Alex-Wolfe/Home-Audio-System/README.md

# Home Audio System
Audio Receiver and Amplifier
