Alex-Wolfe/Home-Audio-System/Firmware/Other/micro_pinout.xlsx

 | Pin name | PPS Number | Net Name | ANSEL Bit present | Peripheral Pin Select | IO Direction | Special Function Assignment
PORT A | RA0 |  | PLAY_PAUSE | Yes | No | Digital Output
PORT B | RB0 |  | PGD | Yes | Yes | N/A | Programming
 | RB1 |  | PGC | Yes | Yes | N/A | Programming
 | RB2 |  | 16kHz In | Yes | Yes | Analog Input | ADC In
 | RB3 |  | 63Hz In | Yes | No | Analog Input | ADC In
 | RB4 |  | AVG In | Yes | Yes | Analog Input | ADC In
 | RB5 |  | 1kHz In | Yes | Yes | Analog Input | ADC In
 | RB6 |  | 400Hz In | Yes |  | Analog Input | ADC In
 | RB7 |  | 160Hz In | Yes |  | Analog Input | ADC In
 | RB8 |  | 2.5kHz In | Yes |  | Analog Input | ADC In
 | RB9 |  | 6.25kHz In | Yes |  | Analog Input | ADC In
 | RB10 |  | IN SEL B | Yes |  | Digital Output
 | RB11 |  | IN SEL A | Yes |  | Digital Output
 | RB12 |  | REG TEMP | Yes |  | Analog Input | ADC In
 | RB13 |  | OUTPUT TEMP | Yes |  | Analog Input | ADC In
 | RB14 |  | FAN PWM | Yes | Yes | Digital Output | PWM Out, CCPM
 | RB15 |  | FAN EN | Yes |  | Digital Output
PORT C | RC12 |  | OSC+ | No |  | N/A | Primary oscillator
 | RC13 |  | TUNE B | No |  | Digital Input
 | RC14 |  | TUNE A | No |  | Digital Input
 | RC15 |  | OSC- | No |  | N/A | Primary oscillator
PORT D | RD0 |  | SPI1 CS EQ | No |  | Digital Output | SPI 1
 | RD1 |  | BAR SCLK | No | Yes | Digital Output | SPI 2
 | RD2 |  | BAR | No | Yes | Digital Output | SPI 2
 | RD3 |  | UART RXD | No | Yes | Digital Input | UART 2
 | RD4 |  | UART TXD | No | Yes | Digital Output | UART 2
 | RD5 |  | IR IN | No | Yes | Digital Input | UART 3?
 | RD6 |  | VOL + | Yes |  | Digital Output
 | RD7 |  | VOL - | Yes |  | Digital Output
 | RD8 |  | DISPLAY LAT | No |  | Digital Output
 | RD9 |  | DISPLAY BLANK | No |  | Digital Output
 | RD10 |  | VOL A | Yes |  | Digital Input
 | RD11 |  | SPI1 MISO | Yes | Yes | Digital Input | SPI 1
PORT E | RE0 |  | nSOURCE | No |  | Digital Input
 | RE1 |  | LATCH | Yes |  | Digital Output
 | RE2 |  | BLANK | Yes |  | Digital Output
 | RE3 |  | N/C | Yes
 | RE4 |  | nMULTI1 | Yes |  | Digital Input
 | RE5 |  | nMULTI2 | No |  | Digital Input
 | RE6 |  | AUX DET | No |  | Digital Input
 | RE7 |  | MFB | No |  | Digital Output
PORT F | RF0 |  | VOL B | No |  | Digital Input
 | RF1 |  | nDISPLAY | No |  | Digital Input
 | RF2 |  | SPI1 MOSI | No | Yes | Digital Output | SPI 1
 | RF3 |  | SPI1 SCLK | No | Yes | Digital Output | SPI 1
 | RF4 |  | FM INT | No |  | Digital Input
 | RF5 |  | FM nRST | No |  | Digital Output
 | RF6 |  | N/C | No |  | N/A
PORT G | RG2 |  | SCL | No | No | Digital Output | I2C 1
 | RG3 |  | SDA | No | No | Digital Output | I2C 1
 | RG6 |  | N/C | Yes
 | RG7 | RP26 | RXD | Yes |  | Digital Input | UART 1
 | RG8 | RP19 | TXD | Yes |  | Digital Output | UART 1
 | RG9 |  | TEST | Yes |  | Digital Output
