Alex-Wolfe/Home-Audio-System/Hardware/Other/eq -12db setting.xlsx

 |  | Pot resistance |  | number of steps | resistance per step
 |  | 50000 |  | 256 | 195.3125
Steps | lin ratio | voltage log ratio
1 | 0.00390625 | -48.16
2 | 0.0078125 | -42.14
3 | 0.01171875 | -38.62
4 | 0.015625 | -36.12
5 | 0.01953125 | -34.19
6 | 0.0234375 | -32.60
7 | 0.02734375 | -31.26
8 | 0.03125 | -30.10
9 | 0.03515625 | -29.08
10 | 0.0390625 | -28.16
11 | 0.04296875 | -27.34
12 | 0.046875 | -26.58
13 | 0.05078125 | -25.89
14 | 0.0546875 | -25.24
15 | 0.05859375 | -24.64
16 | 0.0625 | -24.08
17 | 0.06640625 | -23.56
18 | 0.0703125 | -23.06
19 | 0.07421875 | -22.59
20 | 0.078125 | -22.14
21 | 0.08203125 | -21.72
22 | 0.0859375 | -21.32
23 | 0.08984375 | -20.93
24 | 0.09375 | -20.56
25 | 0.09765625 | -20.21
26 | 0.1015625 | -19.87
27 | 0.10546875 | -19.54
28 | 0.109375 | -19.22
29 | 0.11328125 | -18.92
30 | 0.1171875 | -18.62
31 | 0.12109375 | -18.34
32 | 0.125 | -18.06
33 | 0.12890625 | -17.79
34 | 0.1328125 | -17.54
35 | 0.13671875 | -17.28
36 | 0.140625 | -17.04
37 | 0.14453125 | -16.80
38 | 0.1484375 | -16.57
39 | 0.15234375 | -16.34
40 | 0.15625 | -16.12
41 | 0.16015625 | -15.91
42 | 0.1640625 | -15.70
43 | 0.16796875 | -15.50
44 | 0.171875 | -15.30
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
