Alex-Wolfe/Home-Audio-System/Hardware/Other/bar graph plan.xlsx

 |  |  |  |  |  |  | eq bar led plan
 |  |  |  |  |  |  | adc count | adc voltage mV | db fullscale | bar
 |  | ADC Reference | Bits | Voltage Resolution | Steps |  | 2899 | 2335.620117 | -3.002234652 | 10
 |  | 3.3 | 12 | 0.81 mV | 4096 |  | 2051 | 1652.416992 | -6.007885752 | 9
 |  |  |  |  |  |  | 1453 | 1170.629883 | -9.001886673 | 8
 |  |  |  |  |  |  | 1028 | 828.2226562 | -12.00733667 | 7
Steps |  |  |  |  |  |  | 728 | 586.5234375 | -15.00457137 | 6
1 | 0.8056640625 | -72.24719896 |  |  |  |  | 516 | 415.7226562 | -17.99420493 | 5
2 | 1.611328125 | -66.22659905 |  |  |  |  | 365 | 294.0673828 | -21.00134167 | 4
3 | 2.416992188 | -62.70477386 |  |  |  |  | 258 | 207.8613281 | -24.01480484 | 3
4 | 3.22265625 | -60.20599913 |  |  |  |  | 183 | 147.4365234 | -26.99817716 | 2
5 | 4.028320312 | -58.26779887 |  |  |  |  | 129 | 103.9306641 | -30.03540475 | 1
6 | 4.833984375 | -56.68417395
7 | 5.639648438 | -55.34523816
8 | 6.4453125 | -54.18539922
9 | 7.250976562 | -53.16234877 |  |  |  | "clip at 2.6V at adc" this is 50W mark at 4 ohm load
10 | 8.056640625 | -52.24719896
11 | 8.862304688 | -51.41934526
12 | 9.66796875 | -50.66357404
13 | 10.47363281 | -49.96833191
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
