Alex-Wolfe/Home-Audio-System/Hardware/Datasheets/thermistor table.csv

P/N | NTCG103JF103FT1
R25 | 10 | kƒ¶ +/- | 1 | %
B25/85 | 3435 | K +/- | 1 | %
Temp | Min | Nom | Max | B25/T | -dT | dT
(degC) | (k ohm) | (k ohm) | (k ohm) | (K) | (degC) | (degC)
-40 | 181.2 | 188.5 | 196.1 | 3140 | -0.7 | 0.7
-39 | 171.8 | 178.6 | 185.6 | 3144 | -0.7 | 0.7
-38 | 162.9 | 169.2 | 175.8 | 3148 | -0.7 | 0.7
-37 | 154.5 | 160.4 | 166.6 | 3152 | -0.7 | 0.7
-36 | 146.5 | 152.1 | 157.9 | 3155 | -0.7 | 0.7
-35 | 139.1 | 144.3 | 149.7 | 3159 | -0.7 | 0.7
-34 | 132 | 136.9 | 141.9 | 3162 | -0.7 | 0.7
-33 | 125.4 | 130 | 134.7 | 3166 | -0.6 | 0.7
-32 | 119.1 | 123.4 | 127.8 | 3169 | -0.6 | 0.6
-31 | 113.2 | 117.2 | 121.3 | 3173 | -0.6 | 0.6
-30 | 107.6 | 111.3 | 115.2 | 3176 | -0.6 | 0.6
-29 | 102.3 | 105.8 | 109.4 | 3180 | -0.6 | 0.6
-28 | 97.3 | 100.6 | 104 | 3183 | -0.6 | 0.6
-27 | 92.57 | 95.64 | 98.8 | 3187 | -0.6 | 0.6
-26 | 88.09 | 90.97 | 93.93 | 3190 | -0.6 | 0.6
-25 | 83.86 | 86.56 | 89.33 | 3194 | -0.6 | 0.6
-24 | 79.85 | 82.38 | 84.98 | 3197 | -0.6 | 0.6
-23 | 76.06 | 78.43 | 80.86 | 3200 | -0.6 | 0.6
-22 | 72.47 | 74.69 | 76.97 | 3203 | -0.6 | 0.6
-21 | 69.06 | 71.14 | 73.28 | 3207 | -0.6 | 0.6
-20 | 65.84 | 67.79 | 69.79 | 3210 | -0.6 | 0.6
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
