Alex-Wolfe/Home-Audio-System/Hardware/Simulations/1kHz.png

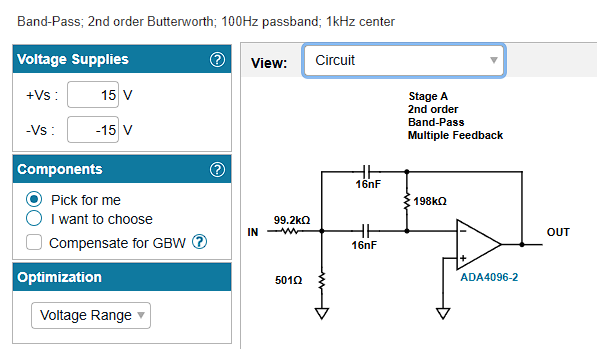
Hardware/Simulations/1kHz.png
