Alex-Wolfe/Home-Audio-System/Hardware/Simulations/2.5kHz.png

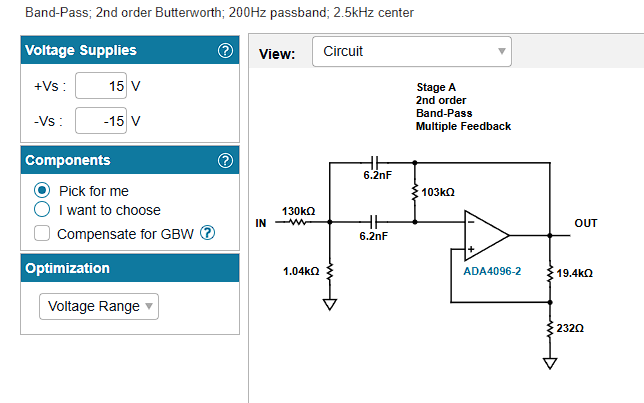
Hardware/Simulations/2.5kHz.png
