Alex-Wolfe/Home-Audio-System/Hardware/Simulations/6.25kHz.png

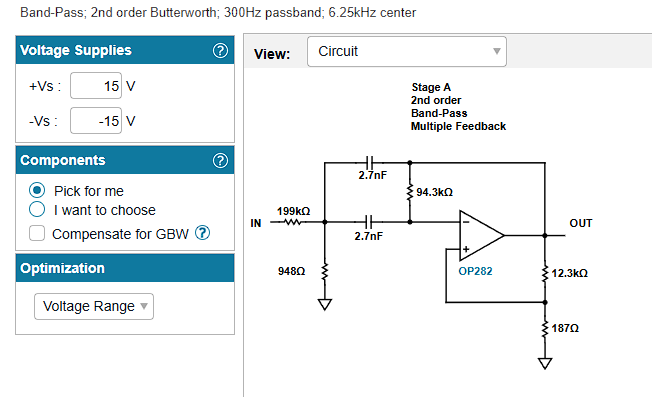
Hardware/Simulations/6.25kHz.png
