Alex-Wolfe/Home-Audio-System/Hardware/Simulations/16kHz.png

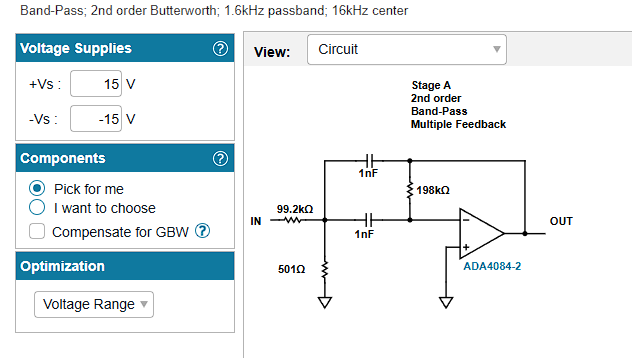
Hardware/Simulations/16kHz.png
