Alex-Wolfe/Home-Audio-System/Hardware/Simulations/63Hz.png

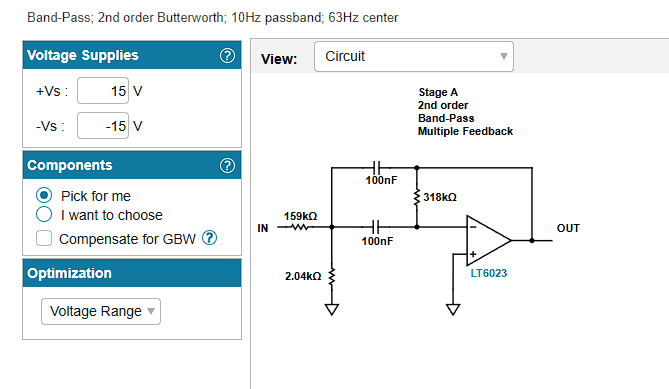
Hardware/Simulations/63Hz.png
