Alex-Wolfe/Home-Audio-System/Hardware/Simulations/400Hz.png

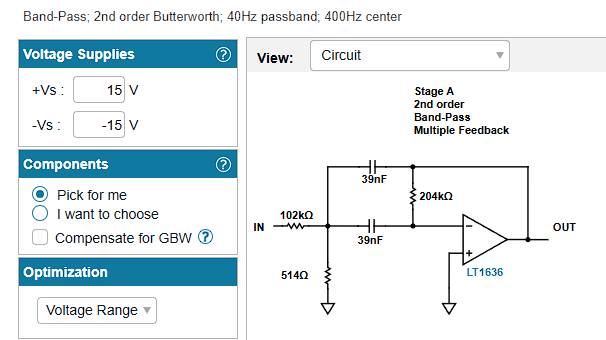
Hardware/Simulations/400Hz.png
