Alex-Wolfe/Home-Audio-System/Hardware/Simulations/High Pass Filter (400Hz).png

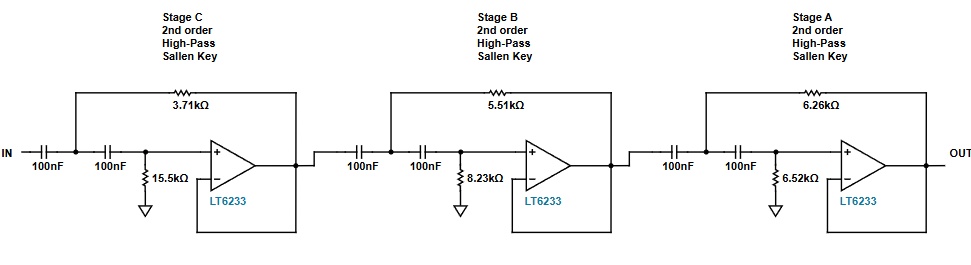
Hardware/Simulations/High Pass Filter (400Hz).png
