Alex-Wolfe/Home-Audio-System/Hardware/Simulations/Low Pass Filter (300Hz).png

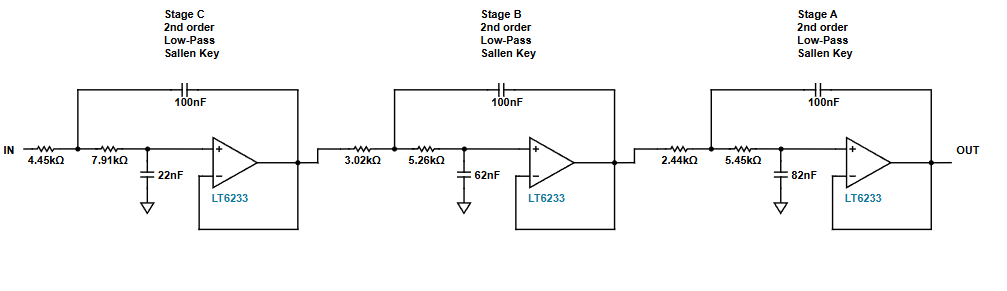
Hardware/Simulations/Low Pass Filter (300Hz).png
