Alex-Wolfe/Home-Audio-System/Hardware/Design/Main Board/bom/amp_bom_only.xlsx

 | Sourced | Placed | References | Value | Description | Manufacturer_Part_Number | Footprint | Quantity
1 | ✓ |  | C20, C34, C47, C51, C52, C90, C99, C107, C108, C117, C122, C123, C127, C131, C137, C140, C144, C167, C177, C182, C183, C187, C195, C196, C197, C214, C215, C217, C220, C225, C227, C229, C239, C240, C241, C242, C254, C255, C256, C264, C273, C282, C285, C287 | 0.1uF |  | C0603C104M5RACTU | C0603 | 44
2 | ✓ |  | C21, C48, C53, C54, C92, C104, C109, C111, C118, C130, C136, C168, C178, C213, C216, C218, C219, C226, C228, C230, C235, C236, C237, C238, C251, C252, C253, C265, C276, C283, C284, C286, C288 | 10uF |  | GRM21BR61H106KE43L | GRM21x | 33
3 | ✓ |  | C11, C13, C22, C82, C85, C94, C97, C98, C100, C101, C102, C103, C105, C106, C110, C112, C113, C114 | 0.1u COG |  | GRM31C5C1H104JA01L | CAPC3216X180N | 18
4 | ✓ |  | C153, C154, C158, C159, C169, C170, C171, C172, C198, C200, C202, C205, C208, C280, C281 | 10uF |  | GRM21BR61C106KE15K | CAPC2012X145N | 15
5 | ✓ |  | C17, C24, C115, C116, C150, C156, C160, C201, C203, C204, C206, C207, C211, C212 | 0.1uF |  | CC0603KRX7R7BB104 | CAPC1608X90N | 14
6 | ✓ |  | C121, C126, C180, C181, C186, C190, C191, C192, C193, C194, C269, C279 | 10uF |  | CL31A106MBHNNNE | CAPC3216X180N | 12
7 |  |  | C199, C243, C244, C245, C247, C257, C258, C259, C263 | 100pF |  | CC0603JRNPO9BN101 | CAPC1608X87N | 9
8 |  |  | C128, C129, C132, C133, C134, C135, C138, C139 | 0.01u |  | CL10B103KB8NNNC | CAPC1608X90N | 8
9 |  |  | C221, C222, C223, C224, C231, C232, C233, C234 | DNA |  | C0603C104M5RACTU | C0603 | 8
10 |  |  | C246, C248, C249, C250, C260, C261, C262, C266 | 0.1u | 0.1 F +/-10% 16V Ceramic Capacitor X7R 0603 (1608 Metric) | CC0603KRX7R7BB104 | CAPC1608X90N | 8
11 |  |  | C2, C3, C4, C5, C6, C7 | 330p | SMD Comm C0G, Ceramic, 330 pF, 5%, 50 VDC, 125 VDC, 125C, -55C, C0G, SMD, MLCC, Ultra-Stable, Low Loss, Class I, 0.1 % , 100 GOhms, 3.7 mg, 0603, 1.6mm, 0.8mm, 0.8mm, 0.7mm, 0.35mm, 4000, 78 Weeks, 120 | C0603C331J5GACTU | CAPC1608X87N | 6
12 |  |  | C142, C143, C146, C147, C274, C275 | 10uF |  | A759BQ106M1VAAE090 | CAPPRD200W55D500H1200 | 6
13 |  |  | C161, C162, C173, C174, C175, C176 | 1000pF | SMD Comm C0G, Ceramic, 1000 pF, 10%, 25 VDC, 62.5 VDC, 125C, -55C, C0G, SMD, MLCC, Ultra-Stable, Low Loss, Class I, 0.1 % , 100 GOhms, 3.7 mg, 0603, 1.6mm, 0.8mm, 0.8mm, 0.7mm, 0.35mm, 4000, 78 Weeks, 120 | C0603C102K3GACTU | CAPC1608X87N | 6
14 |  |  | C49, C50, C55, C62 | 0.1u |  | GRM31C5C1H104JA01L | CAPC3216X180N | 4
15 |  |  | C18, C88 | 22nF | Chip Multilayer Ceramic Capacitors for Automotive (Powertrain/Safety), 1.6 x 0.8 (0603) | GCM21B5C1H223FA16L | GCM21 | 2
16 |  |  | C19, C89 | 62nF | MLCC, 1206 | GRM31C5C1H623JA01K | GRM31x | 2
17 |  |  | C23, C96 | 82nF | Capacitor MLCC GRM 1206 82nF 50V C0G Murata 1206 GRM 82nF Ceramic Multilayer Capacitor, 50 V, +125degC, C0G Dielectric, /-5% SMD | GRM31C5C1H823JA01L | CAPC3216X180N | 2
18 |  |  | C56, C57 | 2.7n |  | GRM1885C1H272JA01D | CAPC1608X90N | 2
19 |  |  | C58, C60 | 39n |  | GRM31M5C1H393JA01L | GRM31x | 2
20 |  |  | C59, C61 | 1n |  | GRM1885C1H102JA01D | CAPC1608X90N | 2
21 |  |  | C63, C65 | 6.2n |  | GRM1885C1H622JA01D | GRM18x | 2
22 |  |  | C64, C66 | 16n |  | GRM3195C1H163JA01D | GRM31x | 2
23 |  |  | C124, C184 | 300pF |  | GCM1555C1H301JA16D | GCM155 | 2
24 |  |  | C125, C185 | 100uF |  | 865080343009 | 865080343009 | 2
25 |  |  | C141, C145 | 100uF |  | UUD1H101MNL1GS | UD_8X10_ | 2
26 |  |  | C155, C157 | 22pF |  | CL10C220JB81PNC | CAPC1608X90N | 2
27 |  |  | C163, C164 | 1.8nF | Multilayer Ceramic Capacitors MLCC - SMD/SMT 0.0018uF 50Volts 5% | GRM1885C1H182JA01J | CAPC1608X90N | 2
28 |  |  | C165, C166 | 680pF | Multilayer Ceramic Chip Capacitor WCAP-CSGP Series 0603 680pF NP00603681J050DFCT10000 | 885012006062 | CAPC1608X87N | 2
29 |  |  | C188, C189 | 6800uF |  | SLPX682M050C7P3 | CAPPRD1000W210D2550H4200 | 2
30 |  |  | C209, C210 | 33pF |  | CL10C330JB8NNNC | CAPC1608X90N | 2
31 |  |  | C267, C277 | 1uF |  | CL21B105KOFNNNE | CAPC2012X135N | 2
32 |  |  | C268, C278 | 100pF |  | 885012007034 | CAPC2012X70N | 2
33 |  |  | C1 | 1nF | Multilayer Ceramic Capacitors MLCC - SMD/SMT 0603 1000pF 50volts C0G 5% | GRM1885C1H102JA01D | CAPC1608X90N | 1
34 |  |  | C152 | 22nF |  | CL10B223KB8NNNC | CAPC1608X90N | 1
35 |  |  | C179 | 22uF |  | EEU-FR1H100B | CAPPRD200W55D500H1250 | 1
36 |  |  | R17, R18, R19, R20, R56, R58, R147, R185, R187, R222, R227, R260, R262, R264, R266, R268, R269, R270, R271, R272, R273, R274, R275, R280, R281, R282, R283, R288, R290, R292, R294, R295, R296, R297, R298, R299, R303, R304, R305, R309, R310, R311, R313, R349 | 10k |  | RC0603FR-0710KL | RESC1608X55N | 44
37 |  |  | R123, R124, R192, R193, R194, R195, R196, R197, R200, R201, R204, R205, R207, R208, R209, R210, R213, R214, R215, R216, R220, R221, R334, R335, R336, R337 | 0 |  | RC0603JR-070RL | RESC1608X55N | 26
38 |  |  | R2, R6, R7, R8, R9, R10, R15, R16, R25, R26, R31, R150, R151, R166, R167, R169, R170 | 1k | Thin Film Resistors - SMD 0603 1/10W 1Kohms 0.1% 25ppm | ERA-3AEB102V | ERA3AEB101V | 17
39 |  |  | R57, R175, R186, R189, R190, R206, R211, R217, R218, R219, R223, R224, R225, R226 | 47 |  | RC0603FR-0747RL | RESC1608X55N | 14
40 |  |  | R176, R177, R183, R184, R261, R263, R265, R267, R289, R291, R293, R312 | 5.1k |  | RC0603FR-075K1L | RESC1608X55N | 12
41 |  |  | R152, R154, R171, R172, R173, R174, R188, R329, R338, R339, R340 | 2k |  | ERA-3AEB202V | ERA3AEB101V | 11
42 |  |  | R179, R182, R316, R319, R324, R327, R328, R331, R332, R333 | 0 | Yageo 0, 0603 (1608M) Thick Film SMD Resistor - RC0603JR-070RL | RC0603JR-070RL | RESC1608X55N | 10
43 |  |  | R51, R128, R129, R130, R131, R136, R137, R138, R139 | 1k |  | RC0603FR-071KL | RESC1608X55N | 9
44 |  |  | R11, R12, R13, R14, R27, R28, R29, R30 | 2k | Thin Film Resistors - SMD 0603 1/10W 2Kohms | ERA-3AEB202V | ERA3AEB101V | 8
45 |  |  | R126, R127, R132, R133, R134, R135, R140, R141 | 8.06k |  | RC0603FR-078K06L | RESC1608X55N | 8
46 |  |  | R234, R235, R242, R243, R248, R249, R254, R255 | 2.1k |  | ERA-8APB2101V | RESC3216X70N | 8
47 |  |  | R238, R239, R240, R241, R250, R251, R252, R253 | 0.22 |  | RLP73K3AR22JTE | RESC6432X84N | 8
48 |  |  | R276, R277, R278, R279, R300, R301, R302, R315 | 1M |  | RC0603FR-071ML | RESC1608X55N | 8
49 |  |  | R284, R285, R286, R287, R306, R307, R308, R314 | 100 |  | RC0603FR-07100RL | RESC1608X55N | 8
50 |  |  | R21, R22, R23, R24, R178, R341 | 3k |  | RC0603FR-073KL | RESC1608X55N | 6
51 |  |  | R32, R33, R229, R231, R236, R237 | 10k |  | ERA-3AEB103V | ERA3AEB101V | 6
52 |  |  | R148, R149, R163, R164, R165, R168 | 1M | Thin Film Resistors - SMD 1M ohm 1% 25 ppm High-Precision | RT0603FRD071ML | RESC1608X55N | 6
53 |  |  | R1, R3, R4, R5, R55 | 4.59k | Lead (Pb)-Bearing High Stability Thin Film Chip Resistors | TNPW06034K59BEEA | RESC1608X55N | 5
54 |  |  | R321, R344, R345, R346, R347 | 32.4k | Thick Film Resistors 32.4K OHM 1% | RC0603FR-0732K4L | RESC1608X55N | 5
55 |  |  | R95, R96, R115, R116 | 6.49k | Thin Film Resistors - SMD 0603 6.49Kohm 0.1% 25ppm | ERA-3AEB6491V | ERA3AEB101V | 4
56 |  |  | R156, R157, R158, R159 | 2.32k | Thin Film Resistors - SMD 0603 2.32Kohm 0.1% 25ppm | ERA-3AEB2321V | ERA3AEB101V | 4
57 |  |  | R38, R52, R146 | 100k |  | RC0603FR-07100KL | RESC1608X55N | 3
58 |  |  | R41, R48, R50 | 200k |  | RC0603FR-07200KL | RESC1608X55N | 3
59 |  |  | R142, R144, R325 | 240 |  | RC0805FR-07240RL | RESC2012X60N | 3
60 |  |  | R143, R145, R326 | 5.1k |  | CRCW12065K10FKEA | RESC3216X60N | 3
61 |  |  | R36, R45 | 160k |  | RC0603FR-07160KL | RESC1608X55N | 2
62 |  |  | R37, R49 | 102k |  | RC0603FR-07102KL | RESC1608X55N | 2
63 |  |  | R44, R53 | 499 |  | RC0603FR-07499RL | RESC1608X55N | 2
64 |  |  | R81, R83 | 3.65k | Metal Film (Thin Film) Chip Resistor 0603 3651 | ERA-3AEB3651V | ERA3AEB101V | 2
65 |  |  | R82, R84 | 5.36k | Thin Film Resistors - SMD 0603 5.36Kohm 0.1% 25ppm | ERA-3AEB5361V | ERA3AEB101V | 2
66 |  |  | R85, R87 | 6.34k | Metal Film (Thin Film) Chip Resistor 0603 6341 | ERA-3AEB6341V | ERA3AEB101V | 2
67 |  |  | R86, R88 | 9.53k | Thin Film Resistors - SMD 0603 9.53Kohm 0.1% 25ppm | ERA-3AEB9531V | ERA3AEB101V | 2
68 |  |  | R90, R94 | 2.94k | Metal Film (Thin Film) Chip Resistor 0603 2941 | ERA-3AEB2941V | ERA3AEB101V | 2
69 |  |  | R101, R102 | 3.74k | Metal Film (Thin Film) Chip Resistor 0603 3741 | ERA-3AEB3741V | ERA3AEB101V | 2
70 |  |  | R103, R105 | 5.49k | Metal Film (Thin Film) Chip Resistor 0603 5491 | ERA-3AEB5491V | ERA3AEB101V | 2
71 |  |  | R104, R106 | 15.4k | Thin Film Resistors - SMD 0603 15.4Kohm 0.1% 25ppm | ERA-3AEB1542V | ERA3AEB101V | 2
72 |  |  | R107, R108 | 8.25k | Thin Film Resistors - SMD 0603 8.25Kohm 0.1% 25ppm | ERA-3AEB8251V | ERA3AEB101V | 2
73 |  |  | R109, R114 | 6.2k | Metal Thin Film Chip Resistor, 0603, 0.1W | ERA-3AEB622V | ERA3AEB101V | 2
74 |  |  | R120, R181 | 9.53k |  | RC0603FR-079K53L | RESC1608X55N | 2
75 |  |  | R153, R155 | 34.8k | Thin Film Resistors - SMD 0603 34.8Kohm 0.1% 25ppm | ERA-3AEB3482V | ERA3AEB101V | 2
76 |  |  | R160, R161 | 1.18k | Metal Film (Thin Film) Chip Resistor 0603 1181 | ERA-3AEB1181V | ERA3AEB101V | 2
77 |  |  | R228, R233 | 5.1k |  | RT0603FRE075K1L | RESC1608X55N | 2
78 |  |  | R318, R330 | 270k |  | RC0805FR-07270KL | RESC2012X60N | 2
79 |  |  | R343, R348 | 1k | Res Thick Film 0603 1K Ohm 1% 0.1W(1/10W) +/-100ppm/C Epoxy Pad SMD T/R | RC0603FR-071KL | RESC1608X55N | 2
80 |  |  | R34 | 316k |  | RC0603FR-07316KL | RESC1608X55N | 1
81 |  |  | R35 | 2k |  | RC0603FR-072KL | RESC1608X55N | 1
82 |  |  | R39 | 78.7k |  | RC0603FR-0778K7L | RESC1608X55N | 1
83 |  |  | R40 | 634 |  | RC0603FR-07634RL | RESC1608X55N | 1
84 |  |  | R42 | 976 |  | RC0603FR-07976RL | RESC1608X55N | 1
85 |  |  | R43 | 511 |  | RC0603FR-07511RL | RESC1608X55N | 1
86 |  |  | R46 | 95.3k |  | RC0603FR-0795K3L | RESC1608X55N | 1
87 |  |  | R47 | 205k |  | RC0603FR-07205KL | RESC1608X55N | 1
88 |  |  | R54 | 130k |  | RC0603FR-07130KL | RESC1608X55N | 1
89 |  |  | R119 | 1.1k |  | RC0603FR-071K1L | RESC1608X55N | 1
90 |  |  | R162 | 100k |  | RC0805FR-07100KL | RESC2012X60N | 1
91 |  |  | R180 | 1.69k |  | RC0603FR-071K69L | RESC1608X55N | 1
92 |  |  | R191 | 18.7k | RESISTOR, 0603 18.7K Ohms +/-1% 1/10 W | RC0603FR-0718K7L | RESC1608X55N | 1
93 |  |  | L2, L5 | ASPI-6045S-6R8M-T |  | ASPI-6045S-6R8M-T | ASPI-6045S | 2
94 |  |  | L1 | 56nH | Murata LQQ18A Series Wire-wound SMD Inductor 0.056 uH +/-5% 360mA Idc Q:38 | LQW18AN56NJ00D | LQW18AS10NG0CD | 1
95 |  |  | L3 | 2700nH | LQW2UAS_00 Series Inductor 2700nH +/-5% 1008 (2520) | LQW2UAS2R7J00L | LQW2UAS12NG00L | 1
96 |  |  | D54, D55, D56, D57, D58, D60, D62, D64, D69, D70, D71, D72, D74, D76, D78, D79 | 1N4148WX-TP | Diode 80 V 125mA Surface Mount SOD-523 | 1N4148WT-7 | 1N4148WT7 | 16
97 |  |  | D50, D51, D52, D53, D66, D67, D68, D81 | BAT54JFILM | Diode 80 V 125mA Surface Mount SOD-523 | 1N4148WT-7 | 1N4148WT7 | 8
98 |  |  | D59, D61, D63, D65, D73, D75, D77, D80 | RB751S40T1G |  | RB751S40T1G | SODFL1608X70N | 8
99 |  |  | D20, D21, D22, D23, D82, D83 | S1B-13-F |  | S1B-13-F | DIONM5126X230N | 6
100 |  |  | D1, D19, D84 | BAT54JFILM |  | BAT54JFILM | SOD2513X117N | 3
101 |  |  | D17, D28 | STPS3L60U |  | STPS3L60U | SMBJ50CA | 2
102 |  |  | D26, D27 | SM712 |  | SM712 | SOT95P237X120-3N | 2
103 |  |  | D24 | D1213A-01SO-7 |  | D1213A-01SO-7 | D1213A01SO7 | 1
104 |  |  | D29 | ESD5Z3V3 |  | ESD5Z3V3 | SODFL1608X70N | 1
105 |  |  | U11, U13 | 530002B02500G | AAVID THERMALLOY - 530002B02500G - HEAT SINK, 2.6K/W, TO-220 | 530002B02500G | 529802B02500G | 2
106 |  |  | U14, U15 | OPA1622IDRCR |  | OPA1622IDRCR | SON50P300X300X100-11N | 2
107 |  |  | Y1 | R26-32.768-12.5 |  | R26-32.768-12.5 | R2632768125 | 1
108 |  |  | Y2 | ABLS2-32.000MHZ-D4YF-T | HC/49US (AT49) LOW PROFILE SURFACE MOUNT MICROPROCESSOR CRYSTAL | ABLS2-32.000MHZ-D4YF-T | ABLS | 1
109 |  |  | IC18, IC19, IC20, IC31, IC32, IC46, IC47, IC48, IC49, IC50, IC51, IC52, IC53 | TL074HIDYYR |  | TL074HIDYYR | SOP50P326X110-14N | 13
110 |  |  | IC4, IC24, IC25, IC26, IC27, IC28, IC37, IC38, IC45, IC59 | OPA1644AIDR |  | OPA1644AIDR | SOIC127P600X175-14N | 10
111 |  |  | LED18, LED19, LED21, LED22, LED23, LED24, LED25, LED26 | 150060VS75000 | 2.4 V Green LED 1608 (0603) SMD, Wurth Elektronik WL-SMCW 150060VS75000 | 150060VS75000 | LEDC1608X80N | 8
112 |  |  | H7, H8, H9, H10, H11, H13 | ~ |  |  | MountingHole_3.2mm_M3_ISO7380_Pad_TopBottom | 6
113 |  |  | LED1, LED2, LED3, LED4 | 150060SS75000 |  | 150060SS75000 | LEDC1608X80N | 4
114 |  |  | Q1, Q2, Q3, Q4 | BSS84WQ-7-F |  | BSS84WQ-7-F | SOT65P210X110-3N | 4
115 |  |  | Q18, Q23, Q24, Q29 | MMBT3904-7-F |  | MMBT3904-7-F | SOT96P240X110-3N | 4
116 |  |  | Q19, Q21, Q25, Q27 | TIP142 |  | TIP142 | TO545P500X1560X2420-3P | 4
117 |  |  | Q20, Q22, Q26, Q28 | TIP147 |  | TIP147 | TO545P515X1560X2445-3P | 4
118 |  |  | VR3, VR4, VR5, VR6 | 3361P-1-202GLF | Res Cermet Trimmer 2K Ohm 10% 0.5W(1/2W) 1(Elec)/1(Mech)Turns 2.77mm (6.71 X 8.53 X 5.21mm) Gull Wing SMD T/R | 3361P-1-202GLF | 3361P1202GLF | 4
119 |  |  | H1, H2 | ~ |  |  | MountingHole_3.7mm_Pad_TopBottom | 2
120 |  |  | H3, H4 | MA-302-55E |  | MA-302-55E | MA30255E | 2
121 |  |  | IC30, IC39 | ST1S14PHR |  | ST1S14PHR | SOIC127P600X175-9N | 2
122 |  |  | IC33, IC34 | LM338T_NOPB |  | LM338T/NOPB | TO254P470X1028X1955-3P | 2
123 |  |  | IC54, IC57 | TLV76701DGNR |  | TLV76701DGNR | SOP65P490X110-9N | 2
124 |  |  | IC60, IC61 | TS3A4751PWR | TS3A4751PWR, Analogue SPST Switch Quad SPST, 3 V, 14-pin TSSOP | TS3A4751PWR | SOP65P640X120-14N | 2
125 |  |  | Q6, Q17 | 2N7002-7-F |  | 2N7002-7-F | SOT96P240X120-3N | 2
126 |  |  | RT1, RT2 | NTCALUG02A103G |  | NTCALUG02A103G | NTCALUG02A103F | 2
127 |  |  | BR1 | TT8M_LS_ | Bridge Rectifier Single Phase Standard 1 kV Surface Mount TT | TT8M(LS) | SOP500P990X180-4N | 1
128 |  |  | IC1 | AD5243BRMZ10 | AD5243BRMZ10, Digital Potentiometer 10k 256-Position 2-channel Serial-2 Wire, Serial-I2C 10-Pin MSOP | AD5243BRMZ10 | SOP50P490X110-10N | 1
129 |  |  | IC2 | AD5204BRUZ10 | Digital Potentiometer 256POS 10KOhm Quad AD5204BRUZ10, Digital Potentiometer 10k 256-Position 4-channel Serial-3 Wire, Serial-SPI 24-Pin TSSOP | AD5204BRUZ10 | SOP65P640X120-24N | 1
130 |  |  | IC3 | SN74LVC1G139DCUT |  | SN74LVC1G139DCUT | SOP50P310X90-8N | 1
131 |  |  | IC5 | AT24C256C-XHL-B | Atmel AT24C256C-XHL-B EEPROM Memory, 256kbit, 600ns, 1.7 5.5 V 8-Pin TSSOP | AT24C256C-XHL-B | SOP65P640X120-8N | 1
132 |  |  | IC35 | 4259-63 |  | 4259-63 | SOT65P210X110-6N | 1
133 |  |  | IC36 | Si4734-D60-GU |  | Si4734-D60-GU | SOP64P600X175-24N | 1
134 |  |  | IC40 | SMBJ36A |  | SMBJ36A | SMBJ36A | 1
135 |  |  | IC41 | PIC24FJ128GL306-I_PT |  | PIC24FJ128GL306-I/PT | QFP50P1200X1200X120-64N | 1
136 |  |  | IC42 | LM75BDP,118 |  | LM75BDP,118 | SOP65P490X110-8N | 1
137 |  |  | IC44 | OPA1642AIDGKT | Dual sound-plus high-performance, JFET-input audio op amps | OPA1642AIDGKT | SOP65P490X110-8N | 1
138 |  |  | IC56 | LM317MDCYR |  | LM317MDCYR | SOT230P700X180-4N | 1
139 |  |  | IC58 | TPS7A2025PDBVR |  | TPS7A2025PDBVR | SOT95P280X145-5N | 1
140 |  |  | LED7 | 150060VS75000 |  | 150060VS75000 | LEDC1608X80N | 1
141 |  |  | Q5 | NTR4101PT1G | Leading -20 V Trench for Low RDS(on); -1.8 V Rated for Low Voltage Gate Drive; SOT-23 Surface Mount for Small Footprint; RoHS Compliant | NTR4101PT1G | SOT96P237X111-3N | 1
142 |  |  | S5 | 222AMVBAR |  | 222AMVBAR | 222AMVBAR | 1
143 |  |  | J13, J17, J18 | ~ |  |  | power wires | 3
144 |  |  | J4, J12 | PPTC021LFBN-RC | CONN HEADER FEMALE 2POS .1" TIN | PPTC021LFBN-RC | RHDR2W80P0X254_1X2_558X254X850P | 2
145 |  |  | J3 | 61304021821 | WURTH ELEKTRONIK - 61304021821 - Board-To-Board Connector, 2.54 mm, 40 Contacts, Receptacle, WR-PHD Series, Through Hole, 2 Rows | 61304021821 | RHDR40W97P254X254_2X20_5130X508X860P | 1
146 |  |  | J5 | SJ-3524-SMT-TR | Phone Connectors Audio Jacks | SJ-3524-SMT-TR | SJ-3524-SMT-TR | 1
147 |  |  | J6 | 971 |  |  | Phono Jack | 1
148 |  |  | J7 | 970 |  |  | Phono Jack | 1
149 |  |  | J8 | 61300611121 |  | 61300611121 | HDRV6W64P0X254_1X6_1524X254X869P | 1
150 |  |  | J9 | 61300511121 |  | 61300511121 | HDRV5W64P0X254_1X5_1270X254X854P | 1
151 |  |  | J14 | ~ |  |  | ant hole | 1
 |  |  |  |  |  |  |  | 682
