Alex-Wolfe/Home-Audio-System/Hardware/Design/UI Board/bom/UI_bom.xlsx

 | Sourced | Placed | References | Value | Footprint | Description | Manufacturer_Part_Number | Quantity
1 |  |  | C26, C28, C29, C30, C32, C33, C36, C37, C38, C39, C42, C43, C44, C46, C67, C68, C79 | 10uF | CAPC2012X145N |  | GRM21BR61C106KE15K | 17
2 |  |  | C15, C27, C31, C35, C40, C41, C45, C72, C80 | 0.1uF | CAPC1608X90N |  | CC0603KRX7R7BB104 | 9
3 |  |  | C10, C12, C14, C16, C69 | 100pF | CAPC1608X87N |  | CC0603JRNPO9BN101 | 5
4 |  |  | C4, C5, C9, C77 | 0.1uF | C0603 |  | C0603C104M5RACTU | 4
5 |  |  | C2, C3, C8 | 10uF | CAPC3216X180N |  | CL31A106MBHNNNE | 3
6 |  |  | C70, C71 | 1000pF | CAPC1608X87N | SMD Comm C0G, Ceramic, 1000 pF, 10%, 25 VDC, 62.5 VDC, 125C, -55C, C0G, SMD, MLCC, Ultra-Stable, Low Loss, Class I, 0.1 % , 100 GOhms, 3.7 mg, 0603, 1.6mm, 0.8mm, 0.8mm, 0.7mm, 0.35mm, 4000, 78 Weeks, 120 | C0603C102K3GACTU | 2
7 |  |  | C73, C74 | 1.8nF | CAPC1608X90N | Multilayer Ceramic Capacitors MLCC - SMD/SMT 0.0018uF 50Volts 5% | GRM1885C1H182JA01J | 2
8 |  |  | C75, C76 | 680pF | CAPC1608X87N | Multilayer Ceramic Chip Capacitor WCAP-CSGP Series 0603 680pF NP00603681J050DFCT10000 | 885012006062 | 2
9 |  |  | C1 | 22uF | CAPPRD200W55D500H1250 |  | EEU-FR1H100B | 1
10 |  |  | C6 | 300pF | GCM155 |  | GCM1555C1H301JA16D | 1
11 |  |  | C7 | 100uF | 865080343009 |  | 865080343009 | 1
12 |  |  | C78 | 10uF | GRM21x |  | GRM21BR61H106KE43L | 1
13 |  |  | R5, R7, R11, R15, R59, R62, R63, R64, R73, R121, R122 | 10k | RESC1608X55N |  | RC0603FR-0710KL | 11
14 |  |  | R6, R8, R9, R10, R12, R13, R14, R16 | 100 | RESC1608X55N |  | RC0603FR-07100RL | 8
15 |  |  | R25, R26, R27, R28, R29, R30 | 5.1k | RESC1608X55N |  | RC0603FR-075K1L | 6
16 |  |  | R60, R78, R79, R212 | 47 | RESC1608X55N |  | RC0603FR-0747RL | 4
17 |  |  | R61, R76, R77, R80 | 0 | RESC1608X55N |  | RC0603JR-070RL | 4
18 |  |  | R65, R66, R67, R68 | 2k | ERA3AEB101V |  | ERA-3AEB202V | 4
19 |  |  | R69, R70, R71, R72 | 2.32k | ERA3AEB101V | Thin Film Resistors - SMD 0603 2.32Kohm 0.1% 25ppm | ERA-3AEB2321V | 4
20 |  |  | R17, R57, R58 | 1k | ERA3AEB101V | Thin Film Resistors - SMD 0603 1/10W 1Kohms 0.1% 25ppm | ERA-3AEB102V | 3
21 |  |  | R1, R4 | 0 | RESC1608X55N | Yageo 0, 0603 (1608M) Thick Film SMD Resistor - RC0603JR-070RL | RC0603JR-070RL | 2
22 |  |  | R55, R56 | 1M | RESC1608X55N | Thin Film Resistors - SMD 1M ohm 1% 25 ppm High-Precision | RT0603FRD071ML | 2
23 |  |  | R74, R75 | 1.18k | ERA3AEB101V | Metal Film (Thin Film) Chip Resistor 0603 1181 | ERA-3AEB1181V | 2
24 |  |  | R2 | 1.69k | RESC1608X55N |  | RC0603FR-071K69L | 1
25 |  |  | R3 | 9.53k | RESC1608X55N |  | RC0603FR-079K53L | 1
26 |  |  | R31 | 3k | RESC1608X55N |  | RC0603FR-073KL | 1
27 |  |  | L1 | ASPI-6045S-6R8M-T | ASPI-6045S |  | ASPI-6045S-6R8M-T | 1
28 |  |  | D2, D4, D6, D7, D8, D9, D10, D11, D12, D13, D16 | ESD5Z3V3 | SODFL1608X70N |  | ESD5Z3V3 | 11
29 |  |  | D1 | STPS3L60U | SMBJ50CA |  | STPS3L60U | 1
30 |  |  | D14 | SMBJ5.0CA-13-F | DIOM5336X262N |  | SMBJ5.0CA-13-F | 1
31 |  |  | D15 | D5V0L2B3SO-7 | SOT96P240X110-3N |  | D5V0L2B3SO-7 | 1
32 |  |  | U3, U4, U6, U7, U8, U9, U10 | ~ | LED Bar Graph |  |  | 7
33 |  |  | U1, U2 | PEC16-4220F-S0024 | PEC164120FS0012 |  | PEC16-4220F-S0024 | 2
34 |  |  | LED1, LED2, LED3, LED4, LED6, LED7, LED8, LED9, LED10, LED11, LED12 | LTL-433HR | LTL433HR | Standard LEDs - Through Hole Red Diffused | LTL-433HR | 11
35 |  |  | Q1, Q5, Q6, Q7, Q8, Q9, Q10, Q11, Q12 | BSS84WQ-7-F | SOT65P210X110-3N |  | BSS84WQ-7-F | 9
36 |  |  | IC12, IC13, IC14, IC15, IC16, IC17 | TLC59283DBQ | SOP64P600X175-24N |  | TLC59283DBQ | 6
37 |  |  | S1, S2, S4 | 222AMVBAR | 222AMVBAR |  | 222AMVBAR | 3
38 |  |  | DS1, DS2 | TDCR1050M | DIPS1016W50P254L4020H725Q16N |  | TDCR1050M | 2
39 |  |  | H5, H6 | ~ | MountingHole_3.7mm_Pad_TopBottom |  |  | 2
40 |  |  | IC1 | ST1S14PHR | SOIC127P600X175-9N |  | ST1S14PHR | 1
41 |  |  | IC2 | TSOP38238 | TSOP38238 | IR Remote Receiver 38KHz 45m | TSOP38238 | 1
42 |  |  | IC21 | BM83SM1-00TB | BM83SM100TB |  | BM83SM1-00TB | 1
43 |  |  | IC22 | OPA1644AIDR | SOIC127P600X175-14N |  | OPA1644AIDR | 1
44 |  |  | LED5 | 150060SS75000 | LEDC1608X80N |  | 150060SS75000 | 1
45 |  |  | S3 | DS04-254-2-01BK-SMT-TR | DS04254201BKSMTTR |  | DS04-254-2-01BK-SMT | 1
46 |  |  | J1 | 10118192-0002LF | 101181920002LF |  | 10118192-0002LF | 1
47 |  |  | J2 | 61300611121 | HDRV6W64P0X254_1X6_1524X254X869P |  | 61300611121 | 1
48 |  |  | J10 | PH2RA-40-UA | HDRRA40W64P254_2X20_5080X250X500P | Connector Header Through Hole, Right Angle 40 position 0.100" (2.54mm) | PH2RA-40-UA | 1
