Alex-Wolfe/Home-Audio-System/Hardware/Design/Issue Log.xlsx

item | date | issue description | solution | fixed? | implemented in design files?
1 | 2025-06-14 | All input sources cannot be selected | 2-4 decoder is a 5V part. Micro cannot reliably send high level to its inputs. | not done | no
2 | 2025-06-14 | resistor divider is incorrect for 5V LDO | change R191 to 51.4k | not done | no
3 | 2025-06-15 | resistor divider is incorrect for 3V3 LDO | change R321 to 86.4k | not done | no
4 | 2025-07-07 | 100k pullups are needed on fets that drive 7 segment characters | LED driver shift register cannot pull it up | done | no
5 | 2025-07-07 | op amps that run from FM and BT radios draw very high current | Enable 2V5 LDO with pin 35, RF6 on micro to sequence supplies to prevent latch up in op amps | done | no
6 | 2025-07-08 | rotary encoders do not function right | pull up data lines to 3V3 and pull common down to ground | done | no
7 | 2025-08-20 | aux channel volume is very low from phone output | increase resistance of R173 and R174 | not done | no
8 | 2025-07-22 | IC45 isn't getting 2.5V to pin 3 | white wire to 2V5 net | done | no
9 | 2025-07-24 | Transistors thermal pads are shorting together and to the ground of the board | buy silicone thermal pads for transistor heat sinks, and trim off heatsink legs | done | no
10 | 2025-08-19 | bandpass filter circuits vary wildly with how much the peak amplitude comes out to be | potentially improve in V2 design | not done | no
11 | 2025-08-19 | peak sampling circuits not working correctly | check assembly, resolder connections? | not done | no
12 | 2025-08-19 | low pass and attenuator circuits not designed right. No signal comes out to ~1.5V, and a signal being present doesn't change much | Replace all resistors on low pass filtering and attenuation page with 100k. Add 2 100k negative feedback resistors on every op amp output, that are referenced at 14V offset. This builds subtractor circuit to do this properly | not done | no
13 | 2025-08-21 | output audio oscillates at around 23MHz when speaker is connected, open load is fine | compensator circuit, see ltspice sim. 10pF capacitor from output to inverting terminal to take power amp out of feedback loop at high frequency. Consider 500ohm + 3000pF compensator circuit | not done | no
14 | 2025-09-03 | Connecting phone to aux input causes DC voltage to appear at output. Takes a long time to dissipate | Change pullup resistors to 2V5 to 10k instead of 1Meg | not done | no
15 | 2025-09-03 | volume of zero is still audible | use shutdown feature of digipot (firmware change) | not done | no
 |  | reduce distortion | use good quality caps around zener-like circuit in output stage | not done | no
