Alex-Wolfe/Home-Audio-System/Hardware/Design/Kicad Parts/NE555DR.step

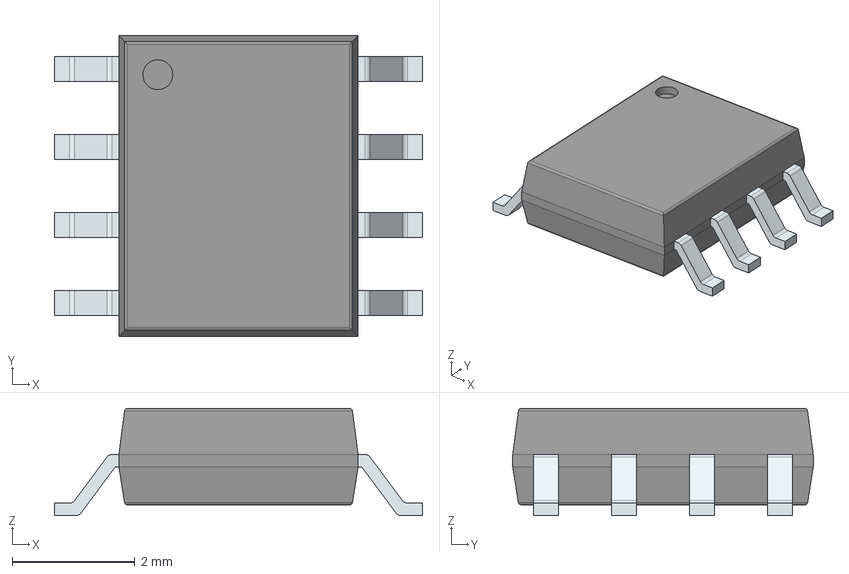
[picture p9: CAD file, 2025-06-05]
Hardware/Design/Kicad Parts/NE555DR.step
6.00 x 4.90 x 1.75 mm
PinsArrayLR
