Alex-Wolfe/Home-Audio-System/Hardware/Design/Kicad Parts/ADM7170ACPZ-3.3-R7.step

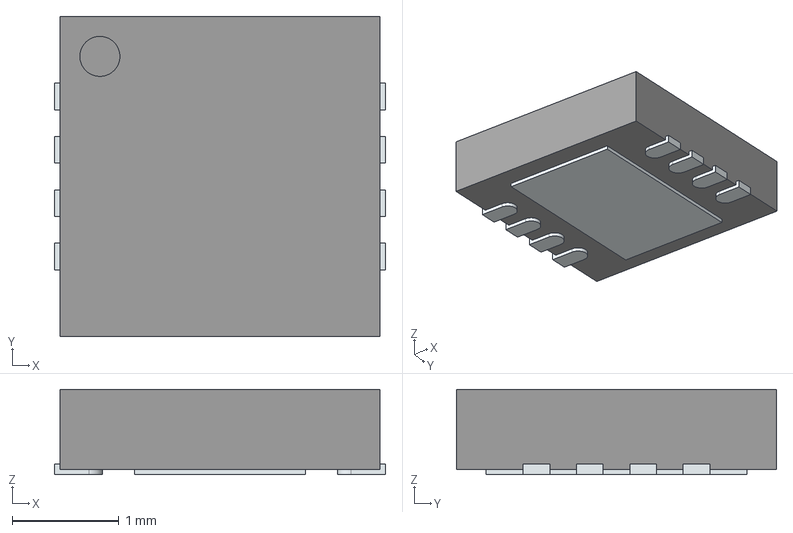
[picture p10: CAD file, 2025-06-05]
Hardware/Design/Kicad Parts/ADM7170ACPZ-3.3-R7.step
3.10 x 3.00 x 0.8 mm
ThermalPin
PinsArrayLR
