Alex-Wolfe/Home-Audio-System/Hardware/Design/UI Board/UI Board Assembly Drawing.pdf

1 | 2 | 3 | 4 | 5 | 6 | 7 | 8 | 9 | 10 | 11 | 12 | 13 | 14 | 15 | 16 | 17

A

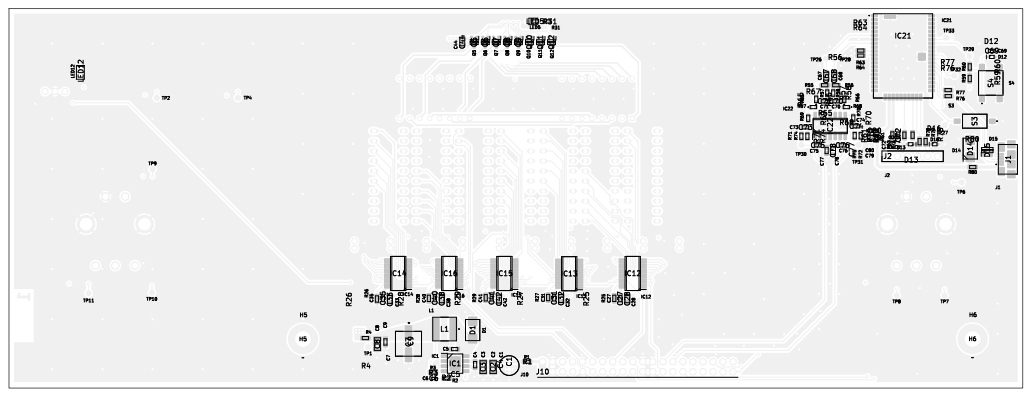
[picture p11: page 1]

BC

BC

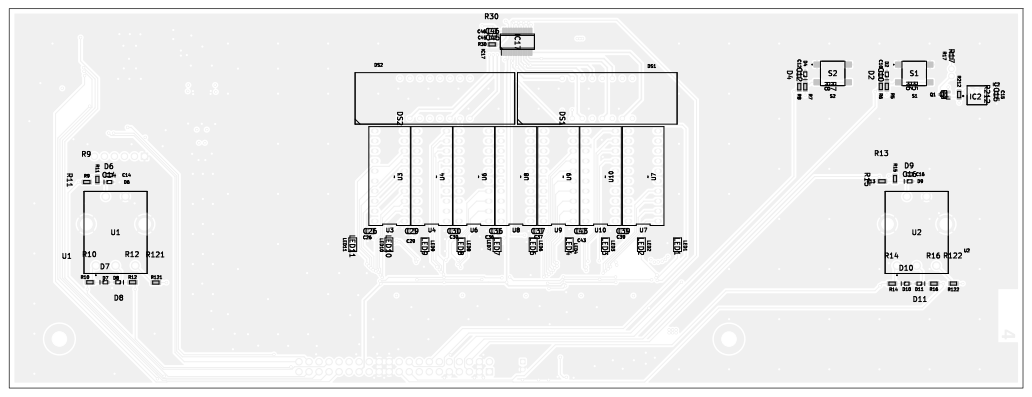
[picture p12: page 2]

BC

BC

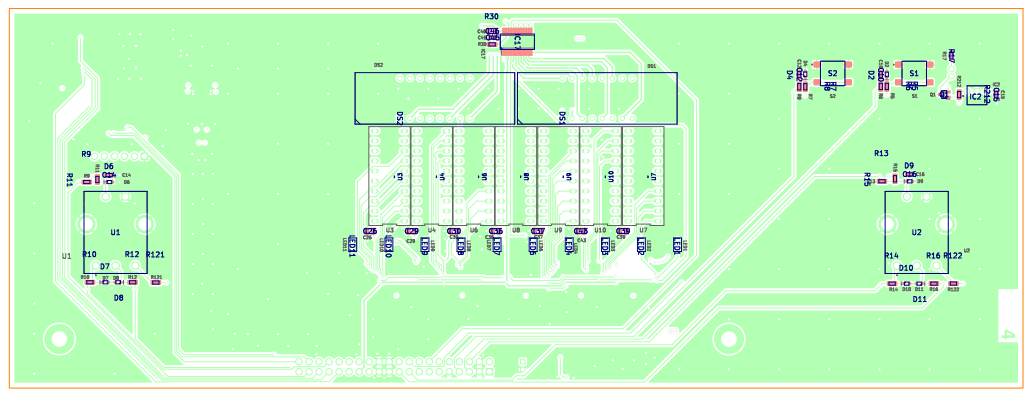
[picture p13: page 3]

BC

BC

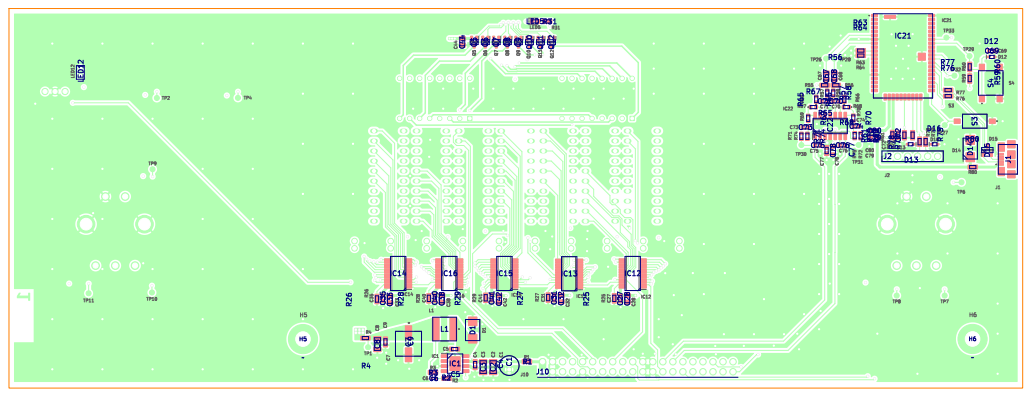
[picture p14: page 4]

BC

BC

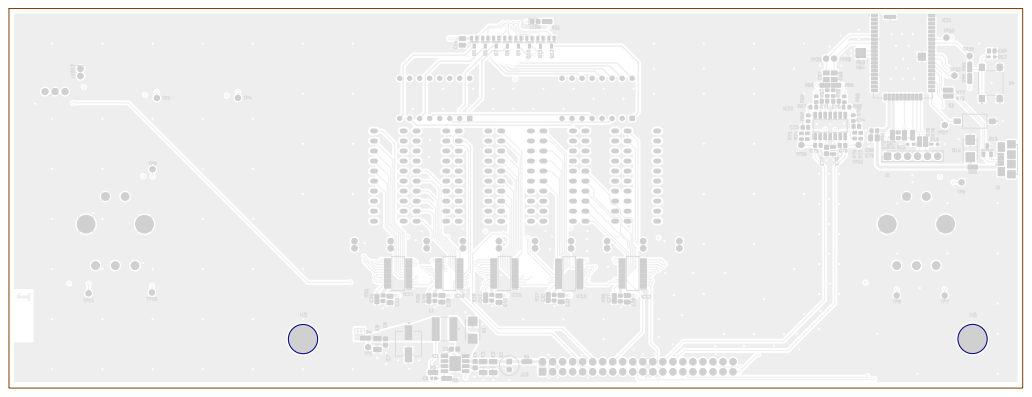
[picture p15: page 5]

BC

BC

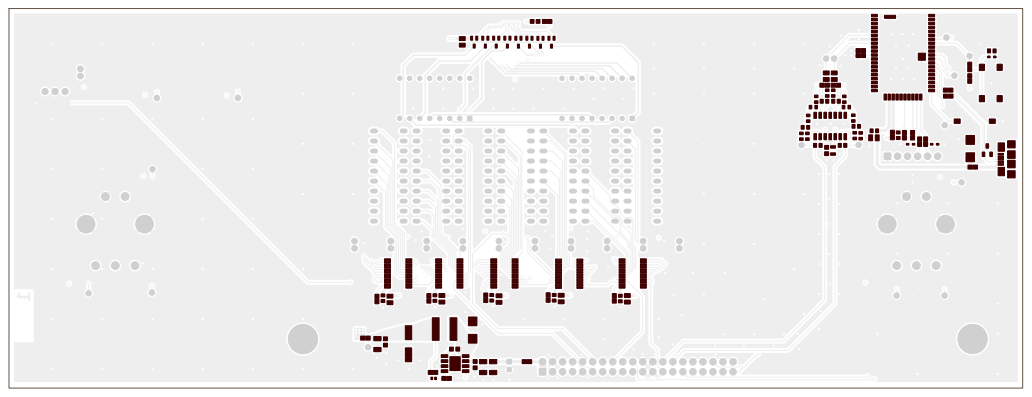
[picture p16: page 6]
IJK; IJK Date: KiCad; E.D.A. 8.0.8 Size:; Rev:; Id: 1/1 Title: File: control; board.kicad_pcb Sheet: Light Colors; PCB; Paste; TOP; Board2Pdf:; Light Colors; TOP -; Page 6/8

BC

BC

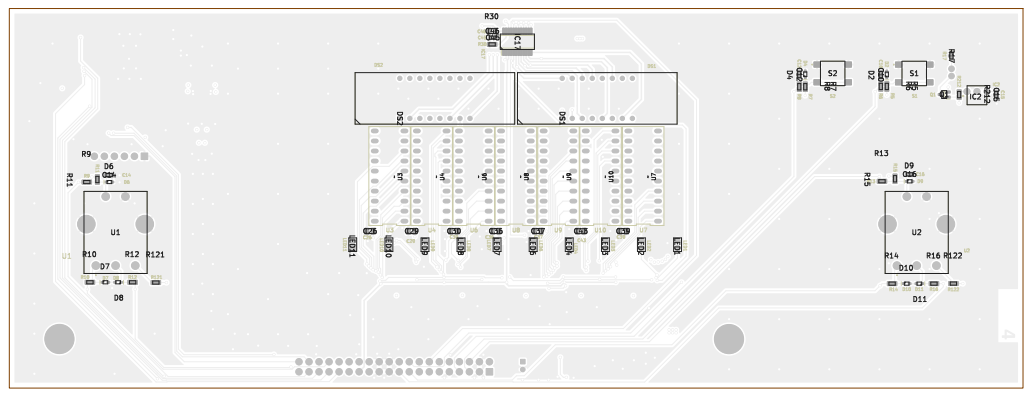
[picture p17: page 7]

BC

BC

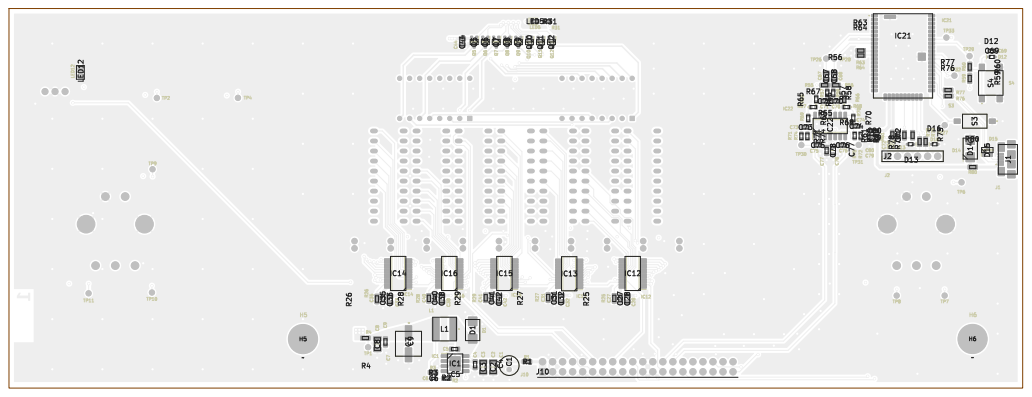
[picture p18: page 8]
