Alex-Wolfe/Home-Audio-System/Hardware/Design/UI Board/UI Board Schematic.pdf

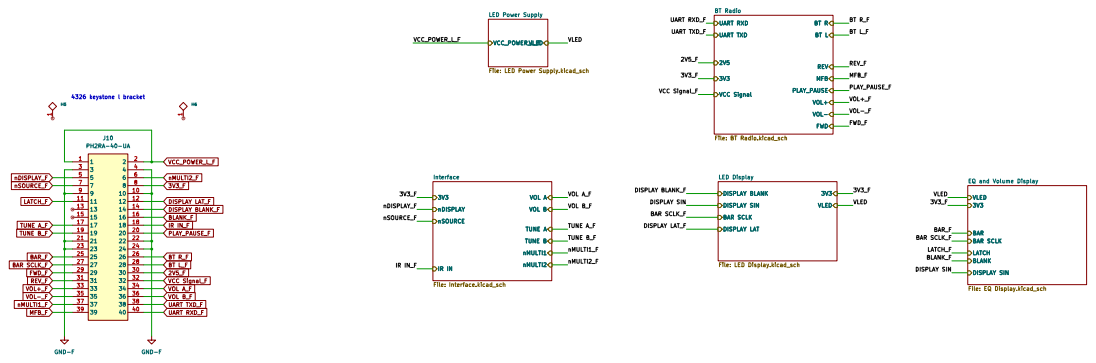
[picture p39: page 2]

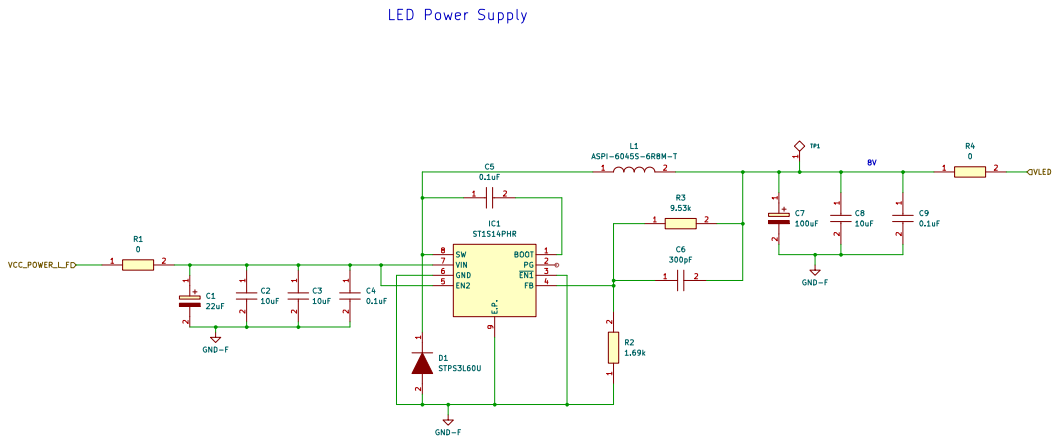
[picture p40: page 3]

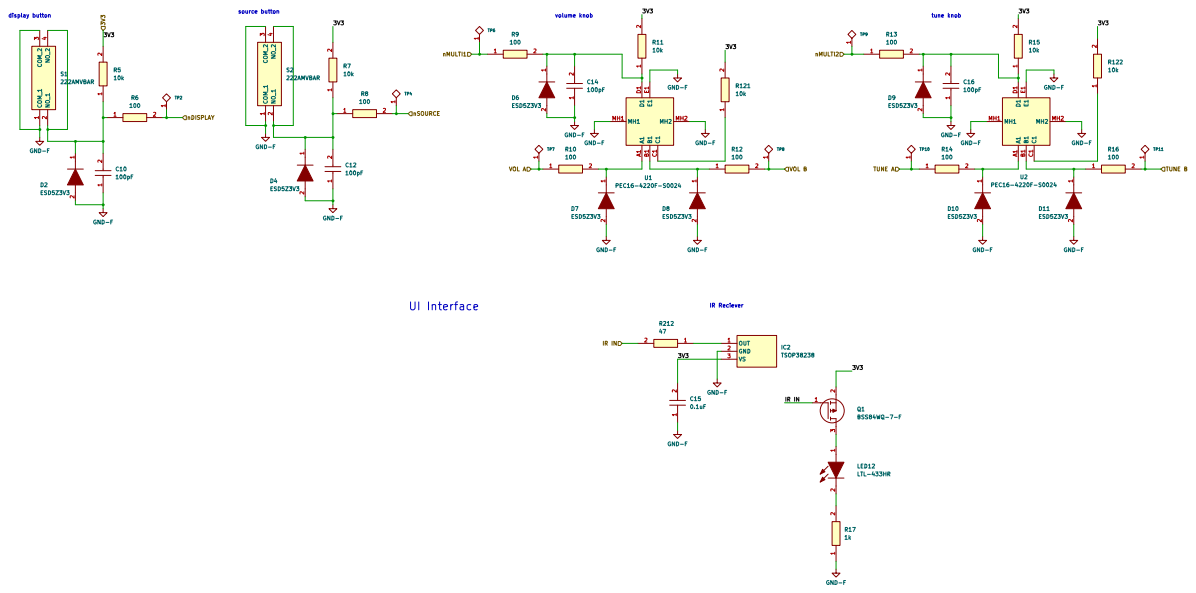
[picture p41: page 4]

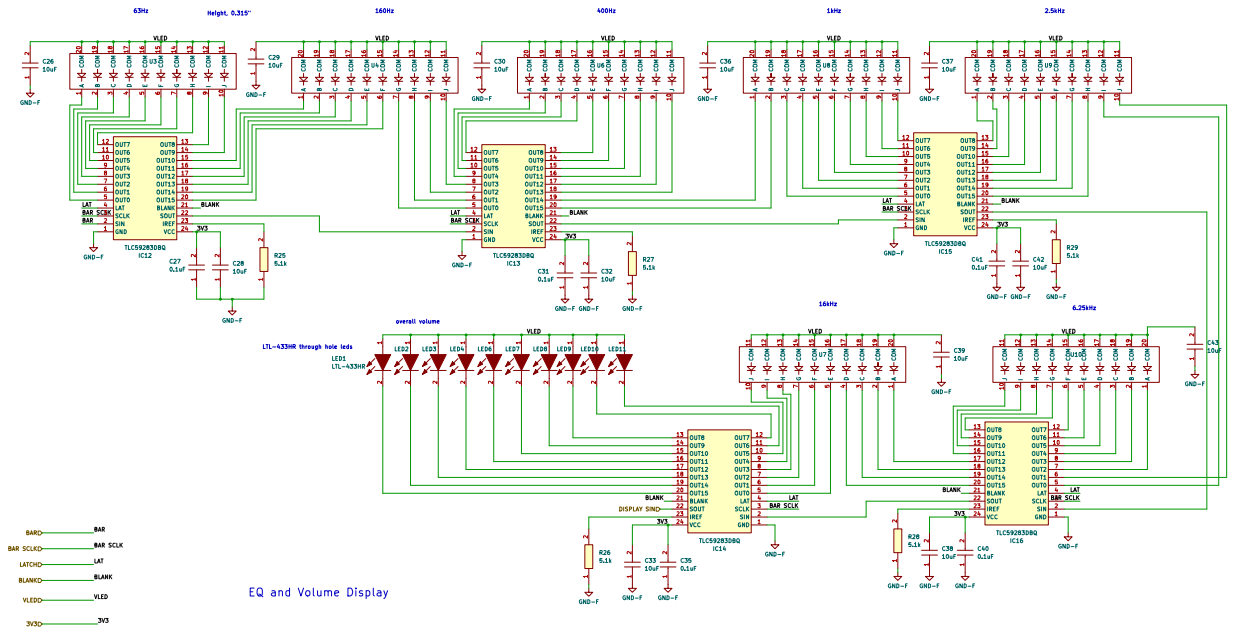
[picture p42: page 5]

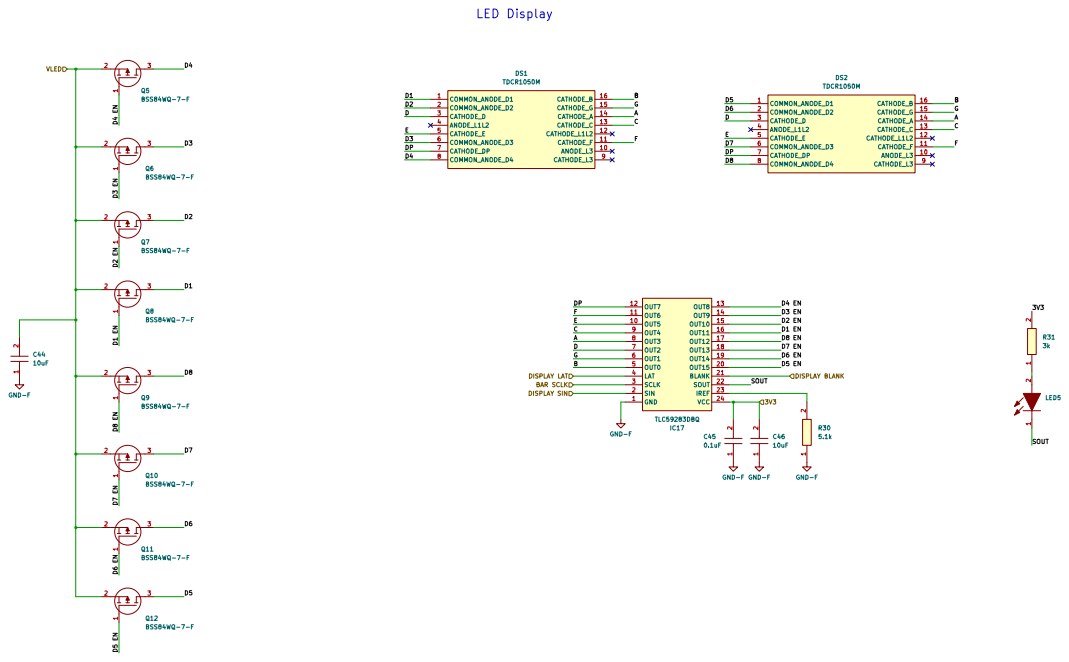
[picture p43: page 6]

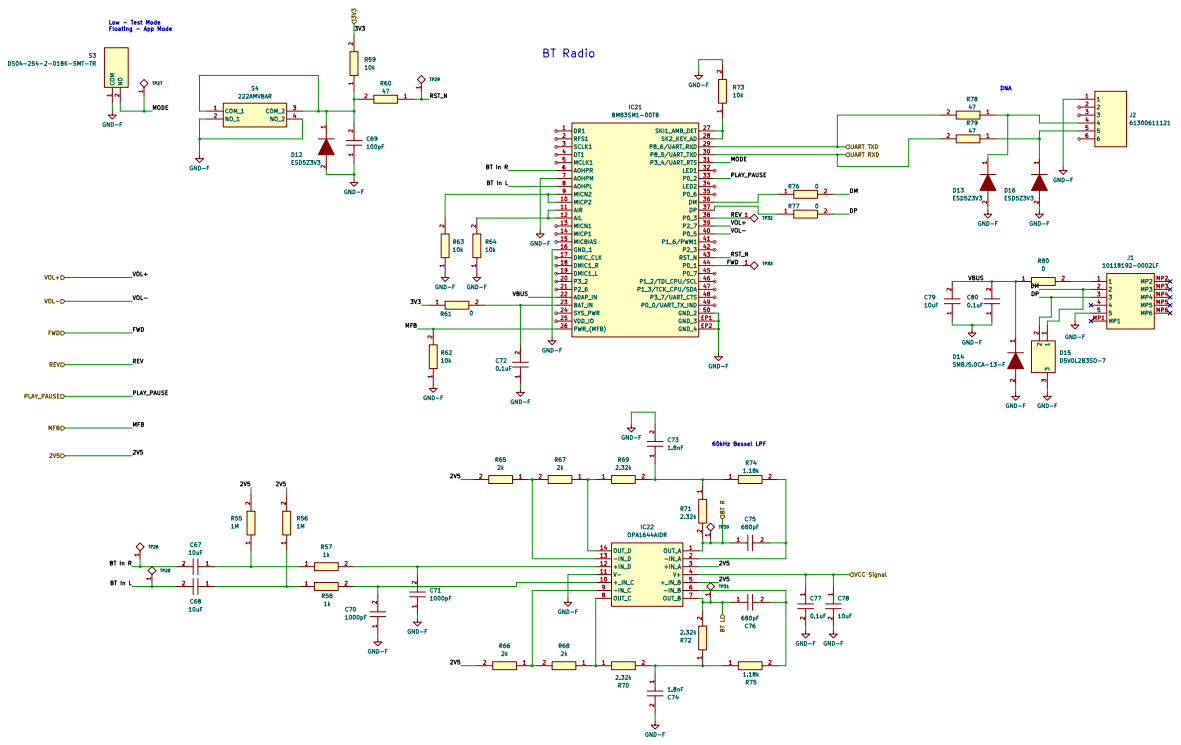
[picture p44: page 7]
