Alex-Wolfe/Home-Audio-System/Hardware/Simulations/push_pull_swing.asc

C1: cap; 10µ
C2: cap; 0.1µ
C3: cap; 330p
C4: cap; 10µ
C5: cap; 0.1µ
C6: cap; 330p
Q1: npn; tip142
Q2: pnp; tip147
Q3: npn; 2N3904
Q4: npn; tip142
Q5: pnp; tip147
Q6: npn; 2N3904
R1: res; 0.22
R2: res; 0.22
R3: res; 2.1k
R4: res; 2.1k
R5: res; 7k
R6: res; 3k
R7: res; 10k
R8: res; 10k
R9: res; 2k
R10: res; 0.22
R11: res; 0.22
R12: res; 2.1k
R13: res; 2.1k
R14: res; 7k
R15: res; 3k
R16: res; 10k
R17: res; 10k
R18: res; 2k
R19: res; 10k
R20: res; 10k
R21: res; 10k
R22: res; 10k
R23: res; 8
U1: opamp2; OPA1622
U2: opamp2; OPA1622
V1: voltage
Named nets: 0, voff, vin_inv, v+, v-
.tran 0 10m 0 1u
