Alex-Wolfe/Home-Audio-System/Hardware/Simulations/60khz bessel lpf.asc

C1: cap; 1.8n
C2: cap; 680p
R1: res; 2k
R2: res; 2k
R3: res; 2.32k
R4: res; 2.32k
R5: res; 1.18k
U1: LTC6241
U2: LTC6241
V1: voltage; 9
V2: voltage; SINE(2.5 0.5 1k); AC 1
V3: voltage; 2.5
V4: voltage; 2.5
V5: voltage; 9
Named nets: Vcc, 0, Vee
.tran 0 10m 0 1u
.ac dec 1000 1 100k
