Alex-Wolfe/Home-Audio-System/Hardware/Simulations/bp filter resistor value compare.asc

C1: cap; 0.1µ
C2: cap; 0.1µ
C3: cap; 0.1µ
C4: cap; 0.1µ
R1: res; 79.8k
R2: res; 628
R3: res; 159k
R4: res; 78.7k; tol=1
R5: res; 634; tol=1
R6: res; 160k; tol=1
U1: LTC6085
U2: LTC6085
V1: voltage; 28V
V2: voltage; 14
V3: voltage; SINE(14 13 1k); AC 1
V4: voltage; SINE(14 13 1k); AC 1
V5: voltage; 14
Named nets: 0, Vcc
.tran 0 10m 0 1u
.ac dec 1000 1 1Meg
