Alex-Wolfe/Home-Audio-System/Hardware/Simulations/bp filter.asc

C1: cap; 0.1µ; V=25 Irms=2.1 Rser=0.0606238 Lser=0 mfg="KEMET" pn="C1210C104K3RAC" type="X7R"
C2: cap; 0.1µ; V=25 Irms=0 Rser=0.037 Lser=674p mfg="Würth Elektronik" pn="885012210008 WCAP-CSGP 1812" type="X7R"
R1: res; 100
R2: res; 100k
R3: res; 100
R4: res; 100k
U1: ADA4661-2
U2: ADA4661-2
V1: voltage; 9V
V2: voltage; 9V
V3: voltage; SINE(0 4 150); AC 1
Named nets: 0, 9V, -9V
.tran 0 1 0 10u
.ac dec 1000 1 10Meg
