Alex-Wolfe/Home-Audio-System/Hardware/Simulations/eq filtering.asc

C1: cap; 22n
C2: cap; 0.1µ
C3: cap; 62n
C4: cap; 0.1µ
C5: cap; 82n
C6: cap; 0.1µ
C7: cap; 0.1µ
C8: cap; 0.1µ
C9: cap; 0.1µ
C10: cap; 0.1µ
C11: cap; 0.1µ
C12: cap; 0.1µ
R1: res; 5.33k
R2: res; 9.49k
R3: res; 3.62k
R4: res; 6.31k
R5: res; 6.54k
R6: res; 2.93k
R7: res; 3.71k
R8: res; 15.5k
R9: res; 5.51k
R10: res; 8.23k
R11: res; 6.26k
R12: res; 6.52k
R13: res; 10k
R14: res; 10k
R15: res; 10k
R16: res; 10k
U1: LTC6240
U2: LTC6240
U3: LTC6240
U4: LTC6240
U5: LTC6240
U6: LTC6240
U7: LTC6240
V1: voltage; 10
V2: voltage; 10
V3: voltage; 1; AC 1
Named nets: 0, Vee, Vcc
.ac dec 1000 1 100k
BESSEL
.tran 0 10m 0 1u startup
