Alex-Wolfe/Home-Audio-System/Hardware/Simulations/peak detector 2.asc

C1: cap; 0.1µ
C2: cap; 100p
C3: cap; 0.01µ
D1: schottky; BAT54
D2: schottky; BAT54
D3: diode; 1N4148
D4: diode; 1N4148
R1: res; 10k
R2: res; 5k
R3: res; 10k
R4: res; 1Meg
R5: res; 10k
R6: res; 100
R7: res; 10k
R8: res; 8k
R9: res; 1k
R10: res; 10k
R11: res; 10k
U1: LTC6240
U2: LTC6240
U3: LTC6240
U4: LTC6240
U5: LTC6240
U6: LTC6240
V1: voltage; 28V
V2: voltage; SINE(14 10 40)
V3: voltage; 14
V4: voltage; SINE(14 10 40)
Named nets: 0, Vcc
.tran 0 1 0 10u
.option plotwinsize=0
