Alex-Wolfe/Home-Audio-System/Hardware/Simulations/power_amp.asc

C1: cap; 37n
C2: cap; 84n
C3: cap; 10µ
C4: cap; 0.1µ
C5: cap; 330p
C6: cap; 37n
C7: cap; 84n
C8: cap; 10µ
C9: cap; 0.1µ
C10: cap; 330p
C11: cap; 100n
C12: cap; 100n
C13: cap; 100n
C14: cap; 100n
C15: cap; 1n
C16: cap; 1n
C17: cap; 1.21n
C18: cap; 7.15n
C19: cap; 10µ
C20: cap; 0.1µ
C21: cap; 330p
C22: cap; 10µ
C23: cap; 0.1µ
C24: cap; 330p
C25: polcap; 4700µ; V=35 Irms=2.86 Rser=0.026 Lser=31n mfg="Würth Elektronik" pn="860010581025 WCAP-ATG8 18x35,5" type="Al electrolytic"
C26: cap; 10µ; V=25 Irms=0 Rser=0 Lser=0 mfg="Murata" pn="GRM188R61E106KA73" type="X5R"
C27: cap; 0.1µ; V=25 Irms=0 Rser=0.035 Lser=766p mfg="Würth Elektronik" pn="885012205085R WCAP-CSGP 0402" type="X7R"
L1: ind; 8.4µ; Ipk=8.5 Rser=0.0068 Rpar=791.28 Cpar=0 mfg="Coilcraft" pn="SPT50H-842"
L2: ind; 8.4µ; Ipk=8.5 Rser=0.0068 Rpar=791.28 Cpar=0 mfg="Coilcraft" pn="SPT50H-842"
Q1: npn; tip102
Q2: pnp; tip107
Q3: npn; 2N3904
Q4: npn; tip102
Q5: pnp; tip107
Q6: npn; 2N3904
Q7: npn; tip102
Q8: pnp; tip107
Q9: npn; 2N3904
Q10: npn; tip102
Q11: pnp; tip107
Q12: npn; 2N3904
R1: res; 0.33
R2: res; 0.33
R3: res; 0.33
R4: res; 2.7k
R5: res; 2.7k
R6: res; 7k
R7: res; 3k
R8: res; 10k
R9: res; 10k
R10: res; 2k
R11: res; 0.33
R12: res; 2.7k
R13: res; 2.7k
R14: res; 7k
R15: res; 3k
R16: res; 10k
R17: res; 10k
R18: res; 2k
R19: res; 10k
R20: res; 10k
R21: res; 10k
R22: res; 10k
R23: res; 8
R24: res; 10k
R25: res; 10k
R26: res; 5.1k
R27: res; 10k
R28: res; 10k
R29: res; 5.1k
R30: res; 30k
R31: res; 10k
R32: res; 100k
R33: res; 100k
R34: res; 14k
R35: res; 14k
R36: res; 14k
R37: res; 14k
R38: res; 10.8k
R39: res; 4.8k
R40: res; 10.8k
R41: res; 4.8k
R42: res; 4.87k
R43: res; 6.81k
R44: res; 1.91k
R45: res; 2.94k
R46: res; 100k
R47: res; 100k
R48: res; 10k
R49: res; 10k
R50: res; 5.1k
R51: res; 10k
R52: res; 100k
R53: res; 10k
R54: res; 100k
R55: res; 10k
R56: res; 10k
R57: res; 0.33
R58: res; 0.33
R59: res; 2.7k
R60: res; 2.7k
R61: res; 7k
R62: res; 3k
R63: res; 10k
R64: res; 10k
R65: res; 2k
R66: res; 0.33
R67: res; 0.33
R68: res; 2.7k
R69: res; 2.7k
R70: res; 7k
R71: res; 3k
R72: res; 10k
R73: res; 10k
R74: res; 2k
R75: res; 10k
R76: res; 10k
R77: res; 10k
R78: res; 10k
R79: res; 8
R80: res; 10k
R81: res; 10k
R82: res; 10k
R83: res; 10k
R84: res; 250k
R85: res; 5k
R86: res; 10k
R87: res; 10k
U1: opamp2; TL074
U2: opamp2; TL074
U3: opamp2; TL074
U4: opamp2; TL074
U5: opamp2; TL074
U6: opamp2; TL074
U7: opamp2; TL074
U8: opamp2; TL074
U9: opamp2; TL074
U10: opamp2; TL074
U11: pot
U12: pot; Rtot=10K wiper=0.5
U13: opamp2; TL074
U14: opamp2; TL074
U15: opamp2; TL074
U16: opamp2; TL074
U17: opamp2; TL074
U18: opamp2; TL074
U19: pot
U20: opamp2; TL074
U21: opamp2; TL074
U22: opamp2; TL074
U23: opamp2; TL074
V1: voltage; 15
V2: voltage; 15
V3: voltage; SINE(0 100m 1k 0 0); AC 1
V4: voltage; 18
Named nets: 0, Vcc, Vee, vpower, vcc, voff, preampout, vin, vin_inv, v+, v-, linein, MSGEQ7in, MSGEQ7out, LM3915in
.SUBCKT tip102 1 2 3
**************************************
*      Model Generated by MODPEX     *
*Copyright(c) Symmetry Design Systems*
*         All Rights Reserved        *
*    UNPUBLISHED LICENSED SOFTWARE   *
*   Contains Proprietary Information *
*      Which is The Property of      *
*     SYMMETRY OR ITS LICENSORS      *
*Commercial Use or Resale Restricted *
*   by Symmetry License Agreement    *
**************************************
* Model generated on Jan 20, 03
* MODEL FORMAT: SPICE3
* Darlington macro model
* External node designations
* Node 1 -> Collect
* Node 2 -> Base
* Node 3 -> Emitter
Q1 1 2 4 qmodel
Q2 1 4 3 q1model area=11.2198
D1 3 1 dmodel
R1 2 4 8000
R2 4 3 120
* Default values used in dmodel
*   EG=1.11 TT=0 BV=infinite
.MODEL dmodel d
+IS=1e-12 RS=10 N=1 XTI=3
+CJO=0 VJ=0.75 M=0.33 FC=0.5
.MODEL qmodel npn
+IS=2.88485e-13 BF=126.335 NF=1.2 VAF=30
+IKF=0.132527 ISE=6.51929e-12 NE=1.9601 BR=0.100001
+NR=1.5 VAR=300 IKR=0.0843484 ISC=1.01027e-13
+NC=1.92564 RB=2.61873 IRB=0.2 RBM=2.61873
+RE=0.0001 RC=2.60372 XTB=0 XTI=4 EG=1.206
+CJE=1.13087e-10 VJE=0.95 MJE=0.692676 TF=1e-09
+XTF=1 VTF=10 ITF=0.01 CJC=1.56651e-10
+VJC=0.908287 MJC=0.23 XCJC=0.897966 FC=0.5
+TR=1e-07 PTF=0 KF=0 AF=1
.MODEL q1model npn
+IS=2.88485e-13 BF=126.335 NF=1.2 VAF=30
+IKF=0.132527 ISE=6.51929e-12 NE=1.9601 BR=0.100001
+NR=1.5 VAR=300 IKR=0.0843484 ISC=1.01027e-13
+NC=1.92564 RB=2.61873 IRB=0.2 RBM=2.61873
+RE=0.0001 RC=2.60372 XTB=0 XTI=4 EG=1.206
+CJE=1.13087e-10 VJE=0.95 MJE=0.692676 TF=1e-09
+XTF=1 VTF=10 ITF=0.01 CJC=0
+VJC=0.908287 MJC=0.23 XCJC=0.897966 FC=0.5
+TR=1e-07 PTF=0 KF=0 AF=1
.ENDS tip102
.SUBCKT tip107 1 2 3
**************************************
*      Model Generated by MODPEX     *
*Copyright(c) Symmetry Design Systems*
*         All Rights Reserved        *
*    UNPUBLISHED LICENSED SOFTWARE   *
*   Contains Proprietary Information *
*      Which is The Property of      *
*     SYMMETRY OR ITS LICENSORS      *
*Commercial Use or Resale Restricted *
*   by Symmetry License Agreement    *
**************************************
* Model generated on Jan 20, 03
* MODEL FORMAT: SPICE3
* Darlington macro model
* External node designations
* Node 1 -> Collect
* Node 2 -> Base
* Node 3 -> Emitter
Q1 1 2 4 qmodel
Q2 1 4 3 q1model area=10.2983
D1 1 3 dmodel
R1 2 4 8000
R2 4 3 120
* Default values used in dmodel
*   EG=1.11 TT=0 BV=infinite
.MODEL dmodel d
+IS=1e-12 RS=10 N=1 XTI=3
+CJO=0 VJ=0.75 M=0.33 FC=0.5
.MODEL qmodel pnp
+IS=1.0012e-12 BF=116.055 NF=1.05819 VAF=92.7382
+IKF=0.149857 ISE=1.24495e-12 NE=1.70621 BR=0.999735
+NR=0.993731 VAR=100.194 IKR=0.0999992 ISC=1e-13
+NC=2 RB=10.3948 IRB=0.200382 RBM=10.1772
+RE=0.163782 RC=1.00023 XTB=0.505844 XTI=3.00058 EG=1.13482
+CJE=1.53127e-10 VJE=0.95 MJE=0.469947 TF=1e-09
+XTF=1 VTF=10 ITF=0.01 CJC=2.51701e-10
+VJC=0.95 MJC=0.256722 XCJC=0.9 FC=0.5
+TR=1e-07 PTF=0 KF=0 AF=1
.MODEL q1model pnp
+IS=1.0012e-12 BF=116.055 NF=1.05819 VAF=92.7382
+IKF=0.149857 ISE=1.24495e-12 NE=1.70621 BR=0.999735
+NR=0.993731 VAR=100.194 IKR=0.0999992 ISC=1e-13
+NC=2 RB=10.3948 IRB=0.200382 RBM=10.1772
+RE=0.163782 RC=1.00023 XTB=0.505844 XTI=3.00058 EG=1.13482
+CJE=1.53127e-10 VJE=0.95 MJE=0.469947 TF=1e-09
+XTF=1 VTF=10 ITF=0.01 CJC=0
+VJC=0.95 MJC=0.256722 XCJC=0.9 FC=0.5
+TR=1e-07 PTF=0 KF=0 AF=1
.ENDS tip107
.tran 0 10m 0 100u
* TL074 OPERATIONAL AMPLIFIER "MACROMODEL" SUBCIRCUIT
* CREATED USING PARTS RELEASE 4.01 ON 06/16/89 AT 13:08
* (REV N/A)      SUPPLY VOLTAGE: +/-15V
* CONNECTIONS:   NON-INVERTING INPUT
*                | INVERTING INPUT
*                | | POSITIVE POWER SUPPLY
*                | | | NEGATIVE POWER SUPPLY
*                | | | | OUTPUT
*                | | | | |
.SUBCKT TL074    1 2 3 4 5
*
  C1   11 12 3.498E-12
  C2    6  7 15.00E-12
  DC    5 53 DX
  DE   54  5 DX
  DLP  90 91 DX
  DLN  92 90 DX
  DP    4  3 DX
  EGND 99  0 POLY(2) (3,0) (4,0) 0 .5 .5
  FB    7 99 POLY(5) VB VC VE VLP VLN 0 4.715E6 -5E6 5E6 5E6 -5E6
  GA    6  0 11 12 282.8E-6
  GCM   0  6 10 99 8.942E-9
  ISS   3 10 DC 195.0E-6
  HLIM 90  0 VLIM 1K
  J1   11  2 10 JX
  J2   12  1 10 JX
  R2    6  9 100.0E3
  RD1   4 11 3.536E3
  RD2   4 12 3.536E3
  RO1   8  5 150
  RO2   7 99 150
  RP    3  4 2.143E3
  RSS  10 99 1.026E6
  VB    9  0 DC 0
  VC    3 53 DC 2.200
  VE   54  4 DC 2.200
  VLIM  7  8 DC 0
  VLP  91  0 DC 25
  VLN   0 92 DC 25
.MODEL DX D(IS=800.0E-18)
.MODEL JX PJF(IS=15.00E-12 BETA=270.1E-6 VTO=-1)
.ENDS
.include pot.sub
Speaker 2
Speaker 1
Output Stage Bias
Input Inverter for BTL
Equalizer
High Gain Stage
* fetched on 2015/3/15 from http://www.ti.com/lit/zip/sloj043
* LM324 OPERATIONAL AMPLIFIER "MACROMODEL" SUBCIRCUIT
* CREATED USING PARTS RELEASE 4.01 ON 09/08/89 AT 10:54
* (REV N/A)      SUPPLY VOLTAGE: 5V
* CONNECTIONS:   NON-INVERTING INPUT
*                | INVERTING INPUT
*                | | POSITIVE POWER SUPPLY
*                | | | NEGATIVE POWER SUPPLY
*                | | | | OUTPUT
*                | | | | |
.SUBCKT LM324    1 2 3 4 5
*
  C1   11 12 5.544E-12
  C2    6  7 20.00E-12
  DC    5 53 DX
  DE   54  5 DX
  DLP  90 91 DX
  DLN  92 90 DX
  DP    4  3 DX
  EGND 99  0 POLY(2) (3,0) (4,0) 0 .5 .5
  FB    7 99 POLY(5) VB VC VE VLP VLN 0 15.91E6 -20E6 20E6 20E6 -20E6
  GA    6  0 11 12 125.7E-6
  GCM   0  6 10 99 7.067E-9
  IEE   3 10 DC 10.04E-6
  HLIM 90  0 VLIM 1K
  Q1   11  2 13 QX
  Q2   12  1 14 QX
  R2    6  9 100.0E3
  RC1   4 11 7.957E3
  RC2   4 12 7.957E3
  RE1  13 10 2.773E3
  RE2  14 10 2.773E3
  REE  10 99 19.92E6
  RO1   8  5 50
  RO2   7 99 50
  RP    3  4 30.31E3
  VB    9  0 DC 0
  VC 3 53 DC 2.100
  VE   54  4 DC .6
  VLIM  7  8 DC 0
  VLP  91  0 DC 40
  VLN   0 92 DC 40
.MODEL DX D(IS=800.0E-18)
.MODEL QX PNP(IS=800.0E-18 BF=250)
.ENDS
