Alex-Wolfe/Home-Audio-System/Hardware/Simulations/power_supplies.asc

C1: polcap; 4700µ; V=35 Irms=2.03 Rser=0.1 Lser=0
L1: ind; 1.5µ; Ipk=18.2 Rser=0.0024 Rpar=141.3 Cpar=0 mfg="Coilcraft" pn="PCV-1-152-15"
V4: voltage; ""; AC 1; Rser=0
Named nets: 0
.ac dec 1000 5m 1G
