Alex-Wolfe/Home-Audio-System/Hardware/Design/Main Board/Native Kicad/2V5 Signal.kicad_sch

## KiCad design Hardware/Design/Main Board/Native Kicad/2V5 Signal.kicad_sch (2025-06-05)

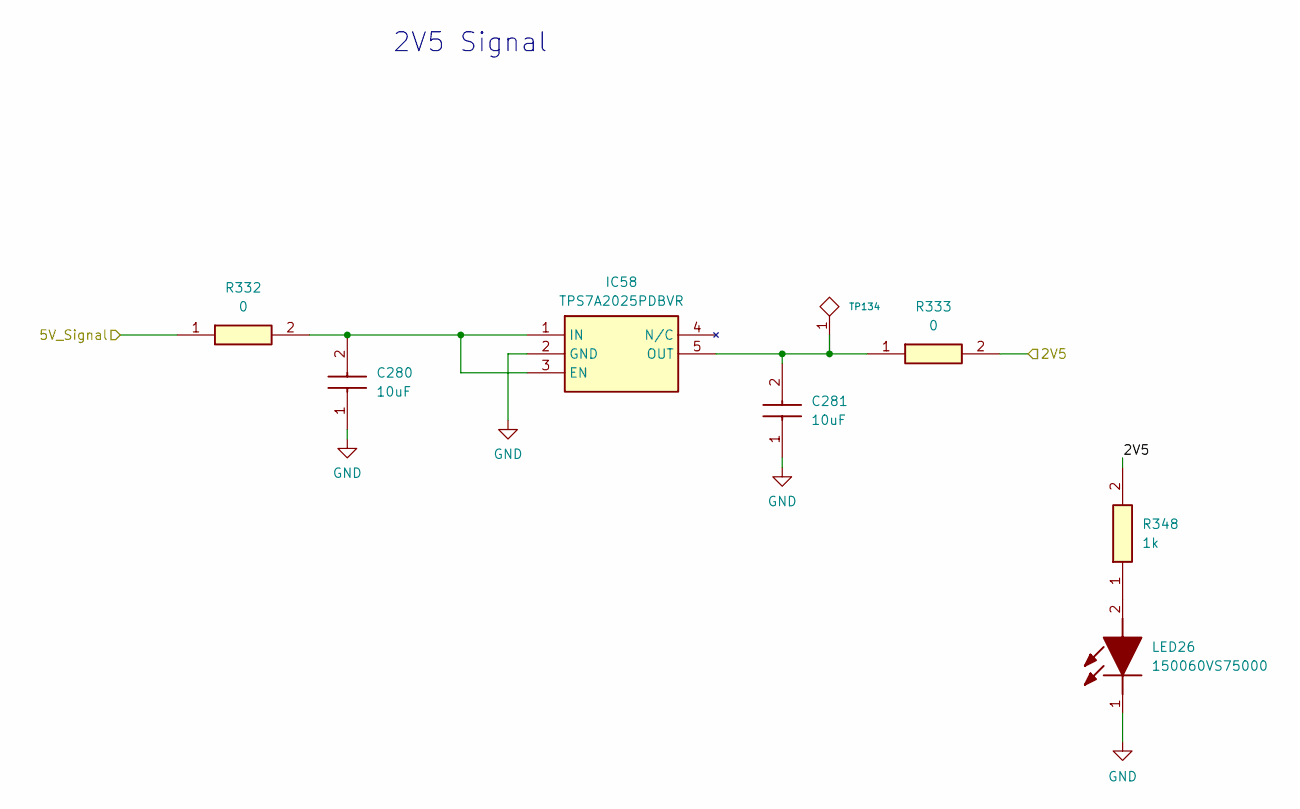
[picture p53: schematic 2V5 Signal.kicad_sch]

Parts:
C280, C281: 10uF; CAPC2012X145N; Manufacturer_Part_Number GRM21BR61C106KE15K; Mouser Part Number 81-GRM21BR61C106KE5K
IC58: TPS7A2025PDBVR; SOT95P280X145-5N; Manufacturer_Part_Number TPS7A2025PDBVR; Mouser Part Number 595-TPS7A2025PDBVR
LED26: 150060VS75000; LEDC1608X80N; Manufacturer_Part_Number 150060VS75000; Mouser Part Number 710-150060VS75000
R332, R333: 0; RESC1608X55N; Manufacturer_Part_Number RC0603JR-070RL; Mouser Part Number 603-RC0603JR-070RL
R348: 1k; RESC1608X55N; Manufacturer_Part_Number RC0603FR-071KL; Mouser Part Number 603-RC0603FR-071KL
TP134: TP

Connections:
2V5: R333.2, R348.2
5V_Signal: R332.1
GND: C280.1, C281.1, IC58.2 (GND), LED26.1 (K)
unnamed: C280.2, IC58.1 (IN), IC58.3 (EN), R332.2
unnamed: C281.2, IC58.5 (OUT), R333.1, TP134.1
unnamed: LED26.2 (A), R348.1

Notes on the sheet:
2V5 Signal
