Alex-Wolfe/Home-Audio-System/Hardware/Design/Main Board/Native Kicad/3V3 Lin Reg.kicad_sch

## KiCad design Hardware/Design/Main Board/Native Kicad/3V3 Lin Reg.kicad_sch (2025-06-05)

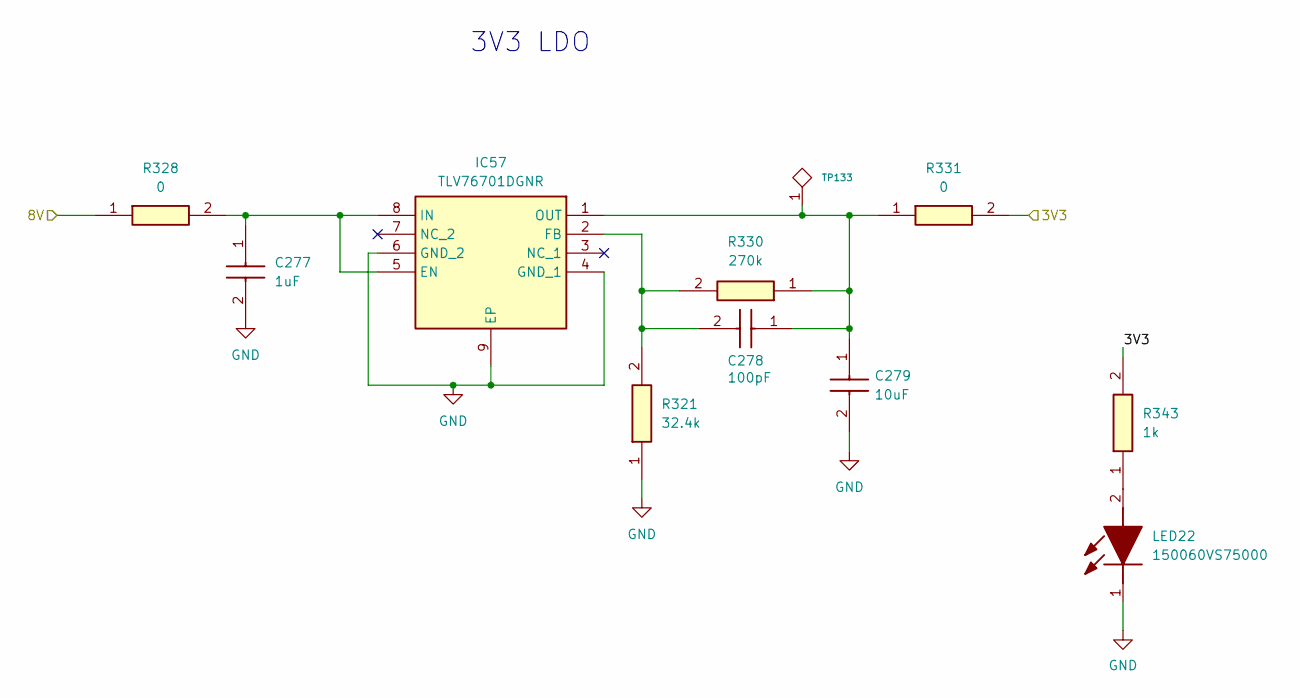
[picture p54: schematic 3V3 Lin Reg.kicad_sch]

Parts:
C277: 1uF; CAPC2012X135N; Manufacturer_Part_Number CL21B105KOFNNNE; Mouser Part Number 187-CL21B105KOFNNNE
C278: 100pF; CAPC2012X70N; Manufacturer_Part_Number 885012007034; Mouser Part Number 710-885012007034
C279: 10uF; CAPC3216X180N; Manufacturer_Part_Number CL31A106MBHNNNE; Mouser Part Number 187-CL31A106MBHNNNE
IC57: TLV76701DGNR; SOP65P490X110-9N; Manufacturer_Part_Number TLV76701DGNR; Mouser Part Number 595-TLV76701DGNR
LED22: 150060VS75000; LEDC1608X80N; Manufacturer_Part_Number 150060VS75000; Mouser Part Number 710-150060VS75000
R321: 32.4k; RESC1608X55N; Manufacturer_Part_Number RC0603FR-0732K4L; Mouser Part Number 603-RC0603FR-0732K4L
R328, R331: 0; RESC1608X55N; Manufacturer_Part_Number RC0603JR-070RL; Mouser Part Number 603-RC0603JR-070RL
R330: 270k; RESC2012X60N; Manufacturer_Part_Number RC0805FR-07270KL; Mouser Part Number 603-RC0805FR-07270KL
R343: 1k; RESC1608X55N; Manufacturer_Part_Number RC0603FR-071KL; Mouser Part Number 603-RC0603FR-071KL
TP133: TP

Connections:
3V3: R331.2, R343.2
8V: R328.1
GND: C277.2, C279.2, IC57.4 (GND_1), IC57.6 (GND_2), IC57.9 (EP), LED22.1 (K), R321.1
unnamed: C277.1, IC57.5 (EN), IC57.8 (IN), R328.2
unnamed: C278.1, C279.1, IC57.1 (OUT), R330.1, R331.1, TP133.1
unnamed: C278.2, IC57.2 (FB), R321.2, R330.2
unnamed: LED22.2 (A), R343.1

Notes on the sheet:
3V3 LDO
