Alex-Wolfe/Home-Audio-System/Hardware/Design/Main Board/Native Kicad/5V Signal.kicad_sch

## KiCad design Hardware/Design/Main Board/Native Kicad/5V Signal.kicad_sch (2025-06-05)

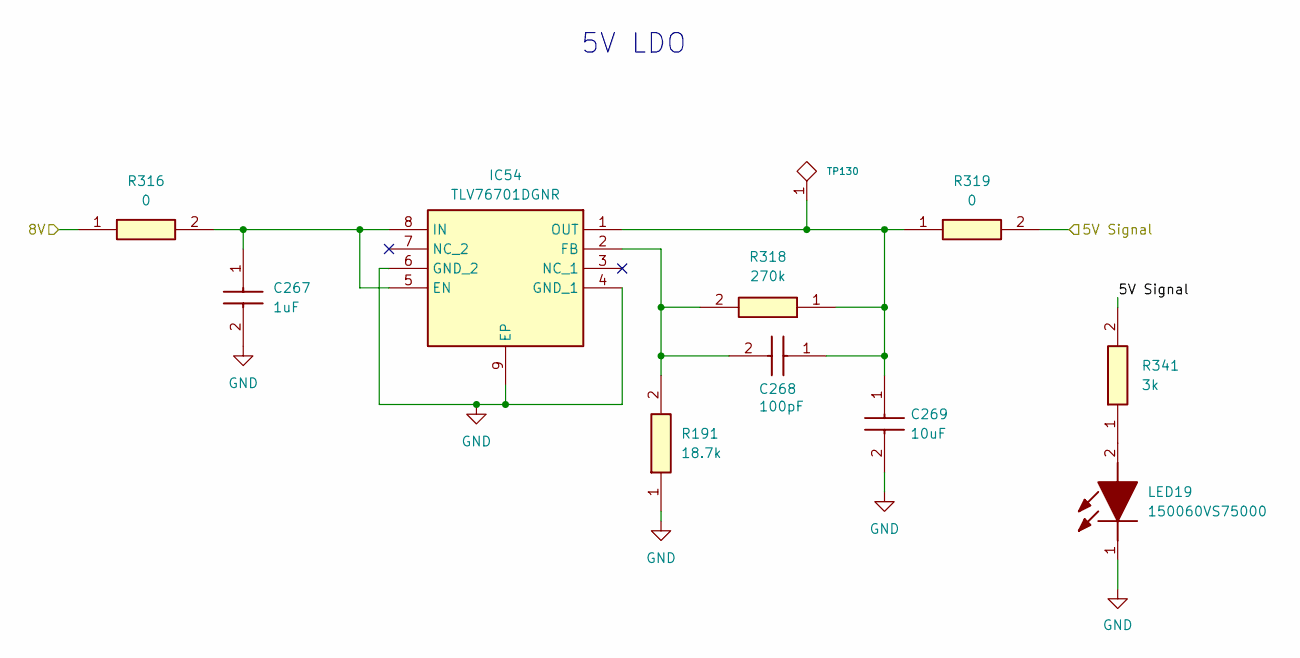
[picture p55: schematic 5V Signal.kicad_sch]

Parts:
C267: 1uF; CAPC2012X135N; Manufacturer_Part_Number CL21B105KOFNNNE; Mouser Part Number 187-CL21B105KOFNNNE
C268: 100pF; CAPC2012X70N; Manufacturer_Part_Number 885012007034; Mouser Part Number 710-885012007034
C269: 10uF; CAPC3216X180N; Manufacturer_Part_Number CL31A106MBHNNNE; Mouser Part Number 187-CL31A106MBHNNNE
IC54: TLV76701DGNR; SOP65P490X110-9N; Manufacturer_Part_Number TLV76701DGNR; Mouser Part Number 595-TLV76701DGNR
LED19: 150060VS75000; LEDC1608X80N; Manufacturer_Part_Number 150060VS75000; Mouser Part Number 710-150060VS75000
R191: 18.7k; RESC1608X55N; Manufacturer_Part_Number RC0603FR-0718K7L; Mouser Part Number 603-RC0603FR-0718K7L
R316, R319: 0; RESC1608X55N; Manufacturer_Part_Number RC0603JR-070RL; Mouser Part Number 603-RC0603JR-070RL
R318: 270k; RESC2012X60N; Manufacturer_Part_Number RC0805FR-07270KL; Mouser Part Number 603-RC0805FR-07270KL
R341: 3k; RESC1608X55N; Manufacturer_Part_Number RC0603FR-073KL; Mouser Part Number 603-RC0603FR-073KL
TP130: TP

Connections:
5V Signal: R319.2, R341.2
8V: R316.1
GND: C267.2, C269.2, IC54.4 (GND_1), IC54.6 (GND_2), IC54.9 (EP), LED19.1 (K), R191.1
unnamed: C267.1, IC54.5 (EN), IC54.8 (IN), R316.2
unnamed: C268.1, C269.1, IC54.1 (OUT), R318.1, R319.1, TP130.1
unnamed: C268.2, IC54.2 (FB), R191.2, R318.2
unnamed: LED19.2 (A), R341.1

Notes on the sheet:
5V LDO
