Alex-Wolfe/Home-Audio-System/Hardware/Design/Main Board/Native Kicad/8V Buck.kicad_sch

## KiCad design Hardware/Design/Main Board/Native Kicad/8V Buck.kicad_sch (2025-06-05)

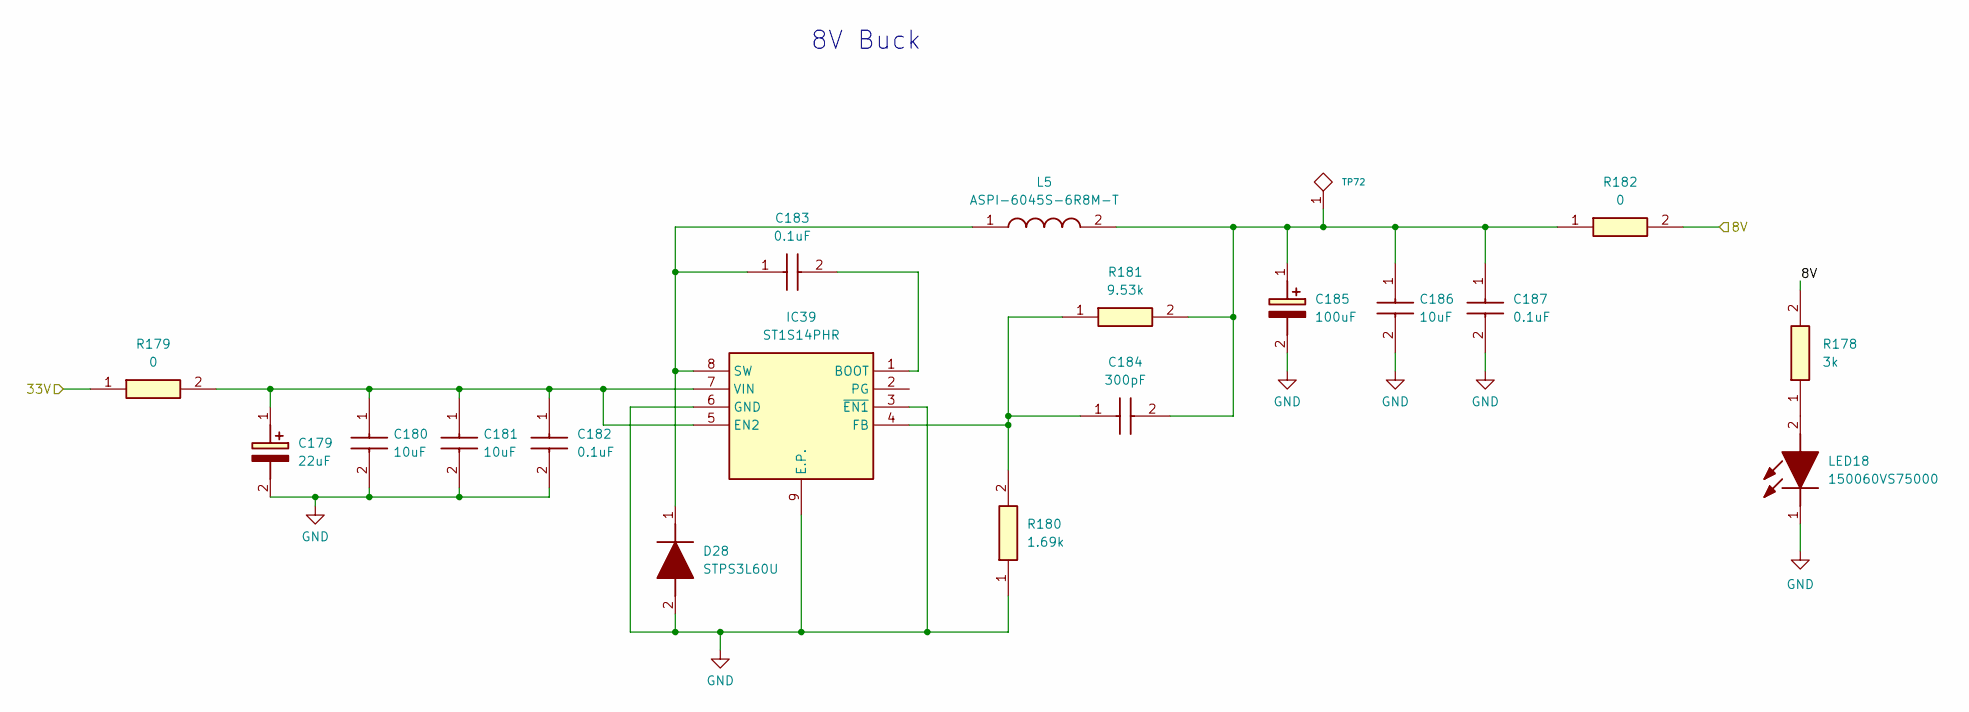
[picture p56: schematic 8V Buck.kicad_sch]

Parts:
C179: 22uF; CAPPRD200W55D500H1250; Manufacturer_Part_Number EEU-FR1H100B; Mouser Part Number 667-EEU-FR1H100B
C180, C181, C186: 10uF; CAPC3216X180N; Manufacturer_Part_Number CL31A106MBHNNNE; Mouser Part Number 187-CL31A106MBHNNNE
C182, C183, C187: 0.1uF; C0603; Manufacturer_Part_Number C0603C104M5RACTU; Mouser Part Number 80-C0603C104M5R
C184: 300pF; GCM155; Manufacturer_Part_Number GCM1555C1H301JA16D; Mouser Part Number 81-GCM1555C1H301JA6D
C185: 100uF; 865080343009; Manufacturer_Part_Number 865080343009; Mouser Part Number 710-865080343009
D28: STPS3L60U; SMBJ50CA; Manufacturer_Part_Number STPS3L60U; Mouser Part Number 511-STPS3L60U
IC39: ST1S14PHR; SOIC127P600X175-9N; Manufacturer_Part_Number ST1S14PHR; Mouser Part Number 511-ST1S14PHR
L5: ASPI-6045S-6R8M-T; ASPI-6045S; Manufacturer_Part_Number ASPI-6045S-6R8M-T; Mouser Part Number 815-ASPI-6045S-6R8MT
LED18: 150060VS75000; LEDC1608X80N; Manufacturer_Part_Number 150060VS75000; Mouser Part Number 710-150060VS75000
R178: 3k; RESC1608X55N; Manufacturer_Part_Number RC0603FR-073KL; Mouser Part Number 603-RC0603FR-073KL
R179, R182: 0; RESC1608X55N; Manufacturer_Part_Number RC0603JR-070RL; Mouser Part Number 603-RC0603JR-070RL
R180: 1.69k; RESC1608X55N; Manufacturer_Part_Number RC0603FR-071K69L; Mouser Part Number 603-RC0603FR-071K69L
R181: 9.53k; RESC1608X55N; Manufacturer_Part_Number RC0603FR-079K53L; Mouser Part Number 603-RC0603FR-079K53L
TP72: TP

Connections:
8V: R178.2, R182.2
33V: R179.1
GND: C179.2 (-), C180.2, C181.2, C182.2, C185.2 (-), C186.2, C187.2, D28.2 (A), IC39.3 (~EN1), IC39.6 (GND), IC39.9 (E.P.), LED18.1 (K), R180.1
unnamed: C179.1 (+), C180.1, C181.1, C182.1, IC39.5 (EN2), IC39.7 (VIN), R179.2
unnamed: C183.1, D28.1 (K), IC39.8 (SW), L5.1
unnamed: C183.2, IC39.1 (BOOT)
unnamed: C184.1, IC39.4 (FB), R180.2, R181.1
unnamed: C184.2, C185.1 (+), C186.1, C187.1, L5.2, R181.2, R182.1, TP72.1
unnamed: LED18.2 (A), R178.1

Notes on the sheet:
8V Buck
