Alex-Wolfe/Home-Audio-System/Hardware/Design/Main Board/Native Kicad/20V Lin Reg.kicad_sch

## KiCad design Hardware/Design/Main Board/Native Kicad/20V Lin Reg.kicad_sch (2025-06-05)

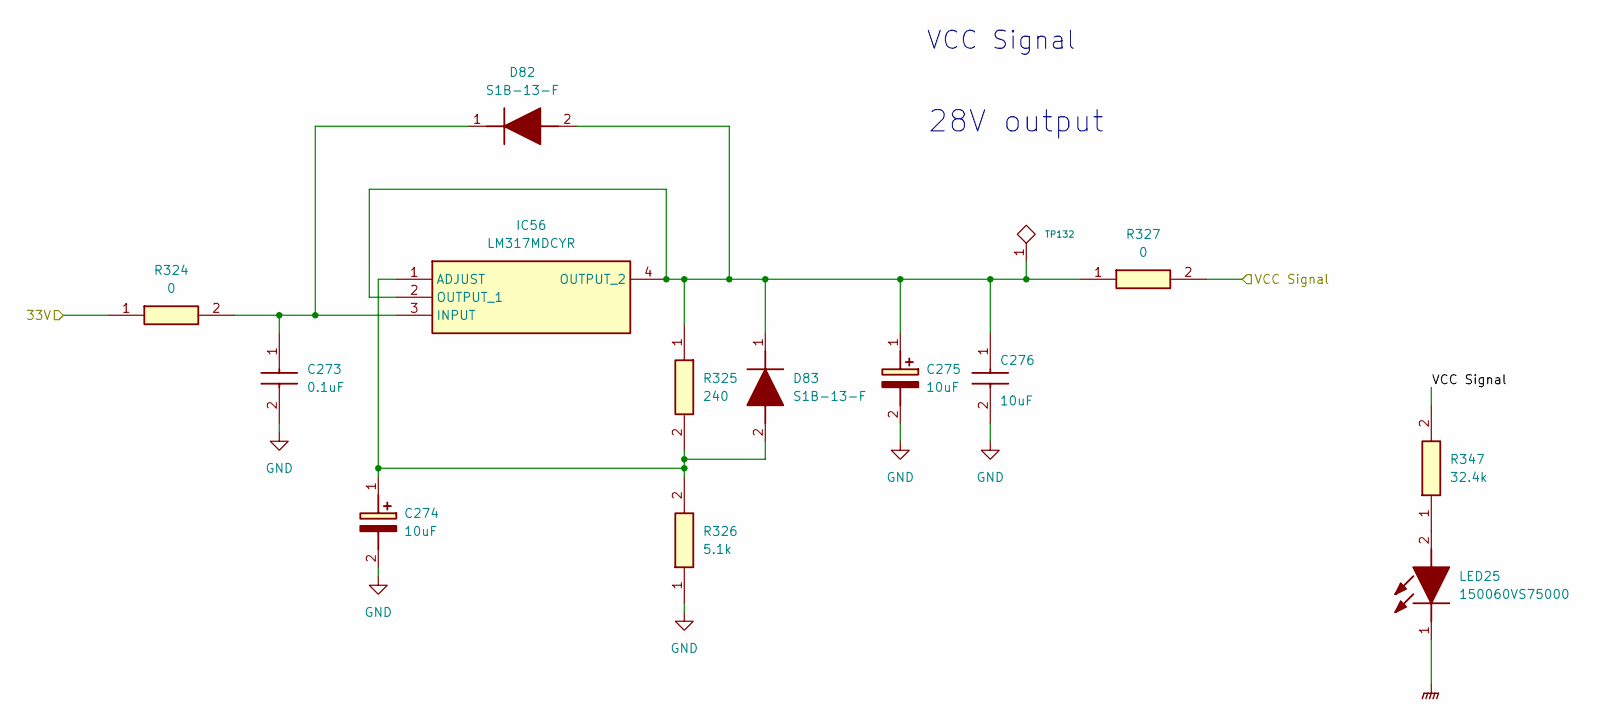
[picture p57: schematic 20V Lin Reg.kicad_sch]

Parts:
C273: 0.1uF; C0603; Manufacturer_Part_Number C0603C104M5RACTU; Mouser Part Number 80-C0603C104M5R
C274, C275: 10uF; CAPPRD200W55D500H1200; Manufacturer_Part_Number A759BQ106M1VAAE090; Mouser Part Number 80-A759BQ106M1VAAE90
C276: 10uF; GRM21x; Manufacturer_Part_Number GRM21BR61H106KE43L; Mouser Part Number 81-GRM21BR61H106KE3L
D82, D83: S1B-13-F; DIONM5126X230N; Manufacturer_Part_Number S1B-13-F; Mouser Part Number 621-S1B-F
IC56: LM317MDCYR; SOT230P700X180-4N; Manufacturer_Part_Number LM317MDCYR; Mouser Part Number 595-LM317MDCYR
LED25: 150060VS75000; LEDC1608X80N; Manufacturer_Part_Number 150060VS75000; Mouser Part Number 710-150060VS75000
R324, R327: 0; RESC1608X55N; Manufacturer_Part_Number RC0603JR-070RL; Mouser Part Number 603-RC0603JR-070RL
R325: 240; RESC2012X60N; Manufacturer_Part_Number RC0805FR-07240RL; Mouser Part Number 603-RC0805FR-07240RL
R326: 5.1k; RESC3216X60N; Manufacturer_Part_Number CRCW12065K10FKEA; Mouser Part Number 71-CRCW1206-5.1K-E3
R347: 32.4k; RESC1608X55N; Manufacturer_Part_Number RC0603FR-0732K4L; Mouser Part Number 603-RC0603FR-0732K4L
TP132: TP

Connections:
33V: R324.1
GND: C273.2, C274.2 (-), C275.2 (-), C276.2, R326.1
GNDPWR: LED25.1 (K)
unnamed: C273.1, D82.1 (K), IC56.3 (INPUT), R324.2
unnamed: C274.1 (+), D83.2 (A), IC56.1 (ADJUST), R325.2, R326.2
unnamed: C275.1 (+), C276.1, D82.2 (A), D83.1 (K), IC56.2 (OUTPUT_1), IC56.4 (OUTPUT_2), R325.1, R327.1, TP132.1
unnamed: LED25.2 (A), R347.1
VCC Signal: R327.2, R347.2

Notes on the sheet:
VCC Signal
28V output
