Alex-Wolfe/Home-Audio-System/Hardware/Design/Main Board/Native Kicad/AUXIN_sch.kicad_sch

## KiCad design Hardware/Design/Main Board/Native Kicad/AUXIN_sch.kicad_sch (2025-06-05)

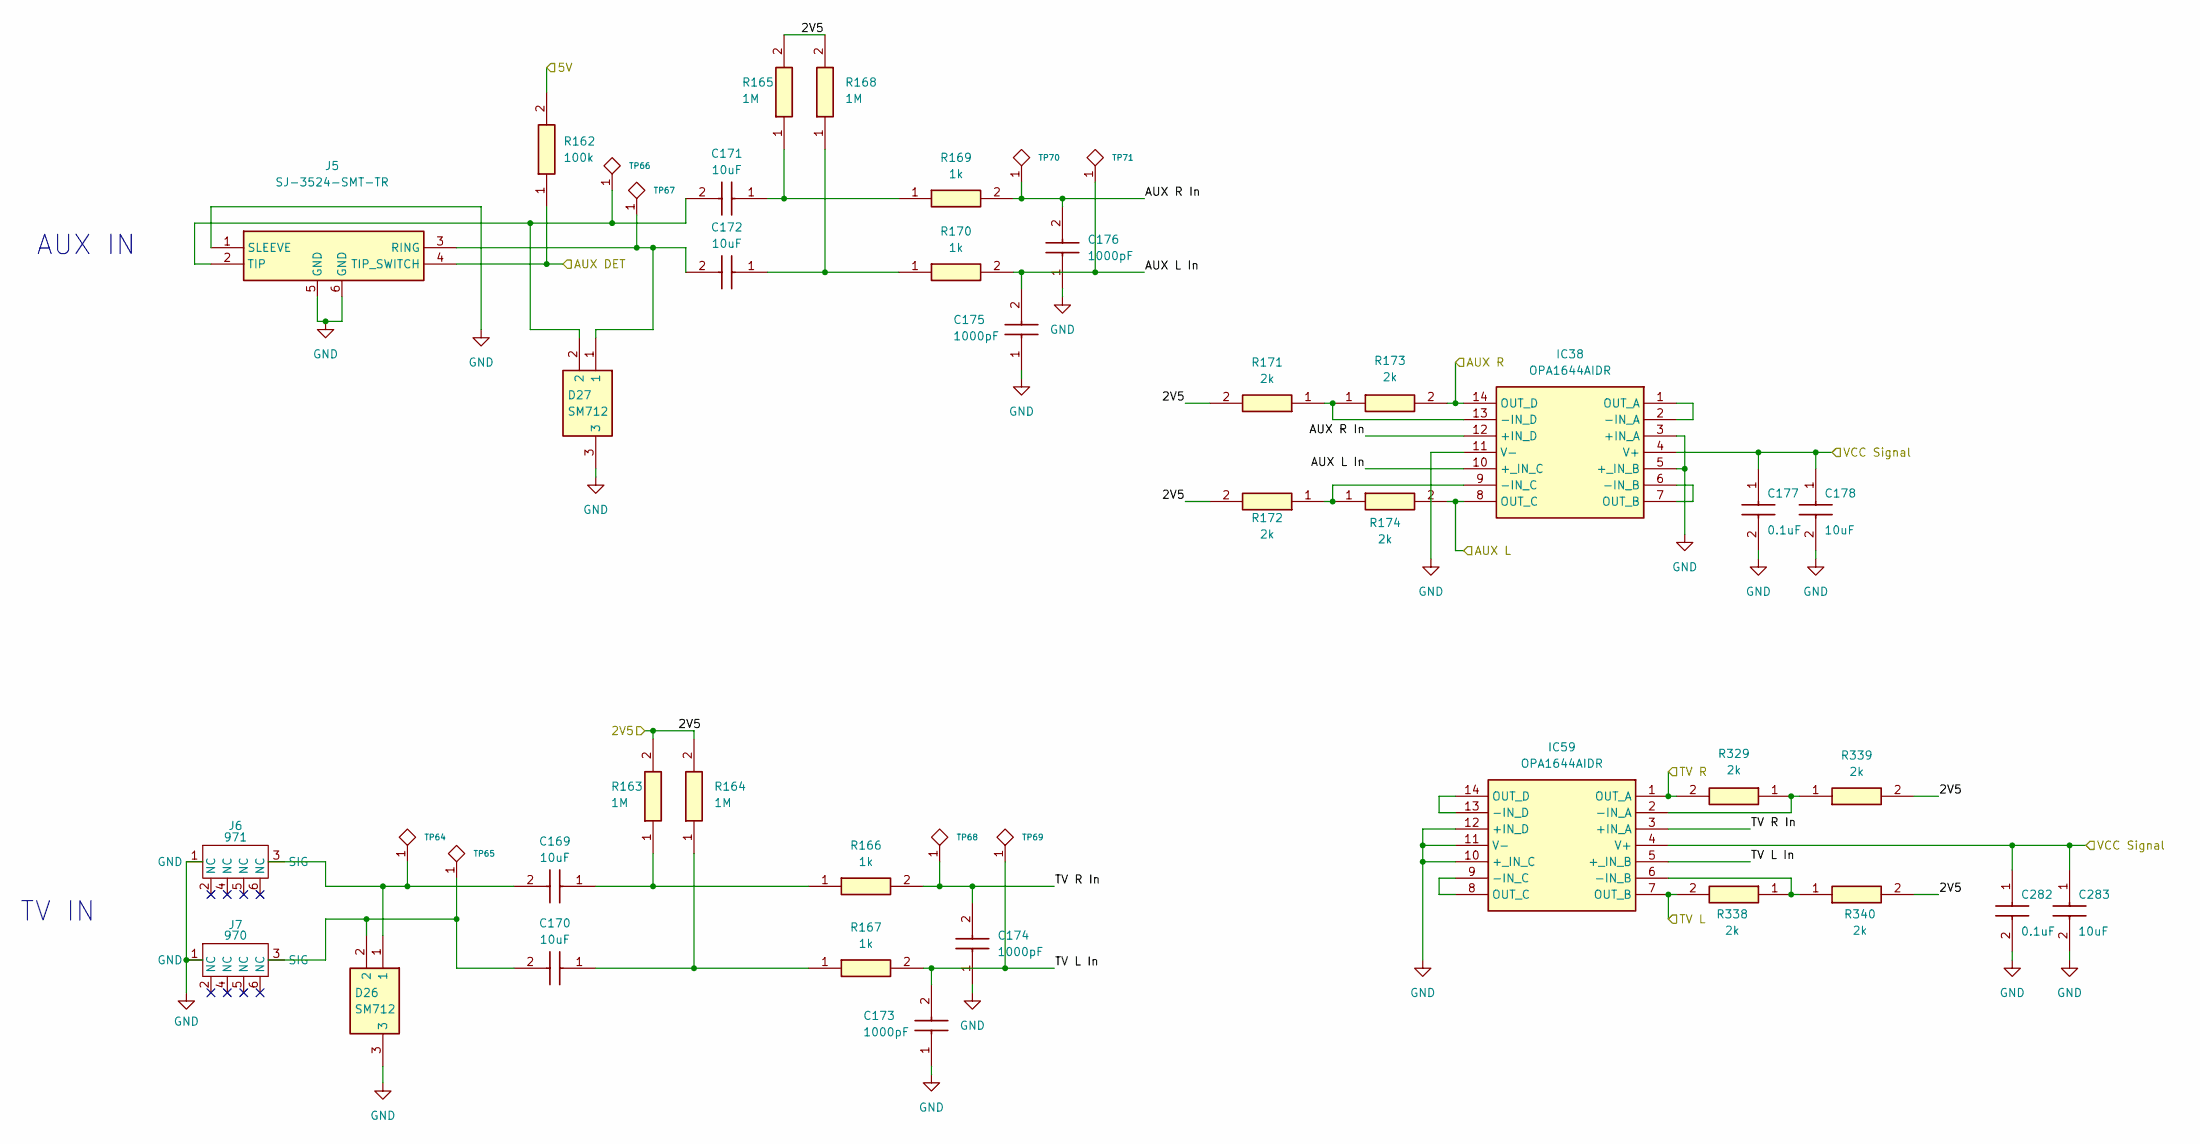
[picture p58: schematic AUXIN_sch.kicad_sch]

Parts:
C169, C170, C171, C172: 10uF; CAPC2012X145N; Manufacturer_Part_Number GRM21BR61C106KE15K; Mouser Part Number 81-GRM21BR61C106KE5K
C173, C174, C175, C176: 1000pF; CAPC1608X87N; Manufacturer_Part_Number C0603C102K3GACTU; Mouser Part Number 80-C0603C102K3G
C177, C282: 0.1uF; C0603; Manufacturer_Part_Number C0603C104M5RACTU; Mouser Part Number 80-C0603C104M5R
C178, C283: 10uF; GRM21x; Manufacturer_Part_Number GRM21BR61H106KE43L; Mouser Part Number 81-GRM21BR61H106KE3L
D26, D27: SM712; SOT95P237X120-3N; Manufacturer_Part_Number SM712
IC38, IC59: OPA1644AIDR; SOIC127P600X175-14N; Manufacturer_Part_Number OPA1644AIDR; Mouser Part Number 595-OPA1644AIDR
J5: SJ-3524-SMT-TR; Manufacturer_Part_Number SJ-3524-SMT-TR; Mouser Part Number 490-SJ-3524-SMT-TR
J6: 971; Phono Jack
J7: 970; Phono Jack
R162: 100k; RESC2012X60N; Manufacturer_Part_Number RC0805FR-07100KL; Mouser Part Number 603-RC0805FR-07100KL
R163, R164, R165, R168: 1M; RESC1608X55N; Manufacturer_Part_Number RT0603FRD071ML; Mouser Part Number 603-RT0603FRD071ML
R166, R167, R169, R170: 1k; ERA3AEB101V; Manufacturer_Part_Number ERA-3AEB102V; Mouser Part Number 667-ERA-3AEB102V
R171, R172, R173, R174, R329, R338, R339, R340: 2k; ERA3AEB101V; Manufacturer_Part_Number ERA-3AEB202V; Mouser Part Number 667-ERA-3AEB202V
TP64, TP65, TP66, TP67, TP68, TP69, TP70, TP71: TP

Connections:
2V5: R163.2, R164.2, R165.2, R168.2, R171.2, R172.2, R339.2, R340.2
5V: R162.2
AUX DET: J5.4 (TIP_SWITCH), R162.1
AUX L: IC38.8 (OUT_C), R174.2
AUX L In: C175.2, IC38.10 (+_IN_C), R170.2, TP71.1
AUX R: IC38.14 (OUT_D), R173.2
AUX R In: C176.2, IC38.12 (+IN_D), R169.2, TP70.1
GND: C173.1, C174.1, C175.1, C176.1, C177.2, C178.2, C282.2, C283.2, D26.3, D27.3, IC38.3 (+IN_A), IC38.5 (+_IN_B), IC38.11 (V-), IC59.10 (+_IN_C), IC59.11 (V-), IC59.12 (+IN_D), J5.1 (SLEEVE), J5.5 (GND), J5.6 (GND), J6.1 (GND), J7.1 (GND)
unnamed: C169.1, R163.1, R166.1
unnamed: C169.2, D26.1, J6.3 (SIG), TP64.1
unnamed: C170.1, R164.1, R167.1
unnamed: C170.2, D26.2, J7.3 (SIG), TP65.1
unnamed: C171.1, R165.1, R169.1
unnamed: C171.2, D27.2, J5.2 (TIP), TP66.1
unnamed: C172.1, R168.1, R170.1
unnamed: C172.2, D27.1, J5.3 (RING), TP67.1
unnamed: IC38.1 (OUT_A), IC38.2 (-IN_A)
unnamed: IC38.6 (-IN_B), IC38.7 (OUT_B)
unnamed: IC38.9 (-IN_C), R172.1, R174.1
unnamed: IC38.13 (-IN_D), R171.1, R173.1
unnamed: IC59.2 (-IN_A), R329.1, R339.1
unnamed: IC59.6 (-IN_B), R338.1, R340.1
unnamed: IC59.8 (OUT_C), IC59.9 (-IN_C)
unnamed: IC59.13 (-IN_D), IC59.14 (OUT_D)
TV L: IC59.7 (OUT_B), R338.2
TV L In: C173.2, IC59.5 (+_IN_B), R167.2, TP69.1
TV R: IC59.1 (OUT_A), R329.2
TV R In: C174.2, IC59.3 (+IN_A), R166.2, TP68.1
VCC Signal: C177.1, C178.1, C282.1, C283.1, IC38.4 (V+), IC59.4 (V+)

Notes on the sheet:
AUX IN
TV IN
