Alex-Wolfe/Home-Audio-System/Hardware/Design/Main Board/Native Kicad/Audio Switching.kicad_sch

## KiCad design Hardware/Design/Main Board/Native Kicad/Audio Switching.kicad_sch (2025-06-05)

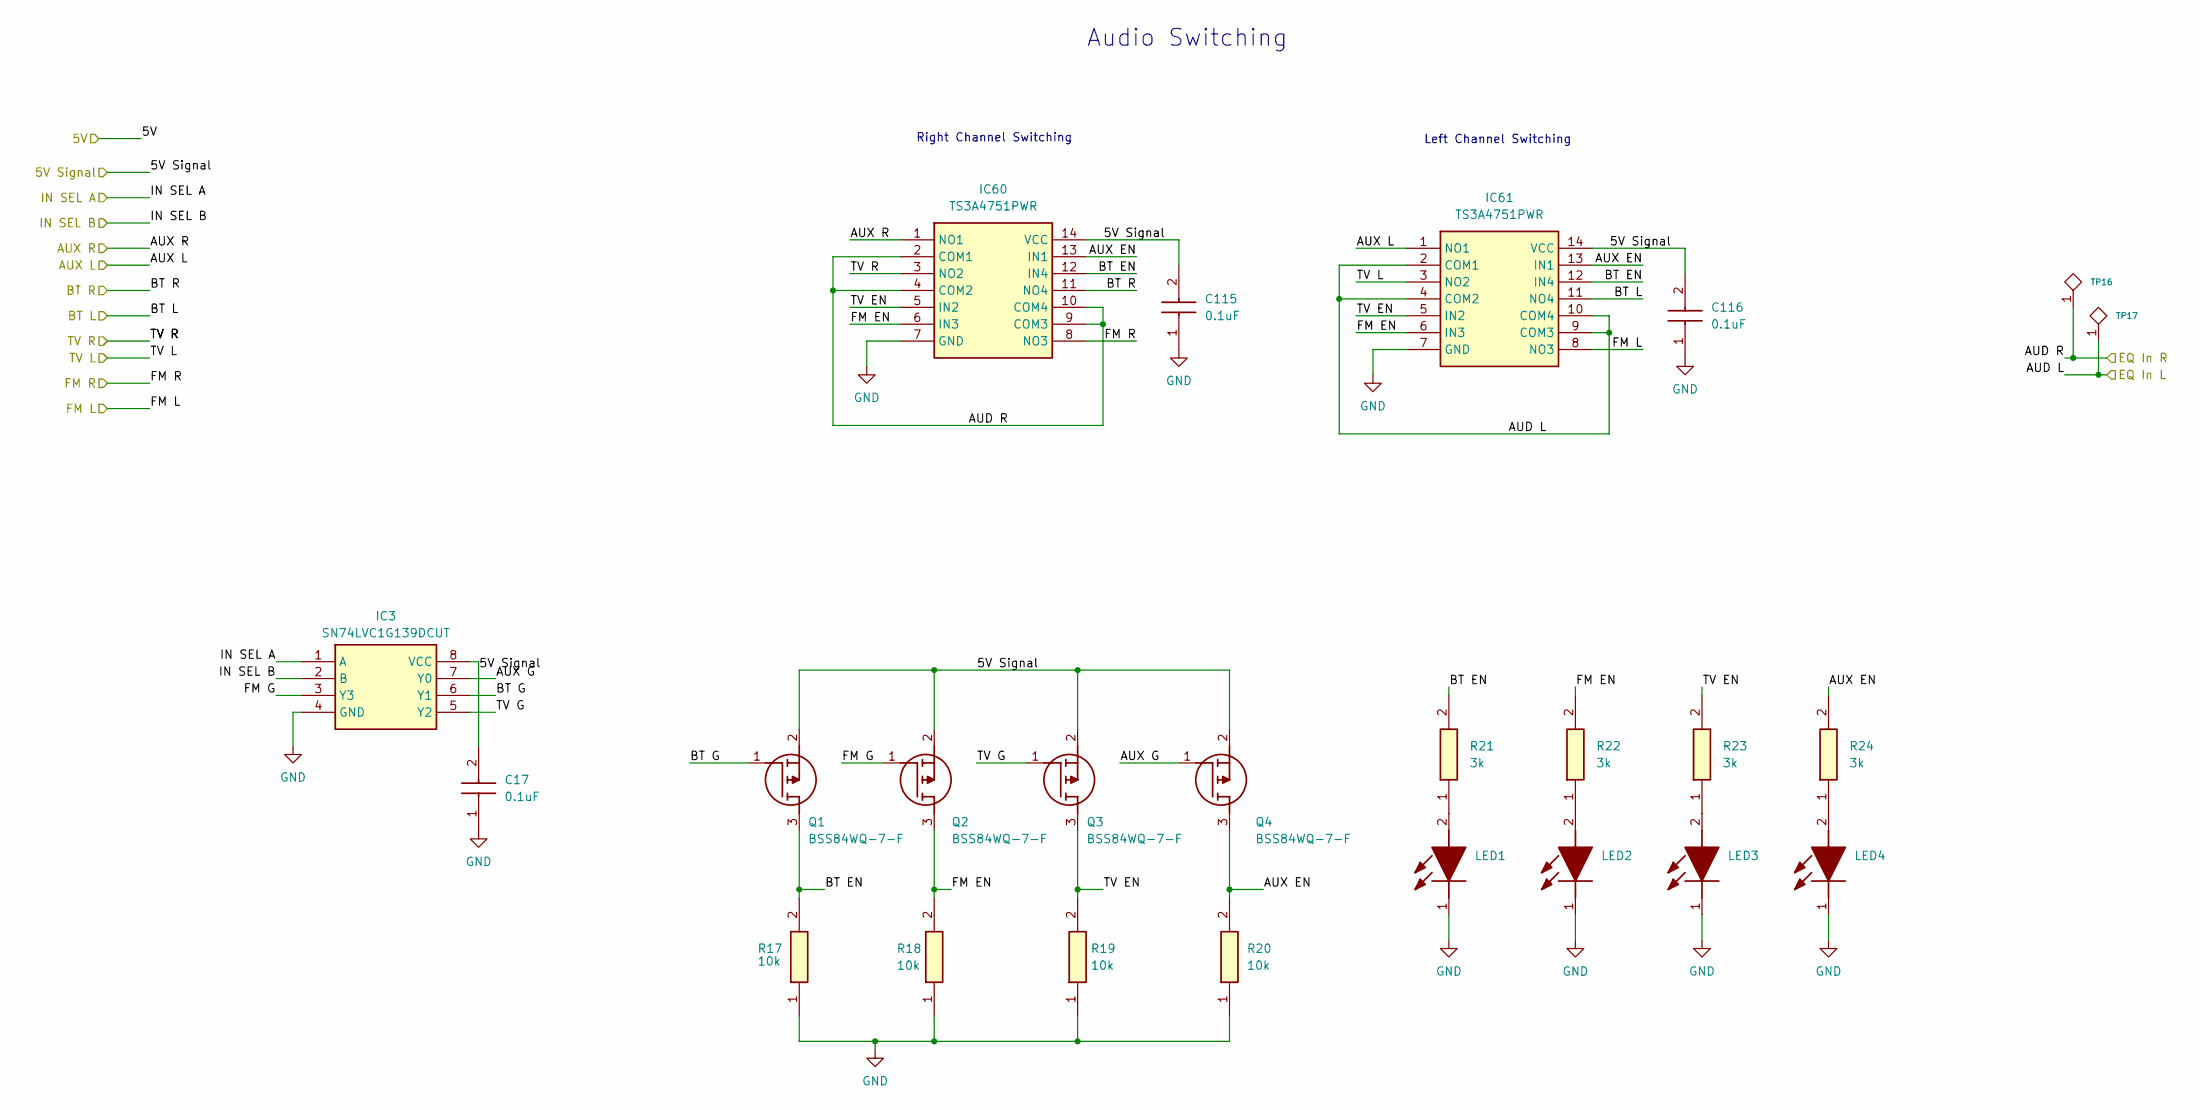
[picture p59: schematic Audio Switching.kicad_sch]

Parts:
C17, C115, C116: 0.1uF; CAPC1608X90N; Manufacturer_Part_Number CC0603KRX7R7BB104; Mouser Part Number 603-CC603KRX7R7BB104
IC3: SN74LVC1G139DCUT; SOP50P310X90-8N; Manufacturer_Part_Number SN74LVC1G139DCUT; Mouser Part Number 595-SN74LVC1G139DCUT
IC60, IC61: TS3A4751PWR; SOP65P640X120-14N; Manufacturer_Part_Number TS3A4751PWR; Mouser Part Number 595-TS3A4751PWR
LED1, LED2, LED3, LED4: 150060SS75000; LEDC1608X80N; Manufacturer_Part_Number 150060SS75000; Mouser Part Number 710-150060SS75000
Q1, Q2, Q3, Q4: BSS84WQ-7-F; SOT65P210X110-3N; Manufacturer_Part_Number BSS84WQ-7-F; Mouser Part Number 621-BSS84WQ-7-F
R17, R18, R19, R20: 10k; RESC1608X55N; Manufacturer_Part_Number RC0603FR-0710KL; Mouser Part Number 603-RC0603FR-0710KL
R21, R22, R23, R24: 3k; RESC1608X55N; Manufacturer_Part_Number RC0603FR-073KL; Mouser Part Number 603-RC0603FR-073KL
TP16, TP17: TP

Connections:
5V Signal: C17.2, C115.2, C116.2, IC3.8 (VCC), IC60.14 (VCC), IC61.14 (VCC), Q1.2 (S), Q2.2 (S), Q3.2 (S), Q4.2 (S)
AUD L: IC61.2 (COM1), IC61.4 (COM2), IC61.9 (COM3), IC61.10 (COM4), TP17.1
AUD R: IC60.2 (COM1), IC60.4 (COM2), IC60.9 (COM3), IC60.10 (COM4), TP16.1
AUX EN: IC60.13 (IN1), IC61.13 (IN1), Q4.3 (D), R20.2, R24.2
AUX G: IC3.7 (Y0), Q4.1 (G)
AUX L: IC61.1 (NO1)
AUX R: IC60.1 (NO1)
BT EN: IC60.12 (IN4), IC61.12 (IN4), Q1.3 (D), R17.2, R21.2
BT G: IC3.6 (Y1), Q1.1 (G)
BT L: IC61.11 (NO4)
BT R: IC60.11 (NO4)
FM EN: IC60.6 (IN3), IC61.6 (IN3), Q2.3 (D), R18.2, R22.2
FM G: IC3.3 (Y3), Q2.1 (G)
FM L: IC61.8 (NO3)
FM R: IC60.8 (NO3)
GND: C17.1, C115.1, C116.1, IC3.4 (GND), IC60.7 (GND), IC61.7 (GND), LED1.1 (K), LED2.1 (K), LED3.1 (K), LED4.1 (K), R17.1, R18.1, R19.1, R20.1
IN SEL A: IC3.1 (A)
IN SEL B: IC3.2 (B)
unnamed: LED1.2 (A), R21.1
unnamed: LED2.2 (A), R22.1
unnamed: LED3.2 (A), R23.1
unnamed: LED4.2 (A), R24.1
TV EN: IC60.5 (IN2), IC61.5 (IN2), Q3.3 (D), R19.2, R23.2
TV G: IC3.5 (Y2), Q3.1 (G)
TV L: IC61.3 (NO2)
TV R: IC60.3 (NO2)

Notes on the sheet:
Right Channel Switching
Left Channel Switching
Audio Switching
