Alex-Wolfe/Home-Audio-System/Hardware/Design/Main Board/Native Kicad/BT Radio.kicad_sch

## KiCad design Hardware/Design/Main Board/Native Kicad/BT Radio.kicad_sch (2025-06-05)

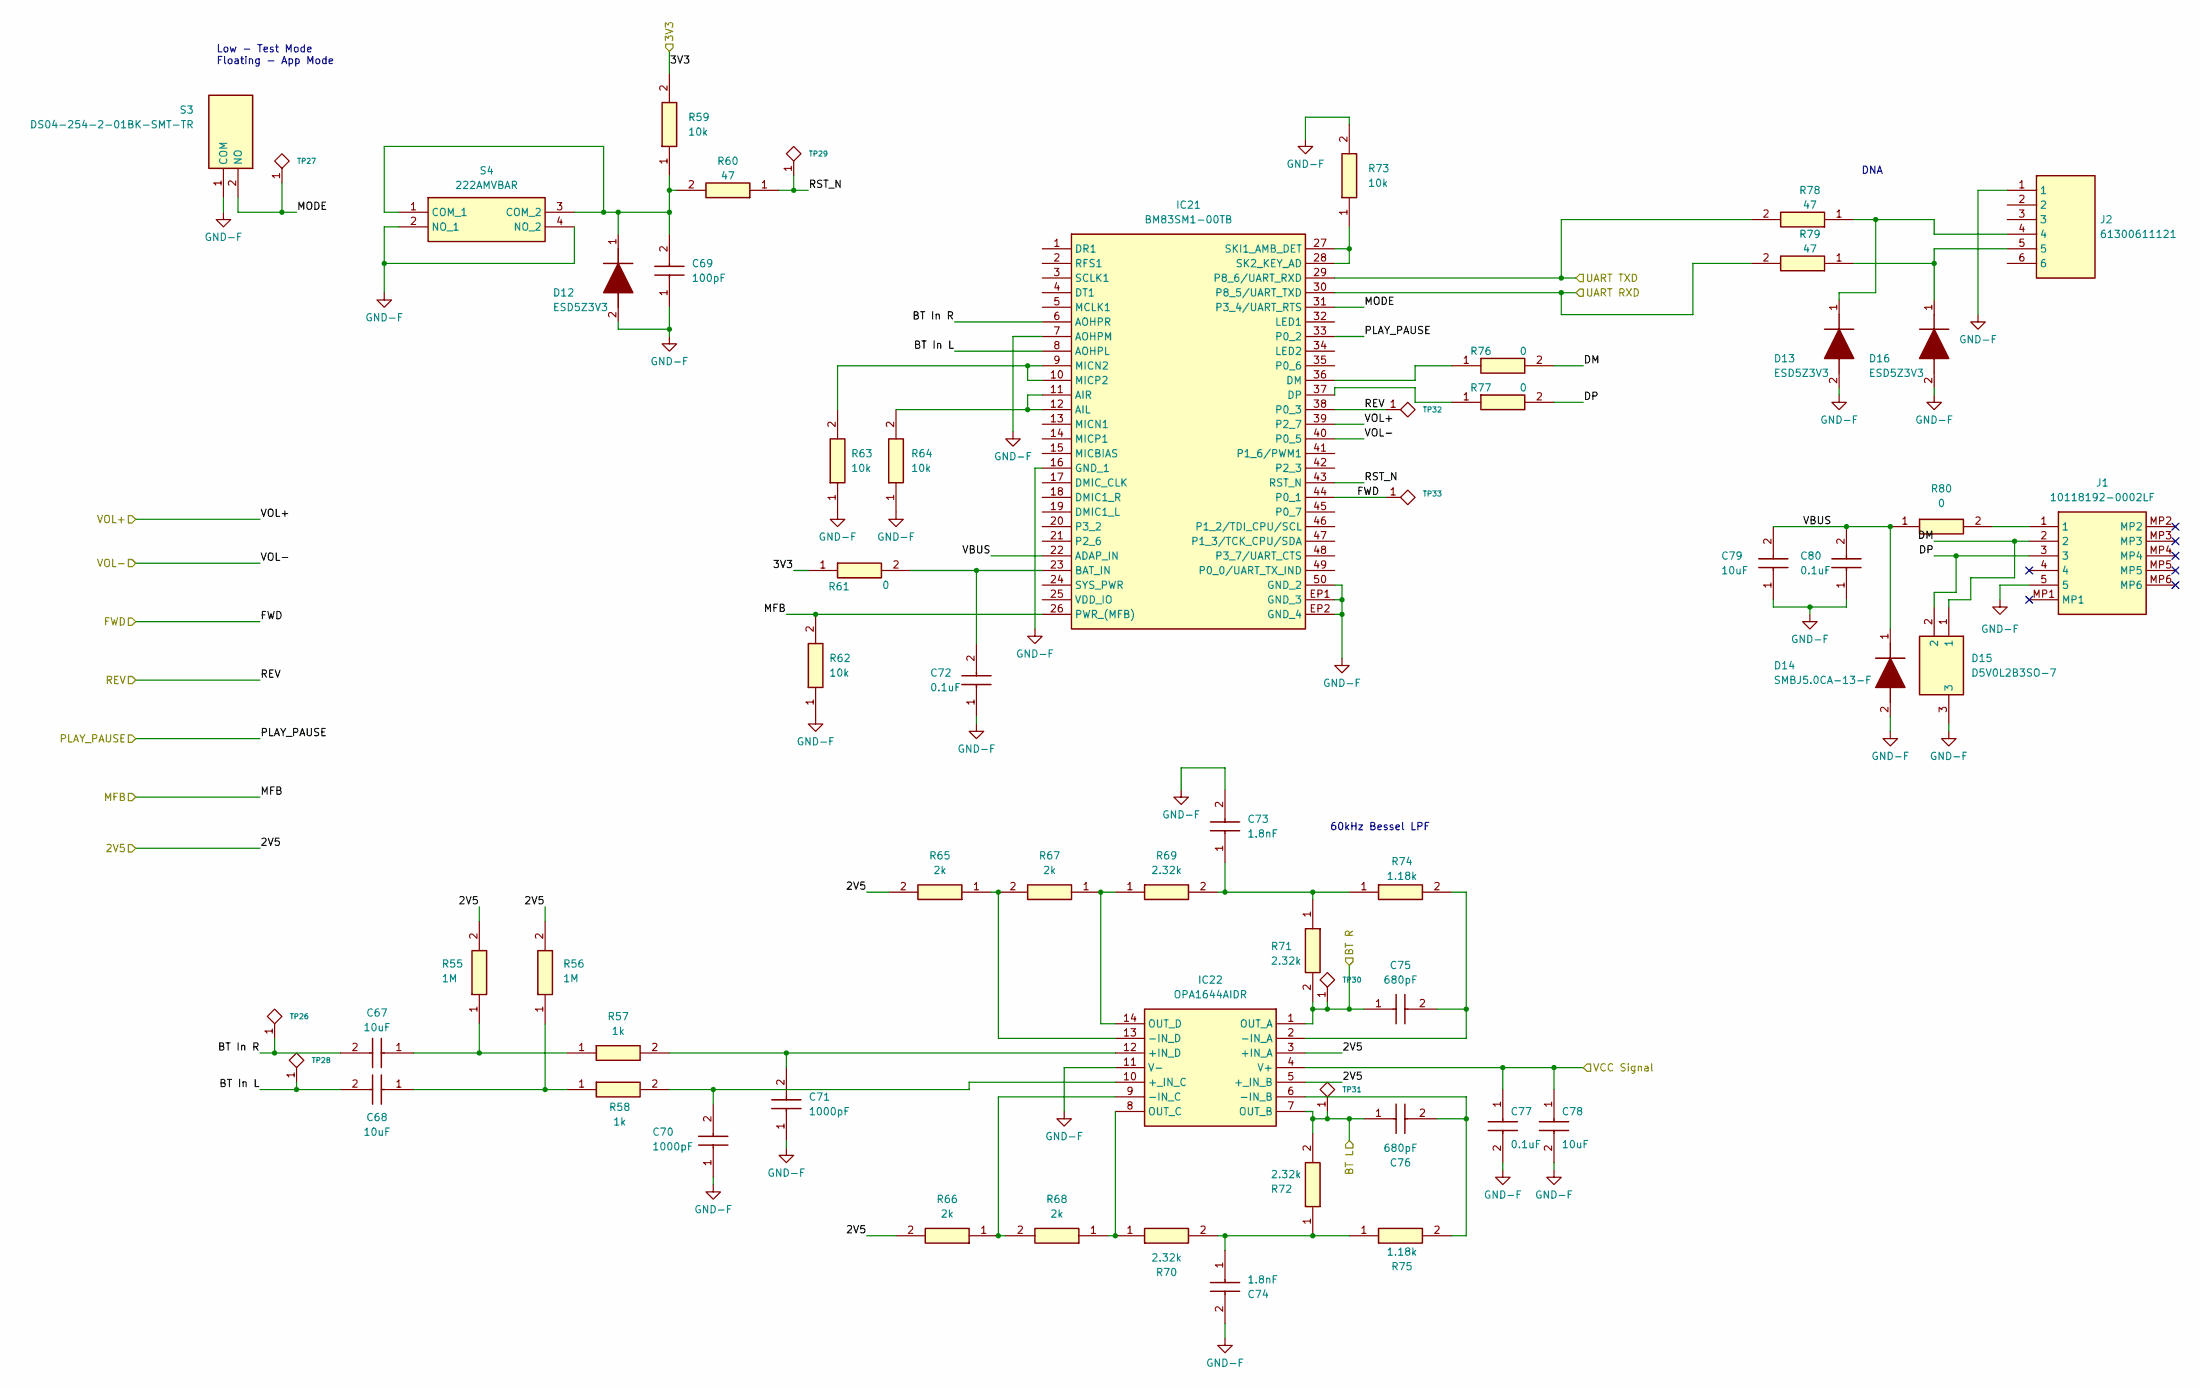
[picture p60: schematic BT Radio.kicad_sch]

Parts:
C67, C68, C79: 10uF; CAPC2012X145N; Manufacturer_Part_Number GRM21BR61C106KE15K; Mouser Part Number 81-GRM21BR61C106KE5K
C69: 100pF; CAPC1608X87N; Manufacturer_Part_Number CC0603JRNPO9BN101; Mouser Part Number 603-CC603JRNPO9BN101
C70, C71: 1000pF; CAPC1608X87N; Manufacturer_Part_Number C0603C102K3GACTU; Mouser Part Number 80-C0603C102K3G
C72, C80: 0.1uF; CAPC1608X90N; Manufacturer_Part_Number CC0603KRX7R7BB104; Mouser Part Number 603-CC603KRX7R7BB104
C73, C74: 1.8nF; CAPC1608X90N; Manufacturer_Part_Number GRM1885C1H182JA01J; Mouser Part Number 81-GRM1885C1H182JA1J
C75, C76: 680pF; CAPC1608X87N; Manufacturer_Part_Number 885012006062; Mouser Part Number 710-885012006062
C77: 0.1uF; C0603; Manufacturer_Part_Number C0603C104M5RACTU; Mouser Part Number 80-C0603C104M5R
C78: 10uF; GRM21x; Manufacturer_Part_Number GRM21BR61H106KE43L; Mouser Part Number 81-GRM21BR61H106KE3L
D12, D13, D16: ESD5Z3V3; SODFL1608X70N; Manufacturer_Part_Number ESD5Z3V3; Mouser Part Number 637-ESD5Z3V3
D14: SMBJ5.0CA-13-F; DIOM5336X262N; Manufacturer_Part_Number SMBJ5.0CA-13-F; Mouser Part Number 621-SMBJ5.0CA-13-F
D15: D5V0L2B3SO-7; SOT96P240X110-3N; Manufacturer_Part_Number D5V0L2B3SO-7; Mouser Part Number 621-D5V0L2B3SO-7
IC21: BM83SM1-00TB; BM83SM100TB; Manufacturer_Part_Number BM83SM1-00TB; Mouser Part Number 579-BM83SM1-00TB
IC22: OPA1644AIDR; SOIC127P600X175-14N; Manufacturer_Part_Number OPA1644AIDR; Mouser Part Number 595-OPA1644AIDR
J1: 10118192-0002LF; 101181920002LF; Manufacturer_Part_Number 10118192-0002LF
J2: 61300611121; HDRV6W64P0X254_1X6_1524X254X869P; Manufacturer_Part_Number 61300611121; Mouser Part Number 710-61300611121
R55, R56: 1M; RESC1608X55N; Manufacturer_Part_Number RT0603FRD071ML; Mouser Part Number 603-RT0603FRD071ML
R57, R58: 1k; ERA3AEB101V; Manufacturer_Part_Number ERA-3AEB102V; Mouser Part Number 667-ERA-3AEB102V
R59, R62, R63, R64, R73: 10k; RESC1608X55N; Manufacturer_Part_Number RC0603FR-0710KL; Mouser Part Number 603-RC0603FR-0710KL
R60, R78, R79: 47; RESC1608X55N; Manufacturer_Part_Number RC0603FR-0747RL; Mouser Part Number 603-RC0603FR-0747RL
R61, R76, R77, R80: 0; RESC1608X55N; Manufacturer_Part_Number RC0603JR-070RL; Mouser Part Number 603-RC0603JR-070RL
R65, R66, R67, R68: 2k; ERA3AEB101V; Manufacturer_Part_Number ERA-3AEB202V; Mouser Part Number 667-ERA-3AEB202V
R69, R70, R71, R72: 2.32k; ERA3AEB101V; Manufacturer_Part_Number ERA-3AEB2321V; Mouser Part Number 667-ERA-3AEB2321V
R74, R75: 1.18k; ERA3AEB101V; Manufacturer_Part_Number ERA-3AEB1181V; Mouser Part Number 667-ERA-3AEB1181V
S3: DS04-254-2-01BK-SMT-TR; DS04254201BKSMTTR; Manufacturer_Part_Number DS04-254-2-01BK-SMT-TR; Mouser Part Number 490-DS04254201BK-STR
S4: 222AMVBAR; Manufacturer_Part_Number 222AMVBAR; Mouser Part Number 774-222AMVBAR
TP26, TP27, TP28, TP29, TP30, TP31, TP32, TP33: TP

Connections:
2V5: IC22.3 (+IN_A), IC22.5 (+_IN_B), R55.2, R56.2, R65.2, R66.2
3V3: R59.2, R61.1
BT In L: C68.2, IC21.8 (AOHPL), TP28.1
BT In R: C67.2, IC21.6 (AOHPR), TP26.1
BT L: C76.1, IC22.7 (OUT_B), R72.2, TP31.1
BT R: C75.1, IC22.1 (OUT_A), R71.2, TP30.1
DM: D15.1, J1.2, R76.2
DP: D15.2, J1.3, R77.2
FWD: IC21.44 (P0_1), TP33.1
GND-F: C69.1, C70.1, C71.1, C72.1, C73.2, C74.2, C77.2, C78.2, C79.1, C80.1, D12.2 (A), D13.2 (A), D14.2 (A), D15.3, D16.2 (A), IC21.7 (AOHPM), IC21.16 (GND_1), IC21.50 (GND_2), IC21.EP1 (GND_3), IC21.EP2 (GND_4), IC22.11 (V-), J1.5, J2.1, R62.1, R63.1, R64.1, R73.2, S3.1 (COM), S4.2 (NO_1), S4.4 (NO_2)
MFB: IC21.26 (PWR_(MFB)), R62.2
MODE: IC21.31 (P3_4/UART_RTS), S3.2 (NO), TP27.1
unnamed: C67.1, R55.1, R57.1
unnamed: C68.1, R56.1, R58.1
unnamed: C69.2, D12.1 (K), R59.1, R60.2, S4.1 (COM_1), S4.3 (COM_2)
unnamed: C70.2, IC22.10 (+_IN_C), R58.2
unnamed: C71.2, IC22.12 (+IN_D), R57.2
unnamed: C72.2, IC21.23 (BAT_IN), R61.2
unnamed: C73.1, R69.2, R71.1, R74.1
unnamed: C74.1, R70.2, R72.1, R75.1
unnamed: C75.2, IC22.2 (-IN_A), R74.2
unnamed: C76.2, IC22.6 (-IN_B), R75.2
unnamed: D13.1 (K), J2.4, R78.1
unnamed: D16.1 (K), J2.5, R79.1
unnamed: IC21.9 (MICN2), IC21.10 (MICP2), R63.2
unnamed: IC21.11 (AIR), IC21.12 (AIL), R64.2
unnamed: IC21.27 (SKI1_AMB_DET), IC21.28 (SK2_KEY_AD), R73.1
unnamed: IC21.36 (DM), R76.1
unnamed: IC21.37 (DP), R77.1
unnamed: IC22.8 (OUT_C), R68.1, R70.1
unnamed: IC22.9 (-IN_C), R66.1, R68.2
unnamed: IC22.13 (-IN_D), R65.1, R67.2
unnamed: IC22.14 (OUT_D), R67.1, R69.1
unnamed: J1.1, R80.2
PLAY_PAUSE: IC21.33 (P0_2)
REV: IC21.38 (P0_3), TP32.1
RST_N: IC21.43 (RST_N), R60.1, TP29.1
UART RXD: IC21.30 (P8_5/UART_TXD), R79.2
UART TXD: IC21.29 (P8_6/UART_RXD), R78.2
VBUS: C79.2, C80.2, D14.1 (K), IC21.22 (ADAP_IN), R80.1
VCC Signal: C77.1, C78.1, IC22.4 (V+)
VOL+: IC21.39 (P2_7)
VOL-: IC21.40 (P0_5)

Notes on the sheet:
Low - Test Mode Floating - App Mode
60kHz Bessel LPF
DNA
