Alex-Wolfe/Home-Audio-System/Hardware/Design/Main Board/Native Kicad/Bandpass Filters.kicad_sch

## KiCad design Hardware/Design/Main Board/Native Kicad/Bandpass Filters.kicad_sch (2025-06-05)

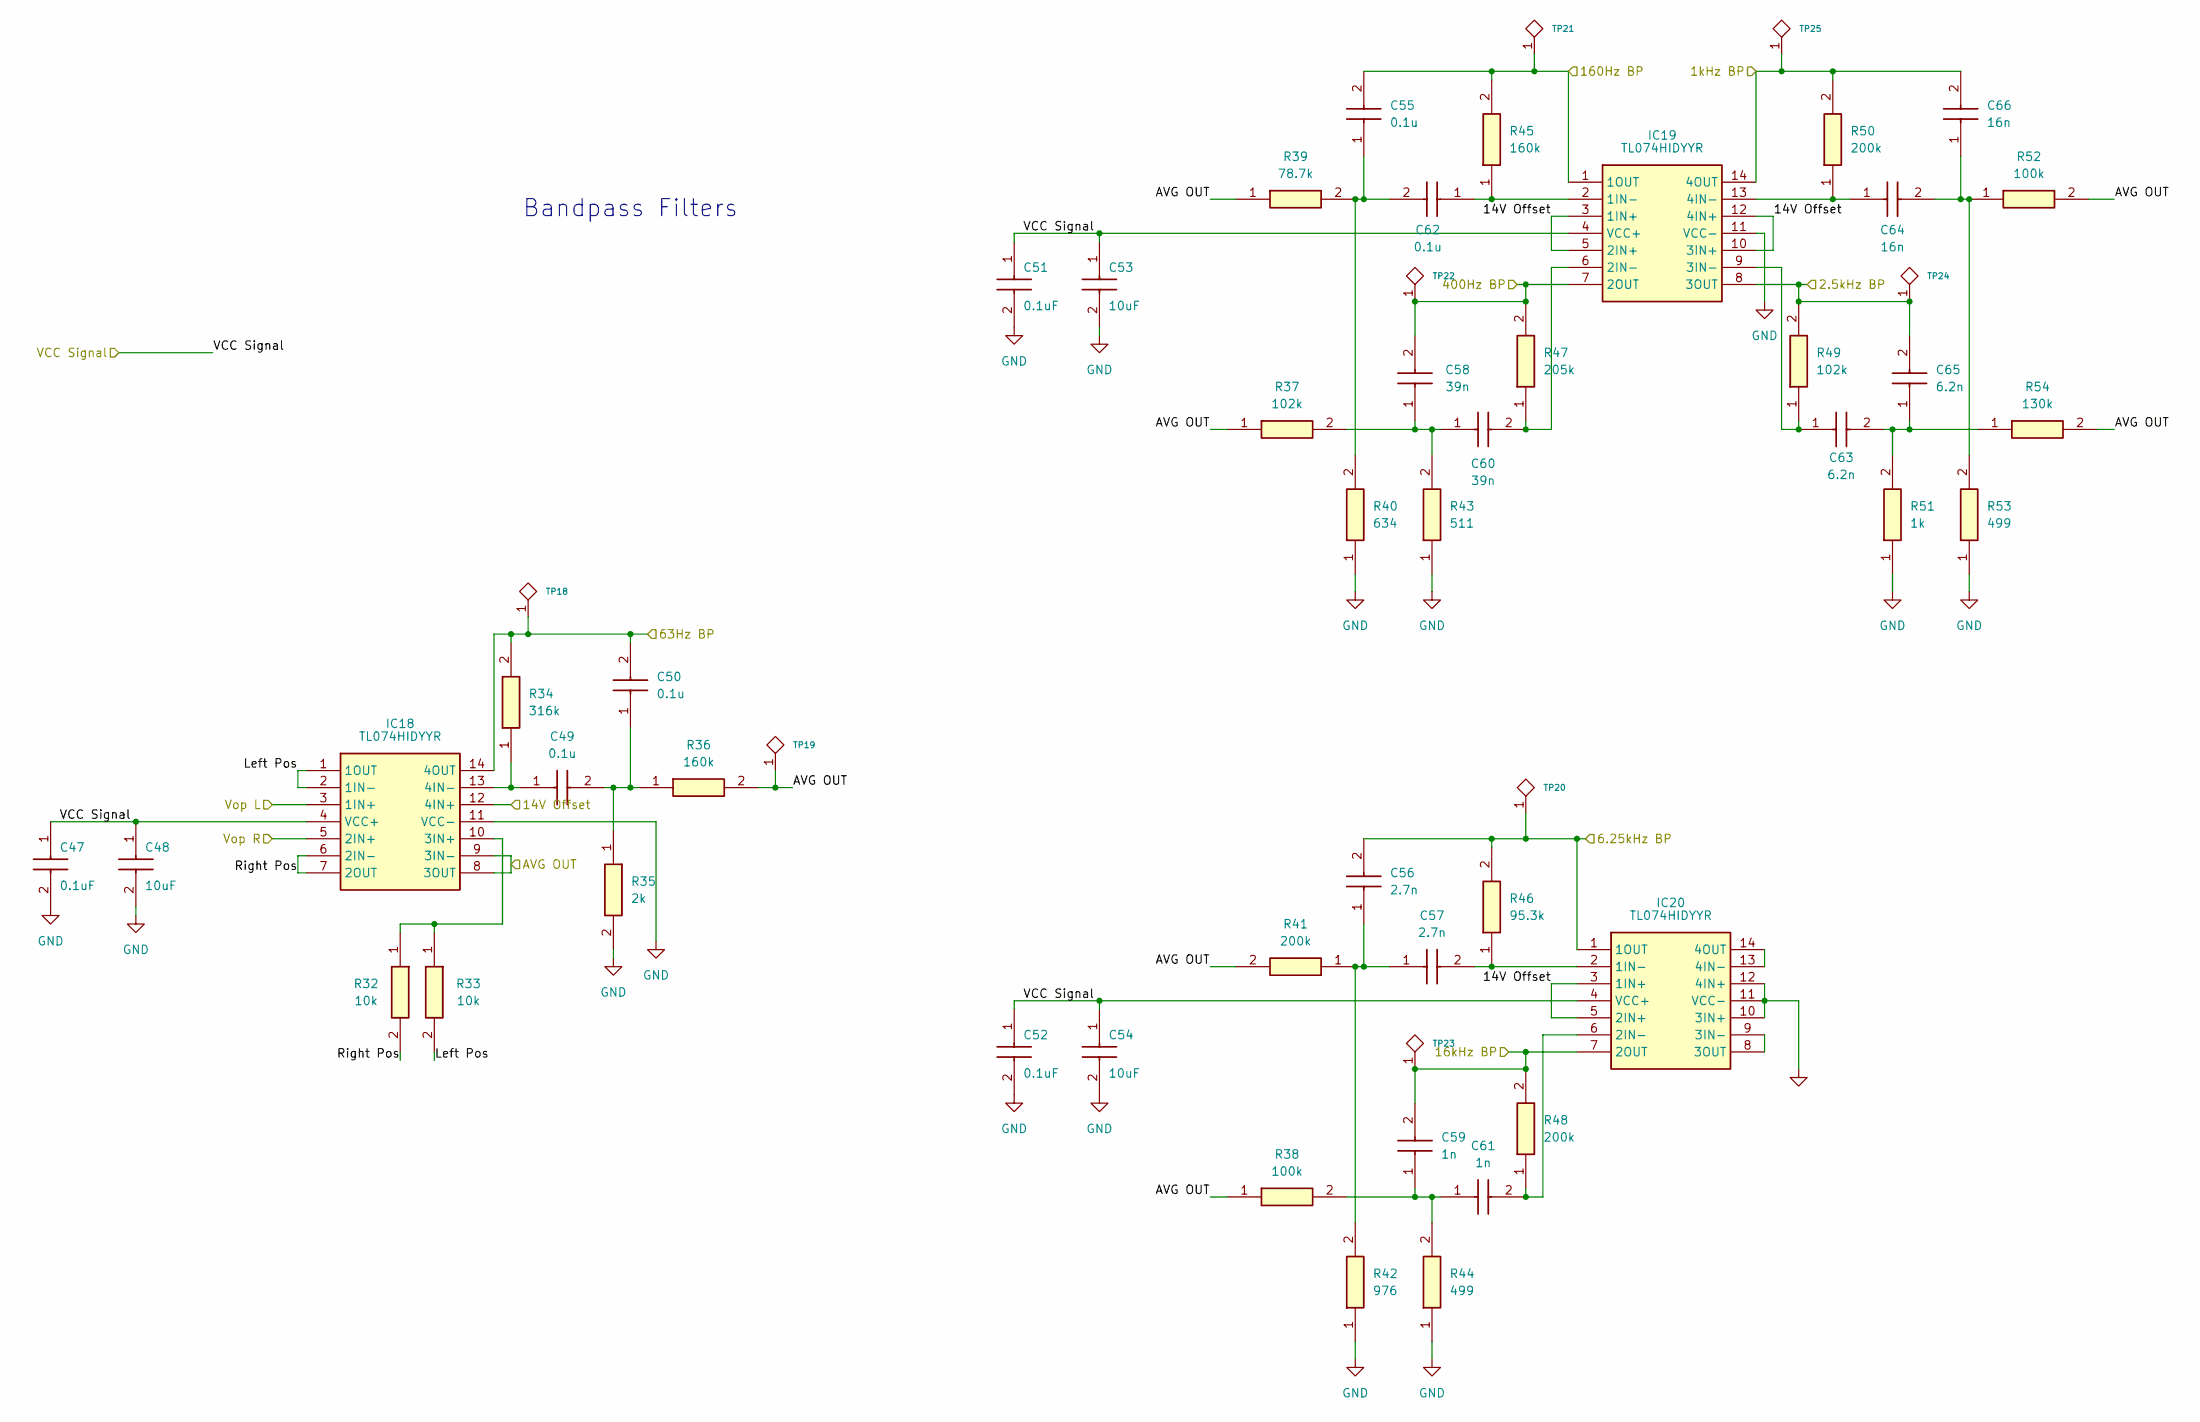
[picture p61: schematic Bandpass Filters.kicad_sch]

Parts:
C47, C51, C52: 0.1uF; C0603; Manufacturer_Part_Number C0603C104M5RACTU; Mouser Part Number 80-C0603C104M5R
C48, C53, C54: 10uF; GRM21x; Manufacturer_Part_Number GRM21BR61H106KE43L; Mouser Part Number 81-GRM21BR61H106KE3L
C49, C50, C55, C62: 0.1u; CAPC3216X180N; Manufacturer_Part_Number GRM31C5C1H104JA01L; Mouser Part Number 81-GRM31C5C1H104JA1L
C56, C57: 2.7n; CAPC1608X90N; Manufacturer_Part_Number GRM1885C1H272JA01D; Mouser Part Number 81-GRM185C1H272JA01D
C58, C60: 39n; GRM31x; Manufacturer_Part_Number GRM31M5C1H393JA01L; Mouser Part Number 81-GRM31M5C1H393JA1L
C59, C61: 1n; CAPC1608X90N; Manufacturer_Part_Number GRM1885C1H102JA01D; Mouser Part Number 81-GRM39C102J50
C63, C65: 6.2n; GRM18x; Manufacturer_Part_Number GRM1885C1H622JA01D; Mouser Part Number 81-GRM1885C1H622JA1D
C64, C66: 16n; GRM31x; Manufacturer_Part_Number GRM3195C1H163JA01D; Mouser Part Number 81-GRM3195C1H163JA1D
IC18, IC19, IC20: TL074HIDYYR; SOP50P326X110-14N; Manufacturer_Part_Number TL074HIDYYR; Mouser Part Number 595-TL074HIDYYR
R32, R33: 10k; ERA3AEB101V; Manufacturer_Part_Number ERA-3AEB103V; Mouser Part Number 667-ERA-3AEB103V
R34: 316k; RESC1608X55N; Manufacturer_Part_Number RC0603FR-07316KL; Mouser Part Number 603-RC0603FR-07316KL
R35: 2k; RESC1608X55N; Manufacturer_Part_Number RC0603FR-072KL; Mouser Part Number 603-RC0603FR-072KL
R36, R45: 160k; RESC1608X55N; Manufacturer_Part_Number RC0603FR-07160KL; Mouser Part Number 603-RC0603FR-07160KL
R37, R49: 102k; RESC1608X55N; Manufacturer_Part_Number RC0603FR-07102KL; Mouser Part Number 603-RC0603FR-07102KL
R38, R52: 100k; RESC1608X55N; Manufacturer_Part_Number RC0603FR-07100KL; Mouser Part Number 603-RC0603FR-07100KL
R39: 78.7k; RESC1608X55N; Manufacturer_Part_Number RC0603FR-0778K7L; Mouser Part Number 603-RC0603FR-0778K7L
R40: 634; RESC1608X55N; Manufacturer_Part_Number RC0603FR-07634RL; Mouser Part Number 603-RC0603FR-07634RL
R41, R48, R50: 200k; RESC1608X55N; Manufacturer_Part_Number RC0603FR-07200KL; Mouser Part Number 603-RC0603FR-07200KL
R42: 976; RESC1608X55N; Manufacturer_Part_Number RC0603FR-07976RL; Mouser Part Number 603-RC0603FR-07976RL
R43: 511; RESC1608X55N; Manufacturer_Part_Number RC0603FR-07511RL; Mouser Part Number 603-RC0603FR-07511RL
R44, R53: 499; RESC1608X55N; Manufacturer_Part_Number RC0603FR-07499RL; Mouser Part Number 603-RC0603FR-07499RL
R46: 95.3k; RESC1608X55N; Manufacturer_Part_Number RC0603FR-0795K3L; Mouser Part Number 603-RC0603FR-0795K3L
R47: 205k; RESC1608X55N; Manufacturer_Part_Number RC0603FR-07205KL; Mouser Part Number 603-RC0603FR-07205KL
R51: 1k; RESC1608X55N; Manufacturer_Part_Number RC0603FR-071KL; Mouser Part Number 603-RC0603FR-071KL
R54: 130k; RESC1608X55N; Manufacturer_Part_Number RC0603FR-07130KL; Mouser Part Number 603-RC0603FR-07130KL
TP18, TP19, TP20, TP21, TP22, TP23, TP24, TP25: TP

Connections:
1kHz BP: C66.2, IC19.14 (4OUT), R50.2, TP25.1
2.5kHz BP: C65.2, IC19.8 (3OUT), R49.2, TP24.1
6.25kHz BP: C56.2, IC20.1 (1OUT), R46.2, TP20.1
14V Offset: IC18.12 (4IN+), IC19.3 (1IN+), IC19.5 (2IN+), IC19.10 (3IN+), IC19.12 (4IN+), IC20.3 (1IN+), IC20.5 (2IN+)
16kHz BP: C59.2, IC20.7 (2OUT), R48.2, TP23.1
63Hz BP: C50.2, IC18.14 (4OUT), R34.2, TP18.1
160Hz BP: C55.2, IC19.1 (1OUT), R45.2, TP21.1
400Hz BP: C58.2, IC19.7 (2OUT), R47.2, TP22.1
AVG OUT: IC18.8 (3OUT), IC18.9 (3IN-), R36.2, R37.1, R38.1, R39.1, R41.2, R52.2, R54.2, TP19.1
GND: C47.2, C48.2, C51.2, C52.2, C53.2, C54.2, IC18.11 (VCC-), IC19.11 (VCC-), IC20.10 (3IN+), IC20.11 (VCC-), IC20.12 (4IN+), R35.2, R40.1, R42.1, R43.1, R44.1, R51.1, R53.1
Left Pos: IC18.1 (1OUT), IC18.2 (1IN-), R33.2
unnamed: C49.1, IC18.13 (4IN-), R34.1
unnamed: C49.2, C50.1, R35.1, R36.1
unnamed: C55.1, C62.2, R39.2, R40.2
unnamed: C56.1, C57.1, R41.1, R42.2
unnamed: C57.2, IC20.2 (1IN-), R46.1
unnamed: C58.1, C60.1, R37.2, R43.2
unnamed: C59.1, C61.1, R38.2, R44.2
unnamed: C60.2, IC19.6 (2IN-), R47.1
unnamed: C61.2, IC20.6 (2IN-), R48.1
unnamed: C62.1, IC19.2 (1IN-), R45.1
unnamed: C63.1, IC19.9 (3IN-), R49.1
unnamed: C63.2, C65.1, R51.2, R54.1
unnamed: C64.1, IC19.13 (4IN-), R50.1
unnamed: C64.2, C66.1, R52.1, R53.2
unnamed: IC18.10 (3IN+), R32.1, R33.1
unnamed: IC20.8 (3OUT), IC20.9 (3IN-)
unnamed: IC20.13 (4IN-), IC20.14 (4OUT)
Right Pos: IC18.6 (2IN-), IC18.7 (2OUT), R32.2
VCC Signal: C47.1, C48.1, C51.1, C52.1, C53.1, C54.1, IC18.4 (VCC+), IC19.4 (VCC+), IC20.4 (VCC+)
Vop L: IC18.3 (1IN+)
Vop R: IC18.5 (2IN+)

Notes on the sheet:
Bandpass Filters
