Alex-Wolfe/Home-Audio-System/Hardware/Design/Main Board/Native Kicad/Clip Detect.kicad_sch

## KiCad design Hardware/Design/Main Board/Native Kicad/Clip Detect.kicad_sch (2025-06-05)

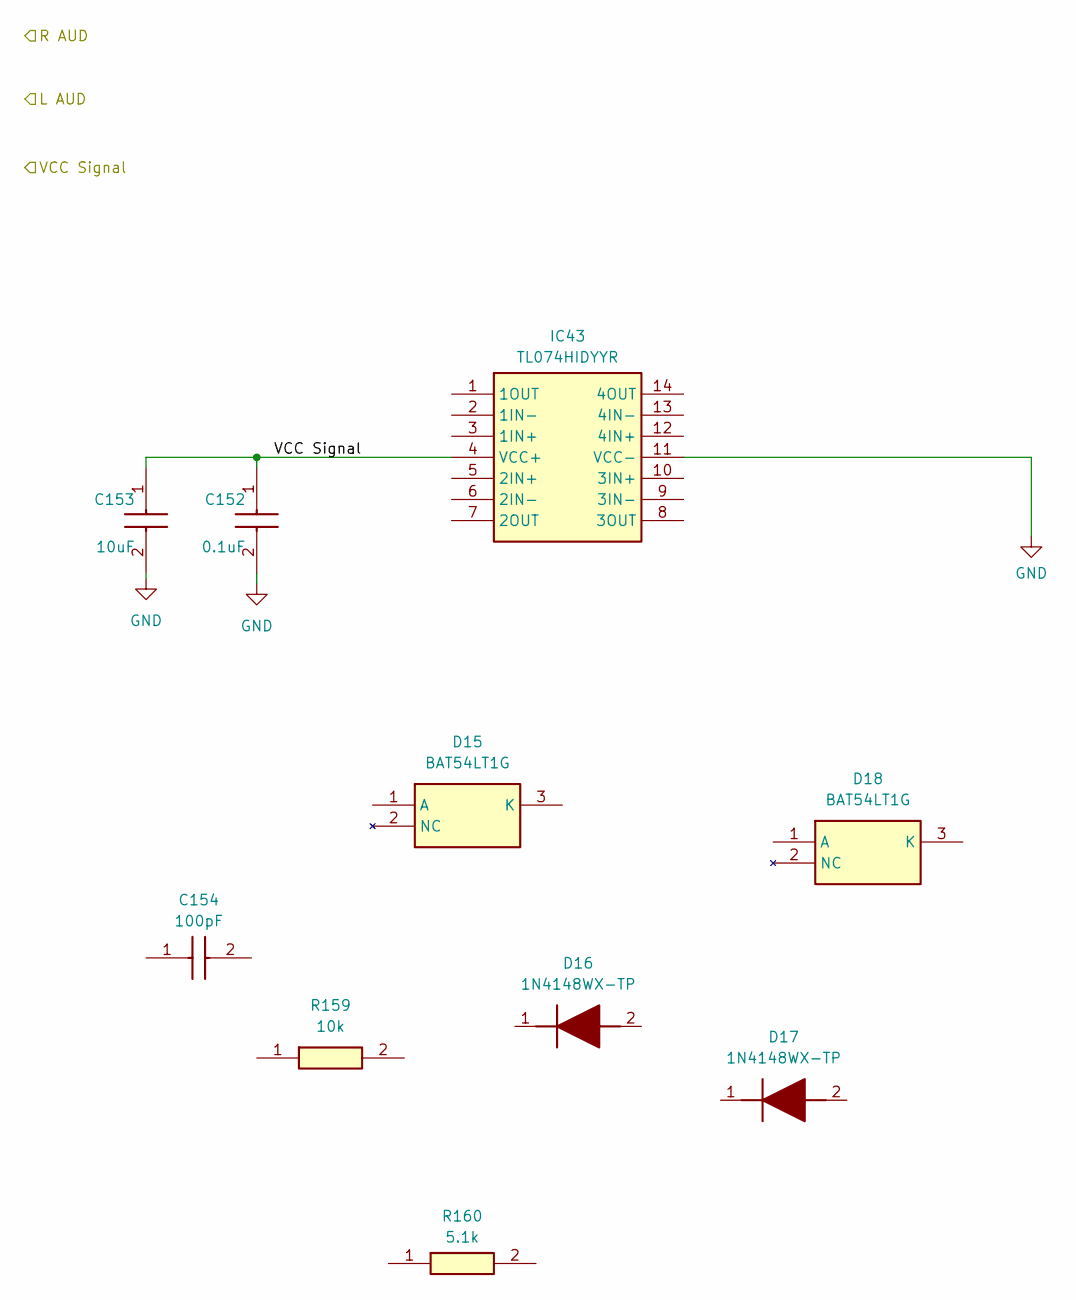
[picture p62: schematic Clip Detect.kicad_sch]

Parts:
C152: 0.1uF; C0603; Manufacturer_Part_Number C0603C104M5RACTU; Mouser Part Number 80-C0603C104M5R
C153: 10uF; GRM21x; Manufacturer_Part_Number GRM21BR61H106KE43L; Mouser Part Number 81-GRM21BR61H106KE3L
C154: 100pF; CAPC1608X87N; Manufacturer_Part_Number CC0603JRNPO9BN101; Mouser Part Number 603-CC603JRNPO9BN101
D15, D18: BAT54LT1G; SOT96P237X111-3N; Manufacturer_Part_Number BAT54LT1G; Mouser Part Number 863-BAT54LT1G
D16, D17: 1N4148WX-TP; SOD2512X130N; Manufacturer_Part_Number 1N4148WX-TP
IC43: TL074HIDYYR; SOP50P326X110-14N; Manufacturer_Part_Number TL074HIDYYR; Mouser Part Number 595-TL074HIDYYR
R159: 10k; RESC1608X55N; Manufacturer_Part_Number RC0603FR-0710KL; Mouser Part Number 603-RC0603FR-0710KL
R160: 5.1k; RESC1608X55N; Manufacturer_Part_Number RC0603FR-075K1L; Mouser Part Number 603-RC0603FR-075K1L

Connections:
GND: C152.2, C153.2, IC43.11 (VCC-)
VCC Signal: C152.1, C153.1, IC43.4 (VCC+)
