Alex-Wolfe/Home-Audio-System/Hardware/Design/Main Board/Native Kicad/EQ Display.kicad_sch

## KiCad design Hardware/Design/Main Board/Native Kicad/EQ Display.kicad_sch (2025-06-05)

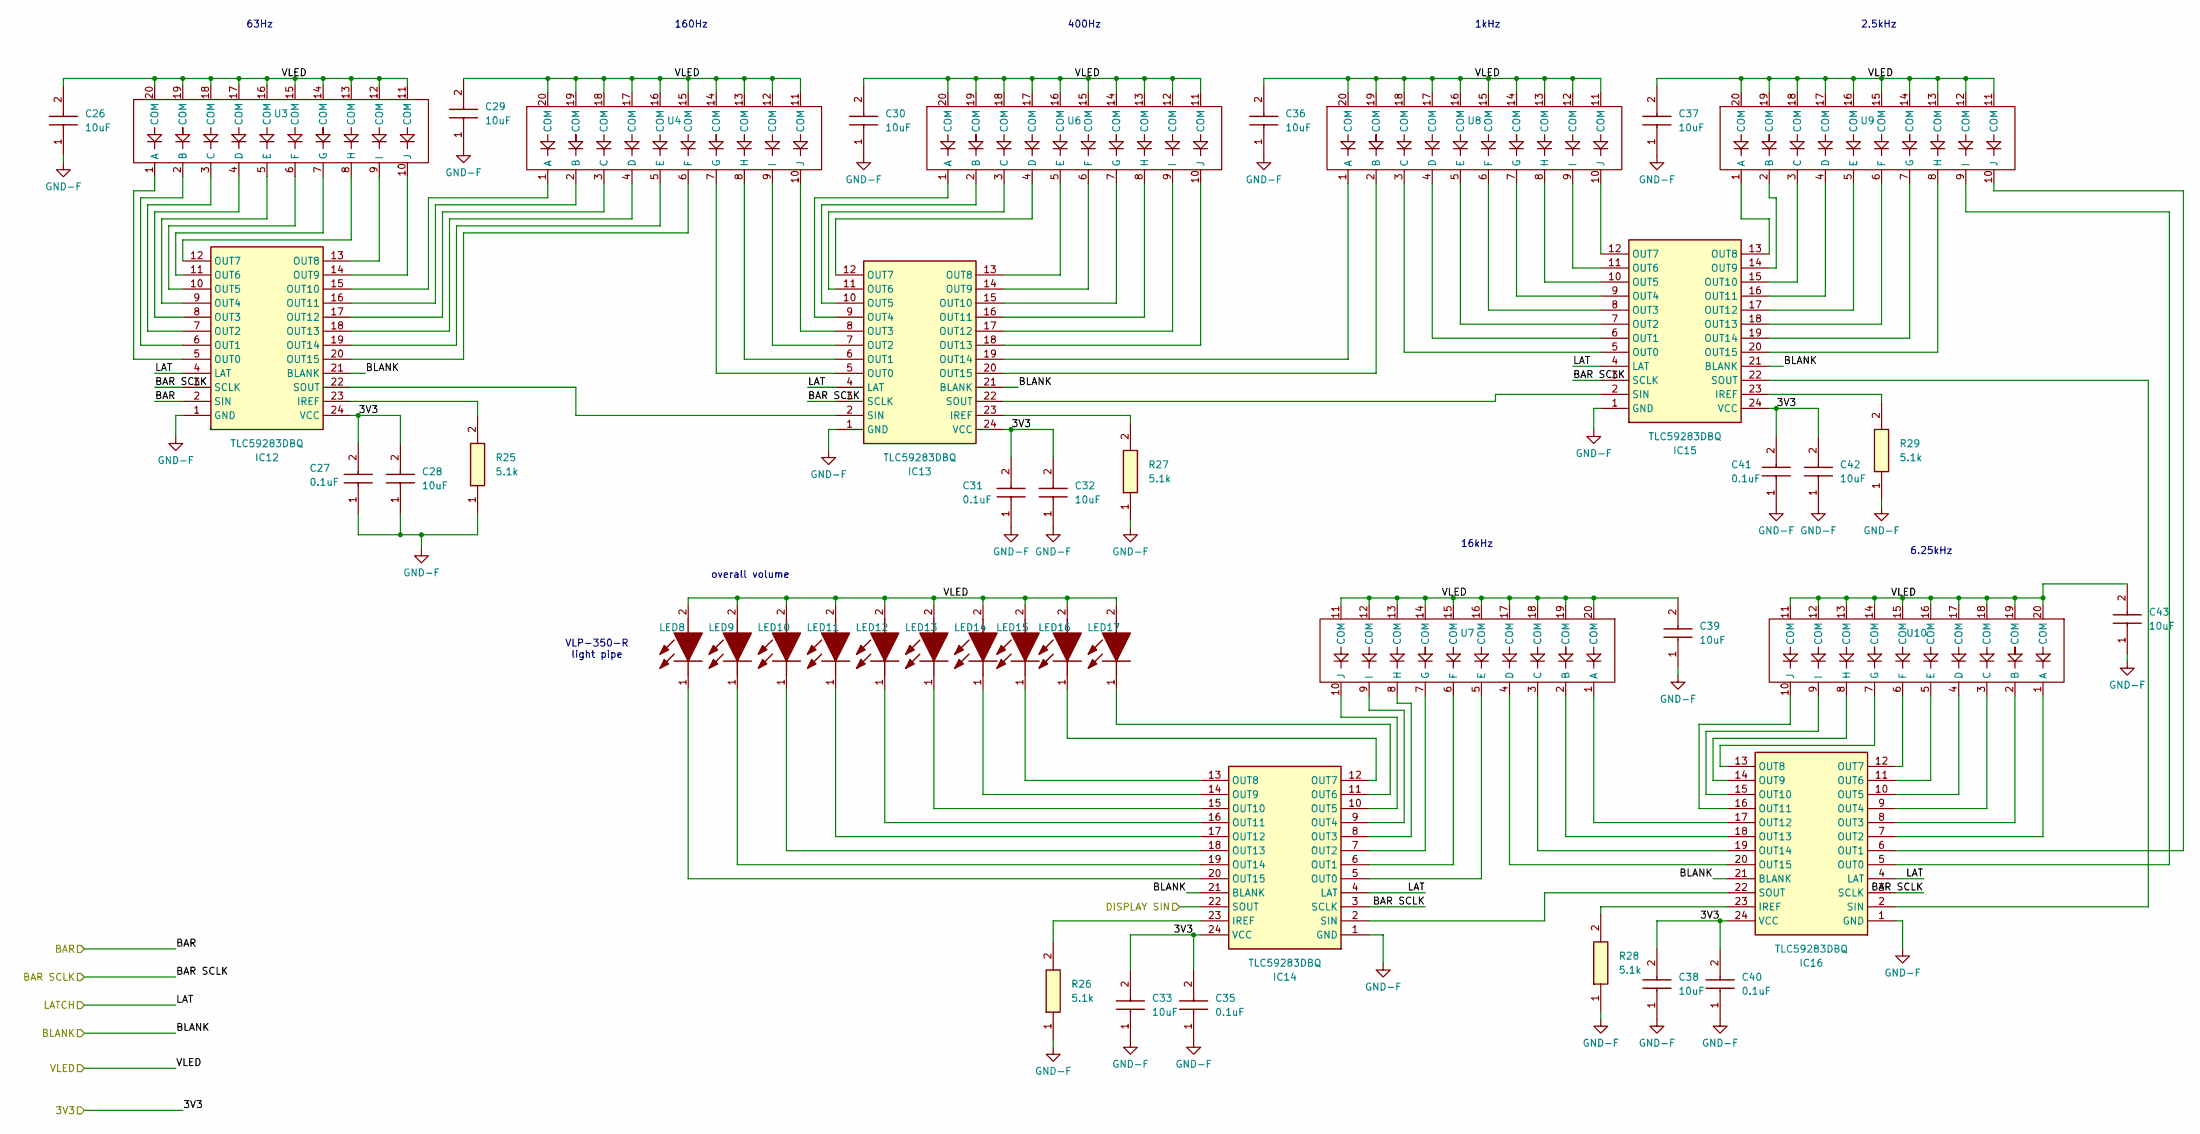
[picture p63: schematic EQ Display.kicad_sch]

Parts:
C26, C28, C29, C30, C32, C33, C36, C37, C38, C39, C42, C43: 10uF; CAPC2012X145N; Manufacturer_Part_Number GRM21BR61C106KE15K; Mouser Part Number 81-GRM21BR61C106KE5K
C27, C31, C35, C40, C41: 0.1uF; CAPC1608X90N; Manufacturer_Part_Number CC0603KRX7R7BB104; Mouser Part Number 603-CC603KRX7R7BB104
IC12, IC13, IC14, IC15, IC16: TLC59283DBQ; SOP64P600X175-24N; Manufacturer_Part_Number TLC59283DBQ; Mouser Part Number 595-TLC59283DBQ
LED8, LED9, LED10, LED11, LED12, LED13, LED14, LED15, LED16, LED17: 150060SS75000; LEDC1608X80N; Manufacturer_Part_Number 150060SS75000; Mouser Part Number 710-150060SS75000
R25, R26, R27, R28, R29: 5.1k; RESC1608X55N; Manufacturer_Part_Number RC0603FR-075K1L; Mouser Part Number 603-RC0603FR-075K1L
U3, U4, U6, U7, U8, U9, U10: LED Bar Graph

Connections:
3V3: C27.2, C28.2, C31.2, C32.2, C33.2, C35.2, C38.2, C40.2, C41.2, C42.2, IC12.24 (VCC), IC13.24 (VCC), IC14.24 (VCC), IC15.24 (VCC), IC16.24 (VCC)
BAR: IC12.2 (SIN)
BAR SCLK: IC12.3 (SCLK), IC13.3 (SCLK), IC14.3 (SCLK), IC15.3 (SCLK), IC16.3 (SCLK)
BLANK: IC12.21 (BLANK), IC13.21 (BLANK), IC14.21 (BLANK), IC15.21 (BLANK), IC16.21 (BLANK)
DISPLAY SIN: IC14.22 (SOUT)
GND-F: C26.1, C27.1, C28.1, C29.1, C30.1, C31.1, C32.1, C33.1, C35.1, C36.1, C37.1, C38.1, C39.1, C40.1, C41.1, C42.1, C43.1, IC12.1 (GND), IC13.1 (GND), IC14.1 (GND), IC15.1 (GND), IC16.1 (GND), R25.1, R26.1, R27.1, R28.1, R29.1
LAT: IC12.4 (LAT), IC13.4 (LAT), IC14.4 (LAT), IC15.4 (LAT), IC16.4 (LAT)
unnamed: IC12.5 (OUT0), U3.1 (A)
unnamed: IC12.6 (OUT1), U3.2 (B)
unnamed: IC12.7 (OUT2), U3.3 (C)
unnamed: IC12.8 (OUT3), U3.4 (D)
unnamed: IC12.9 (OUT4), U3.5 (E)
unnamed: IC12.10 (OUT5), U3.6 (F)
unnamed: IC12.11 (OUT6), U3.7 (G)
unnamed: IC12.12 (OUT7), U3.8 (H)
unnamed: IC12.13 (OUT8), U3.9 (I)
unnamed: IC12.14 (OUT9), U3.10 (J)
unnamed: IC12.15 (OUT10), U4.1 (A)
unnamed: IC12.16 (OUT11), U4.2 (B)
unnamed: IC12.17 (OUT12), U4.3 (C)
unnamed: IC12.18 (OUT13), U4.4 (D)
unnamed: IC12.19 (OUT14), U4.5 (E)
unnamed: IC12.20 (OUT15), U4.6 (F)
unnamed: IC12.22 (SOUT), IC13.2 (SIN)
unnamed: IC12.23 (IREF), R25.2
unnamed: IC13.5 (OUT0), U4.7 (G)
unnamed: IC13.6 (OUT1), U4.8 (H)
unnamed: IC13.7 (OUT2), U4.9 (I)
unnamed: IC13.8 (OUT3), U4.10 (J)
unnamed: IC13.9 (OUT4), U6.1 (A)
unnamed: IC13.10 (OUT5), U6.2 (B)
unnamed: IC13.11 (OUT6), U6.3 (C)
unnamed: IC13.12 (OUT7), U6.4 (D)
unnamed: IC13.13 (OUT8), U6.5 (E)
unnamed: IC13.14 (OUT9), U6.6 (F)
unnamed: IC13.15 (OUT10), U6.7 (G)
unnamed: IC13.16 (OUT11), U6.8 (H)
unnamed: IC13.17 (OUT12), U6.9 (I)
unnamed: IC13.18 (OUT13), U6.10 (J)
unnamed: IC13.19 (OUT14), U8.1 (A)
unnamed: IC13.20 (OUT15), U8.2 (B)
unnamed: IC13.22 (SOUT), IC15.2 (SIN)
unnamed: IC13.23 (IREF), R27.2
unnamed: IC14.2 (SIN), IC16.22 (SOUT)
unnamed: IC14.5 (OUT0), U7.5 (E)
unnamed: IC14.6 (OUT1), U7.6 (F)
unnamed: IC14.7 (OUT2), U7.7 (G)
unnamed: IC14.8 (OUT3), U7.8 (H)
unnamed: IC14.9 (OUT4), U7.9 (I)
unnamed: IC14.10 (OUT5), U7.10 (J)
unnamed: IC14.11 (OUT6), LED17.1 (K)
unnamed: IC14.12 (OUT7), LED16.1 (K)
unnamed: IC14.13 (OUT8), LED15.1 (K)
unnamed: IC14.14 (OUT9), LED14.1 (K)
unnamed: IC14.15 (OUT10), LED13.1 (K)
unnamed: IC14.16 (OUT11), LED12.1 (K)
unnamed: IC14.17 (OUT12), LED11.1 (K)
unnamed: IC14.18 (OUT13), LED10.1 (K)
unnamed: IC14.19 (OUT14), LED9.1 (K)
unnamed: IC14.20 (OUT15), LED8.1 (K)
unnamed: IC14.23 (IREF), R26.2
unnamed: IC15.5 (OUT0), U8.3 (C)
unnamed: IC15.6 (OUT1), U8.4 (D)
unnamed: IC15.7 (OUT2), U8.5 (E)
unnamed: IC15.8 (OUT3), U8.6 (F)
unnamed: IC15.9 (OUT4), U8.7 (G)
unnamed: IC15.10 (OUT5), U8.8 (H)
unnamed: IC15.11 (OUT6), U8.9 (I)
unnamed: IC15.12 (OUT7), U8.10 (J)
unnamed: IC15.13 (OUT8), U9.1 (A)
unnamed: IC15.14 (OUT9), U9.2 (B)
unnamed: IC15.15 (OUT10), U9.3 (C)
unnamed: IC15.16 (OUT11), U9.4 (D)
unnamed: IC15.17 (OUT12), U9.5 (E)
unnamed: IC15.18 (OUT13), U9.6 (F)
unnamed: IC15.19 (OUT14), U9.7 (G)
unnamed: IC15.20 (OUT15), U9.8 (H)
unnamed: IC15.22 (SOUT), IC16.2 (SIN)
unnamed: IC15.23 (IREF), R29.2
unnamed: IC16.5 (OUT0), U9.9 (I)
unnamed: IC16.6 (OUT1), U9.10 (J)
unnamed: IC16.7 (OUT2), U10.1 (A)
unnamed: IC16.8 (OUT3), U10.2 (B)
unnamed: IC16.9 (OUT4), U10.3 (C)
unnamed: IC16.10 (OUT5), U10.4 (D)
unnamed: IC16.11 (OUT6), U10.5 (E)
unnamed: IC16.12 (OUT7), U10.6 (F)
unnamed: IC16.13 (OUT8), U10.7 (G)
unnamed: IC16.14 (OUT9), U10.8 (H)
unnamed: IC16.15 (OUT10), U10.9 (I)
unnamed: IC16.16 (OUT11), U10.10 (J)
unnamed: IC16.17 (OUT12), U7.1 (A)
unnamed: IC16.18 (OUT13), U7.2 (B)
unnamed: IC16.19 (OUT14), U7.3 (C)
unnamed: IC16.20 (OUT15), U7.4 (D)
unnamed: IC16.23 (IREF), R28.2
VLED: C26.2, C29.2, C30.2, C36.2, C37.2, C39.2, C43.2, LED8.2 (A), LED9.2 (A), LED10.2 (A), LED11.2 (A), LED12.2 (A), LED13.2 (A), LED14.2 (A), LED15.2 (A), LED16.2 (A), LED17.2 (A), U3.11 (COM), U3.12 (COM), U3.13 (COM), U3.14 (COM), U3.15 (COM), U3.16 (COM), U3.17 (COM), U3.18 (COM), U3.19 (COM), U3.20 (COM), U4.11 (COM), U4.12 (COM), U4.13 (COM), U4.14 (COM), U4.15 (COM), U4.16 (COM), U4.17 (COM), U4.18 (COM), U4.19 (COM), U4.20 (COM), U6.11 (COM), U6.12 (COM), U6.13 (COM), U6.14 (COM), U6.15 (COM), U6.16 (COM), U6.17 (COM), U6.18 (COM), U6.19 (COM), U6.20 (COM), U7.11 (COM), U7.12 (COM), U7.13 (COM), U7.14 (COM), U7.15 (COM), U7.16 (COM), U7.17 (COM), U7.18 (COM), U7.19 (COM), U7.20 (COM), U8.11 (COM), U8.12 (COM), U8.13 (COM), U8.14 (COM), U8.15 (COM), U8.16 (COM), U8.17 (COM), U8.18 (COM), U8.19 (COM), U8.20 (COM), U9.11 (COM), U9.12 (COM), U9.13 (COM), U9.14 (COM), U9.15 (COM), U9.16 (COM), U9.17 (COM), U9.18 (COM), U9.19 (COM), U9.20 (COM), U10.11 (COM), U10.12 (COM), U10.13 (COM), U10.14 (COM), U10.15 (COM), U10.16 (COM), U10.17 (COM), U10.18 (COM), U10.19 (COM), U10.20 (COM)

Notes on the sheet:
63Hz
160Hz
400Hz
overall volume
16kHz
2.5kHz
VLP-350-R light pipe
1kHz
6.25kHz
