Alex-Wolfe/Home-Audio-System/Hardware/Design/Main Board/Native Kicad/EQ Stage L.kicad_sch

## KiCad design Hardware/Design/Main Board/Native Kicad/EQ Stage L.kicad_sch (2025-06-05)

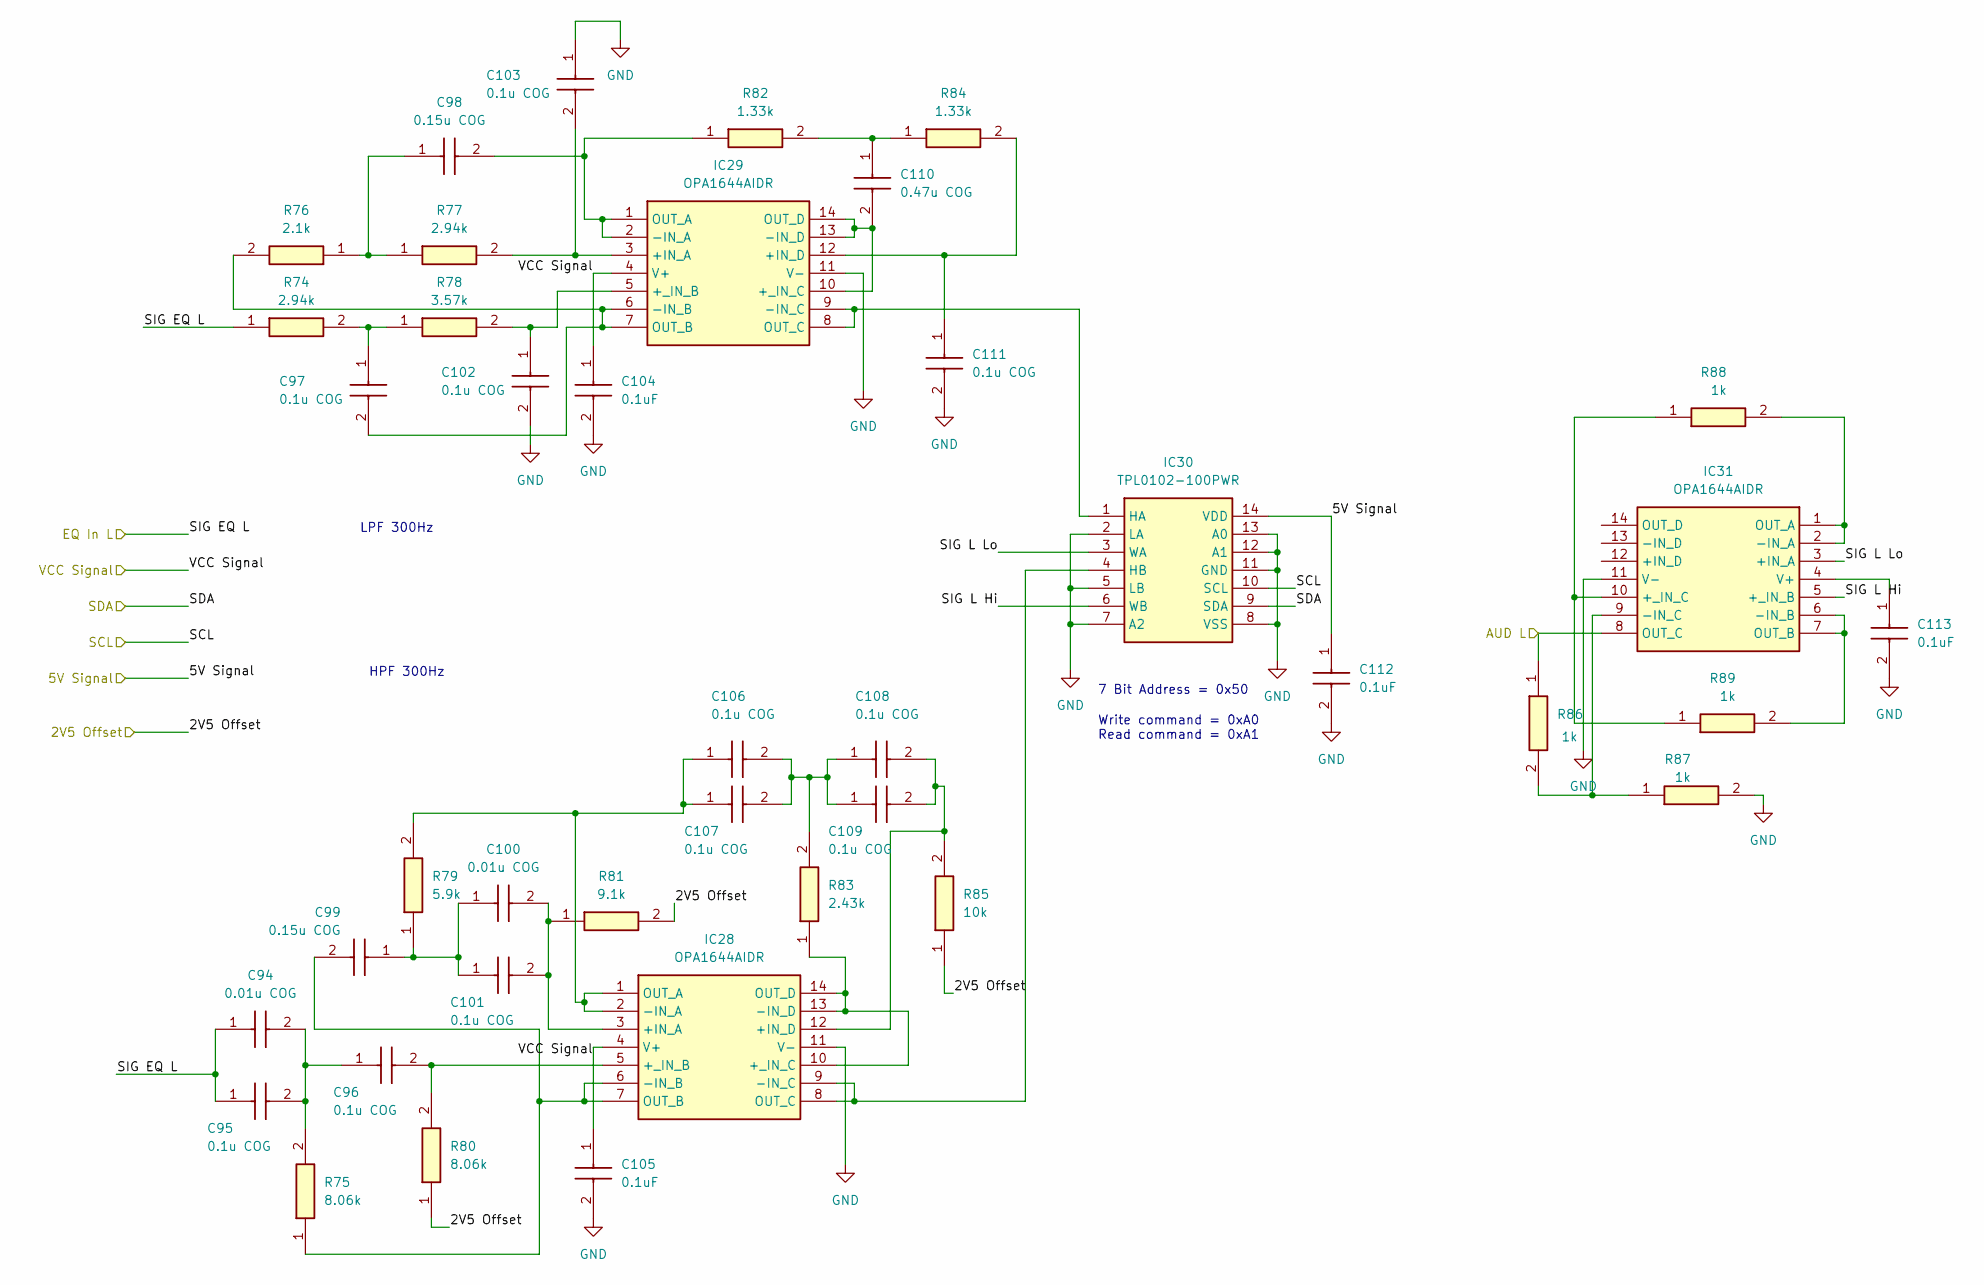
[picture p64: schematic EQ Stage L.kicad_sch]

Parts:
C94, C100: 0.01u COG; CAPC1608X90N; Manufacturer_Part_Number GRM1885C1H103JA01D; Mouser Part Number 81-GRM1885C1H103JA1D
C95, C96, C97, C101, C102, C103, C106, C107, C108, C109, C111: 0.1u COG; CAPC3216X180N; Manufacturer_Part_Number GRM31C5C1H104JA01L; Mouser Part Number 81-GRM31C5C1H104JA1L
C98, C99: 0.15u COG; C4532_Commercial; Manufacturer_Part_Number C4532C0G1H154J250KA
C104, C105, C112, C113: 0.1uF; CAPC2012X95N; Manufacturer_Part_Number CL21B104KACNNNC; Mouser Part Number 187-CL21B104KACNNNC
C110: 0.47u COG; CAPC3216X180N; Manufacturer_Part_Number GRM31C5C1E474JE01L; Mouser Part Number 81-GRM31C5C1E474JE1L
IC28, IC29, IC31: OPA1644AIDR; SOIC127P600X175-14N; Manufacturer_Part_Number OPA1644AIDR; Mouser Part Number 595-OPA1644AIDR
IC30: TPL0102-100PWR; SOP65P640X120-14N; Manufacturer_Part_Number TPL0102-100PWR; Mouser Part Number 595-TPL0102-100PWR
R74, R77: 2.94k; ERA6AEB1020V; Manufacturer_Part_Number ERA-6AEB2941V; Mouser Part Number 667-ERA-6AEB2941V
R75, R80: 8.06k; ERA6AEB1020V; Manufacturer_Part_Number ERA-6AEB8061V; Mouser Part Number 667-ERA-6AEB8061V
R76: 2.1k; ERA6AEB1020V; Manufacturer_Part_Number ERA-6AEB2101V; Mouser Part Number 667-ERA-6AEB2101V
R78: 3.57k; ERA6AEB1020V; Manufacturer_Part_Number ERA-6AEB3571V; Mouser Part Number 667-ERA-6AEB3571V
R79: 5.9k; ERA6AEB1020V; Manufacturer_Part_Number ERA-6AEB5901V
R81: 9.1k; ERA6AEB1020V; Manufacturer_Part_Number ERA-6AEB912V; Mouser Part Number 667-ERA-6AEB912V
R82, R84: 1.33k; ERA6AEB1020V; Manufacturer_Part_Number ERA-6AEB1331V; Mouser Part Number 667-ERA-6AEB1331V
R83: 2.43k; ERA6AEB1020V; Manufacturer_Part_Number ERA-6AEB2431V; Mouser Part Number 667-ERA-6AEB2431V
R85: 10k; ERA6AEB1020V; Manufacturer_Part_Number ERA-6AEB103V; Mouser Part Number 667-ERA-6AEB103V
R86, R87, R88, R89: 1k; ERA6AEB1020V; Manufacturer_Part_Number ERA-6AEB102V; Mouser Part Number 667-ERA-6AEB102V

Connections:
2V5 Offset: R80.1, R81.2, R85.1
5V Signal: C112.1, IC30.14 (VDD)
AUD L: IC31.8 (OUT_C), R86.1
EQ In L: C94.1, C95.1, R74.1
GND: C102.2, C103.1, C104.2, C105.2, C111.2, C112.2, C113.2, IC28.11 (V-), IC29.11 (V-), IC30.2 (LA), IC30.5 (LB), IC30.7 (A2), IC30.8 (VSS), IC30.11 (GND), IC30.12 (A1), IC30.13 (A0), IC31.11 (V-), R87.2
unnamed: C94.2, C95.2, C96.1, R75.2
unnamed: C96.2, IC28.5 (+_IN_B), R80.2
unnamed: C97.1, R74.2, R78.1
unnamed: C97.2, IC29.6 (-IN_B), IC29.7 (OUT_B), R76.2
unnamed: C98.1, R76.1, R77.1
unnamed: C98.2, IC29.1 (OUT_A), IC29.2 (-IN_A), R82.1
unnamed: C99.2, IC28.6 (-IN_B), IC28.7 (OUT_B), R75.1
unnamed: C99.1, C100.1, C101.1, R79.1
unnamed: C100.2, C101.2, IC28.3 (+IN_A), R81.1
unnamed: C102.1, IC29.5 (+_IN_B), R78.2
unnamed: C103.2, IC29.3 (+IN_A), R77.2
unnamed: C106.1, C107.1, IC28.1 (OUT_A), IC28.2 (-IN_A), R79.2
unnamed: C106.2, C107.2, C108.1, C109.1, R83.2
unnamed: C108.2, C109.2, IC28.12 (+IN_D), R85.2
unnamed: C110.1, R82.2, R84.1
unnamed: C110.2, IC29.10 (+_IN_C), IC29.13 (-IN_D), IC29.14 (OUT_D)
unnamed: C111.1, IC29.12 (+IN_D), R84.2
unnamed: C113.1, IC31.4 (V+)
unnamed: IC28.8 (OUT_C), IC28.9 (-IN_C), IC30.4 (HB)
unnamed: IC28.10 (+_IN_C), IC28.13 (-IN_D), IC28.14 (OUT_D), R83.1
unnamed: IC29.8 (OUT_C), IC29.9 (-IN_C), IC30.1 (HA)
unnamed: IC31.1 (OUT_A), IC31.2 (-IN_A), R88.2
unnamed: IC31.6 (-IN_B), IC31.7 (OUT_B), R89.2
unnamed: IC31.9 (-IN_C), R86.2, R87.1
unnamed: IC31.10 (+_IN_C), R88.1, R89.1
SCL: IC30.10 (SCL)
SDA: IC30.9 (SDA)
SIG L Hi: IC30.6 (WB), IC31.5 (+_IN_B)
SIG L Lo: IC30.3 (WA), IC31.3 (+IN_A)
VCC Signal: C104.1, C105.1, IC28.4 (V+), IC29.4 (V+)

Notes on the sheet:
Write command = 0xA0 Read command = 0xA1
HPF 300Hz
7 Bit Address = 0x50
LPF 300Hz
