Alex-Wolfe/Home-Audio-System/Hardware/Design/Main Board/Native Kicad/EQ Stage R.kicad_sch

## KiCad design Hardware/Design/Main Board/Native Kicad/EQ Stage R.kicad_sch (2025-06-05)

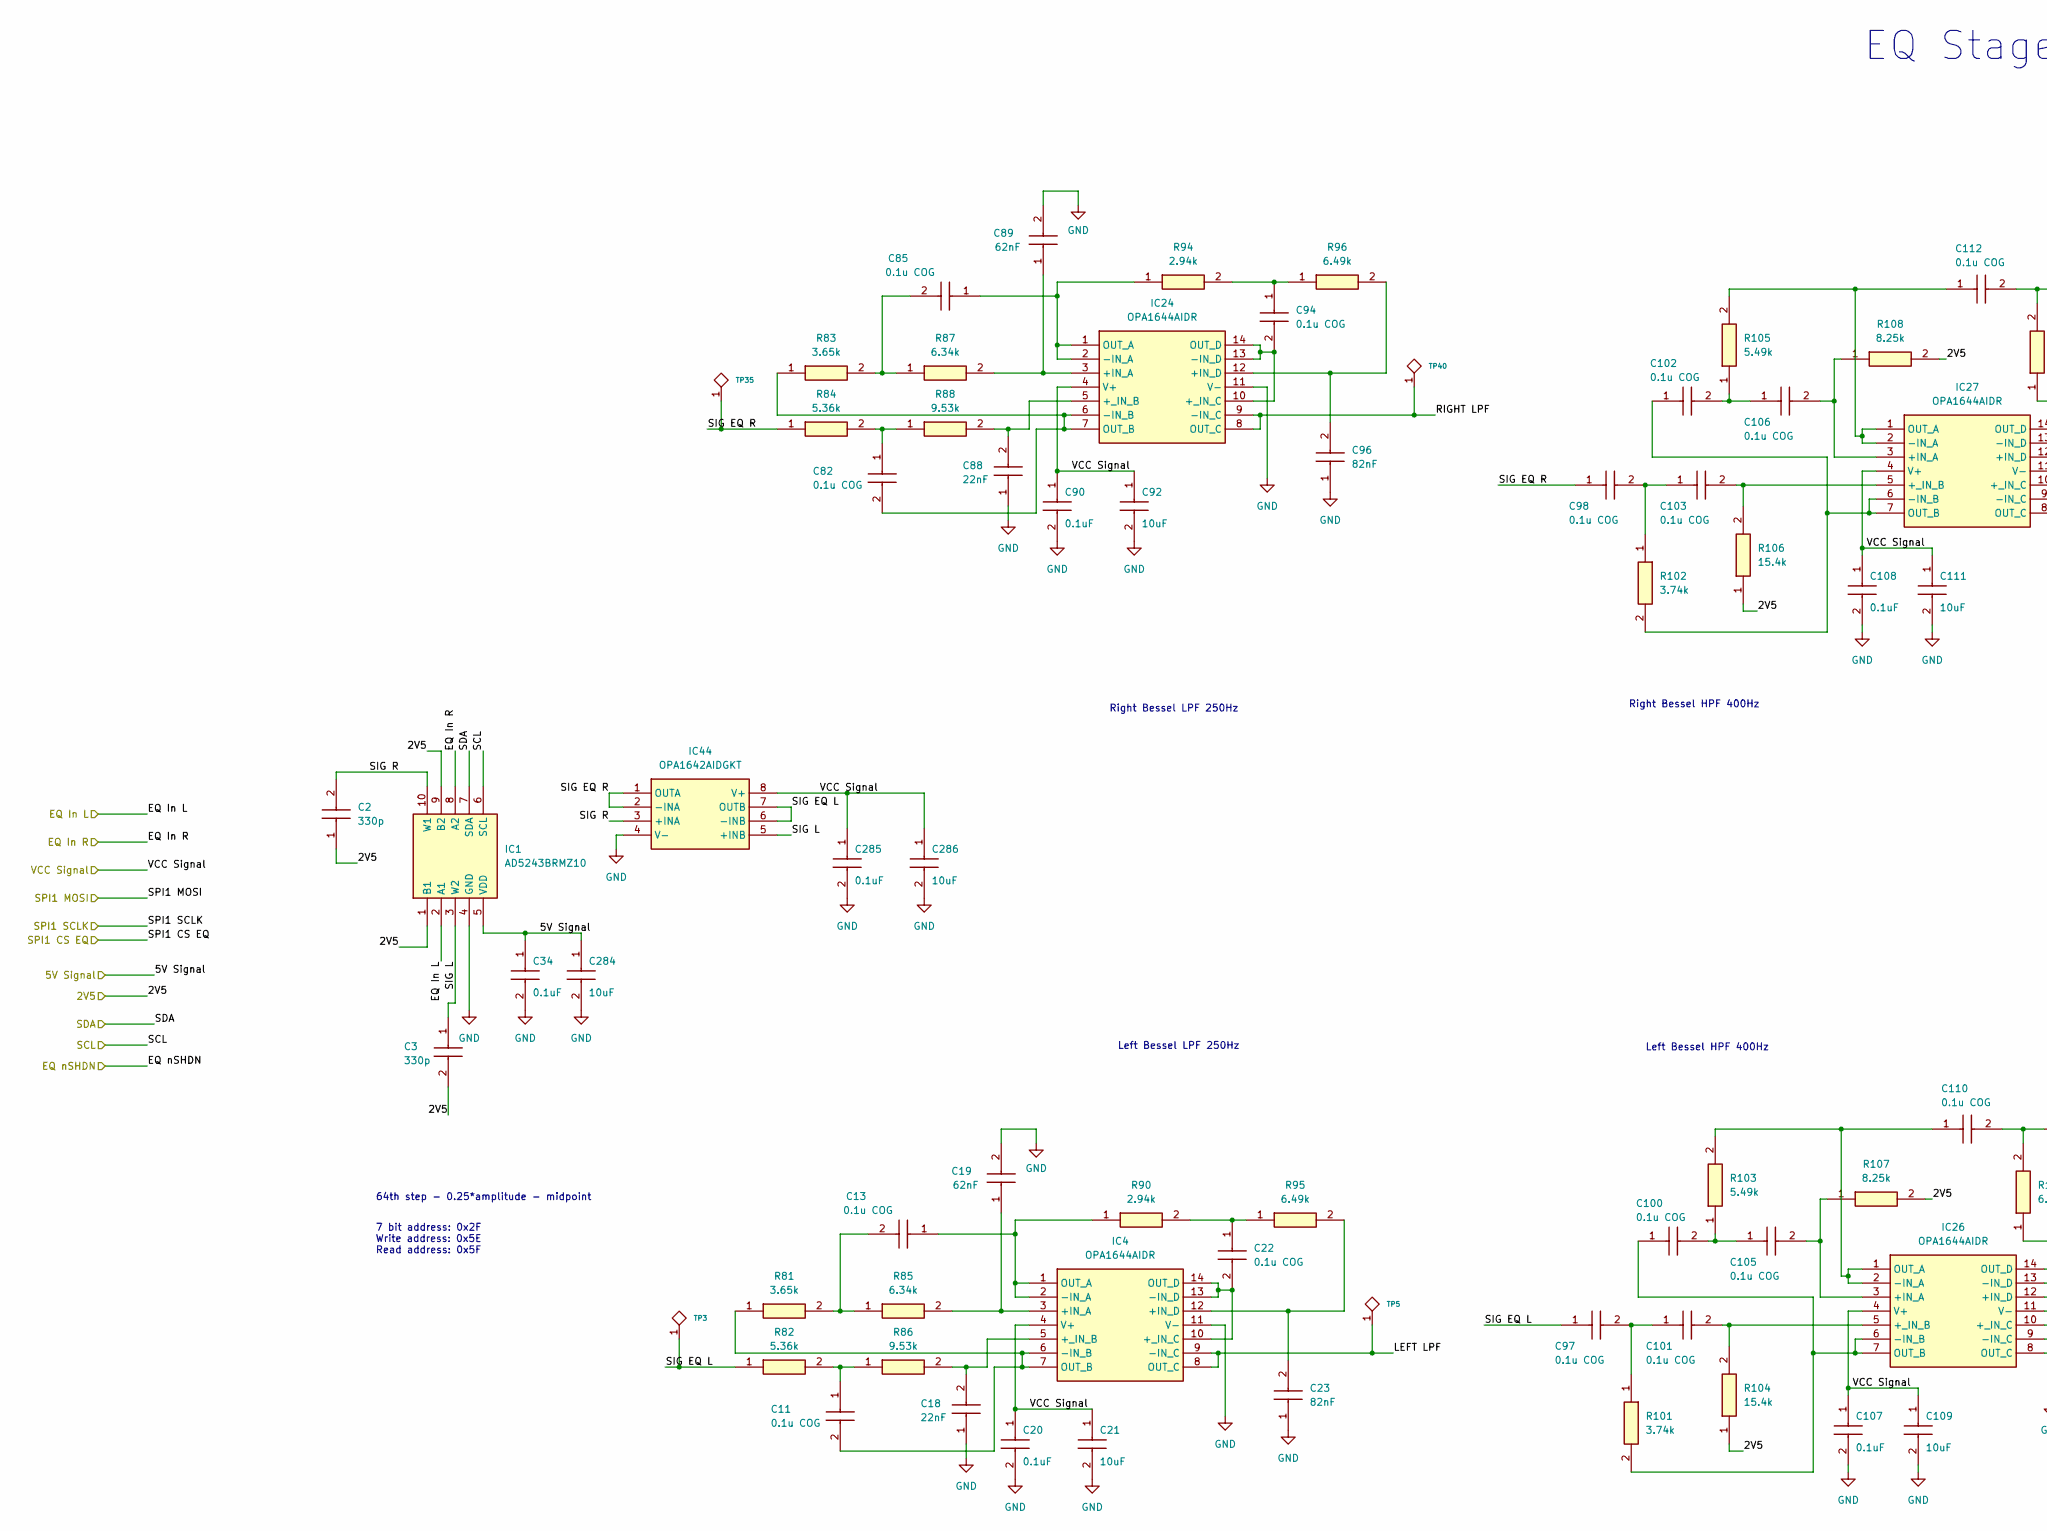
[picture p65: schematic EQ Stage R.kicad_sch, part in row 1, column 1]

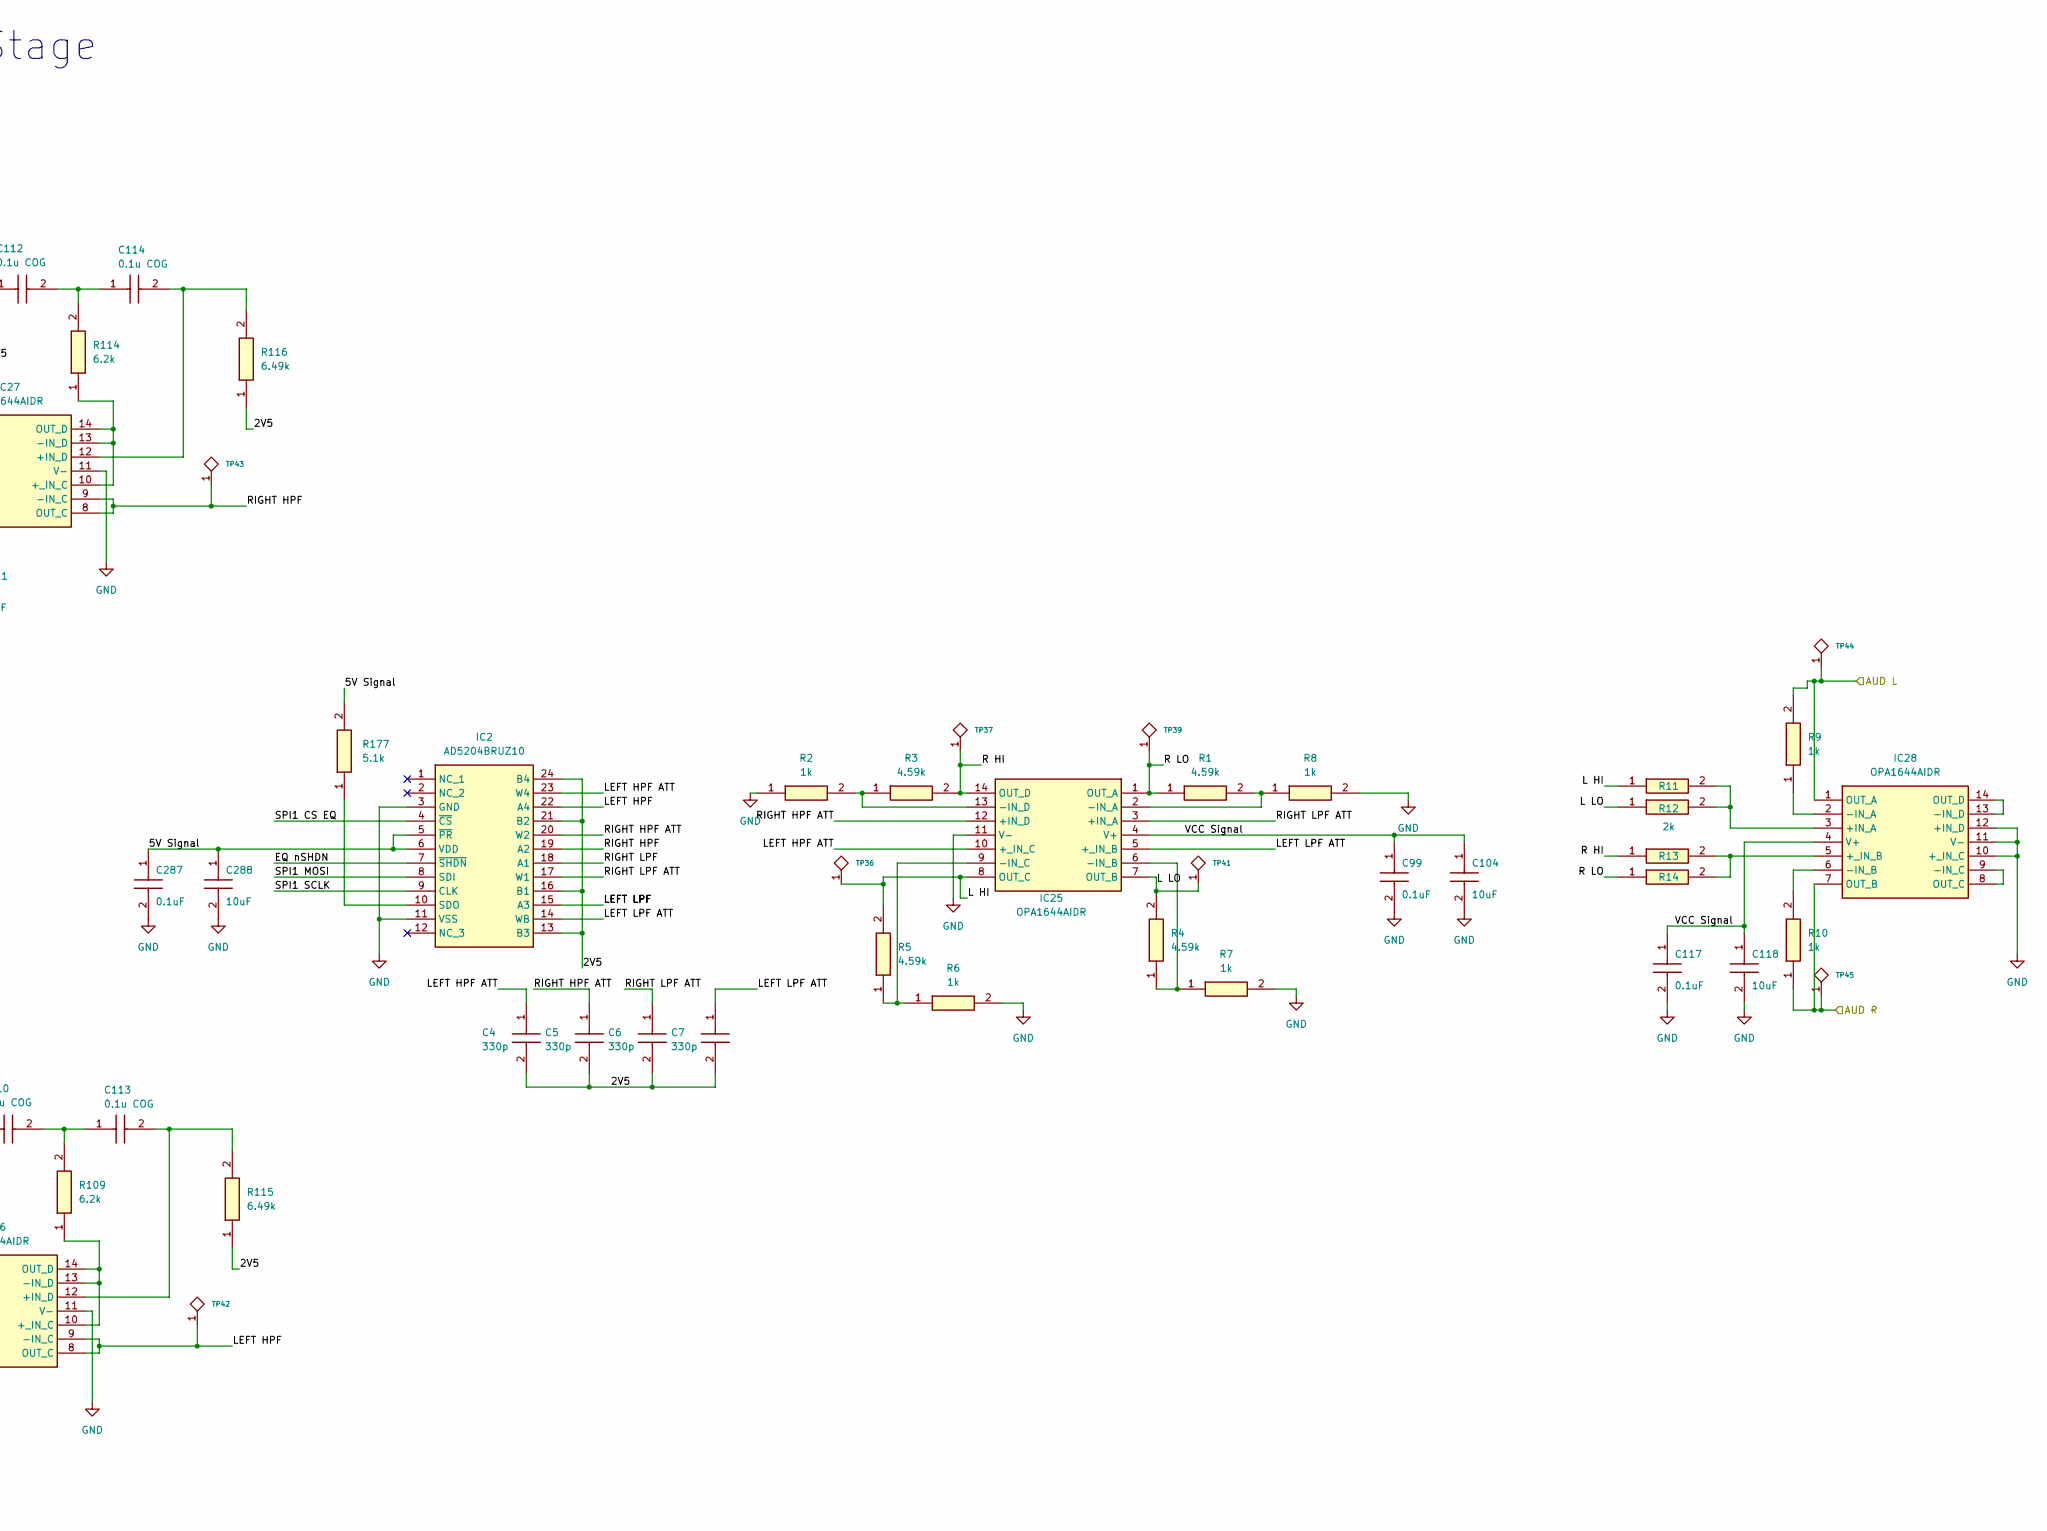
[picture p66: schematic EQ Stage R.kicad_sch, part in row 1, column 2]

Parts:
C2, C3, C4, C5, C6, C7: 330p; CAPC1608X87N; Manufacturer_Part_Number C0603C331J5GACTU; Mouser Part Number 80-C0603C331J5G
C11, C13, C22, C82, C85, C94, C97, C98, C100, C101, C102, C103, C105, C106, C110, C112, C113, C114: 0.1u COG; CAPC3216X180N; Manufacturer_Part_Number GRM31C5C1H104JA01L; Mouser Part Number 81-GRM31C5C1H104JA1L
C18, C88: 22nF; GCM21; Manufacturer_Part_Number GCM21B5C1H223FA16L; Mouser Part Number 81-GCM21B5C1H223FA6L
C19, C89: 62nF; GRM31x; Manufacturer_Part_Number GRM31C5C1H623JA01K; Mouser Part Number 81-GRM31C5C1H623JA1K
C20, C34, C90, C99, C107, C108, C117, C285, C287: 0.1uF; C0603; Manufacturer_Part_Number C0603C104M5RACTU; Mouser Part Number 80-C0603C104M5R
C21, C92, C104, C109, C111, C118, C284, C286, C288: 10uF; GRM21x; Manufacturer_Part_Number GRM21BR61H106KE43L; Mouser Part Number 81-GRM21BR61H106KE3L
C23, C96: 82nF; CAPC3216X180N; Manufacturer_Part_Number GRM31C5C1H823JA01L; Mouser Part Number 81-GRM31C5C823JA01L
IC1: AD5243BRMZ10; SOP50P490X110-10N; Manufacturer_Part_Number AD5243BRMZ10; Mouser Part Number 584-AD5243BRMZ10
IC2: AD5204BRUZ10; SOP65P640X120-24N; Manufacturer_Part_Number AD5204BRUZ10; Mouser Part Number 584-AD5204BRUZ10
IC4, IC24, IC25, IC26, IC27, IC28: OPA1644AIDR; SOIC127P600X175-14N; Manufacturer_Part_Number OPA1644AIDR; Mouser Part Number 595-OPA1644AIDR
IC44: OPA1642AIDGKT; SOP65P490X110-8N; Manufacturer_Part_Number OPA1642AIDGKT; Mouser Part Number 595-OPA1642AIDGKT
R1, R3, R4, R5: 4.59k; RESC1608X55N; Manufacturer_Part_Number TNPW06034K59BEEA
R2, R6, R7, R8, R9, R10: 1k; ERA3AEB101V; Manufacturer_Part_Number ERA-3AEB102V; Mouser Part Number 667-ERA-3AEB102V
R11, R12, R13, R14: 2k; ERA3AEB101V; Manufacturer_Part_Number ERA-3AEB202V; Mouser Part Number 667-ERA-3AEB202V
R81, R83: 3.65k; ERA3AEB101V; Manufacturer_Part_Number ERA-3AEB3651V; Mouser Part Number 667-ERA-3AEB3651V
R82, R84: 5.36k; ERA3AEB101V; Manufacturer_Part_Number ERA-3AEB5361V; Mouser Part Number 667-ERA-3AEB5361V
R85, R87: 6.34k; ERA3AEB101V; Manufacturer_Part_Number ERA-3AEB6341V; Mouser Part Number 667-ERA-3AEB6341V
R86, R88: 9.53k; ERA3AEB101V; Manufacturer_Part_Number ERA-3AEB9531V; Mouser Part Number 667-ERA-3AEB9531V
R90, R94: 2.94k; ERA3AEB101V; Manufacturer_Part_Number ERA-3AEB2941V
R95, R96, R115, R116: 6.49k; ERA3AEB101V; Manufacturer_Part_Number ERA-3AEB6491V; Mouser Part Number 667-ERA-3AEB6491V
R101, R102: 3.74k; ERA3AEB101V; Manufacturer_Part_Number ERA-3AEB3741V; Mouser Part Number 667-ERA-3AEB3741V
R103, R105: 5.49k; ERA3AEB101V; Manufacturer_Part_Number ERA-3AEB5491V
R104, R106: 15.4k; ERA3AEB101V; Manufacturer_Part_Number ERA-3AEB1542V; Mouser Part Number 667-ERA-3AEB1542V
R107, R108: 8.25k; ERA3AEB101V; Manufacturer_Part_Number ERA-3AEB8251V; Mouser Part Number 667-ERA-3AEB8251V
R109, R114: 6.2k; ERA3AEB101V; Manufacturer_Part_Number ERA-3AEB622V; Mouser Part Number 667-ERA-3AEB622V
R177: 5.1k; RESC1608X55N; Manufacturer_Part_Number RC0603FR-075K1L; Mouser Part Number 603-RC0603FR-075K1L
TP3, TP5, TP35, TP36, TP37, TP39, TP40, TP41, TP42, TP43, TP44, TP45: TP

Connections:
2V5: C2.1, C3.2, C4.2, C5.2, C6.2, C7.2, IC1.1 (B1), IC1.9 (B2), IC2.13 (B3), IC2.16 (B1), IC2.21 (B2), IC2.24 (B4), R104.1, R106.1, R107.2, R108.2, R115.1, R116.1
5V Signal: C34.1, C284.1, C287.1, C288.1, IC1.5 (VDD), IC2.5 (~PR), IC2.6 (VDD), R177.2
AUD L: IC28.1 (OUT_A), R9.2, TP44.1
AUD R: IC28.7 (OUT_B), R10.1, TP45.1
EQ In L: IC1.2 (A1)
EQ In R: IC1.8 (A2)
EQ nSHDN: IC2.7 (~SHDN)
GND: C18.1, C19.2, C20.2, C21.2, C23.1, C34.2, C88.1, C89.2, C90.2, C92.2, C96.1, C99.2, C104.2, C107.2, C108.2, C109.2, C111.2, C117.2, C118.2, C284.2, C285.2, C286.2, C287.2, C288.2, IC1.4 (GND), IC2.3 (GND), IC2.11 (VSS), IC4.11 (V-), IC24.11 (V-), IC25.11 (V-), IC26.11 (V-), IC27.11 (V-), IC28.10 (+_IN_C), IC28.11 (V-), IC28.12 (+IN_D), IC44.4 (V-), R2.1, R6.2, R7.2, R8.2
L HI: IC25.8 (OUT_C), R5.2, R11.1, TP36.1
L LO: IC25.7 (OUT_B), R4.2, R12.1, TP41.1
LEFT HPF: IC2.22 (A4), IC26.8 (OUT_C), IC26.9 (-IN_C), TP42.1
LEFT HPF ATT: C4.1, IC2.23 (W4), IC25.10 (+_IN_C)
LEFT LPF: IC2.15 (A3), IC4.8 (OUT_C), IC4.9 (-IN_C), TP5.1
LEFT LPF ATT: C7.1, IC2.14 (WB), IC25.5 (+_IN_B)
unnamed: C11.1, R82.2, R86.1
unnamed: C11.2, IC4.6 (-IN_B), IC4.7 (OUT_B), R81.1
unnamed: C13.1, IC4.1 (OUT_A), IC4.2 (-IN_A), R90.1
unnamed: C13.2, R81.2, R85.1
unnamed: C18.2, IC4.5 (+_IN_B), R86.2
unnamed: C19.1, IC4.3 (+IN_A), R85.2
unnamed: C22.1, R90.2, R95.1
unnamed: C22.2, IC4.10 (+_IN_C), IC4.13 (-IN_D), IC4.14 (OUT_D)
unnamed: C23.2, IC4.12 (+IN_D), R95.2
unnamed: C82.1, R84.2, R88.1
unnamed: C82.2, IC24.6 (-IN_B), IC24.7 (OUT_B), R83.1
unnamed: C85.1, IC24.1 (OUT_A), IC24.2 (-IN_A), R94.1
unnamed: C85.2, R83.2, R87.1
unnamed: C88.2, IC24.5 (+_IN_B), R88.2
unnamed: C89.1, IC24.3 (+IN_A), R87.2
unnamed: C94.1, R94.2, R96.1
unnamed: C94.2, IC24.10 (+_IN_C), IC24.13 (-IN_D), IC24.14 (OUT_D)
unnamed: C96.2, IC24.12 (+IN_D), R96.2
unnamed: C100.1, IC26.6 (-IN_B), IC26.7 (OUT_B), R101.2
unnamed: C100.2, C105.1, R103.1
unnamed: C97.2, C101.1, R101.1
unnamed: C101.2, IC26.5 (+_IN_B), R104.2
unnamed: C102.1, IC27.6 (-IN_B), IC27.7 (OUT_B), R102.2
unnamed: C102.2, C106.1, R105.1
unnamed: C98.2, C103.1, R102.1
unnamed: C103.2, IC27.5 (+_IN_B), R106.2
unnamed: C105.2, IC26.3 (+IN_A), R107.1
unnamed: C106.2, IC27.3 (+IN_A), R108.1
unnamed: C110.1, IC26.1 (OUT_A), IC26.2 (-IN_A), R103.2
unnamed: C110.2, C113.1, R109.2
unnamed: C112.1, IC27.1 (OUT_A), IC27.2 (-IN_A), R105.2
unnamed: C112.2, C114.1, R114.2
unnamed: C113.2, IC26.12 (+IN_D), R115.2
unnamed: C114.2, IC27.12 (+IN_D), R116.2
unnamed: IC2.10 (SDO), R177.1
unnamed: IC25.2 (-IN_A), R1.2, R8.1
unnamed: IC25.6 (-IN_B), R4.1, R7.1
unnamed: IC25.9 (-IN_C), R5.1, R6.1
unnamed: IC25.13 (-IN_D), R2.2, R3.1
unnamed: IC26.10 (+_IN_C), IC26.13 (-IN_D), IC26.14 (OUT_D), R109.1
unnamed: IC27.10 (+_IN_C), IC27.13 (-IN_D), IC27.14 (OUT_D), R114.1
unnamed: IC28.2 (-IN_A), R9.1
unnamed: IC28.3 (+IN_A), R11.2, R12.2
unnamed: IC28.5 (+_IN_B), R13.2, R14.2
unnamed: IC28.6 (-IN_B), R10.2
unnamed: IC28.8 (OUT_C), IC28.9 (-IN_C)
unnamed: IC28.13 (-IN_D), IC28.14 (OUT_D)
R HI: IC25.14 (OUT_D), R3.2, R13.1, TP37.1
R LO: IC25.1 (OUT_A), R1.1, R14.1, TP39.1
RIGHT HPF: IC2.19 (A2), IC27.8 (OUT_C), IC27.9 (-IN_C), TP43.1
RIGHT HPF ATT: C5.1, IC2.20 (W2), IC25.12 (+IN_D)
RIGHT LPF: IC2.18 (A1), IC24.8 (OUT_C), IC24.9 (-IN_C), TP40.1
RIGHT LPF ATT: C6.1, IC2.17 (W1), IC25.3 (+IN_A)
SCL: IC1.6 (SCL)
SDA: IC1.7 (SDA)
SIG EQ L: C97.1, IC44.6 (-INB), IC44.7 (OUTB), R82.1, TP3.1
SIG EQ R: C98.1, IC44.1 (OUTA), IC44.2 (-INA), R84.1, TP35.1
SIG L: C3.1, IC1.3 (W2), IC44.5 (+INB)
SIG R: C2.2, IC1.10 (W1), IC44.3 (+INA)
SPI1 CS EQ: IC2.4 (~CS)
SPI1 MOSI: IC2.8 (SDI)
SPI1 SCLK: IC2.9 (CLK)
VCC Signal: C20.1, C21.1, C90.1, C92.1, C99.1, C104.1, C107.1, C108.1, C109.1, C111.1, C117.1, C118.1, C285.1, C286.1, IC4.4 (V+), IC24.4 (V+), IC25.4 (V+), IC26.4 (V+), IC27.4 (V+), IC28.4 (V+), IC44.8 (V+)

Notes on the sheet:
7 bit address: 0x2F Write address: 0x5E Read address: 0x5F
Right Bessel HPF 400Hz
64th step - 0.25*amplitude - midpoint
Right Bessel LPF 250Hz
EQ Stage
Left Bessel HPF 400Hz
Left Bessel LPF 250Hz
