Alex-Wolfe/Home-Audio-System/Hardware/Design/Main Board/Native Kicad/EQ Stage.kicad_sch

## KiCad design Hardware/Design/Main Board/Native Kicad/EQ Stage.kicad_sch (2025-06-05)

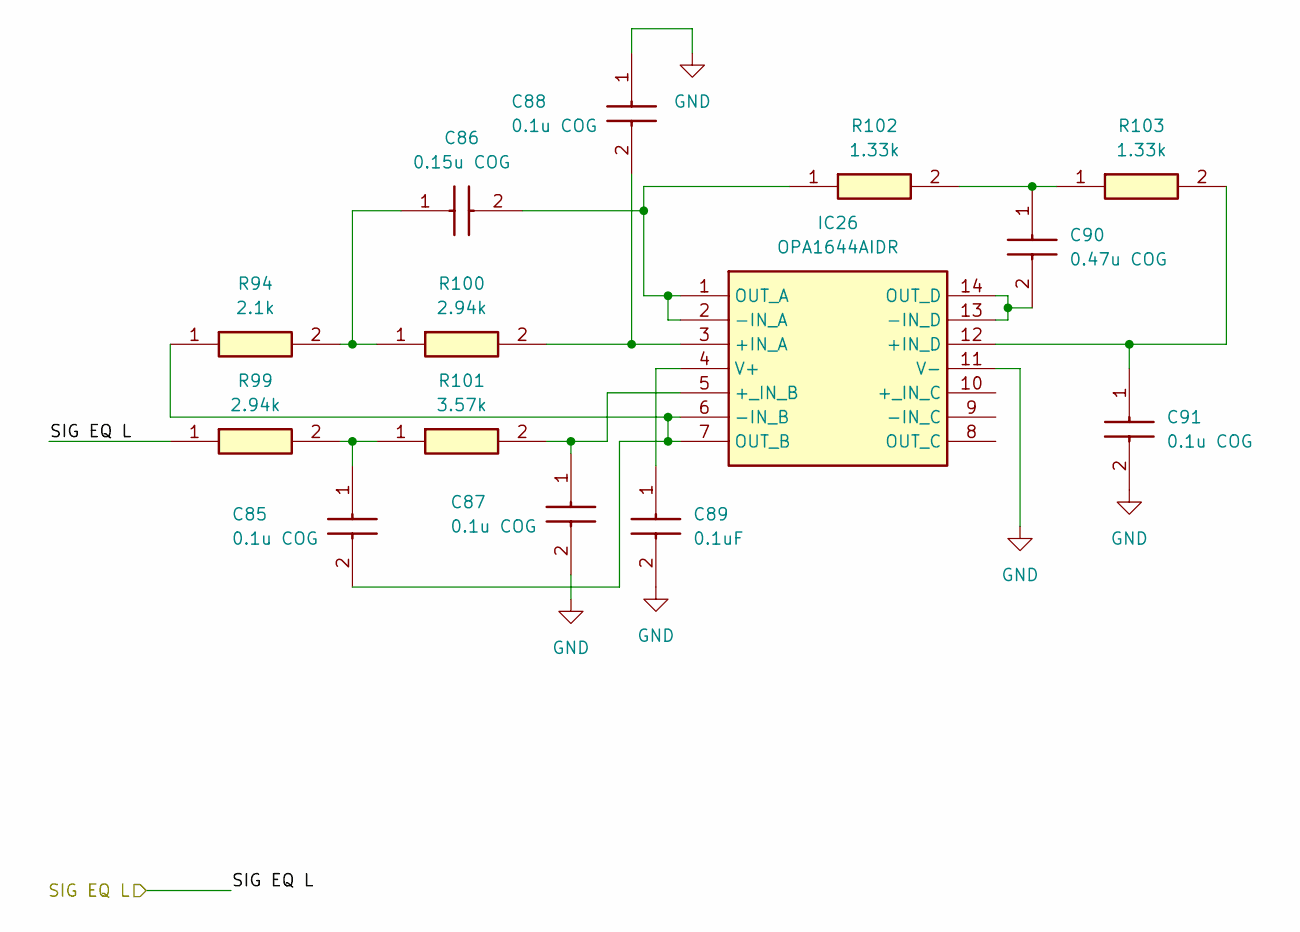
[picture p67: schematic EQ Stage.kicad_sch]

Parts:
C85, C87, C88, C91: 0.1u COG; CAPC3216X180N; Manufacturer_Part_Number GRM31C5C1H104JA01L; Mouser Part Number 81-GRM31C5C1H104JA1L
C86: 0.15u COG; C4532_Commercial; Manufacturer_Part_Number C4532C0G1H154J250KA
C89: 0.1uF; CAPC2012X95N; Manufacturer_Part_Number CL21B104KACNNNC; Mouser Part Number 187-CL21B104KACNNNC
C90: 0.47u COG; CAPC3216X180N; Manufacturer_Part_Number GRM31C5C1E474JE01L; Mouser Part Number 81-GRM31C5C1E474JE1L
IC26: OPA1644AIDR; SOIC127P600X175-14N; Manufacturer_Part_Number OPA1644AIDR; Mouser Part Number 595-OPA1644AIDR
R94: 2.1k; RESC2012X60N; Manufacturer_Part_Number RC0805FR-072K1L
R99, R100: 2.94k; RESC2012X60N; Manufacturer_Part_Number RC0805FR-072K94L; Mouser Part Number 603-RC0805FR-072K94L
R101: 3.57k; RESC2012X60N; Manufacturer_Part_Number RC0805FR-073K57L; Mouser Part Number 603-RC0805FR-073K57L
R102, R103: 1.33k; RESC2012X60N; Manufacturer_Part_Number RC0805FR-071K33L; Mouser Part Number 603-RC0805FR-071K33L

Connections:
GND: C87.2, C88.1, C89.2, C91.2, IC26.11 (V-)
unnamed: C85.1, R99.2, R101.1
unnamed: C85.2, IC26.6 (-IN_B), IC26.7 (OUT_B), R94.1
unnamed: C86.1, R94.2, R100.1
unnamed: C86.2, IC26.1 (OUT_A), IC26.2 (-IN_A), R102.1
unnamed: C87.1, IC26.5 (+_IN_B), R101.2
unnamed: C88.2, IC26.3 (+IN_A), R100.2
unnamed: C89.1, IC26.4 (V+)
unnamed: C90.1, R102.2, R103.1
unnamed: C90.2, IC26.13 (-IN_D), IC26.14 (OUT_D)
unnamed: C91.1, IC26.12 (+IN_D), R103.2
SIG EQ L: R99.1
