Alex-Wolfe/Home-Audio-System/Hardware/Design/Main Board/Native Kicad/FM Radio.kicad_sch

## KiCad design Hardware/Design/Main Board/Native Kicad/FM Radio.kicad_sch (2025-06-05)

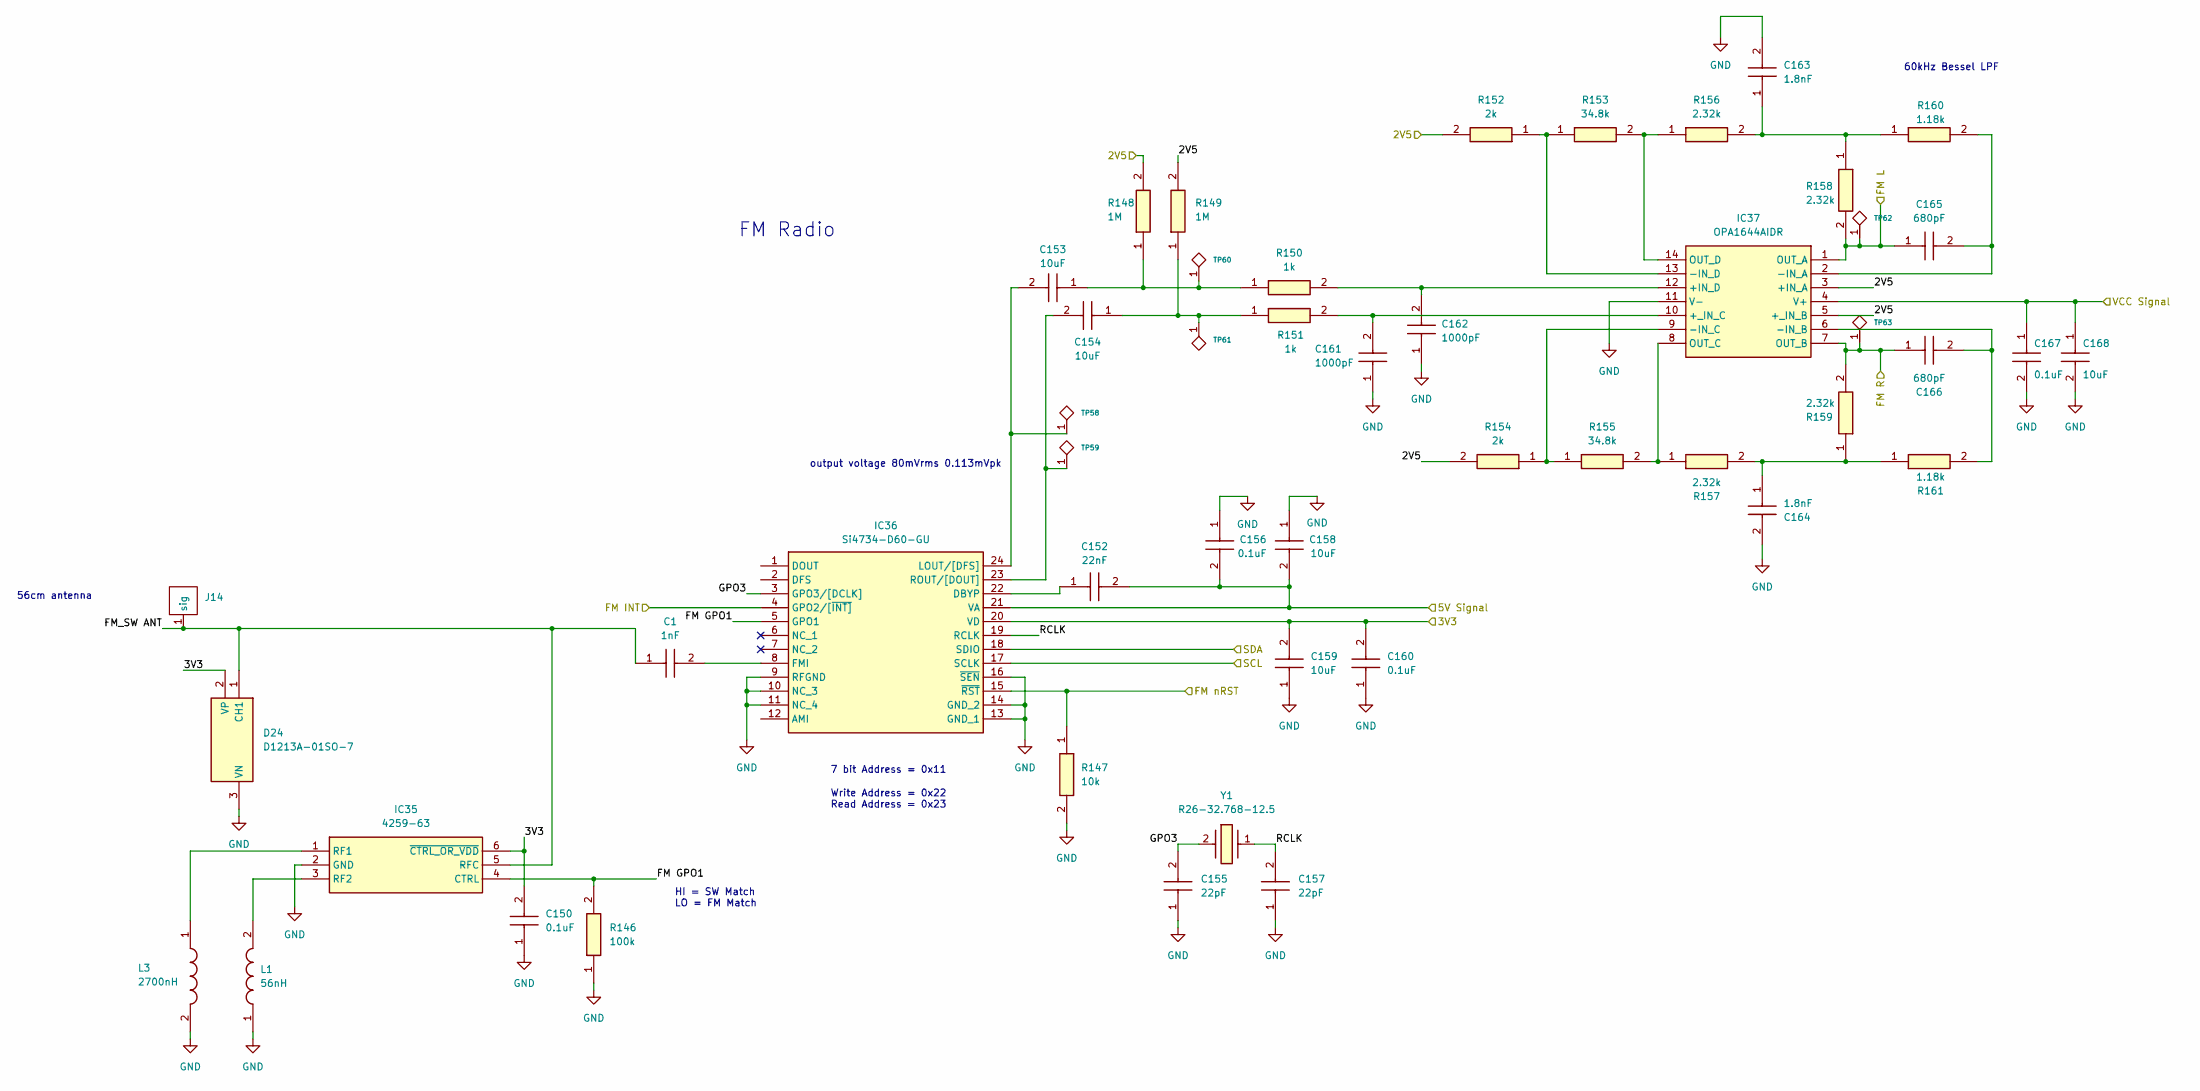
[picture p68: schematic FM Radio.kicad_sch]

Parts:
C1: 1nF; CAPC1608X90N; Manufacturer_Part_Number GRM1885C1H102JA01D; Mouser Part Number 81-GRM39C102J50
C150, C156, C160: 0.1uF; CAPC1608X90N; Manufacturer_Part_Number CC0603KRX7R7BB104; Mouser Part Number 603-CC603KRX7R7BB104
C152: 22nF; CAPC1608X90N; Manufacturer_Part_Number CL10B223KB8NNNC; Mouser Part Number 187-CL10B223KB8NNNC
C153, C154, C158, C159: 10uF; CAPC2012X145N; Manufacturer_Part_Number GRM21BR61C106KE15K; Mouser Part Number 81-GRM21BR61C106KE5K
C155, C157: 22pF; CAPC1608X90N; Manufacturer_Part_Number CL10C220JB81PNC; Mouser Part Number N/A
C161, C162: 1000pF; CAPC1608X87N; Manufacturer_Part_Number C0603C102K3GACTU; Mouser Part Number 80-C0603C102K3G
C163, C164: 1.8nF; CAPC1608X90N; Manufacturer_Part_Number GRM1885C1H182JA01J; Mouser Part Number 81-GRM1885C1H182JA1J
C165, C166: 680pF; CAPC1608X87N; Manufacturer_Part_Number 885012006062; Mouser Part Number 710-885012006062
C167: 0.1uF; C0603; Manufacturer_Part_Number C0603C104M5RACTU; Mouser Part Number 80-C0603C104M5R
C168: 10uF; GRM21x; Manufacturer_Part_Number GRM21BR61H106KE43L; Mouser Part Number 81-GRM21BR61H106KE3L
D24: D1213A-01SO-7; D1213A01SO7; Manufacturer_Part_Number D1213A-01SO-7; Mouser Part Number 621-D1213A-01SO-7
IC35: 4259-63; SOT65P210X110-6N; Manufacturer_Part_Number 4259-63; Mouser Part Number 81-4259-63
IC36: Si4734-D60-GU; SOP64P600X175-24N; Manufacturer_Part_Number Si4734-D60-GU; Mouser Part Number N/A
IC37: OPA1644AIDR; SOIC127P600X175-14N; Manufacturer_Part_Number OPA1644AIDR; Mouser Part Number 595-OPA1644AIDR
J14: ant hole
L1: 56nH; LQW18AS10NG0CD; Manufacturer_Part_Number LQW18AN56NJ00D; Mouser Part Number 81-LQW18AN56NJ00D
L3: 2700nH; LQW2UAS12NG00L; Manufacturer_Part_Number LQW2UAS2R7J00L; Mouser Part Number 81-LQW2UAS2R7J00L
R146: 100k; RESC1608X55N; Manufacturer_Part_Number RC0603FR-07100KL; Mouser Part Number 603-RC0603FR-07100KL
R147: 10k; RESC1608X55N; Manufacturer_Part_Number RC0603FR-0710KL; Mouser Part Number 603-RC0603FR-0710KL
R148, R149: 1M; RESC1608X55N; Manufacturer_Part_Number RT0603FRD071ML; Mouser Part Number 603-RT0603FRD071ML
R150, R151: 1k; ERA3AEB101V; Manufacturer_Part_Number ERA-3AEB102V; Mouser Part Number 667-ERA-3AEB102V
R152, R154: 2k; ERA3AEB101V; Manufacturer_Part_Number ERA-3AEB202V; Mouser Part Number 667-ERA-3AEB202V
R153, R155: 34.8k; ERA3AEB101V; Manufacturer_Part_Number ERA-3AEB3482V; Mouser Part Number 667-ERA-3AEB3482V
R156, R157, R158, R159: 2.32k; ERA3AEB101V; Manufacturer_Part_Number ERA-3AEB2321V; Mouser Part Number 667-ERA-3AEB2321V
R160, R161: 1.18k; ERA3AEB101V; Manufacturer_Part_Number ERA-3AEB1181V; Mouser Part Number 667-ERA-3AEB1181V
TP58, TP59, TP60, TP61, TP62, TP63: TP
Y1: R26-32.768-12.5; R2632768125; Manufacturer_Part_Number R26-32.768-12.5

Connections:
2V5: IC37.3 (+IN_A), IC37.5 (+_IN_B), R148.2, R149.2, R152.2, R154.2
3V3: C150.2, C159.2, C160.2, D24.2 (VP), IC35.6 (~CTRL_OR_VDD), IC36.20 (VD)
5V Signal: C152.2, C156.2, C158.2, IC36.21 (VA)
FM GPO1: IC35.4 (CTRL), IC36.5 (GPO1), R146.2
FM INT: IC36.4 (GPO2/[~INT])
FM L: C165.1, IC37.1 (OUT_A), R158.2, TP62.1
FM R: C166.1, IC37.7 (OUT_B), R159.2, TP63.1
FM nRST: IC36.15 (~RST), R147.1
FM_SW ANT: C1.1, D24.1 (CH1), IC35.5 (RFC), J14.1
GND: C150.1, C155.1, C156.1, C157.1, C158.1, C159.1, C160.1, C161.1, C162.1, C163.2, C164.2, C167.2, C168.2, D24.3 (VN), IC35.2 (GND), IC36.9 (RFGND), IC36.10 (NC_3), IC36.11 (NC_4), IC36.13 (GND_1), IC36.14 (GND_2), IC36.16 (~SEN), IC37.11 (V-), L1.1, L3.2, R146.1, R147.2
GPO3: C155.2, IC36.3 (GPO3/[DCLK]), Y1.2 (CRYSTAL_2)
unnamed: C1.2, IC36.8 (FMI)
unnamed: C152.1, IC36.22 (DBYP)
unnamed: C153.1, R148.1, R150.1, TP60.1
unnamed: C153.2, IC36.24 (LOUT/[DFS]), TP58.1
unnamed: C154.1, R149.1, R151.1, TP61.1
unnamed: C154.2, IC36.23 (ROUT/[DOUT]), TP59.1
unnamed: C161.2, IC37.10 (+_IN_C), R151.2
unnamed: C162.2, IC37.12 (+IN_D), R150.2
unnamed: C163.1, R156.2, R158.1, R160.1
unnamed: C164.1, R157.2, R159.1, R161.1
unnamed: C165.2, IC37.2 (-IN_A), R160.2
unnamed: C166.2, IC37.6 (-IN_B), R161.2
unnamed: IC35.1 (RF1), L3.1
unnamed: IC35.3 (RF2), L1.2
unnamed: IC37.8 (OUT_C), R155.2, R157.1
unnamed: IC37.9 (-IN_C), R154.1, R155.1
unnamed: IC37.13 (-IN_D), R152.1, R153.1
unnamed: IC37.14 (OUT_D), R153.2, R156.1
RCLK: C157.2, IC36.19 (RCLK), Y1.1
SCL: IC36.17 (SCLK)
SDA: IC36.18 (SDIO)
VCC Signal: C167.1, C168.1, IC37.4 (V+)

Notes on the sheet:
output voltage 80mVrms 0.113mVpk
60kHz Bessel LPF
56cm antenna
7 bit Address = 0x11
HI = SW Match LO = FM Match
FM Radio
Write Address = 0x22 Read Address = 0x23
