Alex-Wolfe/Home-Audio-System/Hardware/Design/Main Board/Native Kicad/Fan Drivers.kicad_sch

## KiCad design Hardware/Design/Main Board/Native Kicad/Fan Drivers.kicad_sch (2025-06-05)

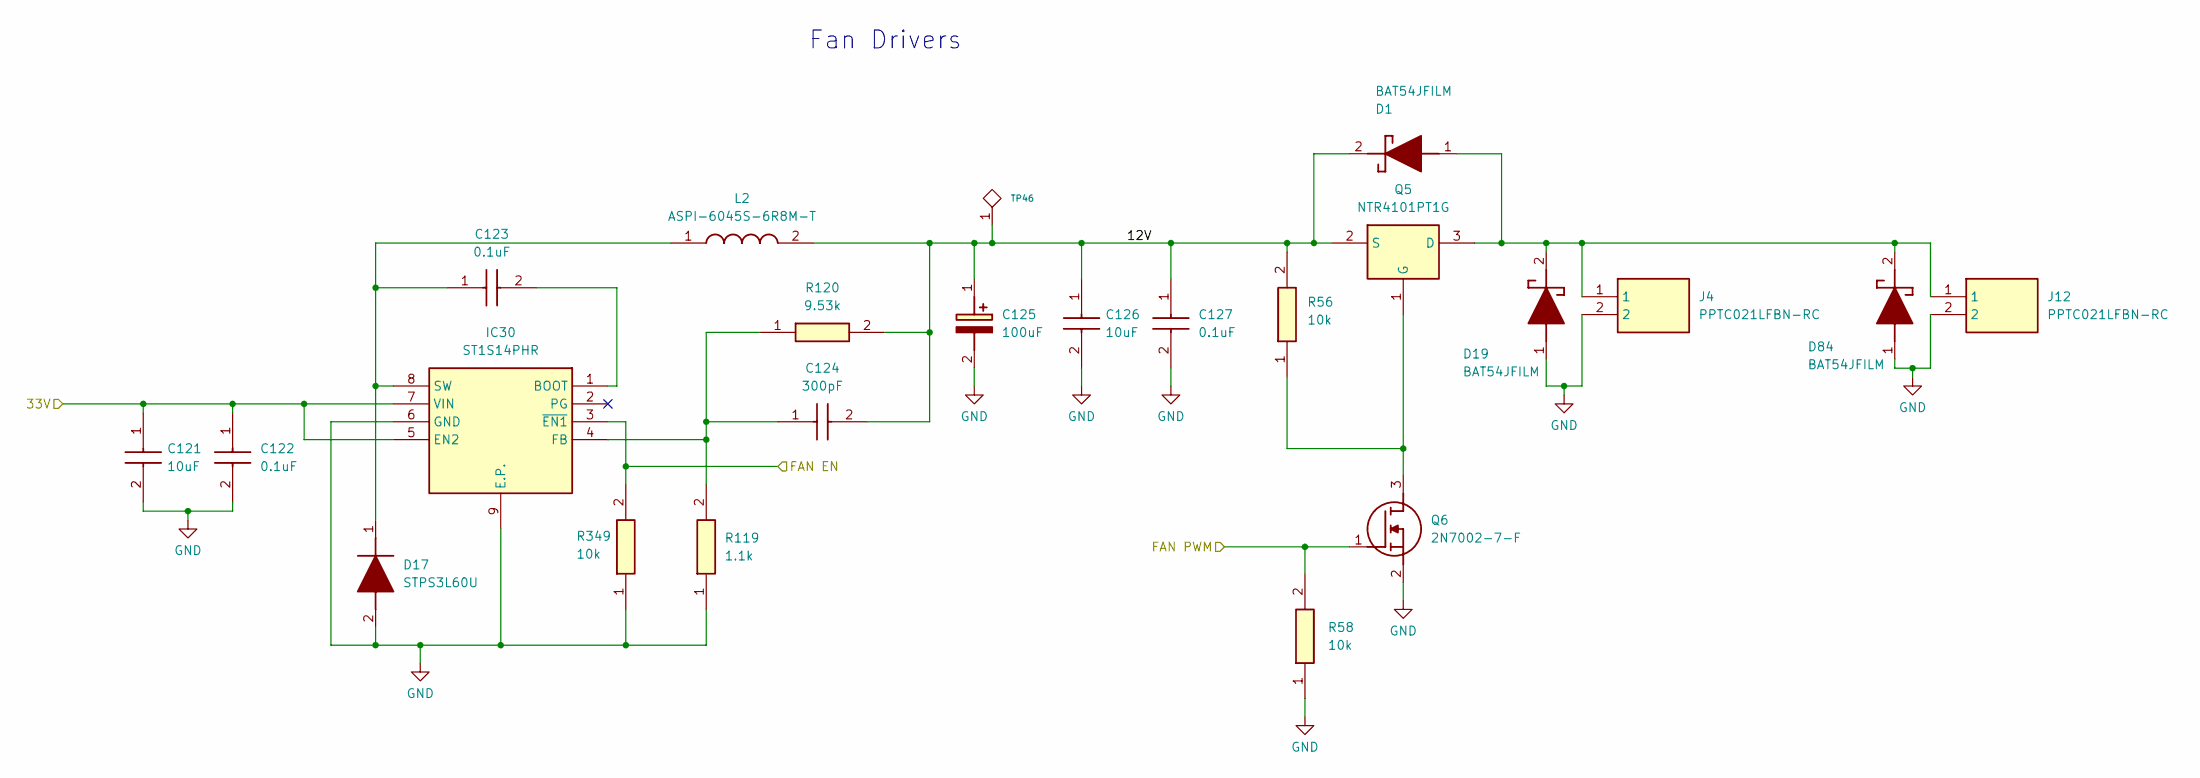
[picture p69: schematic Fan Drivers.kicad_sch]

Parts:
C121, C126: 10uF; CAPC3216X180N; Manufacturer_Part_Number CL31A106MBHNNNE; Mouser Part Number 187-CL31A106MBHNNNE
C122, C123, C127: 0.1uF; C0603; Manufacturer_Part_Number C0603C104M5RACTU; Mouser Part Number 80-C0603C104M5R
C124: 300pF; GCM155; Manufacturer_Part_Number GCM1555C1H301JA16D; Mouser Part Number 81-GCM1555C1H301JA6D
C125: 100uF; 865080343009; Manufacturer_Part_Number 865080343009; Mouser Part Number 710-865080343009
D1, D19, D84: BAT54JFILM; SOD2513X117N; Manufacturer_Part_Number BAT54JFILM; Mouser Part Number 511-BAT54JFILM
D17: STPS3L60U; SMBJ50CA; Manufacturer_Part_Number STPS3L60U; Mouser Part Number 511-STPS3L60U
IC30: ST1S14PHR; SOIC127P600X175-9N; Manufacturer_Part_Number ST1S14PHR; Mouser Part Number 511-ST1S14PHR
J4, J12: PPTC021LFBN-RC; RHDR2W80P0X254_1X2_558X254X850P; Manufacturer_Part_Number PPTC021LFBN-RC
L2: ASPI-6045S-6R8M-T; ASPI-6045S; Manufacturer_Part_Number ASPI-6045S-6R8M-T; Mouser Part Number 815-ASPI-6045S-6R8MT
Q5: NTR4101PT1G; SOT96P237X111-3N; Manufacturer_Part_Number NTR4101PT1G; Mouser Part Number 863-NTR4101PT1G
Q6: 2N7002-7-F; SOT96P240X120-3N; Manufacturer_Part_Number 2N7002-7-F; Mouser Part Number 621-2N7002-F
R56, R58, R349: 10k; RESC1608X55N; Manufacturer_Part_Number RC0603FR-0710KL; Mouser Part Number 603-RC0603FR-0710KL
R119: 1.1k; RESC1608X55N; Manufacturer_Part_Number RC0603FR-071K1L; Mouser Part Number 603-RC0603FR-071K1L
R120: 9.53k; RESC1608X55N; Manufacturer_Part_Number RC0603FR-079K53L; Mouser Part Number 603-RC0603FR-079K53L
TP46: TP

Connections:
12V: C124.2, C125.1 (+), C126.1, C127.1, D1.2 (K), L2.2, Q5.2 (S), R56.2, R120.2, TP46.1
33V: C121.1, C122.1, IC30.5 (EN2), IC30.7 (VIN)
FAN EN: IC30.3 (~EN1), R349.2
FAN PWM: Q6.1 (G), R58.2
GND: C121.2, C122.2, C125.2 (-), C126.2, C127.2, D17.2 (A), D19.1 (A), D84.1 (A), IC30.6 (GND), IC30.9 (E.P.), J4.2, J12.2, Q6.2 (S), R58.1, R119.1, R349.1
unnamed: C123.1, D17.1 (K), IC30.8 (SW), L2.1
unnamed: C123.2, IC30.1 (BOOT)
unnamed: C124.1, IC30.4 (FB), R119.2, R120.1
unnamed: D1.1 (A), D19.2 (K), D84.2 (K), J4.1, J12.1, Q5.3 (D)
unnamed: Q5.1 (G), Q6.3 (D), R56.1

Notes on the sheet:
Fan Drivers
