Alex-Wolfe/Home-Audio-System/Hardware/Design/Main Board/Native Kicad/Fan Power Supply.kicad_sch

## KiCad design Hardware/Design/Main Board/Native Kicad/Fan Power Supply.kicad_sch (2025-06-05)

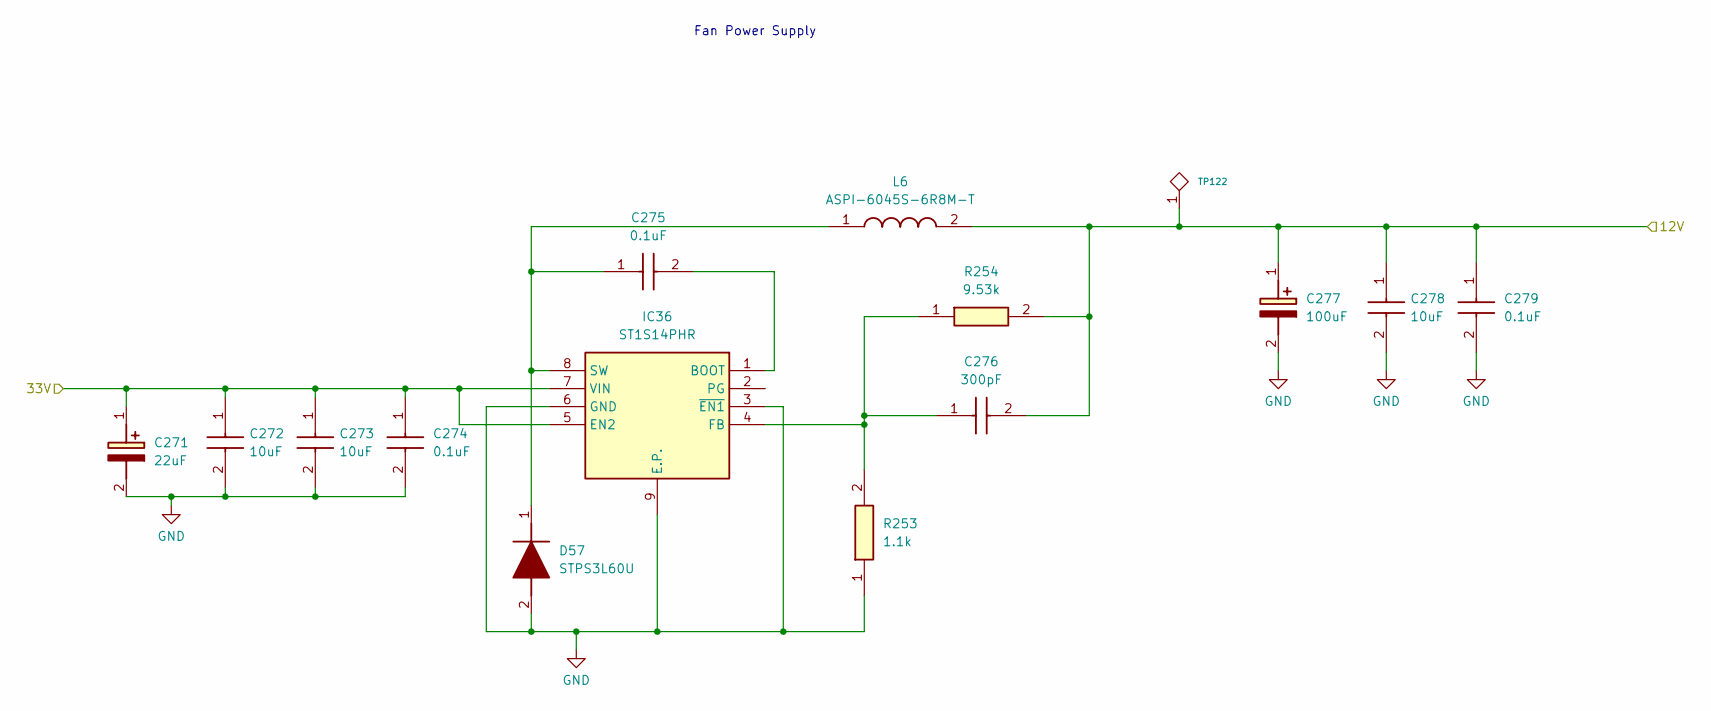
[picture p70: schematic Fan Power Supply.kicad_sch]

Parts:
C271: 22uF; CAPPRD200W55D500H1250; Manufacturer_Part_Number EEU-FR1H100B; Mouser Part Number 667-EEU-FR1H100B
C272, C273, C278: 10uF; CAPC3216X180N; Manufacturer_Part_Number CL31A106MBHNNNE; Mouser Part Number 187-CL31A106MBHNNNE
C274, C275, C279: 0.1uF; C0603; Manufacturer_Part_Number C0603C104M5RACTU; Mouser Part Number 80-C0603C104M5R
C276: 300pF; GCM155; Manufacturer_Part_Number GCM1555C1H301JA16D; Mouser Part Number 81-GCM1555C1H301JA6D
C277: 100uF; 865080343009; Manufacturer_Part_Number 865080343009; Mouser Part Number 710-865080343009
D57: STPS3L60U; SMBJ50CA; Manufacturer_Part_Number STPS3L60U; Mouser Part Number 511-STPS3L60U
IC36: ST1S14PHR; SOIC127P600X175-9N; Manufacturer_Part_Number ST1S14PHR; Mouser Part Number 511-ST1S14PHR
L6: ASPI-6045S-6R8M-T; ASPI-6045S; Manufacturer_Part_Number ASPI-6045S-6R8M-T; Mouser Part Number 815-ASPI-6045S-6R8MT
R253: 1.1k; RESC1608X55N; Manufacturer_Part_Number RC0603FR-071K1L; Mouser Part Number 603-RC0603FR-071K1L
R254: 9.53k; RESC1608X55N; Manufacturer_Part_Number RC0603FR-079K53L; Mouser Part Number 603-RC0603FR-079K53L
TP122: TP

Connections:
12V: C276.2, C277.1 (+), C278.1, C279.1, L6.2, R254.2, TP122.1
33V: C271.1 (+), C272.1, C273.1, C274.1, IC36.5 (EN2), IC36.7 (VIN)
GND: C271.2 (-), C272.2, C273.2, C274.2, C277.2 (-), C278.2, C279.2, D57.2 (A), IC36.3 (~EN1), IC36.6 (GND), IC36.9 (E.P.), R253.1
unnamed: C275.1, D57.1 (K), IC36.8 (SW), L6.1
unnamed: C275.2, IC36.1 (BOOT)
unnamed: C276.1, IC36.4 (FB), R253.2, R254.1

Notes on the sheet:
Fan Power Supply
