Alex-Wolfe/Home-Audio-System/Hardware/Design/Main Board/Native Kicad/Front Board Connector.kicad_sch

## KiCad design Hardware/Design/Main Board/Native Kicad/Front Board Connector.kicad_sch (2025-06-05)

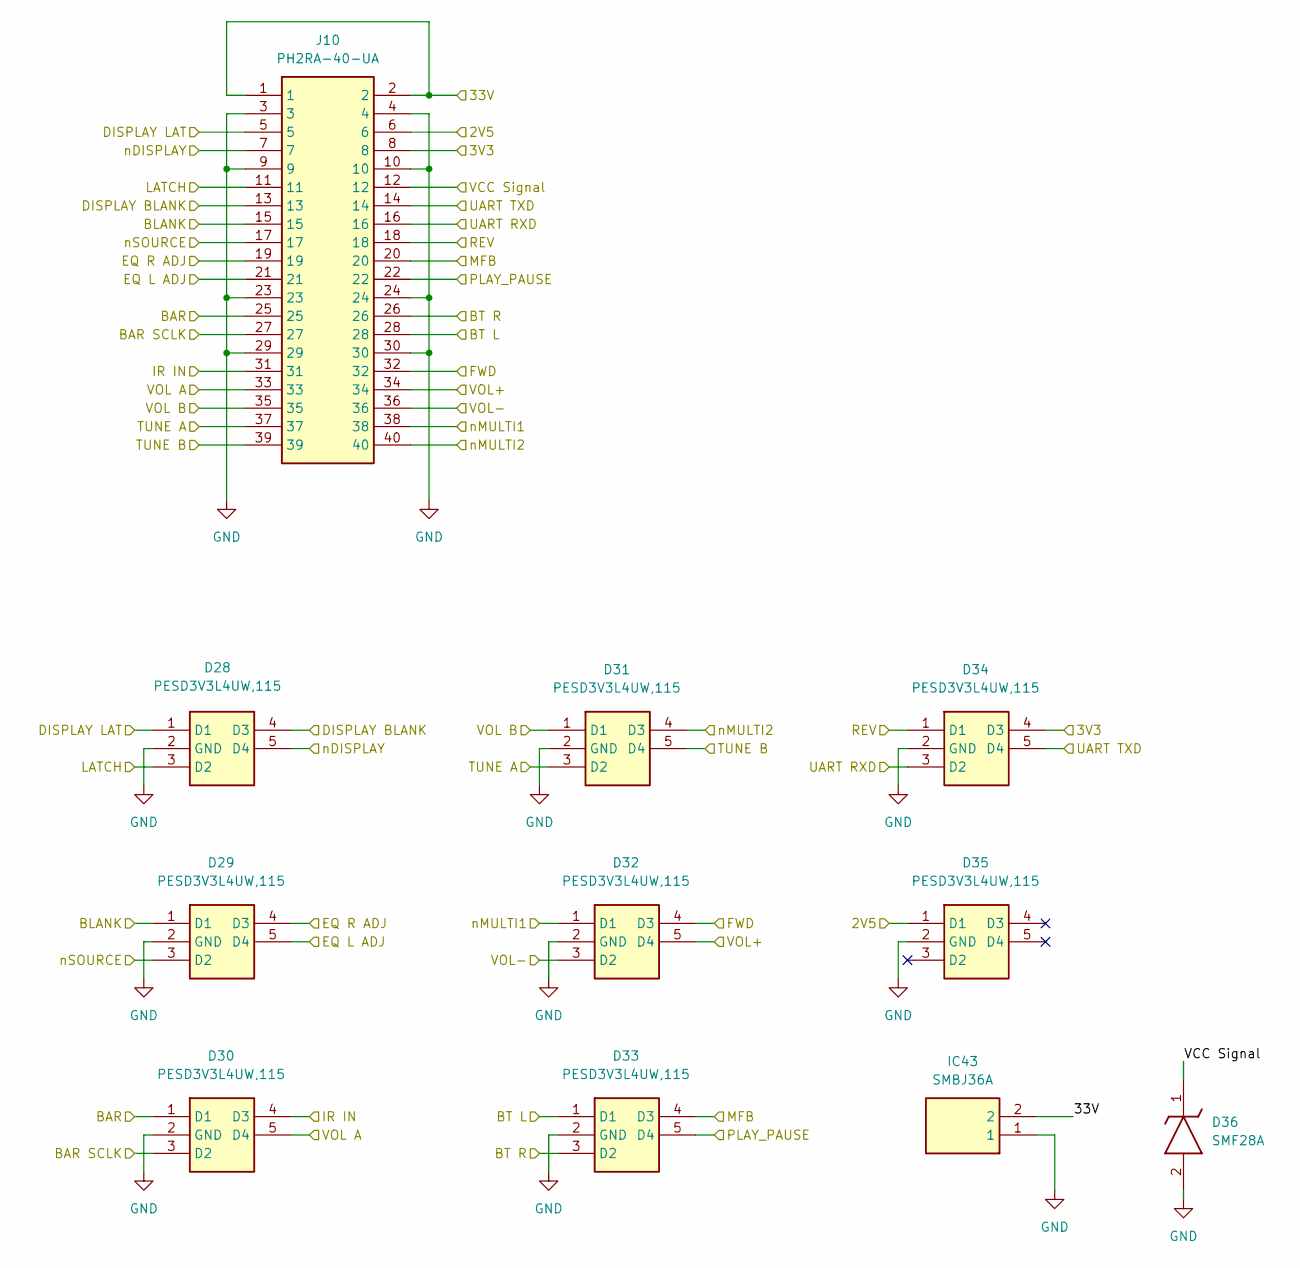
[picture p71: schematic Front Board Connector.kicad_sch]

Parts:
D28, D29, D30, D31, D32, D33, D34, D35: PESD3V3L4UW,115; PESD3V3L4UW115; Manufacturer_Part_Number PESD3V3L4UW,115; Mouser Part Number 771-PESD3V3L4UW115
D36: SMF28A; SODFL3618X110N; Manufacturer_Part_Number SMF28A; Mouser Part Number 576-SMF28A
IC43: SMBJ36A; Manufacturer_Part_Number SMBJ36A; Mouser Part Number 512-SMBJ36A
J10: PH2RA-40-UA; HDRRA40W64P254_2X20_5080X250X500P; Manufacturer_Part_Number PH2RA-40-UA; Mouser Part Number 737-PH2RA-40-UA

Connections:
2V5: D35.1 (D1), J10.6
3V3: D34.4 (D3), J10.8
33V: IC43.2, J10.1, J10.2
BAR: D30.1 (D1), J10.25
BAR SCLK: D30.3 (D2), J10.27
BLANK: D29.1 (D1), J10.15
BT L: D33.1 (D1), J10.28
BT R: D33.3 (D2), J10.26
DISPLAY BLANK: D28.4 (D3), J10.13
DISPLAY LAT: D28.1 (D1), J10.5
EQ L ADJ: D29.5 (D4), J10.21
EQ R ADJ: D29.4 (D3), J10.19
FWD: D32.4 (D3), J10.32
GND: D28.2 (GND), D29.2 (GND), D30.2 (GND), D31.2 (GND), D32.2 (GND), D33.2 (GND), D34.2 (GND), D35.2 (GND), D36.2 (A), IC43.1, J10.3, J10.4, J10.9, J10.10, J10.23, J10.24, J10.29, J10.30
IR IN: D30.4 (D3), J10.31
LATCH: D28.3 (D2), J10.11
MFB: D33.4 (D3), J10.20
PLAY_PAUSE: D33.5 (D4), J10.22
REV: D34.1 (D1), J10.18
TUNE A: D31.3 (D2), J10.37
TUNE B: D31.5 (D4), J10.39
UART RXD: D34.3 (D2), J10.16
UART TXD: D34.5 (D4), J10.14
VCC Signal: D36.1 (K), J10.12
VOL A: D30.5 (D4), J10.33
VOL B: D31.1 (D1), J10.35
VOL+: D32.5 (D4), J10.34
VOL-: D32.3 (D2), J10.36
nDISPLAY: D28.5 (D4), J10.7
nMULTI1: D32.1 (D1), J10.38
nMULTI2: D31.4 (D3), J10.40
nSOURCE: D29.3 (D2), J10.17
