Alex-Wolfe/Home-Audio-System/Hardware/Design/Main Board/Native Kicad/Front Board.kicad_sch

## KiCad design Hardware/Design/Main Board/Native Kicad/Front Board.kicad_sch (2025-06-05)

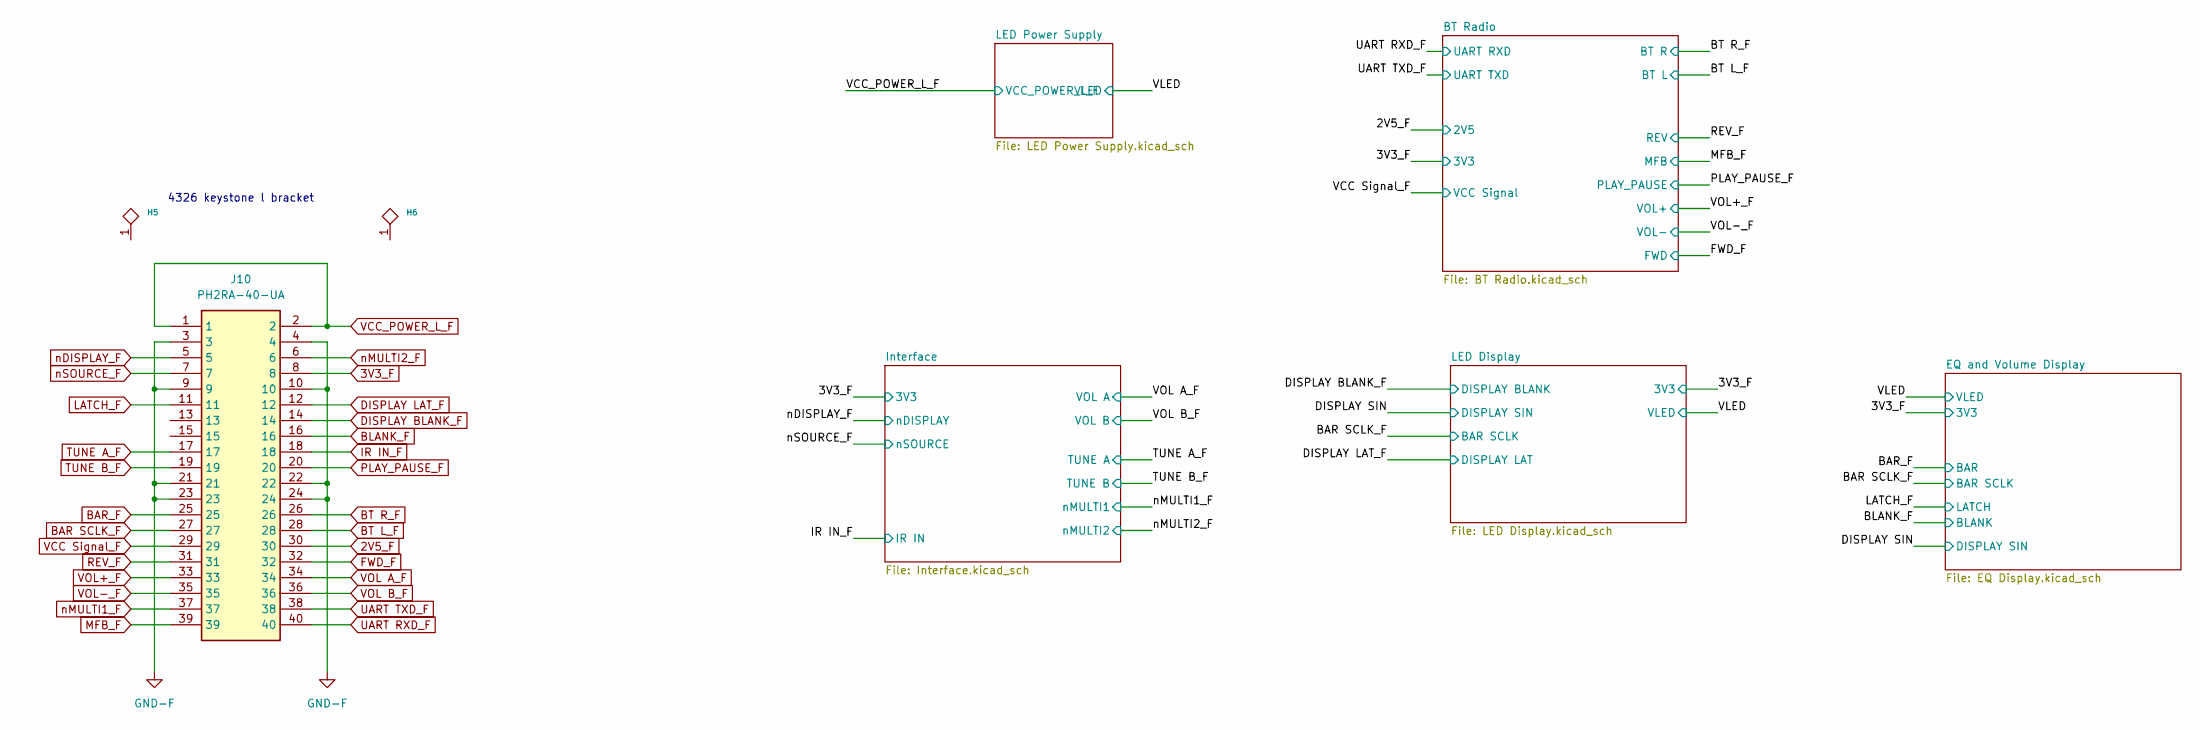
[picture p72: schematic Front Board.kicad_sch]

Parts:
H5, H6: MountingHole_3.7mm_Pad_TopBottom
J10: PH2RA-40-UA; HDRRA40W64P254_2X20_5080X250X500P; Manufacturer_Part_Number PH2RA-40-UA; Mouser Part Number 737-PH2RA-40-UA

Connections:
2V5_F: J10.30
3V3_F: J10.8
BAR SCLK_F: J10.27
BAR_F: J10.25
BLANK_F: J10.16
BT L_F: J10.28
BT R_F: J10.26
DISPLAY BLANK_F: J10.14
DISPLAY LAT_F: J10.12
FWD_F: J10.32
GND-F: J10.3, J10.4, J10.9, J10.10, J10.21, J10.22, J10.23, J10.24
IR IN_F: J10.18
LATCH_F: J10.11
MFB_F: J10.39
PLAY_PAUSE_F: J10.20
REV_F: J10.31
TUNE A_F: J10.17
TUNE B_F: J10.19
UART RXD_F: J10.40
UART TXD_F: J10.38
VCC Signal_F: J10.29
VCC_POWER_L_F: J10.1, J10.2
VOL A_F: J10.34
VOL B_F: J10.36
VOL+_F: J10.33
VOL-_F: J10.35
nDISPLAY_F: J10.5
nMULTI1_F: J10.37
nMULTI2_F: J10.6
nSOURCE_F: J10.7

Notes on the sheet:
4326 keystone l bracket
