Alex-Wolfe/Home-Audio-System/Hardware/Design/Main Board/Native Kicad/High Gain Stage.kicad_sch

## KiCad design Hardware/Design/Main Board/Native Kicad/High Gain Stage.kicad_sch (2025-06-05)

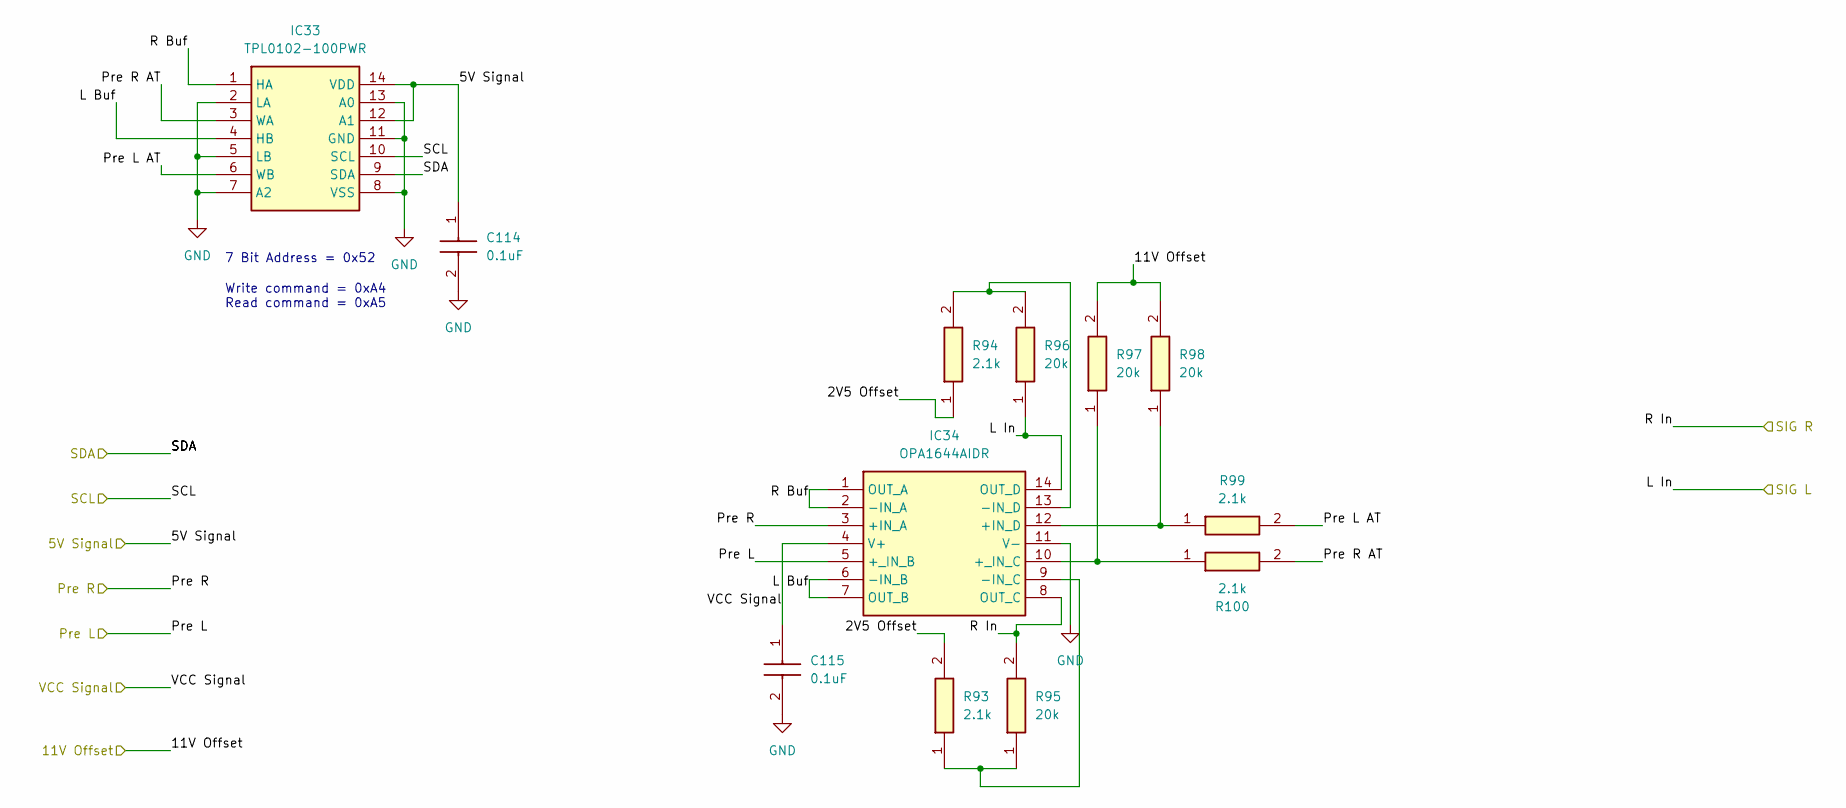
[picture p73: schematic High Gain Stage.kicad_sch]

Parts:
C114, C115: 0.1uF; CAPC2012X95N; Manufacturer_Part_Number CL21B104KACNNNC; Mouser Part Number 187-CL21B104KACNNNC
IC33: TPL0102-100PWR; SOP65P640X120-14N; Manufacturer_Part_Number TPL0102-100PWR; Mouser Part Number 595-TPL0102-100PWR
IC34: OPA1644AIDR; SOIC127P600X175-14N; Manufacturer_Part_Number OPA1644AIDR; Mouser Part Number 595-OPA1644AIDR
R93, R94, R99, R100: 2.1k; ERA6AEB1020V; Manufacturer_Part_Number ERA-6AEB2101V; Mouser Part Number 667-ERA-6AEB2101V
R95, R96, R97, R98: 20k; ERA6AEB1020V; Manufacturer_Part_Number ERA-6AEB203V; Mouser Part Number 667-ERA-6AEB203V

Connections:
2V5 Offset: R93.2, R94.1
5V Signal: C114.1, IC33.12 (A1), IC33.14 (VDD)
11V Offset: R97.2, R98.2
GND: C114.2, C115.2, IC33.2 (LA), IC33.5 (LB), IC33.7 (A2), IC33.8 (VSS), IC33.11 (GND), IC33.13 (A0), IC34.11 (V-)
L Buf: IC33.4 (HB), IC34.6 (-IN_B), IC34.7 (OUT_B)
L In: IC34.14 (OUT_D), R96.1
unnamed: IC34.9 (-IN_C), R93.1, R95.1
unnamed: IC34.10 (+_IN_C), R97.1, R100.1
unnamed: IC34.12 (+IN_D), R98.1, R99.1
unnamed: IC34.13 (-IN_D), R94.2, R96.2
Pre L: IC34.5 (+_IN_B)
Pre L AT: IC33.6 (WB), R99.2
Pre R: IC34.3 (+IN_A)
Pre R AT: IC33.3 (WA), R100.2
R Buf: IC33.1 (HA), IC34.1 (OUT_A), IC34.2 (-IN_A)
R In: IC34.8 (OUT_C), R95.2
SCL: IC33.10 (SCL)
SDA: IC33.9 (SDA)
VCC Signal: C115.1, IC34.4 (V+)

Notes on the sheet:
7 Bit Address = 0x52
Write command = 0xA4 Read command = 0xA5
