Alex-Wolfe/Home-Audio-System/Hardware/Design/Main Board/Native Kicad/Interface.kicad_sch

## KiCad design Hardware/Design/Main Board/Native Kicad/Interface.kicad_sch (2025-06-05)

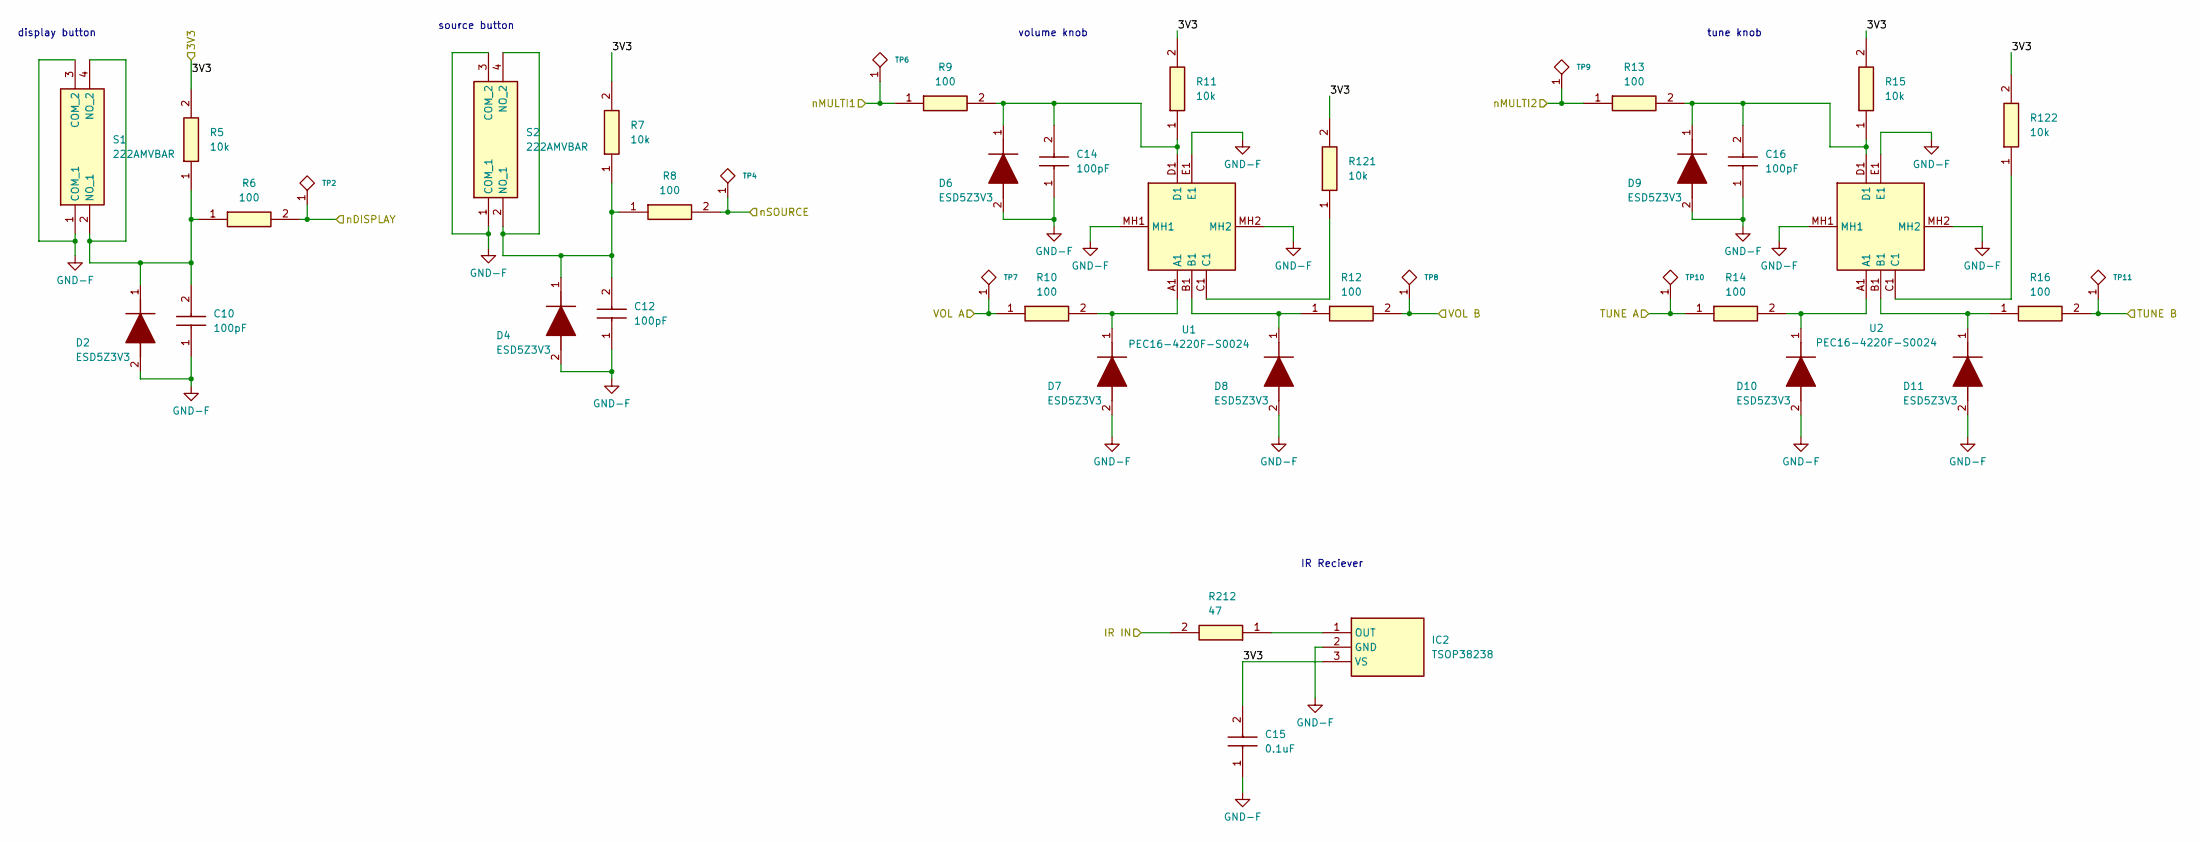
[picture p74: schematic Interface.kicad_sch]

Parts:
C10, C12, C14, C16: 100pF; CAPC1608X87N; Manufacturer_Part_Number CC0603JRNPO9BN101; Mouser Part Number 603-CC603JRNPO9BN101
C15: 0.1uF; CAPC1608X90N; Manufacturer_Part_Number CC0603KRX7R7BB104; Mouser Part Number 603-CC603KRX7R7BB104
D2, D4, D6, D7, D8, D9, D10, D11: ESD5Z3V3; SODFL1608X70N; Manufacturer_Part_Number ESD5Z3V3; Mouser Part Number 637-ESD5Z3V3
IC2: TSOP38238; Manufacturer_Part_Number TSOP38238; Mouser Part Number 782-TSOP38238
R5, R7, R11, R15, R121, R122: 10k; RESC1608X55N; Manufacturer_Part_Number RC0603FR-0710KL; Mouser Part Number 603-RC0603FR-0710KL
R6, R8, R9, R10, R12, R13, R14, R16: 100; RESC1608X55N; Manufacturer_Part_Number RC0603FR-07100RL; Mouser Part Number 603-RC0603FR-07100RL
R212: 47; RESC1608X55N; Manufacturer_Part_Number RC0603FR-0747RL; Mouser Part Number 603-RC0603FR-0747RL
S1, S2: 222AMVBAR; Manufacturer_Part_Number 222AMVBAR; Mouser Part Number 774-222AMVBAR
TP2, TP4, TP6, TP7, TP8, TP9, TP10, TP11: TP
U1, U2: PEC16-4220F-S0024; PEC164120FS0012; Manufacturer_Part_Number PEC16-4220F-S0024; Mouser Part Number 652-PEC16-4220FS0024

Connections:
3V3: C15.2, IC2.3 (VS), R5.2, R7.2, R11.2, R15.2, R121.2, R122.2
GND-F: C10.1, C12.1, C14.1, C15.1, C16.1, D2.2 (A), D4.2 (A), D6.2 (A), D7.2 (A), D8.2 (A), D9.2 (A), D10.2 (A), D11.2 (A), IC2.2 (GND), S1.1 (COM_1), S1.3 (COM_2), S2.1 (COM_1), S2.3 (COM_2), U1.E1, U1.MH1, U1.MH2, U2.E1, U2.MH1, U2.MH2
IR IN: R212.2
unnamed: C10.2, D2.1 (K), R5.1, R6.1, S1.2 (NO_1), S1.4 (NO_2)
unnamed: C12.2, D4.1 (K), R7.1, R8.1, S2.2 (NO_1), S2.4 (NO_2)
unnamed: C14.2, D6.1 (K), R9.2, R11.1, U1.D1
unnamed: C16.2, D9.1 (K), R13.2, R15.1, U2.D1
unnamed: D7.1 (K), R10.2, U1.A1
unnamed: D8.1 (K), R12.1, U1.B1
unnamed: D10.1 (K), R14.2, U2.A1
unnamed: D11.1 (K), R16.1, U2.B1
unnamed: IC2.1 (OUT), R212.1
unnamed: R121.1, U1.C1
unnamed: R122.1, U2.C1
TUNE A: R14.1, TP10.1
TUNE B: R16.2, TP11.1
VOL A: R10.1, TP7.1
VOL B: R12.2, TP8.1
nDISPLAY: R6.2, TP2.1
nMULTI1: R9.1, TP6.1
nMULTI2: R13.1, TP9.1
nSOURCE: R8.2, TP4.1

Notes on the sheet:
volume knob
display button
tune knob
source button
IR Reciever
