Alex-Wolfe/Home-Audio-System/Hardware/Design/Main Board/Native Kicad/Inverting Stage.kicad_sch

## KiCad design Hardware/Design/Main Board/Native Kicad/Inverting Stage.kicad_sch (2025-06-05)

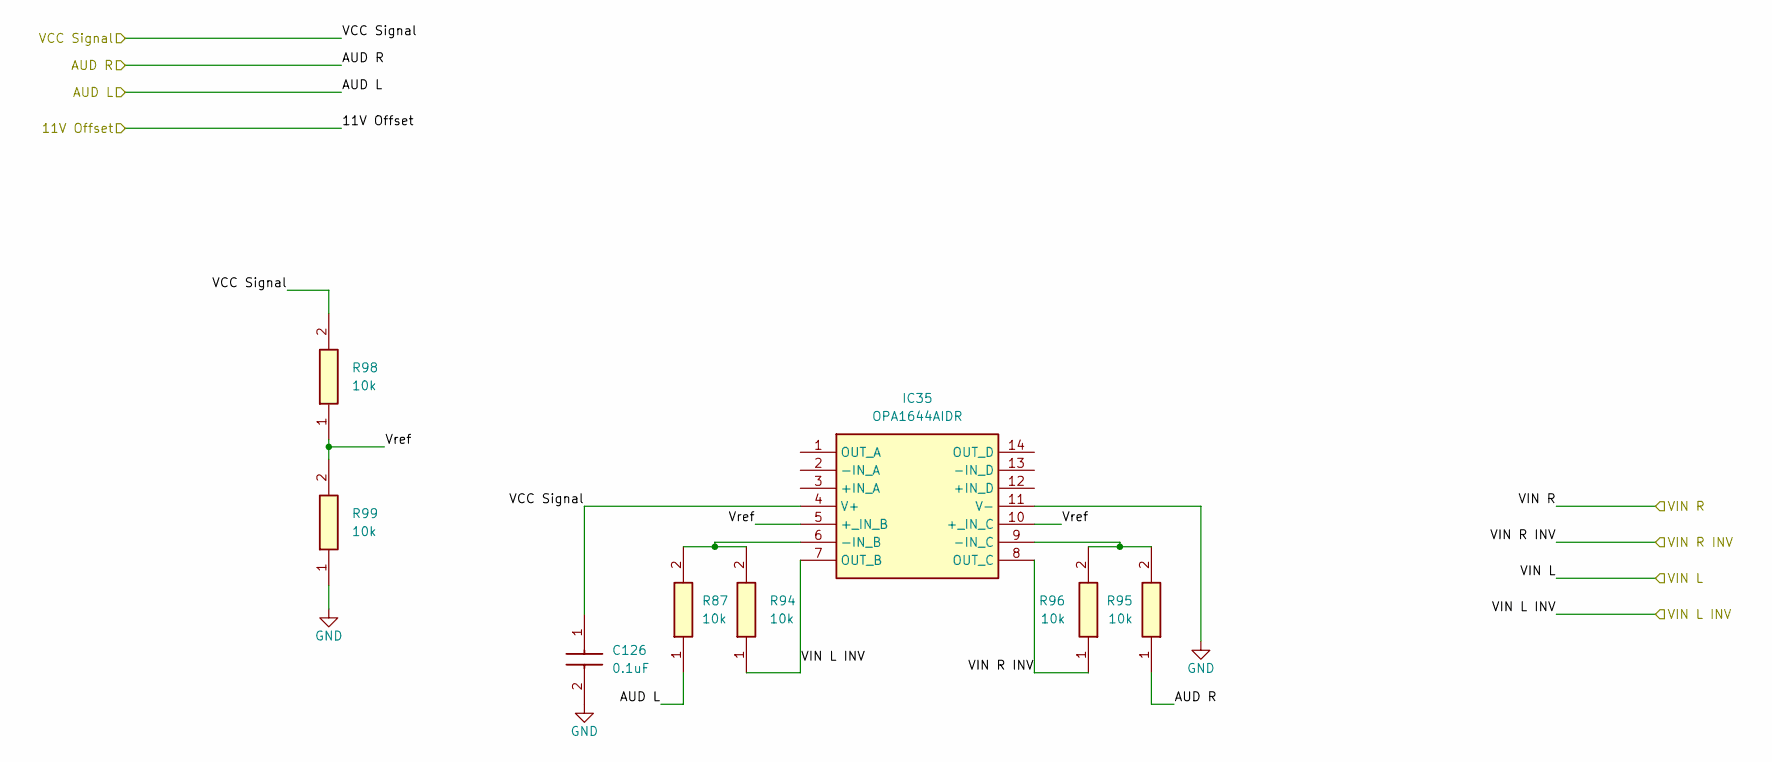
[picture p75: schematic Inverting Stage.kicad_sch]

Parts:
C126: 0.1uF; CAPC2012X95N; Manufacturer_Part_Number CL21B104KACNNNC; Mouser Part Number 187-CL21B104KACNNNC
IC35: OPA1644AIDR; SOIC127P600X175-14N; Manufacturer_Part_Number OPA1644AIDR; Mouser Part Number 595-OPA1644AIDR
R87, R94, R95, R96: 10k; RESC2012X60N; Manufacturer_Part_Number RC0805FR-0710KL; Mouser Part Number 603-RC0805FR-0710KL
R98, R99: 10k; ERA6AEB1020V; Manufacturer_Part_Number ERA-6AEB103V; Mouser Part Number 667-ERA-6AEB103V

Connections:
AUD L: R87.1
AUD R: R95.1
GND: C126.2, IC35.11 (V-), R99.1
unnamed: IC35.6 (-IN_B), R87.2, R94.2
unnamed: IC35.9 (-IN_C), R95.2, R96.2
VCC Signal: C126.1, IC35.4 (V+), R98.2
VIN L INV: IC35.7 (OUT_B), R94.1
VIN R INV: IC35.8 (OUT_C), R96.1
Vref: IC35.5 (+_IN_B), IC35.10 (+_IN_C), R98.1, R99.2
