Alex-Wolfe/Home-Audio-System/Hardware/Design/Main Board/Native Kicad/LED Display.kicad_sch

## KiCad design Hardware/Design/Main Board/Native Kicad/LED Display.kicad_sch (2025-06-05)

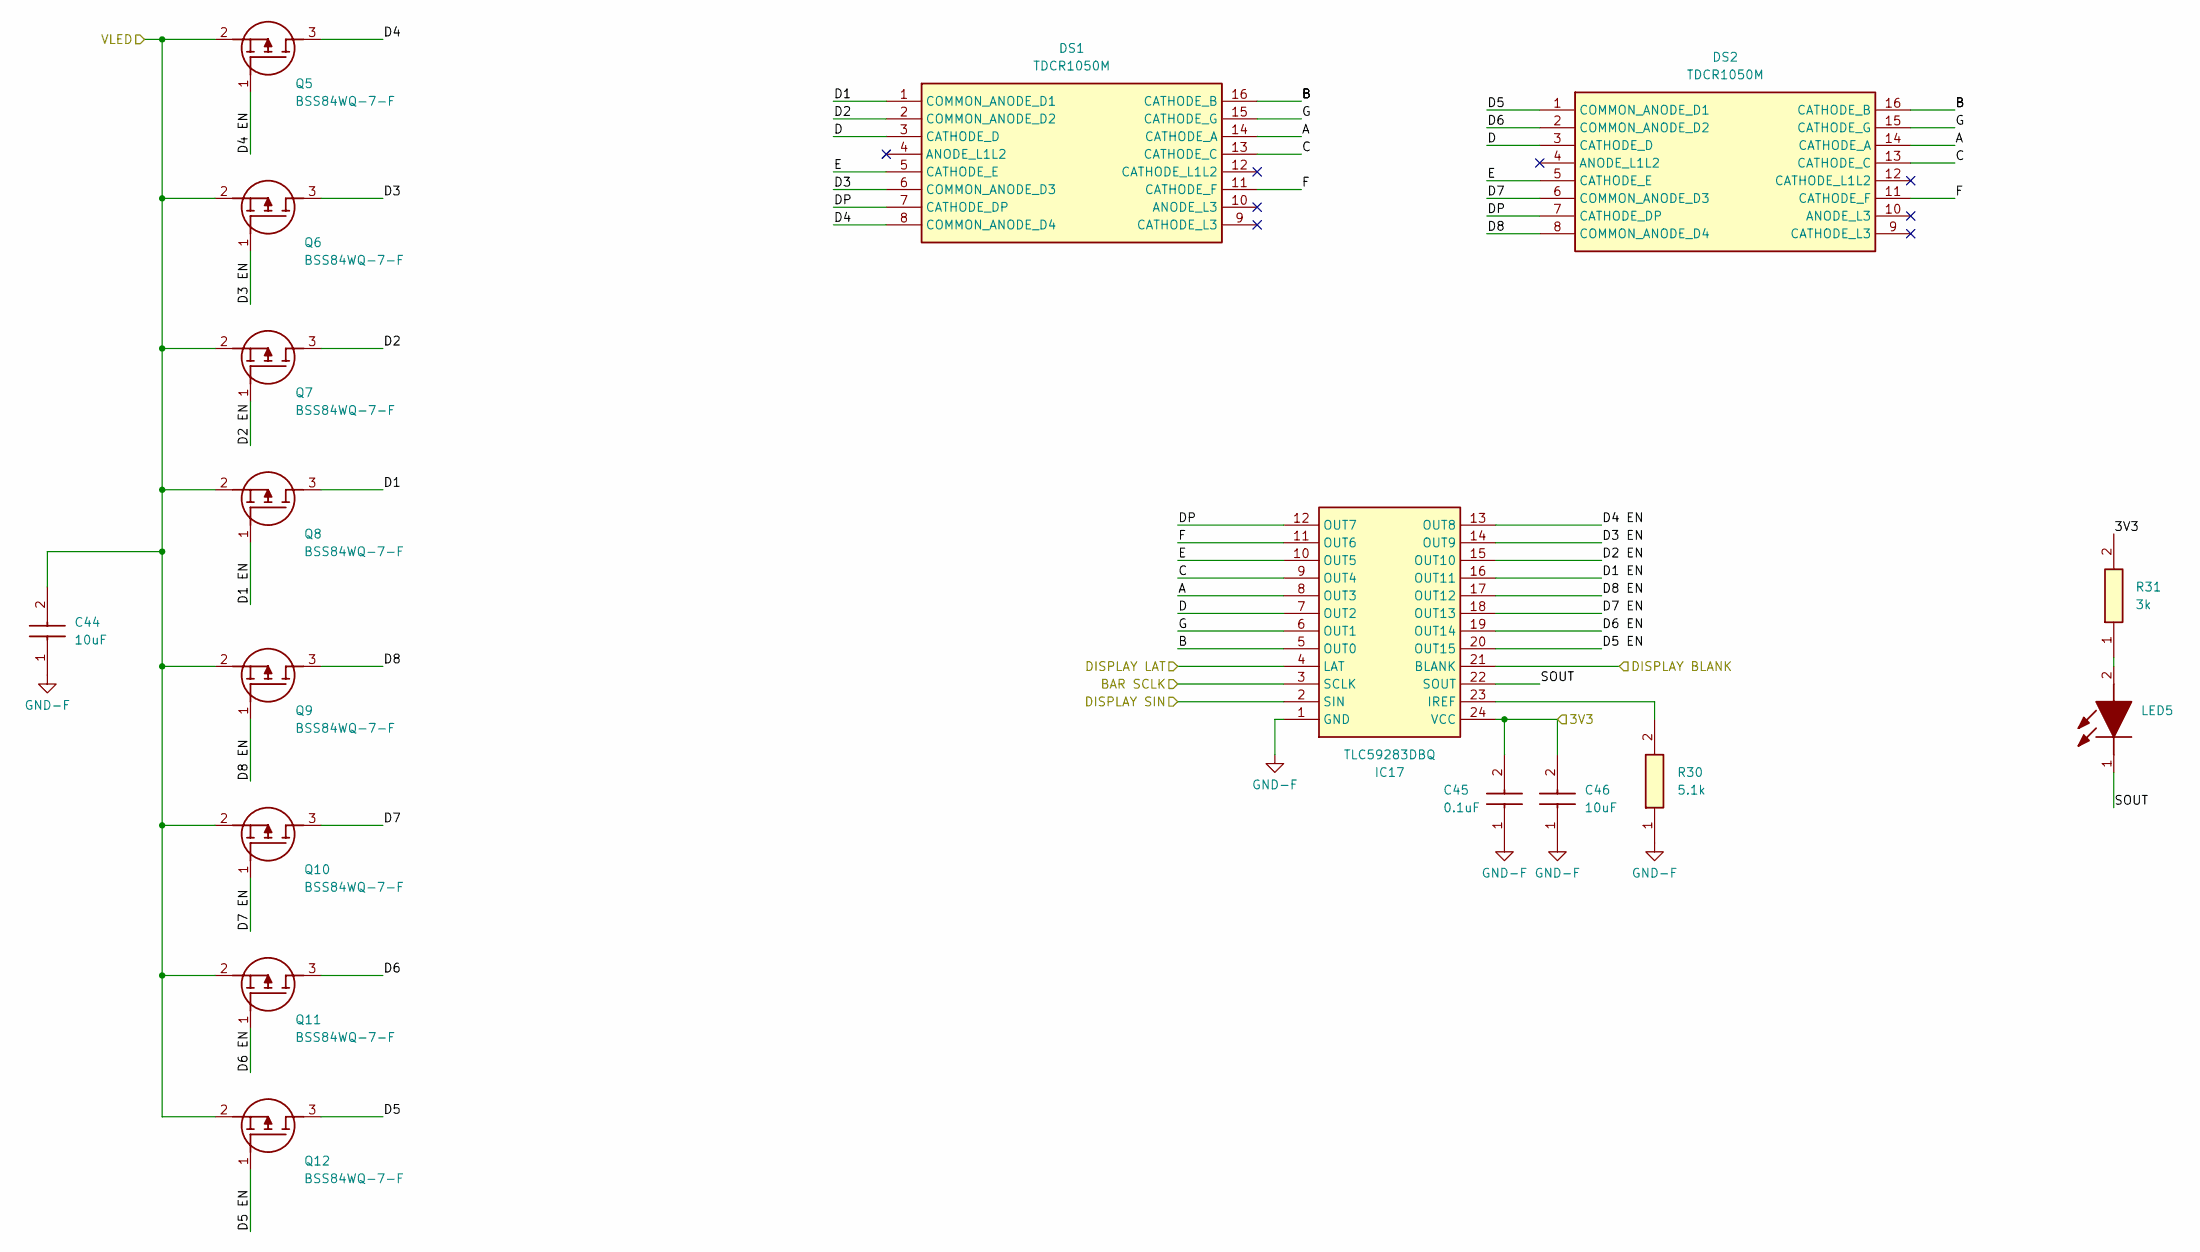
[picture p76: schematic LED Display.kicad_sch]

Parts:
C44, C46: 10uF; CAPC2012X145N; Manufacturer_Part_Number GRM21BR61C106KE15K; Mouser Part Number 81-GRM21BR61C106KE5K
C45: 0.1uF; CAPC1608X90N; Manufacturer_Part_Number CC0603KRX7R7BB104; Mouser Part Number 603-CC603KRX7R7BB104
DS1, DS2: TDCR1050M; DIPS1016W50P254L4020H725Q16N; Manufacturer_Part_Number TDCR1050M; Mouser Part Number 78-TDCR1050M
IC17: TLC59283DBQ; SOP64P600X175-24N; Manufacturer_Part_Number TLC59283DBQ; Mouser Part Number 595-TLC59283DBQ
LED5: 150060SS75000; LEDC1608X80N; Manufacturer_Part_Number 150060SS75000; Mouser Part Number 710-150060SS75000
Q5, Q6, Q7, Q8, Q9, Q10, Q11, Q12: BSS84WQ-7-F; SOT65P210X110-3N; Manufacturer_Part_Number BSS84WQ-7-F; Mouser Part Number 621-BSS84WQ-7-F
R30: 5.1k; RESC1608X55N; Manufacturer_Part_Number RC0603FR-075K1L; Mouser Part Number 603-RC0603FR-075K1L
R31: 3k; RESC1608X55N; Manufacturer_Part_Number RC0603FR-073KL; Mouser Part Number 603-RC0603FR-073KL

Connections:
3V3: C45.2, C46.2, IC17.24 (VCC), R31.2
A: DS1.14 (CATHODE_A), DS2.14 (CATHODE_A), IC17.8 (OUT3)
B: DS1.16 (CATHODE_B), DS2.16 (CATHODE_B), IC17.5 (OUT0)
BAR SCLK: IC17.3 (SCLK)
C: DS1.13 (CATHODE_C), DS2.13 (CATHODE_C), IC17.9 (OUT4)
D: DS1.3 (CATHODE_D), DS2.3 (CATHODE_D), IC17.7 (OUT2)
D1: DS1.1 (COMMON_ANODE_D1), Q8.3 (D)
D1 EN: IC17.16 (OUT11), Q8.1 (G)
D2: DS1.2 (COMMON_ANODE_D2), Q7.3 (D)
D2 EN: IC17.15 (OUT10), Q7.1 (G)
D3: DS1.6 (COMMON_ANODE_D3), Q6.3 (D)
D3 EN: IC17.14 (OUT9), Q6.1 (G)
D4: DS1.8 (COMMON_ANODE_D4), Q5.3 (D)
D4 EN: IC17.13 (OUT8), Q5.1 (G)
D5: DS2.1 (COMMON_ANODE_D1), Q12.3 (D)
D5 EN: IC17.20 (OUT15), Q12.1 (G)
D6: DS2.2 (COMMON_ANODE_D2), Q11.3 (D)
D6 EN: IC17.19 (OUT14), Q11.1 (G)
D7: DS2.6 (COMMON_ANODE_D3), Q10.3 (D)
D7 EN: IC17.18 (OUT13), Q10.1 (G)
D8: DS2.8 (COMMON_ANODE_D4), Q9.3 (D)
D8 EN: IC17.17 (OUT12), Q9.1 (G)
DISPLAY BLANK: IC17.21 (BLANK)
DISPLAY LAT: IC17.4 (LAT)
DISPLAY SIN: IC17.2 (SIN)
DP: DS1.7 (CATHODE_DP), DS2.7 (CATHODE_DP), IC17.12 (OUT7)
E: DS1.5 (CATHODE_E), DS2.5 (CATHODE_E), IC17.10 (OUT5)
F: DS1.11 (CATHODE_F), DS2.11 (CATHODE_F), IC17.11 (OUT6)
G: DS1.15 (CATHODE_G), DS2.15 (CATHODE_G), IC17.6 (OUT1)
GND-F: C44.1, C45.1, C46.1, IC17.1 (GND), R30.1
unnamed: IC17.23 (IREF), R30.2
unnamed: LED5.2 (A), R31.1
SOUT: IC17.22 (SOUT), LED5.1 (K)
VLED: C44.2, Q5.2 (S), Q6.2 (S), Q7.2 (S), Q8.2 (S), Q9.2 (S), Q10.2 (S), Q11.2 (S), Q12.2 (S)
