Alex-Wolfe/Home-Audio-System/Hardware/Design/Main Board/Native Kicad/LED Power Supply.kicad_sch

## KiCad design Hardware/Design/Main Board/Native Kicad/LED Power Supply.kicad_sch (2025-06-05)

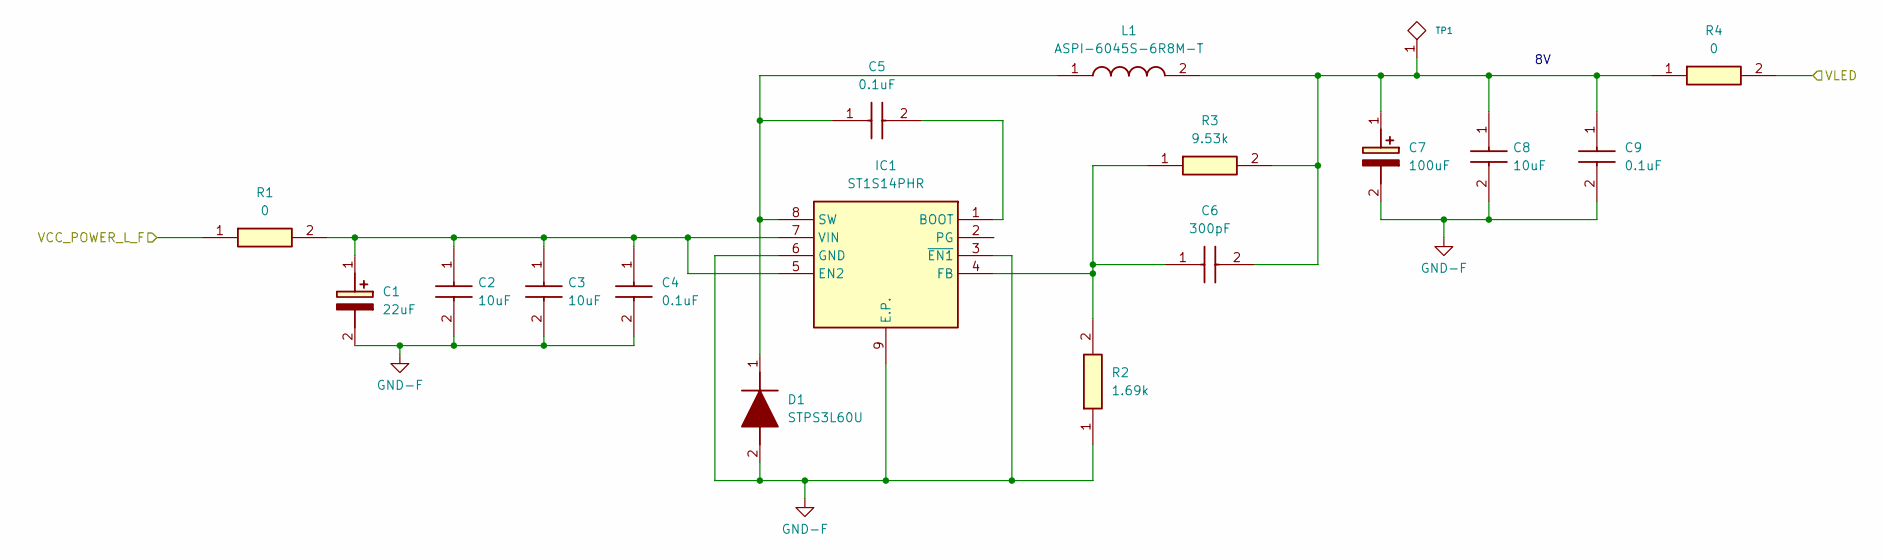
[picture p77: schematic LED Power Supply.kicad_sch]

Parts:
C1: 22uF; CAPPRD200W55D500H1250; Manufacturer_Part_Number EEU-FR1H100B; Mouser Part Number 667-EEU-FR1H100B
C2, C3, C8: 10uF; CAPC3216X180N; Manufacturer_Part_Number CL31A106MBHNNNE; Mouser Part Number 187-CL31A106MBHNNNE
C4, C5, C9: 0.1uF; C0603; Manufacturer_Part_Number C0603C104M5RACTU; Mouser Part Number 80-C0603C104M5R
C6: 300pF; GCM155; Manufacturer_Part_Number GCM1555C1H301JA16D; Mouser Part Number 81-GCM1555C1H301JA6D
C7: 100uF; 865080343009; Manufacturer_Part_Number 865080343009; Mouser Part Number 710-865080343009
D1: STPS3L60U; SMBJ50CA; Manufacturer_Part_Number STPS3L60U; Mouser Part Number 511-STPS3L60U
IC1: ST1S14PHR; SOIC127P600X175-9N; Manufacturer_Part_Number ST1S14PHR; Mouser Part Number 511-ST1S14PHR
L1: ASPI-6045S-6R8M-T; ASPI-6045S; Manufacturer_Part_Number ASPI-6045S-6R8M-T; Mouser Part Number 815-ASPI-6045S-6R8MT
R1, R4: 0; RESC1608X55N; Manufacturer_Part_Number RC0603JR-070RL; Mouser Part Number 603-RC0603JR-070RL
R2: 1.69k; RESC1608X55N; Manufacturer_Part_Number RC0603FR-071K69L; Mouser Part Number 603-RC0603FR-071K69L
R3: 9.53k; RESC1608X55N; Manufacturer_Part_Number RC0603FR-079K53L; Mouser Part Number 603-RC0603FR-079K53L
TP1: TP

Connections:
GND-F: C1.2 (-), C2.2, C3.2, C4.2, C7.2 (-), C8.2, C9.2, D1.2 (A), IC1.3 (~EN1), IC1.6 (GND), IC1.9 (E.P.), R2.1
unnamed: C1.1 (+), C2.1, C3.1, C4.1, IC1.5 (EN2), IC1.7 (VIN), R1.2
unnamed: C5.1, D1.1 (K), IC1.8 (SW), L1.1
unnamed: C5.2, IC1.1 (BOOT)
unnamed: C6.1, IC1.4 (FB), R2.2, R3.1
unnamed: C6.2, C7.1 (+), C8.1, C9.1, L1.2, R3.2, R4.1, TP1.1
VCC_POWER_L_F: R1.1
VLED: R4.2
