Alex-Wolfe/Home-Audio-System/Hardware/Design/Main Board/Native Kicad/Level Display.kicad_sch

## KiCad design Hardware/Design/Main Board/Native Kicad/Level Display.kicad_sch (2025-06-05)

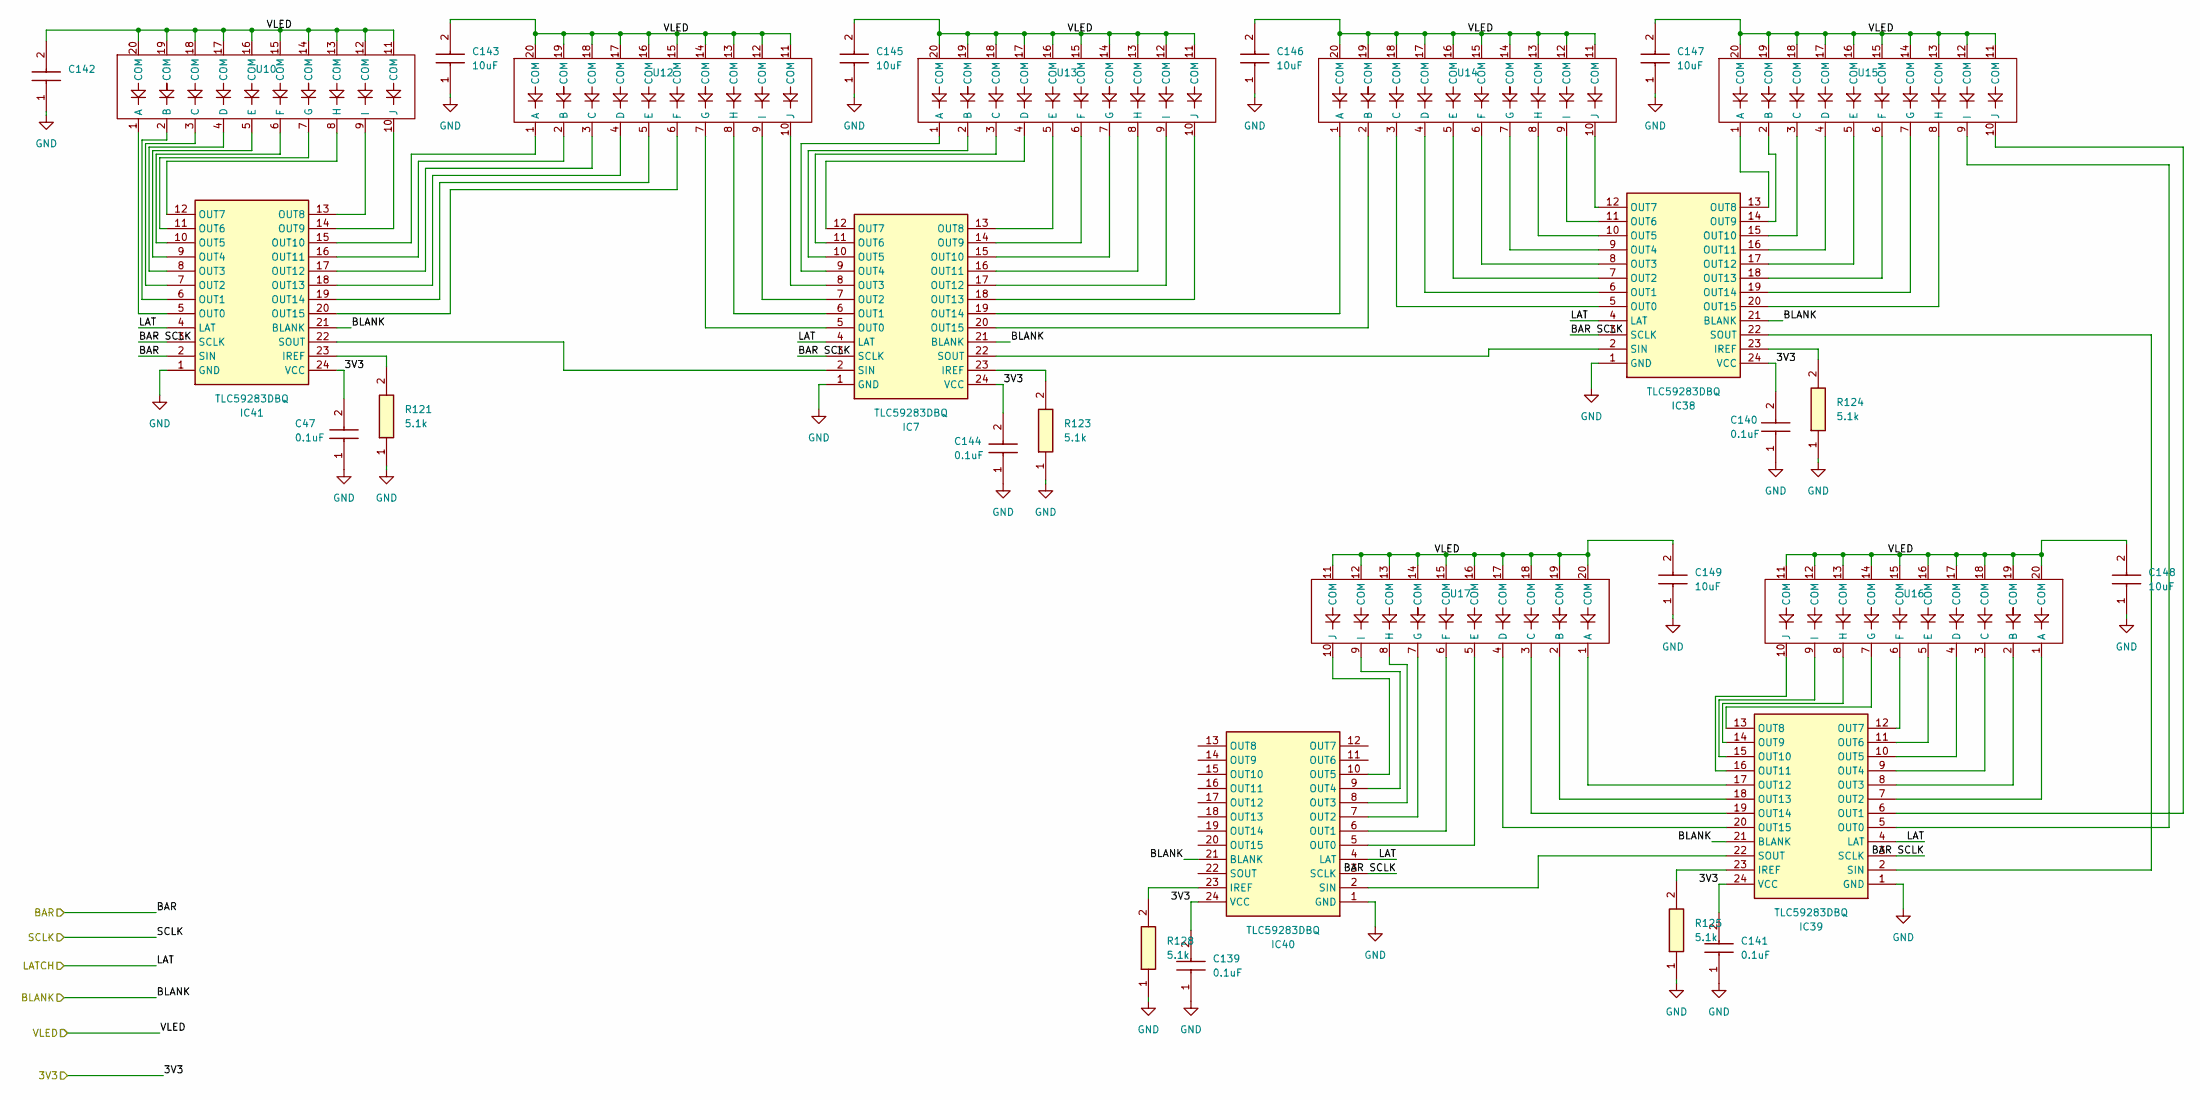
[picture p78: schematic Level Display.kicad_sch]

Parts:
C47, C139, C140, C141, C144: 0.1uF; CAPC1608X90N; Manufacturer_Part_Number CC0603KRX7R7BB104; Mouser Part Number 603-CC603KRX7R7BB104
C142, C143, C145, C146, C147, C148, C149: 10uF; CAPC2012X145N; Manufacturer_Part_Number GRM21BR61C106KE15K; Mouser Part Number 81-GRM21BR61C106KE5K
IC7, IC38, IC39, IC40, IC41: TLC59283DBQ; SOP64P600X175-24N; Manufacturer_Part_Number TLC59283DBQ; Mouser Part Number 595-TLC59283DBQ
R121, R123, R124, R125, R128: 5.1k; RESC1608X55N; Manufacturer_Part_Number RC0603FR-075K1L; Mouser Part Number 603-RC0603FR-075K1L
U10, U12, U13, U14, U15, U16, U17: LED Bar Graph

Connections:
3V3: C47.2, C139.2, C140.2, C141.2, C144.2, IC7.24 (VCC), IC38.24 (VCC), IC39.24 (VCC), IC40.24 (VCC), IC41.24 (VCC)
BAR: IC41.2 (SIN)
BAR SCLK: IC7.3 (SCLK), IC38.3 (SCLK), IC39.3 (SCLK), IC40.3 (SCLK), IC41.3 (SCLK)
BLANK: IC7.21 (BLANK), IC38.21 (BLANK), IC39.21 (BLANK), IC40.21 (BLANK), IC41.21 (BLANK)
GND: C47.1, C139.1, C140.1, C141.1, C142.1, C143.1, C144.1, C145.1, C146.1, C147.1, C148.1, C149.1, IC7.1 (GND), IC38.1 (GND), IC39.1 (GND), IC40.1 (GND), IC41.1 (GND), R121.1, R123.1, R124.1, R125.1, R128.1
LAT: IC7.4 (LAT), IC38.4 (LAT), IC39.4 (LAT), IC40.4 (LAT), IC41.4 (LAT)
unnamed: IC7.5 (OUT0), U12.7 (G)
unnamed: IC7.6 (OUT1), U12.8 (H)
unnamed: IC7.7 (OUT2), U12.9 (I)
unnamed: IC7.8 (OUT3), U12.10 (J)
unnamed: IC7.9 (OUT4), U13.1 (A)
unnamed: IC7.10 (OUT5), U13.2 (B)
unnamed: IC7.11 (OUT6), U13.3 (C)
unnamed: IC7.12 (OUT7), U13.4 (D)
unnamed: IC7.13 (OUT8), U13.5 (E)
unnamed: IC7.14 (OUT9), U13.6 (F)
unnamed: IC7.15 (OUT10), U13.7 (G)
unnamed: IC7.16 (OUT11), U13.8 (H)
unnamed: IC7.17 (OUT12), U13.9 (I)
unnamed: IC7.18 (OUT13), U13.10 (J)
unnamed: IC7.19 (OUT14), U14.1 (A)
unnamed: IC7.20 (OUT15), U14.2 (B)
unnamed: IC7.23 (IREF), R123.2
unnamed: IC7.22 (SOUT), IC38.2 (SIN)
unnamed: IC38.5 (OUT0), U14.3 (C)
unnamed: IC38.6 (OUT1), U14.4 (D)
unnamed: IC38.7 (OUT2), U14.5 (E)
unnamed: IC38.8 (OUT3), U14.6 (F)
unnamed: IC38.9 (OUT4), U14.7 (G)
unnamed: IC38.10 (OUT5), U14.8 (H)
unnamed: IC38.11 (OUT6), U14.9 (I)
unnamed: IC38.12 (OUT7), U14.10 (J)
unnamed: IC38.13 (OUT8), U15.1 (A)
unnamed: IC38.14 (OUT9), U15.2 (B)
unnamed: IC38.15 (OUT10), U15.3 (C)
unnamed: IC38.16 (OUT11), U15.4 (D)
unnamed: IC38.17 (OUT12), U15.5 (E)
unnamed: IC38.18 (OUT13), U15.6 (F)
unnamed: IC38.19 (OUT14), U15.7 (G)
unnamed: IC38.20 (OUT15), U15.8 (H)
unnamed: IC38.22 (SOUT), IC39.2 (SIN)
unnamed: IC38.23 (IREF), R124.2
unnamed: IC39.5 (OUT0), U15.9 (I)
unnamed: IC39.6 (OUT1), U15.10 (J)
unnamed: IC39.7 (OUT2), U16.1 (A)
unnamed: IC39.8 (OUT3), U16.2 (B)
unnamed: IC39.9 (OUT4), U16.3 (C)
unnamed: IC39.10 (OUT5), U16.4 (D)
unnamed: IC39.11 (OUT6), U16.5 (E)
unnamed: IC39.12 (OUT7), U16.6 (F)
unnamed: IC39.13 (OUT8), U16.7 (G)
unnamed: IC39.14 (OUT9), U16.8 (H)
unnamed: IC39.15 (OUT10), U16.9 (I)
unnamed: IC39.16 (OUT11), U16.10 (J)
unnamed: IC39.17 (OUT12), U17.1 (A)
unnamed: IC39.18 (OUT13), U17.2 (B)
unnamed: IC39.19 (OUT14), U17.3 (C)
unnamed: IC39.20 (OUT15), U17.4 (D)
unnamed: IC39.22 (SOUT), IC40.2 (SIN)
unnamed: IC39.23 (IREF), R125.2
unnamed: IC40.5 (OUT0), U17.5 (E)
unnamed: IC40.6 (OUT1), U17.6 (F)
unnamed: IC40.7 (OUT2), U17.7 (G)
unnamed: IC40.8 (OUT3), U17.8 (H)
unnamed: IC40.9 (OUT4), U17.9 (I)
unnamed: IC40.10 (OUT5), U17.10 (J)
unnamed: IC40.23 (IREF), R128.2
unnamed: IC41.5 (OUT0), U10.1 (A)
unnamed: IC41.6 (OUT1), U10.2 (B)
unnamed: IC41.7 (OUT2), U10.3 (C)
unnamed: IC41.8 (OUT3), U10.4 (D)
unnamed: IC41.9 (OUT4), U10.5 (E)
unnamed: IC41.10 (OUT5), U10.6 (F)
unnamed: IC41.11 (OUT6), U10.7 (G)
unnamed: IC41.12 (OUT7), U10.8 (H)
unnamed: IC41.13 (OUT8), U10.9 (I)
unnamed: IC41.14 (OUT9), U10.10 (J)
unnamed: IC41.15 (OUT10), U12.1 (A)
unnamed: IC41.16 (OUT11), U12.2 (B)
unnamed: IC41.17 (OUT12), U12.3 (C)
unnamed: IC41.18 (OUT13), U12.4 (D)
unnamed: IC41.19 (OUT14), U12.5 (E)
unnamed: IC41.20 (OUT15), U12.6 (F)
unnamed: IC7.2 (SIN), IC41.22 (SOUT)
unnamed: IC41.23 (IREF), R121.2
VLED: C142.2, C143.2, C145.2, C146.2, C147.2, C148.2, C149.2, U10.11 (COM), U10.12 (COM), U10.13 (COM), U10.14 (COM), U10.15 (COM), U10.16 (COM), U10.17 (COM), U10.18 (COM), U10.19 (COM), U10.20 (COM), U12.11 (COM), U12.12 (COM), U12.13 (COM), U12.14 (COM), U12.15 (COM), U12.16 (COM), U12.17 (COM), U12.18 (COM), U12.19 (COM), U12.20 (COM), U13.11 (COM), U13.12 (COM), U13.13 (COM), U13.14 (COM), U13.15 (COM), U13.16 (COM), U13.17 (COM), U13.18 (COM), U13.19 (COM), U13.20 (COM), U14.11 (COM), U14.12 (COM), U14.13 (COM), U14.14 (COM), U14.15 (COM), U14.16 (COM), U14.17 (COM), U14.18 (COM), U14.19 (COM), U14.20 (COM), U15.11 (COM), U15.12 (COM), U15.13 (COM), U15.14 (COM), U15.15 (COM), U15.16 (COM), U15.17 (COM), U15.18 (COM), U15.19 (COM), U15.20 (COM), U16.11 (COM), U16.12 (COM), U16.13 (COM), U16.14 (COM), U16.15 (COM), U16.16 (COM), U16.17 (COM), U16.18 (COM), U16.19 (COM), U16.20 (COM), U17.11 (COM), U17.12 (COM), U17.13 (COM), U17.14 (COM), U17.15 (COM), U17.16 (COM), U17.17 (COM), U17.18 (COM), U17.19 (COM), U17.20 (COM)
