Alex-Wolfe/Home-Audio-System/Hardware/Design/Main Board/Native Kicad/Low Pass Filtering and Attenuation.kicad_sch

## KiCad design Hardware/Design/Main Board/Native Kicad/Low Pass Filtering and Attenuation.kicad_sch (2025-06-05)

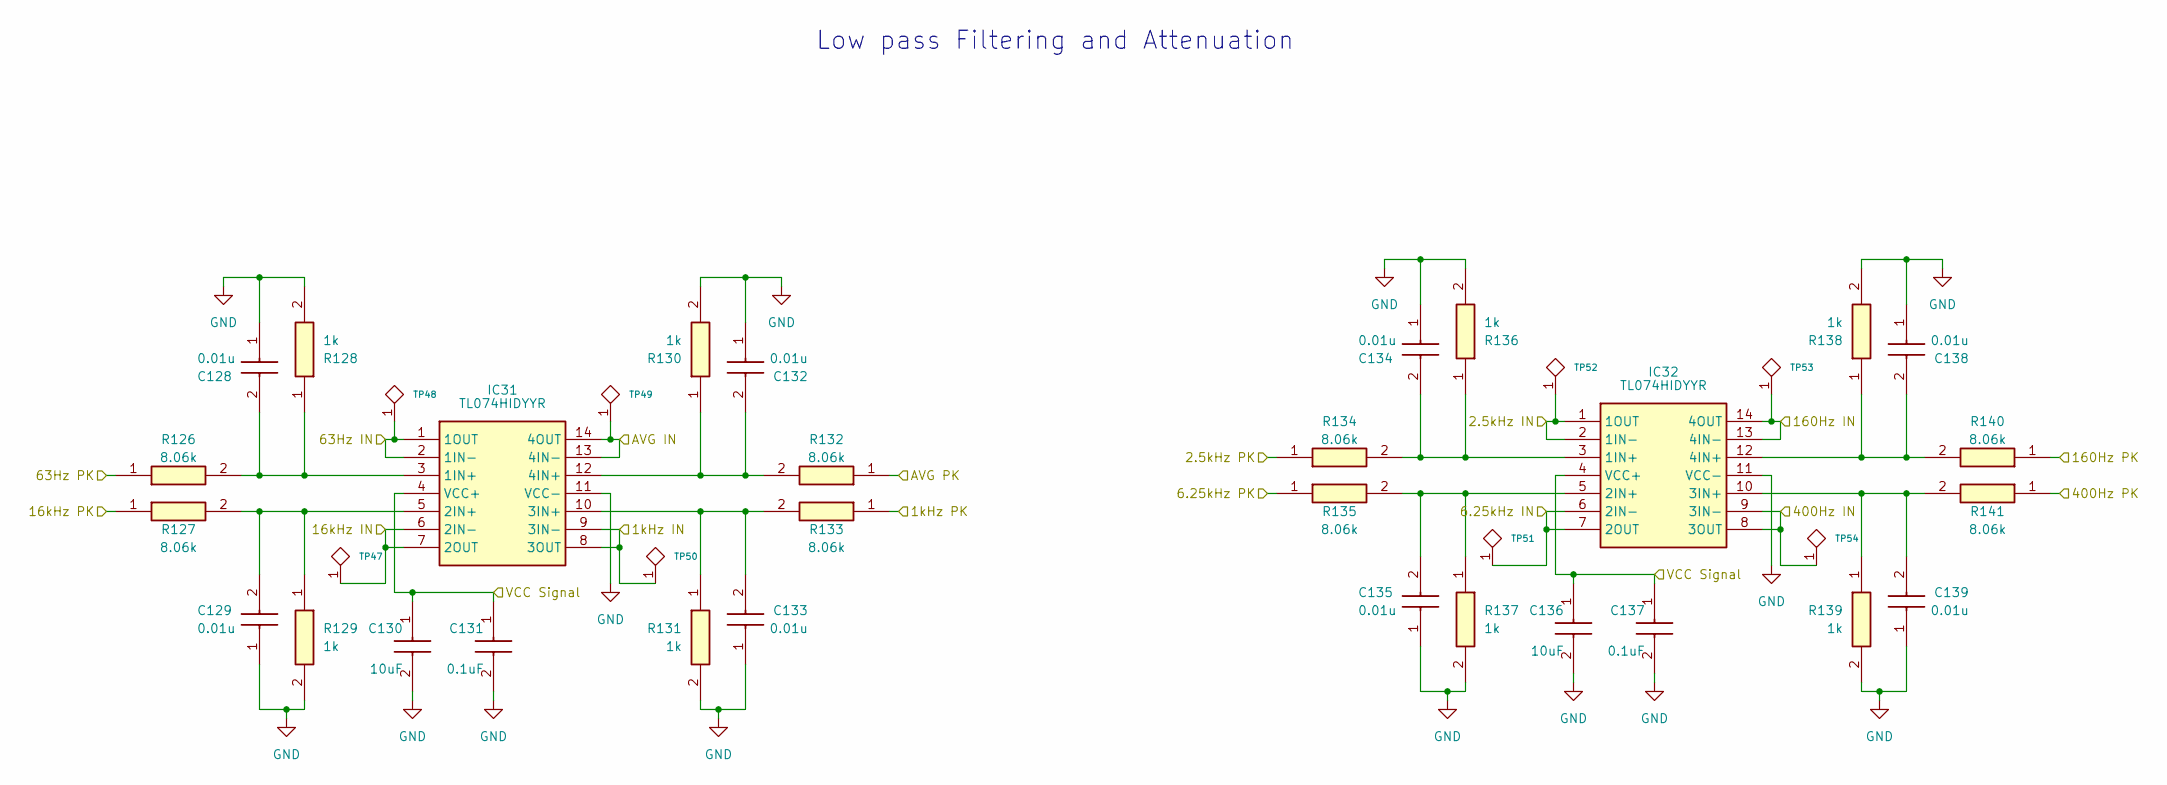
[picture p79: schematic Low Pass Filtering and Attenuation.kicad_sch]

Parts:
C128, C129, C132, C133, C134, C135, C138, C139: 0.01u; CAPC1608X90N; Manufacturer_Part_Number CL10B103KB8NNNC; Mouser Part Number 187-CL10B103KB8NNNC
C130, C136: 10uF; GRM21x; Manufacturer_Part_Number GRM21BR61H106KE43L; Mouser Part Number 81-GRM21BR61H106KE3L
C131, C137: 0.1uF; C0603; Manufacturer_Part_Number C0603C104M5RACTU; Mouser Part Number 80-C0603C104M5R
IC31, IC32: TL074HIDYYR; SOP50P326X110-14N; Manufacturer_Part_Number TL074HIDYYR; Mouser Part Number 595-TL074HIDYYR
R126, R127, R132, R133, R134, R135, R140, R141: 8.06k; RESC1608X55N; Manufacturer_Part_Number RC0603FR-078K06L; Mouser Part Number 603-RC0603FR-078K06L
R128, R129, R130, R131, R136, R137, R138, R139: 1k; RESC1608X55N; Manufacturer_Part_Number RC0603FR-071KL; Mouser Part Number 603-RC0603FR-071KL
TP47, TP48, TP49, TP50, TP51, TP52, TP53, TP54: TP

Connections:
1kHz IN: IC31.8 (3OUT), IC31.9 (3IN-), TP50.1
1kHz PK: R133.1
2.5kHz IN: IC32.1 (1OUT), IC32.2 (1IN-), TP52.1
2.5kHz PK: R134.1
6.25kHz IN: IC32.6 (2IN-), IC32.7 (2OUT), TP51.1
6.25kHz PK: R135.1
16kHz IN: IC31.6 (2IN-), IC31.7 (2OUT), TP47.1
16kHz PK: R127.1
63Hz IN: IC31.1 (1OUT), IC31.2 (1IN-), TP48.1
63Hz PK: R126.1
160Hz IN: IC32.13 (4IN-), IC32.14 (4OUT), TP53.1
160Hz PK: R140.1
400Hz IN: IC32.8 (3OUT), IC32.9 (3IN-), TP54.1
400Hz PK: R141.1
AVG IN: IC31.13 (4IN-), IC31.14 (4OUT), TP49.1
AVG PK: R132.1
GND: C128.1, C129.1, C130.2, C131.2, C132.1, C133.1, C134.1, C135.1, C136.2, C137.2, C138.1, C139.1, IC31.11 (VCC-), IC32.11 (VCC-), R128.2, R129.2, R130.2, R131.2, R136.2, R137.2, R138.2, R139.2
unnamed: C128.2, IC31.3 (1IN+), R126.2, R128.1
unnamed: C129.2, IC31.5 (2IN+), R127.2, R129.1
unnamed: C132.2, IC31.12 (4IN+), R130.1, R132.2
unnamed: C133.2, IC31.10 (3IN+), R131.1, R133.2
unnamed: C134.2, IC32.3 (1IN+), R134.2, R136.1
unnamed: C135.2, IC32.5 (2IN+), R135.2, R137.1
unnamed: C138.2, IC32.12 (4IN+), R138.1, R140.2
unnamed: C139.2, IC32.10 (3IN+), R139.1, R141.2
VCC Signal: C130.1, C131.1, C136.1, C137.1, IC31.4 (VCC+), IC32.4 (VCC+)

Notes on the sheet:
Low pass Filtering and Attenuation
