Alex-Wolfe/Home-Audio-System/Hardware/Design/Main Board/Native Kicad/Main Board.kicad_sch

## KiCad design Hardware/Design/Main Board/Native Kicad/Main Board.kicad_sch (2025-06-05)

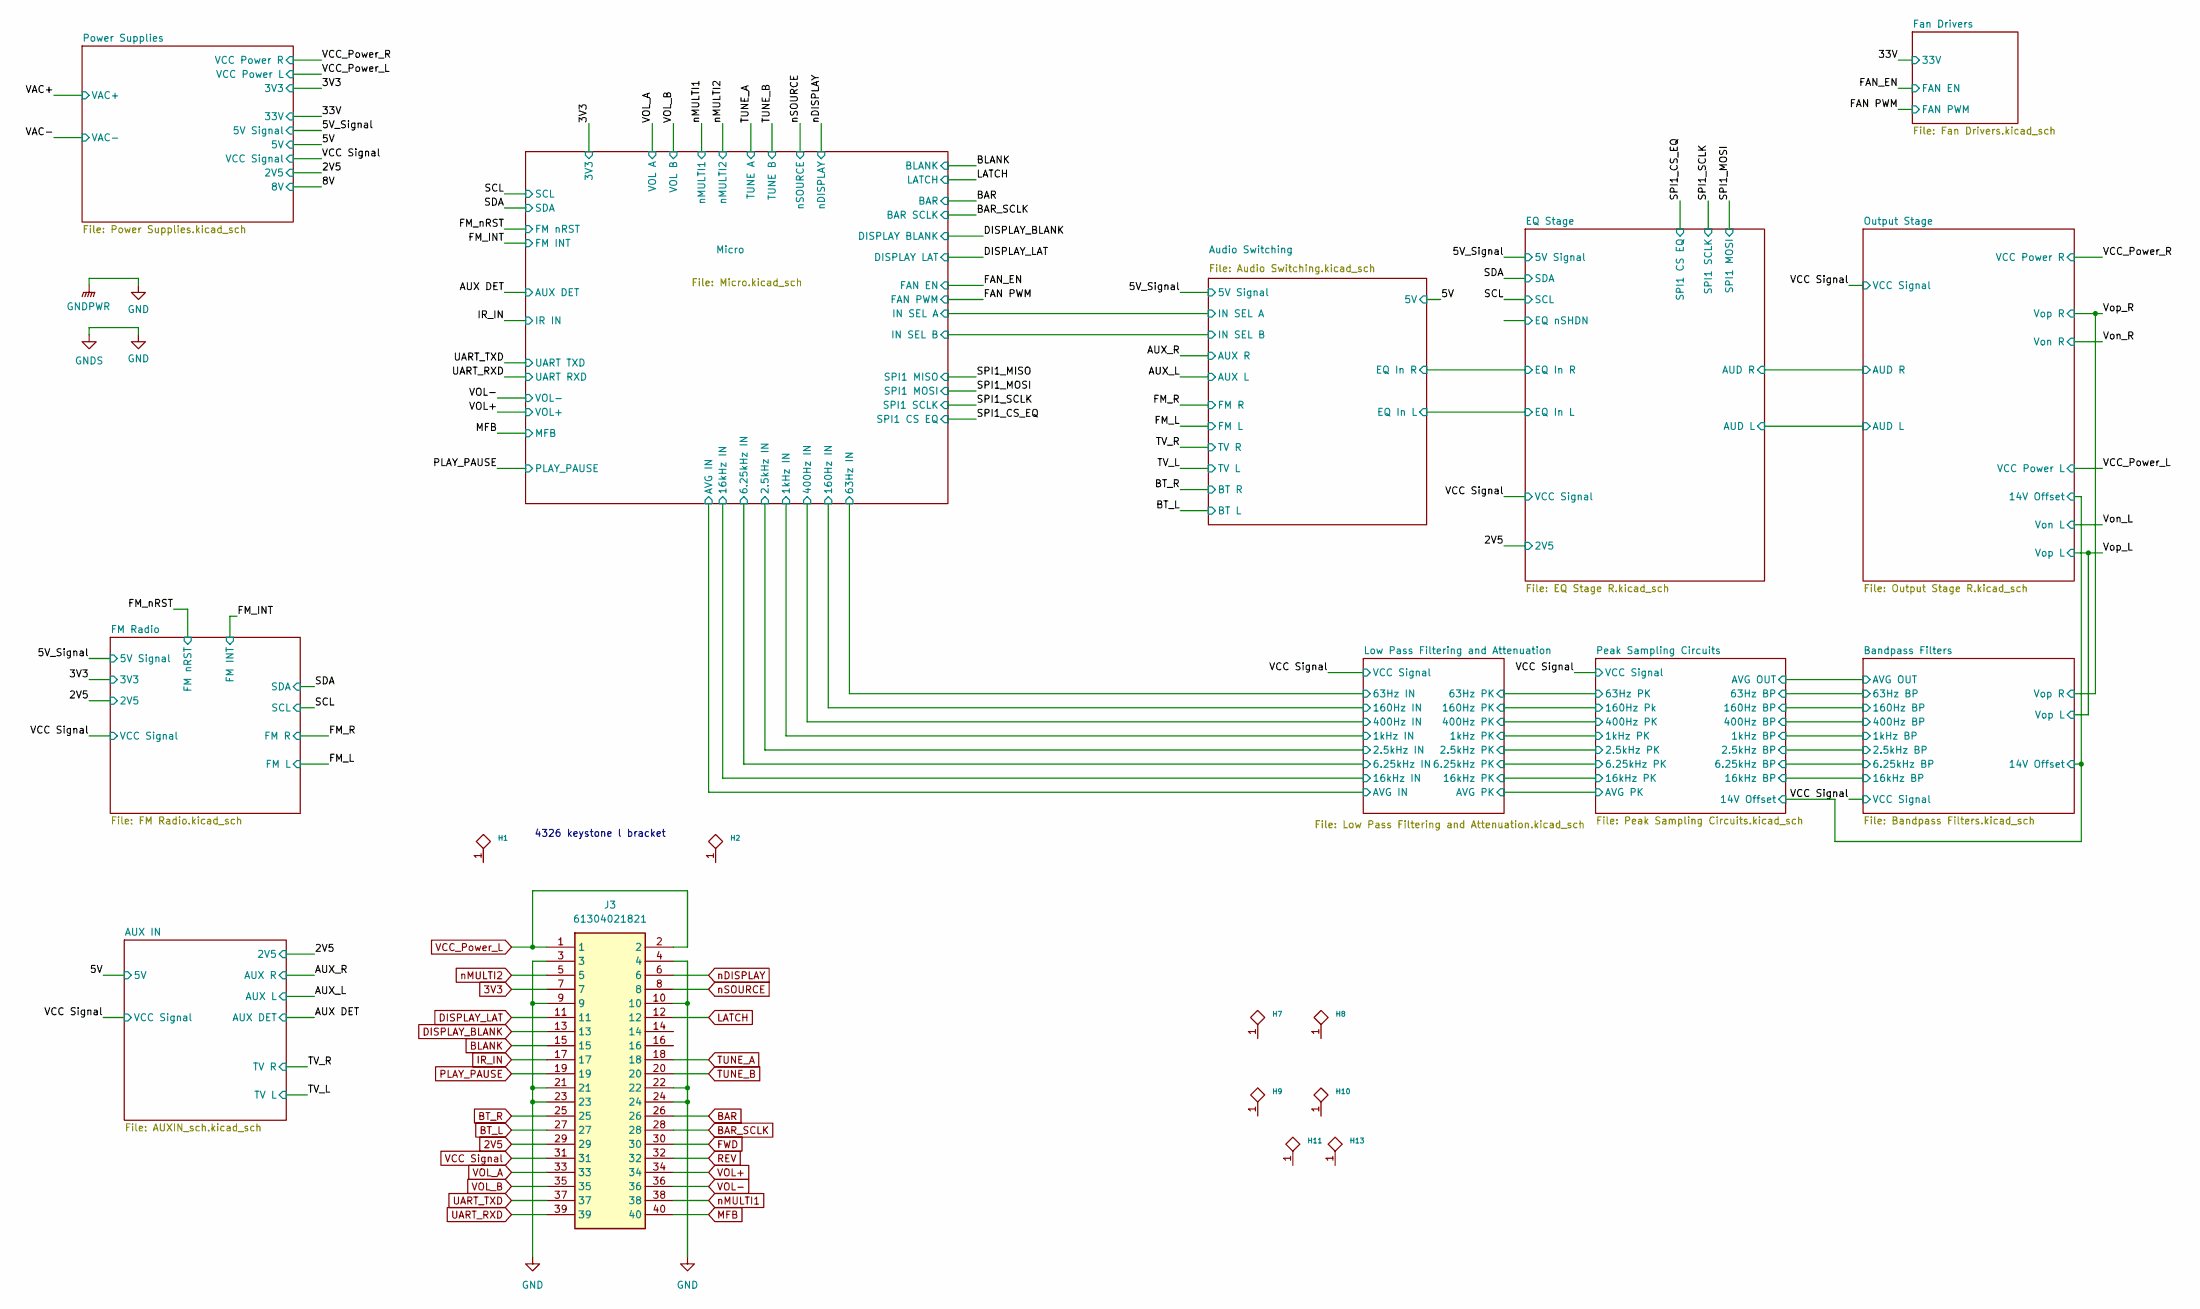
[picture p80: schematic Main Board.kicad_sch]

Parts:
H1, H2: MountingHole_3.7mm_Pad_TopBottom
H7, H8, H9, H10, H11, H13: MountingHole_3.2mm_M3_ISO7380_Pad_TopBottom
J3: 61304021821; RHDR40W97P254X254_2X20_5130X508X860P; Manufacturer_Part_Number 61304021821; Mouser Part Number 710-61304021821

Connections:
2V5: J3.29
3V3: J3.7
BAR: J3.26
BAR_SCLK: J3.28
BLANK: J3.15
BT_L: J3.27
BT_R: J3.25
DISPLAY_BLANK: J3.13
DISPLAY_LAT: J3.11
FWD: J3.30
GND: J3.3, J3.4, J3.9, J3.10, J3.21, J3.22, J3.23, J3.24
IR_IN: J3.17
LATCH: J3.12
MFB: J3.40
PLAY_PAUSE: J3.19
REV: J3.32
TUNE_A: J3.18
TUNE_B: J3.20
UART_RXD: J3.39
UART_TXD: J3.37
VCC Signal: J3.31
VCC_Power_L: J3.1, J3.2
VOL+: J3.34
VOL-: J3.36
VOL_A: J3.33
VOL_B: J3.35
nDISPLAY: J3.6
nMULTI1: J3.38
nMULTI2: J3.5
nSOURCE: J3.8

Notes on the sheet:
4326 keystone l bracket
