Alex-Wolfe/Home-Audio-System/Hardware/Design/Main Board/Native Kicad/Main Volume Display.kicad_sch

## KiCad design Hardware/Design/Main Board/Native Kicad/Main Volume Display.kicad_sch (2025-06-05)

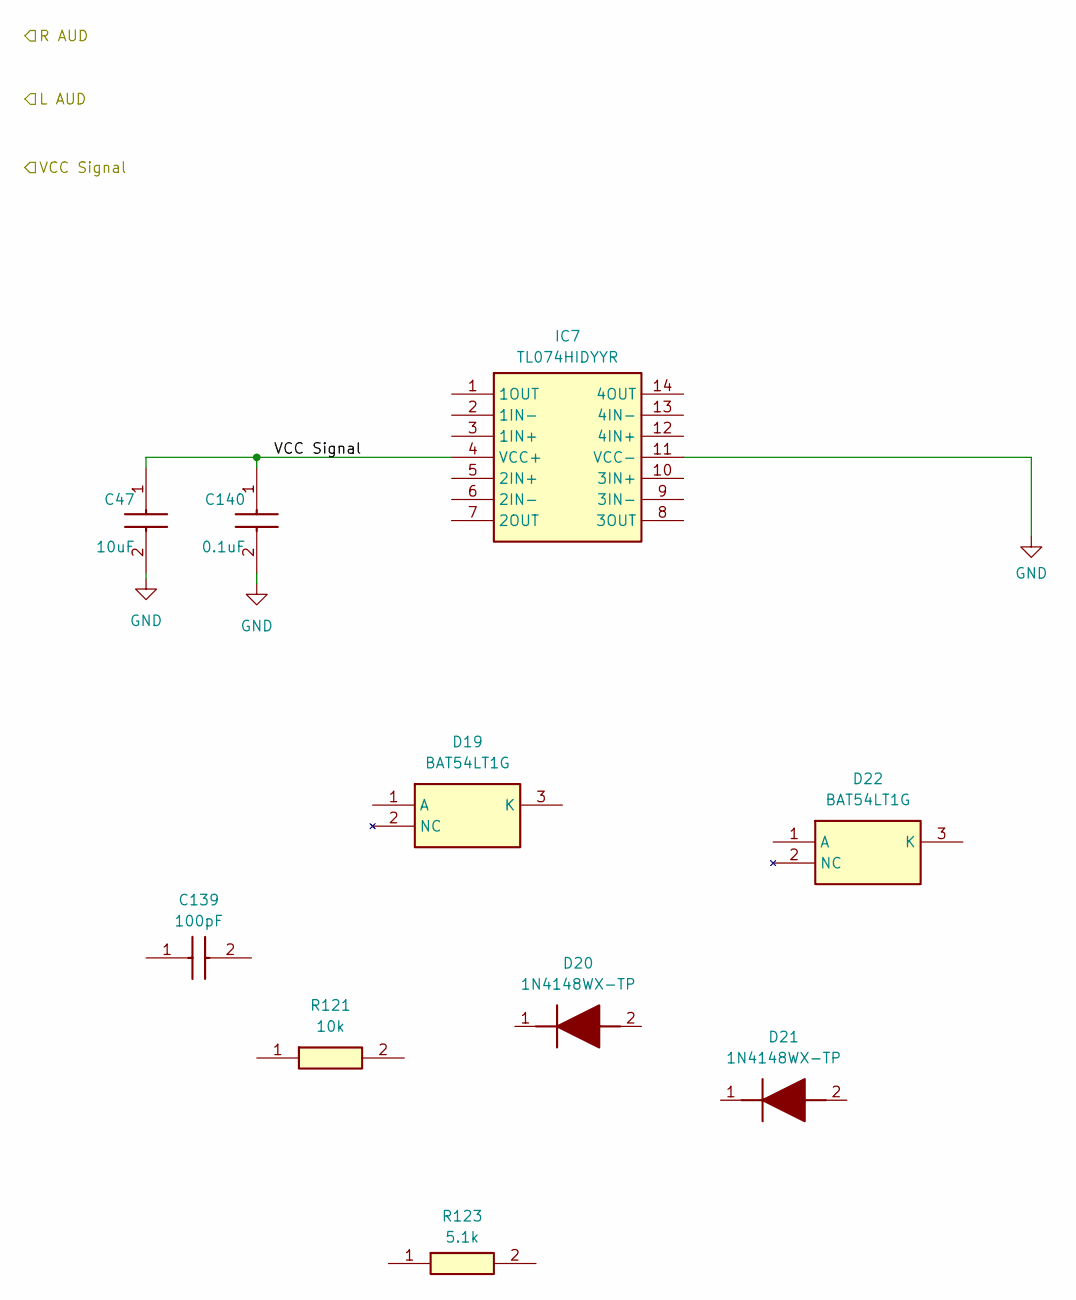
[picture p81: schematic Main Volume Display.kicad_sch]

Parts:
C47: 10uF; GRM21x; Manufacturer_Part_Number GRM21BR61H106KE43L; Mouser Part Number 81-GRM21BR61H106KE3L
C139: 100pF; CAPC1608X87N; Manufacturer_Part_Number CC0603JRNPO9BN101; Mouser Part Number 603-CC603JRNPO9BN101
C140: 0.1uF; C0603; Manufacturer_Part_Number C0603C104M5RACTU; Mouser Part Number 80-C0603C104M5R
D19, D22: BAT54LT1G; SOT96P237X111-3N; Manufacturer_Part_Number BAT54LT1G; Mouser Part Number 863-BAT54LT1G
D20, D21: 1N4148WX-TP; SOD2512X130N; Manufacturer_Part_Number 1N4148WX-TP
IC7: TL074HIDYYR; SOP50P326X110-14N; Manufacturer_Part_Number TL074HIDYYR; Mouser Part Number 595-TL074HIDYYR
R121: 10k; RESC1608X55N; Manufacturer_Part_Number RC0603FR-0710KL; Mouser Part Number 603-RC0603FR-0710KL
R123: 5.1k; RESC1608X55N; Manufacturer_Part_Number RC0603FR-075K1L; Mouser Part Number 603-RC0603FR-075K1L

Connections:
GND: C47.2, C140.2, IC7.11 (VCC-)
VCC Signal: C47.1, C140.1, IC7.4 (VCC+)
