Alex-Wolfe/Home-Audio-System/Hardware/Design/Main Board/Native Kicad/MainFullWaveRectifier.kicad_sch

## KiCad design Hardware/Design/Main Board/Native Kicad/MainFullWaveRectifier.kicad_sch (2025-06-05)

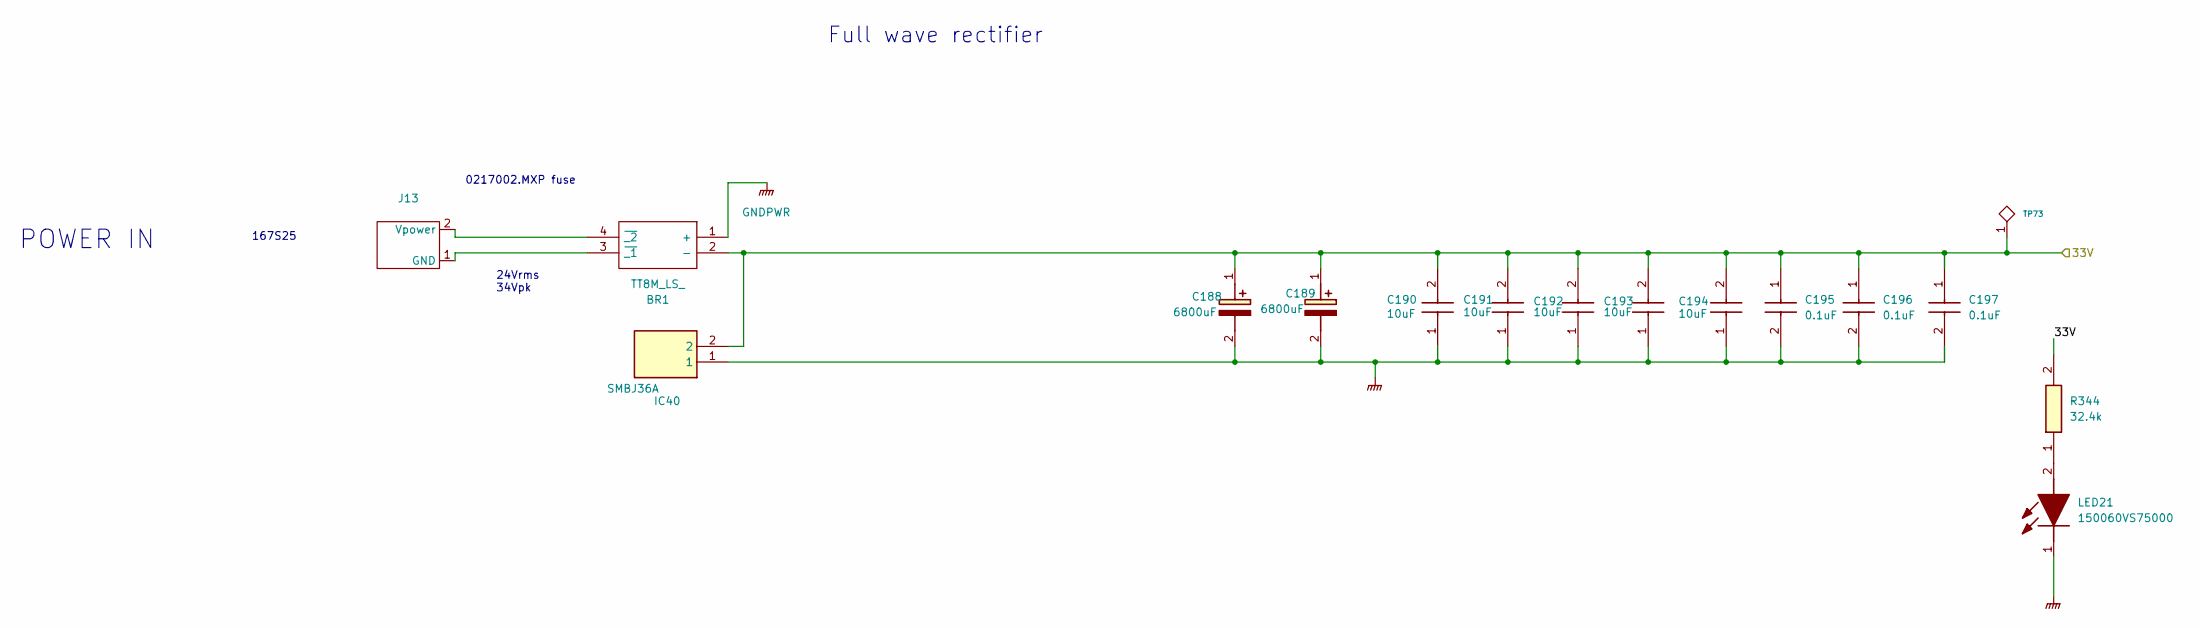
[picture p82: schematic MainFullWaveRectifier.kicad_sch]

Parts:
BR1: TT8M_LS_; SOP500P990X180-4N; Manufacturer_Part_Number TT8M(LS)
C188, C189: 6800uF; CAPPRD1000W210D2550H4200; Manufacturer_Part_Number SLPX682M050C7P3
C190, C191, C192, C193, C194: 10uF; CAPC3216X180N; Manufacturer_Part_Number CL31A106MBHNNNE; Mouser Part Number 187-CL31A106MBHNNNE
C195, C196, C197: 0.1uF; C0603; Manufacturer_Part_Number C0603C104M5RACTU; Mouser Part Number 80-C0603C104M5R
IC40: SMBJ36A; Manufacturer_Part_Number SMBJ36A; Mouser Part Number 512-SMBJ36A
J13: power wires
LED21: 150060VS75000; LEDC1608X80N; Manufacturer_Part_Number 150060VS75000; Mouser Part Number 710-150060VS75000
R344: 32.4k; RESC1608X55N; Manufacturer_Part_Number RC0603FR-0732K4L; Mouser Part Number 603-RC0603FR-0732K4L
TP73: TP

Connections:
33V: BR1.2 (-), C188.1 (+), C189.1 (+), C190.2, C191.2, C192.2, C193.2, C194.2, C195.1, C196.1, C197.1, IC40.2, R344.2, TP73.1
GNDPWR: BR1.1 (+), C188.2 (-), C189.2 (-), C190.1, C191.1, C192.1, C193.1, C194.1, C195.2, C196.2, C197.2, IC40.1, LED21.1 (K)
unnamed: BR1.3 (~_1), J13.1 (GND)
unnamed: BR1.4 (~_2), J13.2 (Vpower)
unnamed: LED21.2 (A), R344.1

Notes on the sheet:
24Vrms 34Vpk
0217002.MXP fuse
167S25
POWER IN
Full wave rectifier
