Alex-Wolfe/Home-Audio-System/Hardware/Design/Main Board/Native Kicad/Micro.kicad_sch

## KiCad design Hardware/Design/Main Board/Native Kicad/Micro.kicad_sch (2025-06-05)

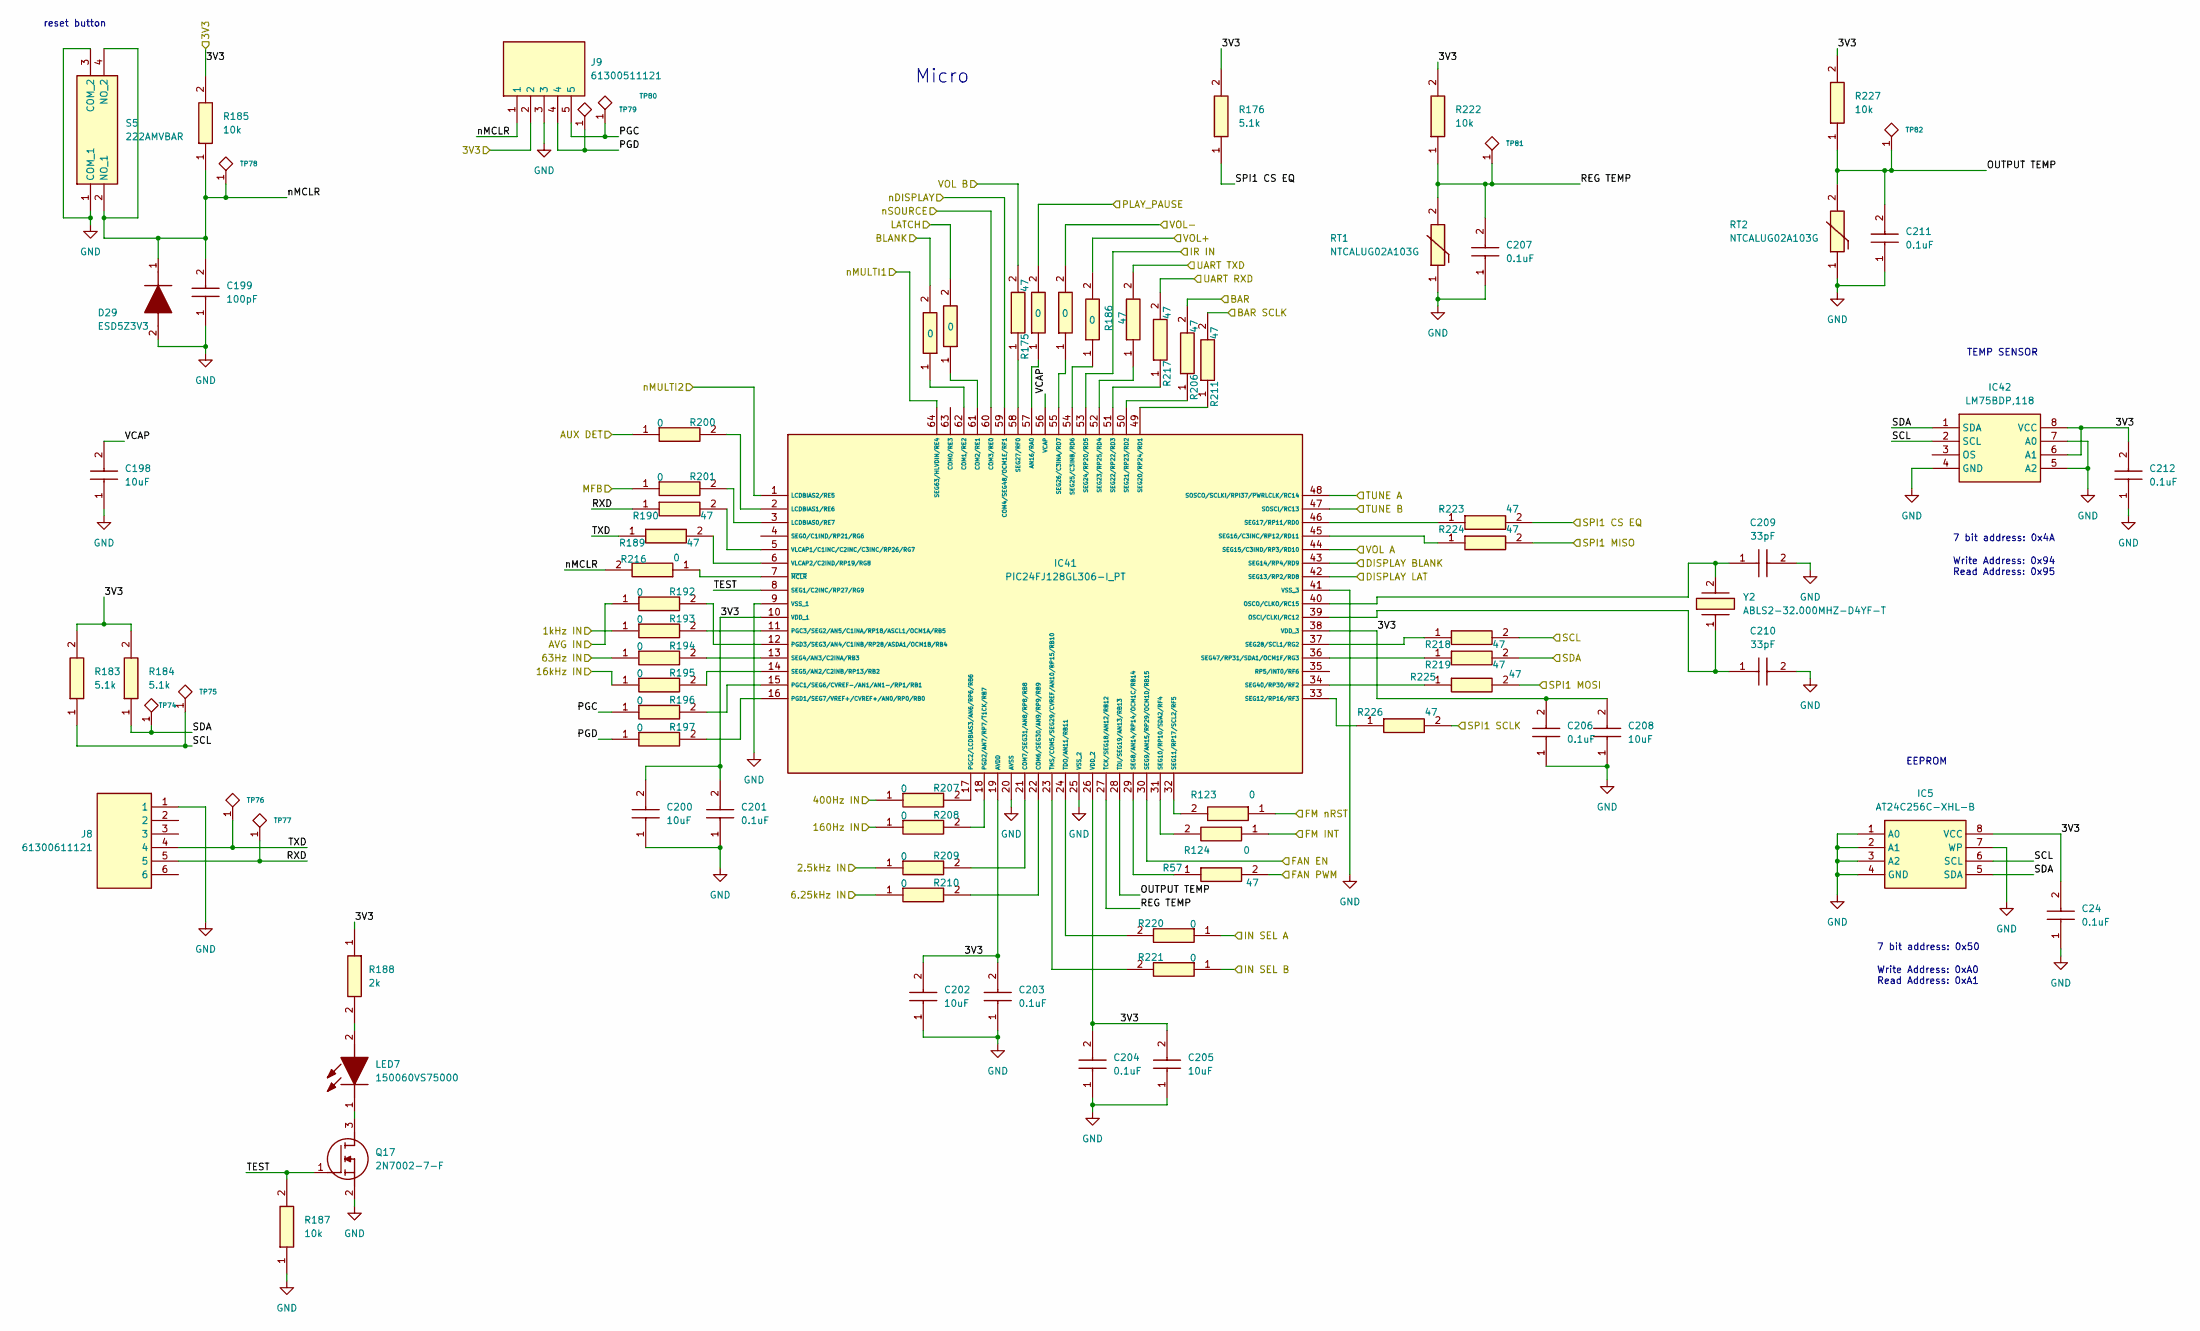
[picture p83: schematic Micro.kicad_sch]

Parts:
C24, C201, C203, C204, C206, C207, C211, C212: 0.1uF; CAPC1608X90N; Manufacturer_Part_Number CC0603KRX7R7BB104; Mouser Part Number 603-CC603KRX7R7BB104
C198, C200, C202, C205, C208: 10uF; CAPC2012X145N; Manufacturer_Part_Number GRM21BR61C106KE15K; Mouser Part Number 81-GRM21BR61C106KE5K
C199: 100pF; CAPC1608X87N; Manufacturer_Part_Number CC0603JRNPO9BN101; Mouser Part Number 603-CC603JRNPO9BN101
C209, C210: 33pF; CAPC1608X90N; Manufacturer_Part_Number CL10C330JB8NNNC; Mouser Part Number 187-CL10C330JB8NNNC
D29: ESD5Z3V3; SODFL1608X70N; Manufacturer_Part_Number ESD5Z3V3; Mouser Part Number 637-ESD5Z3V3
IC5: AT24C256C-XHL-B; SOP65P640X120-8N; Manufacturer_Part_Number AT24C256C-XHL-B; Mouser Part Number 556-AT24C256C-XHL-B
IC41: PIC24FJ128GL306-I_PT; QFP50P1200X1200X120-64N; Manufacturer_Part_Number PIC24FJ128GL306-I/PT; Mouser Part Number 579-C24FJ128GL306IPT
IC42: LM75BDP,118; SOP65P490X110-8N; Manufacturer_Part_Number LM75BDP,118; Mouser Part Number 771-LM75BDP
J8: 61300611121; HDRV6W64P0X254_1X6_1524X254X869P; Manufacturer_Part_Number 61300611121; Mouser Part Number 710-61300611121
J9: 61300511121; HDRV5W64P0X254_1X5_1270X254X854P; Manufacturer_Part_Number 61300511121; Mouser Part Number 710-61300511121
LED7: 150060VS75000; LEDC1608X80N; Manufacturer_Part_Number 150060VS75000; Mouser Part Number 710-150060VS75000
Q17: 2N7002-7-F; SOT96P240X120-3N; Manufacturer_Part_Number 2N7002-7-F; Mouser Part Number 621-2N7002-F
R57, R175, R186, R189, R190, R206, R211, R217, R218, R219, R223, R224, R225, R226: 47; RESC1608X55N; Manufacturer_Part_Number RC0603FR-0747RL; Mouser Part Number 603-RC0603FR-0747RL
R123, R124, R192, R193, R194, R195, R196, R197, R200, R201, R204, R205, R207, R208, R209, R210, R213, R214, R215, R216, R220, R221: 0; RESC1608X55N; Manufacturer_Part_Number RC0603JR-070RL; Mouser Part Number 603-RC0603JR-070RL
R176, R183, R184: 5.1k; RESC1608X55N; Manufacturer_Part_Number RC0603FR-075K1L; Mouser Part Number 603-RC0603FR-075K1L
R185, R187, R222, R227: 10k; RESC1608X55N; Manufacturer_Part_Number RC0603FR-0710KL; Mouser Part Number 603-RC0603FR-0710KL
R188: 2k; ERA3AEB101V; Manufacturer_Part_Number ERA-3AEB202V; Mouser Part Number 667-ERA-3AEB202V
RT1, RT2: NTCALUG02A103G; NTCALUG02A103F; Manufacturer_Part_Number NTCALUG02A103G; Mouser Part Number 594-NTCALUG02A103G
S5: 222AMVBAR; Manufacturer_Part_Number 222AMVBAR; Mouser Part Number 774-222AMVBAR
TP74, TP75, TP76, TP77, TP78, TP79, TP80, TP81, TP82: TP
Y2: ABLS2-32.000MHZ-D4YF-T; ABLS; Manufacturer_Part_Number ABLS2-32.000MHZ-D4YF-T; Mouser Part Number 815-ABLS2-32-D4YF-T

Connections:
1kHz IN: R193.1
2.5kHz IN: R209.1
3V3: C24.2, C200.2, C201.2, C202.2, C203.2, C204.2, C205.2, C206.2, C208.2, C212.2, IC5.8 (VCC), IC41.10 (VDD_1), IC41.19 (AVDD), IC41.26 (VDD_2), IC41.38 (VDD_3), IC42.6 (A1), IC42.8 (VCC), J9.2, R176.2, R183.2, R184.2, R185.2, R188.1, R222.2, R227.2
6.25kHz IN: R210.1
16kHz IN: R195.1
63Hz IN: R194.1
160Hz IN: R208.1
400Hz IN: R207.1
AUX DET: R200.1
AVG IN: R192.1
BAR: R206.2
BAR SCLK: R211.2
BLANK: R204.2
DISPLAY BLANK: IC41.43 (SEG14/RP4/RD9)
DISPLAY LAT: IC41.42 (SEG13/RP2/RD8)
FAN EN: IC41.30 (SEG9/AN15/RP29/OCM1D/RB15)
FAN PWM: R57.2
FM INT: R124.1
FM nRST: R123.1
GND: C24.1, C198.1, C199.1, C200.1, C201.1, C202.1, C203.1, C204.1, C205.1, C206.1, C207.1, C208.1, C209.2, C210.2, C211.1, C212.1, D29.2 (A), IC5.1 (A0), IC5.2 (A1), IC5.3 (A2), IC5.4 (GND), IC5.7 (WP), IC41.9 (VSS_1), IC41.20 (AVSS), IC41.25 (VSS_2), IC41.41 (VSS_3), IC42.4 (GND), IC42.5 (A2), IC42.7 (A0), J8.1, J9.3, Q17.2 (S), R187.1, RT1.1, RT2.1, S5.1 (COM_1), S5.3 (COM_2)
IN SEL A: R220.1
IN SEL B: R221.1
IR IN: IC41.53 (SEG24/RP20/RD5)
LATCH: R205.2
MFB: R201.1
unnamed: C209.1, IC41.40 (OSCO/CLKO/RC15), Y2.2
unnamed: C210.1, IC41.39 (OSCI/CLKI/RC12), Y2.1
unnamed: IC41.2 (LCDBIAS1/RE6), R200.2
unnamed: IC41.3 (LCDBIAS0/RE7), R201.2
unnamed: IC41.5 (VLCAP1/C1INC/C2INC/C3INC/RP26/RG7), R190.2
unnamed: IC41.6 (VLCAP2/C2IND/RP19/RG8), R189.2
unnamed: IC41.7 (~MCLR), R216.1
unnamed: IC41.11 (PGC3/SEG2/AN5/C1INA/RP18/ASCL1/OCM1A/RB5), R193.2
unnamed: IC41.12 (PGD3/SEG3/AN4/C1INB/RP28/ASDA1/OCM1B/RB4), R192.2
unnamed: IC41.13 (SEG4/AN3/C2INA/RB3), R194.2
unnamed: IC41.14 (SEG5/AN2/C2INB/RP13/RB2), R195.2
unnamed: IC41.15 (PGC1/SEG6/CVREF-/AN1/AN1-/RP1/RB1), R196.2
unnamed: IC41.16 (PGD1/SEG7/VREF+/CVREF+/AN0/RP0/RB0), R197.2
unnamed: IC41.17 (PGC2/LCDBIAS3/AN6/RP6/RB6), R207.2
unnamed: IC41.18 (PGD2/AN7/RP7/T1CK/RB7), R208.2
unnamed: IC41.21 (COM7/SEG31/AN8/RP8/RB8), R209.2
unnamed: IC41.22 (COM6/SEG30/AN9/RP9/RB9), R210.2
unnamed: IC41.23 (TMS/COM5/SEG29/CVREF/AN10/RP15/RB10), R221.2
unnamed: IC41.24 (TDO/AN11/RB11), R220.2
unnamed: IC41.29 (SEG8/AN14/RP14/OCM1C/RB14), R57.1
unnamed: IC41.31 (SEG10/RP10/SDA2/RF4), R124.2
unnamed: IC41.32 (SEG11/RP17/SCL2/RF5), R123.2
unnamed: IC41.33 (SEG12/RP16/RF3), R226.1
unnamed: IC41.34 (SEG40/RP30/RF2), R225.1
unnamed: IC41.36 (SEG47/RP31/SDA1/OCM1F/RG3), R219.1
unnamed: IC41.37 (SEG28/SCL1/RG2), R218.1
unnamed: IC41.45 (SEG16/C3INC/RP12/RD11), R224.1
unnamed: IC41.46 (SEG17/RP11/RD0), R223.1
unnamed: IC41.49 (SEG20/RP24/RD1), R211.1
unnamed: IC41.50 (SEG21/RP23/RD2), R206.1
unnamed: IC41.51 (SEG22/RP22/RD3), R217.1
unnamed: IC41.52 (SEG23/RP25/RD4), R186.1
unnamed: IC41.54 (SEG25/C3INB/RD6), R214.1
unnamed: IC41.55 (SEG26/C3INA/RD7), R213.1
unnamed: IC41.57 (AN16/RA0), R215.1
unnamed: IC41.58 (SEG27/RF0), R175.1
unnamed: IC41.61 (COM2/RE1), R205.1
unnamed: IC41.62 (COM1/RE2), R204.1
unnamed: LED7.1 (K), Q17.3 (D)
unnamed: LED7.2 (A), R188.2
OUTPUT TEMP: C211.2, IC41.28 (TDI/SEG19/AN13/RB13), R227.1, RT2.2, TP82.1
PGC: J9.5, R196.1, TP80.1
PGD: J9.4, R197.1, TP79.1
PLAY_PAUSE: R215.2
REG TEMP: C207.2, IC41.27 (TCK/SEG18/AN12/RB12), R222.1, RT1.2, TP81.1
RXD: J8.5, R190.1, TP77.1
SCL: IC5.6 (SCL), IC42.2 (SCL), R183.1, R218.2, TP75.1
SDA: IC5.5 (SDA), IC42.1 (SDA), R184.1, R219.2, TP74.1
SPI1 CS EQ: R176.1, R223.2
SPI1 MISO: R224.2
SPI1 MOSI: R225.2
SPI1 SCLK: R226.2
TEST: IC41.8 (SEG1/C2INC/RP27/RG9), Q17.1 (G), R187.2
TUNE A: IC41.48 (SOSCO/SCLKI/RPI37/PWRLCLK/RC14)
TUNE B: IC41.47 (SOSCI/RC13)
TXD: J8.4, R189.1, TP76.1
UART RXD: R217.2
UART TXD: R186.2
VCAP: C198.2, IC41.56 (VCAP)
VOL A: IC41.44 (SEG15/C3IND/RP3/RD10)
VOL B: R175.2
VOL+: R214.2
VOL-: R213.2
nDISPLAY: IC41.59 (COM4/SEG48/OCM1E/RF1)
nMCLR: C199.2, D29.1 (K), J9.1, R185.1, R216.2, S5.2 (NO_1), S5.4 (NO_2), TP78.1
nMULTI1: IC41.64 (SEG63/HLVDIN/RE4)
nMULTI2: IC41.1 (LCDBIAS2/RE5)
nSOURCE: IC41.60 (COM3/RE0)

Notes on the sheet:
Micro
TEMP SENSOR
reset button
Write Address: 0xA0 Read Address: 0xA1
EEPROM
7 bit address: 0x4A
Write Address: 0x94 Read Address: 0x95
7 bit address: 0x50
