Alex-Wolfe/Home-Audio-System/Hardware/Design/Main Board/Native Kicad/Output Stage R.kicad_sch

## KiCad design Hardware/Design/Main Board/Native Kicad/Output Stage R.kicad_sch (2025-06-05)

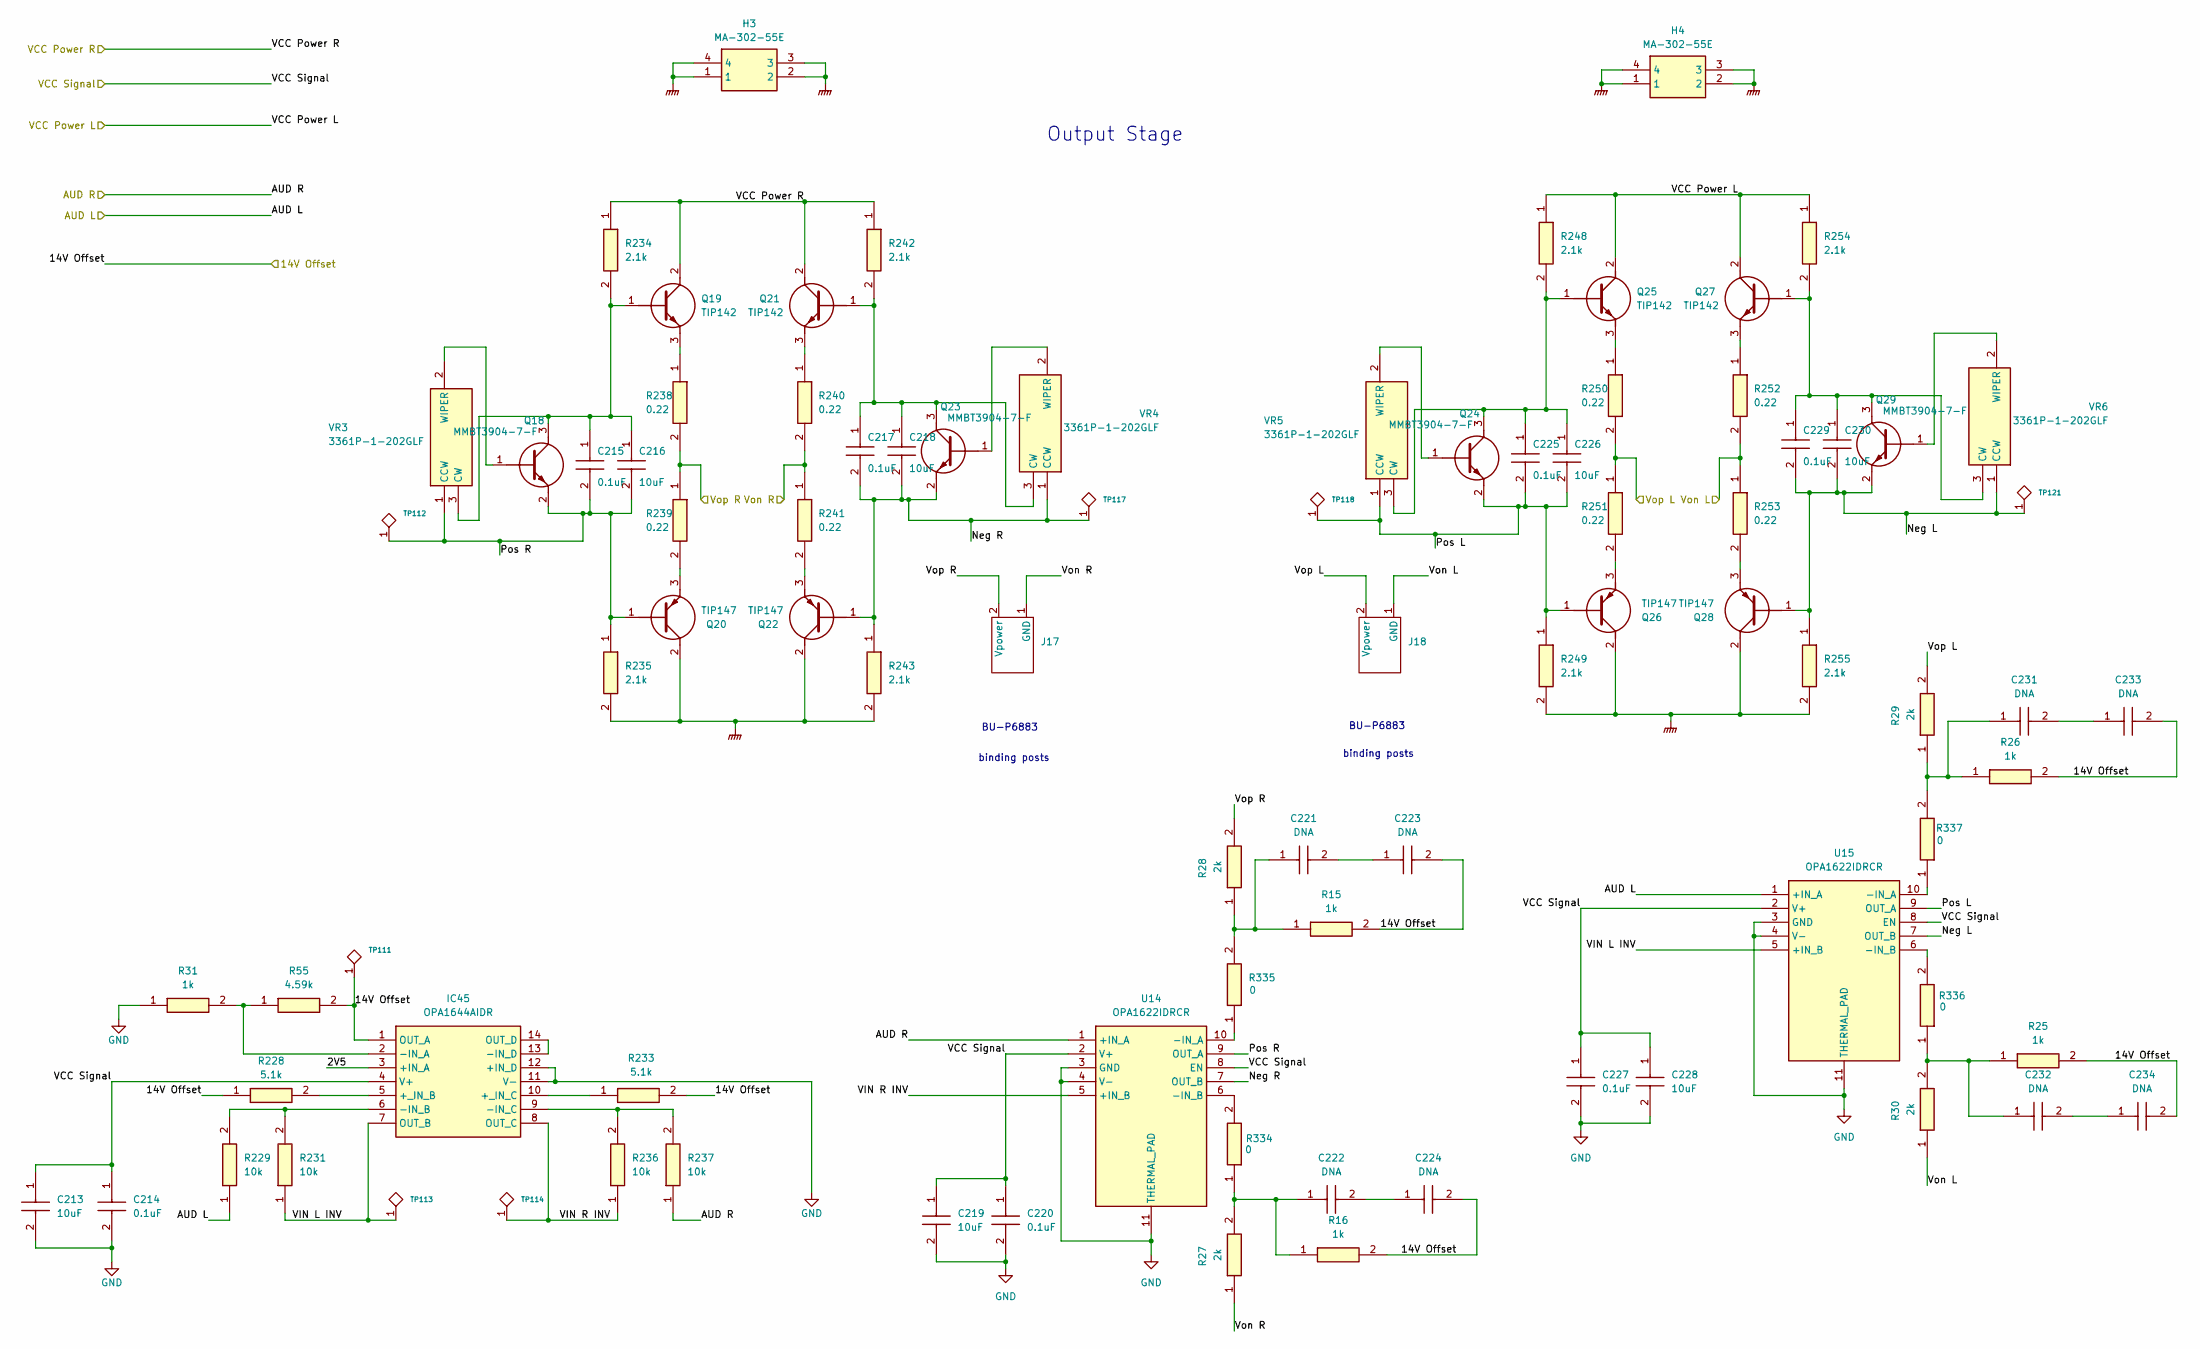
[picture p84: schematic Output Stage R.kicad_sch]

Parts:
C213, C216, C218, C219, C226, C228, C230: 10uF; GRM21x; Manufacturer_Part_Number GRM21BR61H106KE43L; Mouser Part Number 81-GRM21BR61H106KE3L
C214, C215, C217, C220, C225, C227, C229: 0.1uF; C0603; Manufacturer_Part_Number C0603C104M5RACTU; Mouser Part Number 80-C0603C104M5R
C221, C222, C223, C224, C231, C232, C233, C234: DNA; C0603; Manufacturer_Part_Number C0603C104M5RACTU; Mouser Part Number 80-C0603C104M5R
H3, H4: MA-302-55E; MA30255E; Manufacturer_Part_Number MA-302-55E; Mouser Part Number 588-MA-302-55E
IC45: OPA1644AIDR; SOIC127P600X175-14N; Manufacturer_Part_Number OPA1644AIDR; Mouser Part Number 595-OPA1644AIDR
J17, J18: power wires
Q18, Q23, Q24, Q29: MMBT3904-7-F; SOT96P240X110-3N; Manufacturer_Part_Number MMBT3904-7-F; Mouser Part Number 621-MMBT3904-F
Q19, Q21, Q25, Q27: TIP142; TO545P500X1560X2420-3P; Manufacturer_Part_Number TIP142
Q20, Q22, Q26, Q28: TIP147; TO545P515X1560X2445-3P; Manufacturer_Part_Number TIP147; Mouser Part Number 511-TIP147
R15, R16, R25, R26, R31: 1k; ERA3AEB101V; Manufacturer_Part_Number ERA-3AEB102V; Mouser Part Number 667-ERA-3AEB102V
R27, R28, R29, R30: 2k; ERA3AEB101V; Manufacturer_Part_Number ERA-3AEB202V; Mouser Part Number 667-ERA-3AEB202V
R55: 4.59k; RESC1608X55N; Manufacturer_Part_Number TNPW06034K59BEEA
R228, R233: 5.1k; RESC1608X55N; Manufacturer_Part_Number RT0603FRE075K1L; Mouser Part Number 603-RT0603FRE075K1L
R229, R231, R236, R237: 10k; ERA3AEB101V; Manufacturer_Part_Number ERA-3AEB103V; Mouser Part Number 667-ERA-3AEB103V
R234, R235, R242, R243, R248, R249, R254, R255: 2.1k; RESC3216X70N; Manufacturer_Part_Number ERA-8APB2101V
R238, R239, R240, R241, R250, R251, R252, R253: 0.22; RESC6432X84N; Manufacturer_Part_Number RLP73K3AR22JTE
R334, R335, R336, R337: 0; RESC1608X55N; Manufacturer_Part_Number RC0603JR-070RL; Mouser Part Number 603-RC0603JR-070RL
TP111, TP112, TP113, TP114, TP117, TP118, TP121: TP
U14, U15: OPA1622IDRCR; SON50P300X300X100-11N; Manufacturer_Part_Number OPA1622IDRCR; Mouser Part Number 595-OPA1622IDRCR
VR3, VR4, VR5, VR6: 3361P-1-202GLF; 3361P1202GLF; Manufacturer_Part_Number 3361P-1-202GLF; Mouser Part Number 652-3361P-1-202GLF

Connections:
2V5: IC45.3 (+IN_A)
14V Offset: C223.2, C224.2, C233.2, C234.2, IC45.1 (OUT_A), R15.2, R16.2, R25.2, R26.2, R55.2, R228.1, R233.2, TP111.1
AUD L: R229.1, U15.1 (+IN_A)
AUD R: R237.1, U14.1 (+IN_A)
GND: C213.2, C214.2, C219.2, C220.2, C227.2, C228.2, IC45.11 (V-), IC45.12 (+IN_D), R31.1, U14.3 (GND), U14.4 (V-), U14.11 (THERMAL_PAD), U15.3 (GND), U15.4 (V-), U15.11 (THERMAL_PAD)
GNDPWR: H3.1, H3.2, H3.3, H3.4, H4.1, H4.2, H4.3, H4.4, Q20.2 (C), Q22.2 (C), Q26.2 (C), Q28.2 (C), R235.2, R243.2, R249.2, R255.2
Neg L: C229.2, C230.2, Q28.1 (B), Q29.2 (E), R255.1, TP121.1, U15.7 (OUT_B), VR6.1 (CCW)
Neg R: C217.2, C218.2, Q22.1 (B), Q23.2 (E), R243.1, TP117.1, U14.7 (OUT_B), VR4.1 (CCW)
unnamed: C215.1, C216.1, Q18.3 (C), Q19.1 (B), R234.2, VR3.3 (CW)
unnamed: C217.1, C218.1, Q21.1 (B), Q23.3 (C), R242.2, VR4.3 (CW)
unnamed: C221.1, R15.1, R28.1, R335.2
unnamed: C221.2, C223.1
unnamed: C222.1, R16.1, R27.2, R334.1
unnamed: C222.2, C224.1
unnamed: C225.1, C226.1, Q24.3 (C), Q25.1 (B), R248.2, VR5.3 (CW)
unnamed: C229.1, C230.1, Q27.1 (B), Q29.3 (C), R254.2, VR6.3 (CW)
unnamed: C231.1, R26.1, R29.1, R337.2
unnamed: C231.2, C233.1
unnamed: C232.1, R25.1, R30.2, R336.1
unnamed: C232.2, C234.1
unnamed: IC45.2 (-IN_A), R31.2, R55.1
unnamed: IC45.5 (+_IN_B), R228.2
unnamed: IC45.6 (-IN_B), R229.2, R231.2
unnamed: IC45.9 (-IN_C), R236.2, R237.2
unnamed: IC45.10 (+_IN_C), R233.1
unnamed: IC45.13 (-IN_D), IC45.14 (OUT_D)
unnamed: Q18.1 (B), VR3.2 (WIPER)
unnamed: Q19.3 (E), R238.1
unnamed: Q20.3 (E), R239.2
unnamed: Q21.3 (E), R240.1
unnamed: Q22.3 (E), R241.2
unnamed: Q23.1 (B), VR4.2 (WIPER)
unnamed: Q24.1 (B), VR5.2 (WIPER)
unnamed: Q25.3 (E), R250.1
unnamed: Q26.3 (E), R251.2
unnamed: Q27.3 (E), R252.1
unnamed: Q28.3 (E), R253.2
unnamed: Q29.1 (B), VR6.2 (WIPER)
unnamed: R334.2, U14.6 (-IN_B)
unnamed: R335.1, U14.10 (-IN_A)
unnamed: R336.2, U15.6 (-IN_B)
unnamed: R337.1, U15.10 (-IN_A)
Pos L: C225.2, C226.2, Q24.2 (E), Q26.1 (B), R249.1, TP118.1, U15.9 (OUT_A), VR5.1 (CCW)
Pos R: C215.2, C216.2, Q18.2 (E), Q20.1 (B), R235.1, TP112.1, U14.9 (OUT_A), VR3.1 (CCW)
VCC Power L: Q25.2 (C), Q27.2 (C), R248.1, R254.1
VCC Power R: Q19.2 (C), Q21.2 (C), R234.1, R242.1
VCC Signal: C213.1, C214.1, C219.1, C220.1, C227.1, C228.1, IC45.4 (V+), U14.2 (V+), U14.8 (EN), U15.2 (V+), U15.8 (EN)
VIN L INV: IC45.7 (OUT_B), R231.1, TP113.1, U15.5 (+IN_B)
VIN R INV: IC45.8 (OUT_C), R236.1, TP114.1, U14.5 (+IN_B)
Von L: J18.1 (GND), R30.1, R252.2, R253.1
Von R: J17.1 (GND), R27.1, R240.2, R241.1
Vop L: J18.2 (Vpower), R29.2, R250.2, R251.1
Vop R: J17.2 (Vpower), R28.2, R238.2, R239.1

Notes on the sheet:
BU-P6883
Output Stage
binding posts
