Alex-Wolfe/Home-Audio-System/Hardware/Design/Main Board/Native Kicad/Output Stage.kicad_sch

## KiCad design Hardware/Design/Main Board/Native Kicad/Output Stage.kicad_sch (2025-06-05)

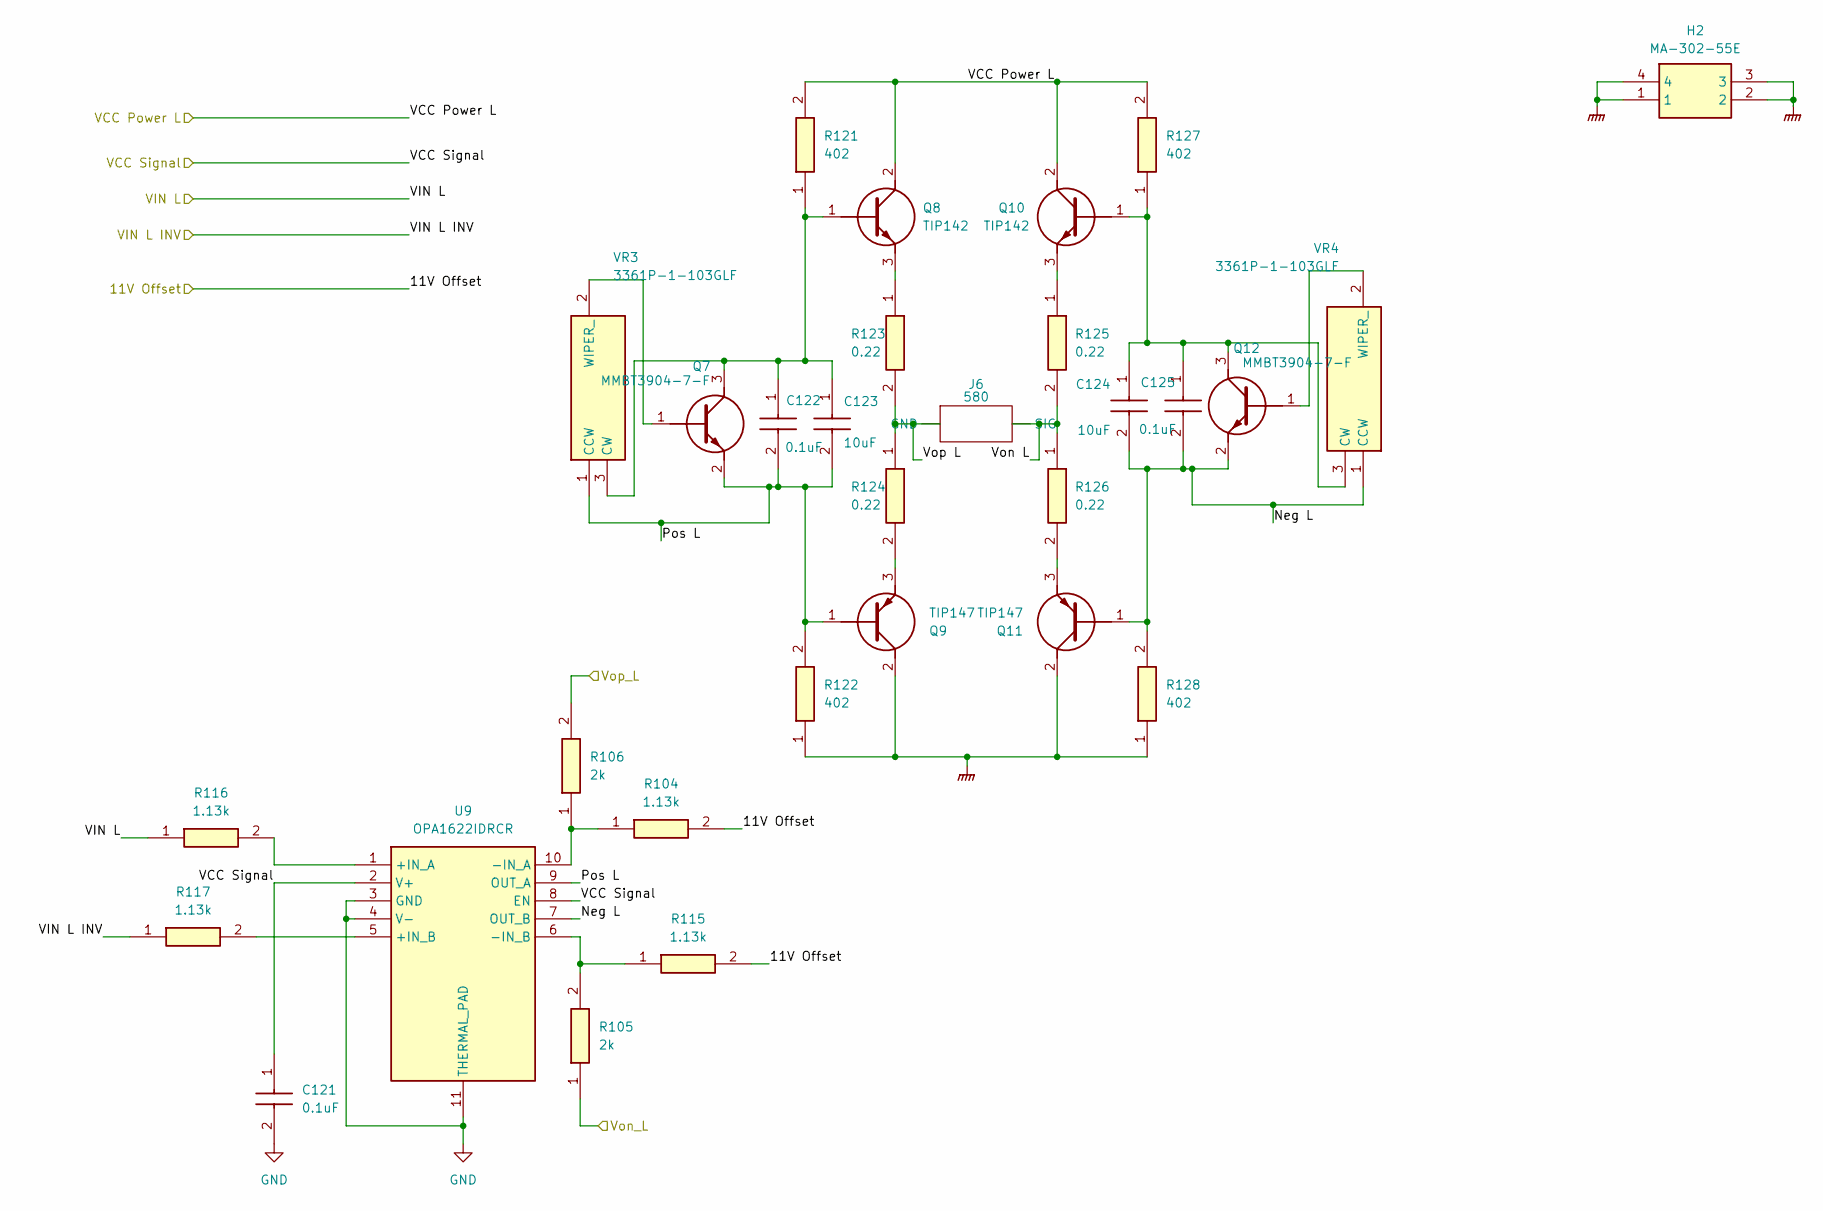
[picture p85: schematic Output Stage.kicad_sch]

Parts:
C121, C122, C125: 0.1uF; CAPC2012X95N; Manufacturer_Part_Number CL21B104KACNNNC; Mouser Part Number 187-CL21B104KACNNNC
C123, C124: 10uF; CAPC3216X180N; Manufacturer_Part_Number CL31A106MBHNNNE; Mouser Part Number 187-CL31A106MBHNNNE
H2: MA-302-55E; MA30255E; Manufacturer_Part_Number MA-302-55E; Mouser Part Number 588-MA-302-55E
J6: 580
Q7, Q12: MMBT3904-7-F; SOT96P240X110-3N; Manufacturer_Part_Number MMBT3904-7-F; Mouser Part Number 621-MMBT3904-F
Q8, Q10: TIP142; TO545P500X1560X2420-3P; Manufacturer_Part_Number TIP142
Q9, Q11: TIP147; TO545P515X1560X2445-3P; Manufacturer_Part_Number TIP147; Mouser Part Number 511-TIP147
R104, R115, R116, R117: 1.13k; ERA6AEB1020V; Manufacturer_Part_Number ERA-6AEB1131V; Mouser Part Number 667-ERA-6AEB1131V
R105, R106: 2k; ERA6AEB1020V; Manufacturer_Part_Number ERA-6AEB202V; Mouser Part Number 667-ERA-6AEB202V
R121, R122, R127, R128: 402; ERA6AEB1020V; Manufacturer_Part_Number ERA-6AEB4020V
R123, R124, R125, R126: 0.22; RESC6432X84N; Manufacturer_Part_Number RLP73K3AR22JTE
U9: OPA1622IDRCR; SON50P300X300X100-11N; Manufacturer_Part_Number OPA1622IDRCR; Mouser Part Number 595-OPA1622IDRCR
VR3, VR4: 3361P-1-103GLF; 3361P1103GLF; Manufacturer_Part_Number 3361P-1-103GLF; Mouser Part Number 652-3361P-1-103GLF

Connections:
11V Offset: R104.2, R115.2
GND: C121.2, U9.3 (GND), U9.4 (V-), U9.11 (THERMAL_PAD)
GNDPWR: H2.1, H2.2, H2.3, H2.4, Q9.2 (C), Q11.2 (C), R122.1, R128.1
Neg L: C124.2, C125.2, Q11.1 (B), Q12.2 (E), R128.2, U9.7 (OUT_B), VR4.1 (CCW)
unnamed: C122.1, C123.1, Q7.3 (C), Q8.1 (B), R121.1, VR3.3 (CW)
unnamed: C124.1, C125.1, Q10.1 (B), Q12.3 (C), R127.1, VR4.3 (CW)
unnamed: Q7.1 (B), VR3.2 (WIPER_)
unnamed: Q8.3 (E), R123.1
unnamed: Q9.3 (E), R124.2
unnamed: Q10.3 (E), R125.1
unnamed: Q11.3 (E), R126.2
unnamed: Q12.1 (B), VR4.2 (WIPER_)
unnamed: R104.1, R106.1, U9.10 (-IN_A)
unnamed: R105.2, R115.1, U9.6 (-IN_B)
unnamed: R116.2, U9.1 (+IN_A)
unnamed: R117.2, U9.5 (+IN_B)
Pos L: C122.2, C123.2, Q7.2 (E), Q9.1 (B), R122.2, U9.9 (OUT_A), VR3.1 (CCW)
VCC Power L: Q8.2 (C), Q10.2 (C), R121.2, R127.2
VCC Signal: C121.1, U9.2 (V+), U9.8 (EN)
VIN L: R116.1
VIN L INV: R117.1
Von L: J6., R125.2, R126.1
Von_L: R105.1
Vop L: J6., R123.2, R124.1
Vop_L: R106.2
