Alex-Wolfe/Home-Audio-System/Hardware/Design/Main Board/Native Kicad/Peak Sampling Circuits.kicad_sch

## KiCad design Hardware/Design/Main Board/Native Kicad/Peak Sampling Circuits.kicad_sch (2025-06-05)

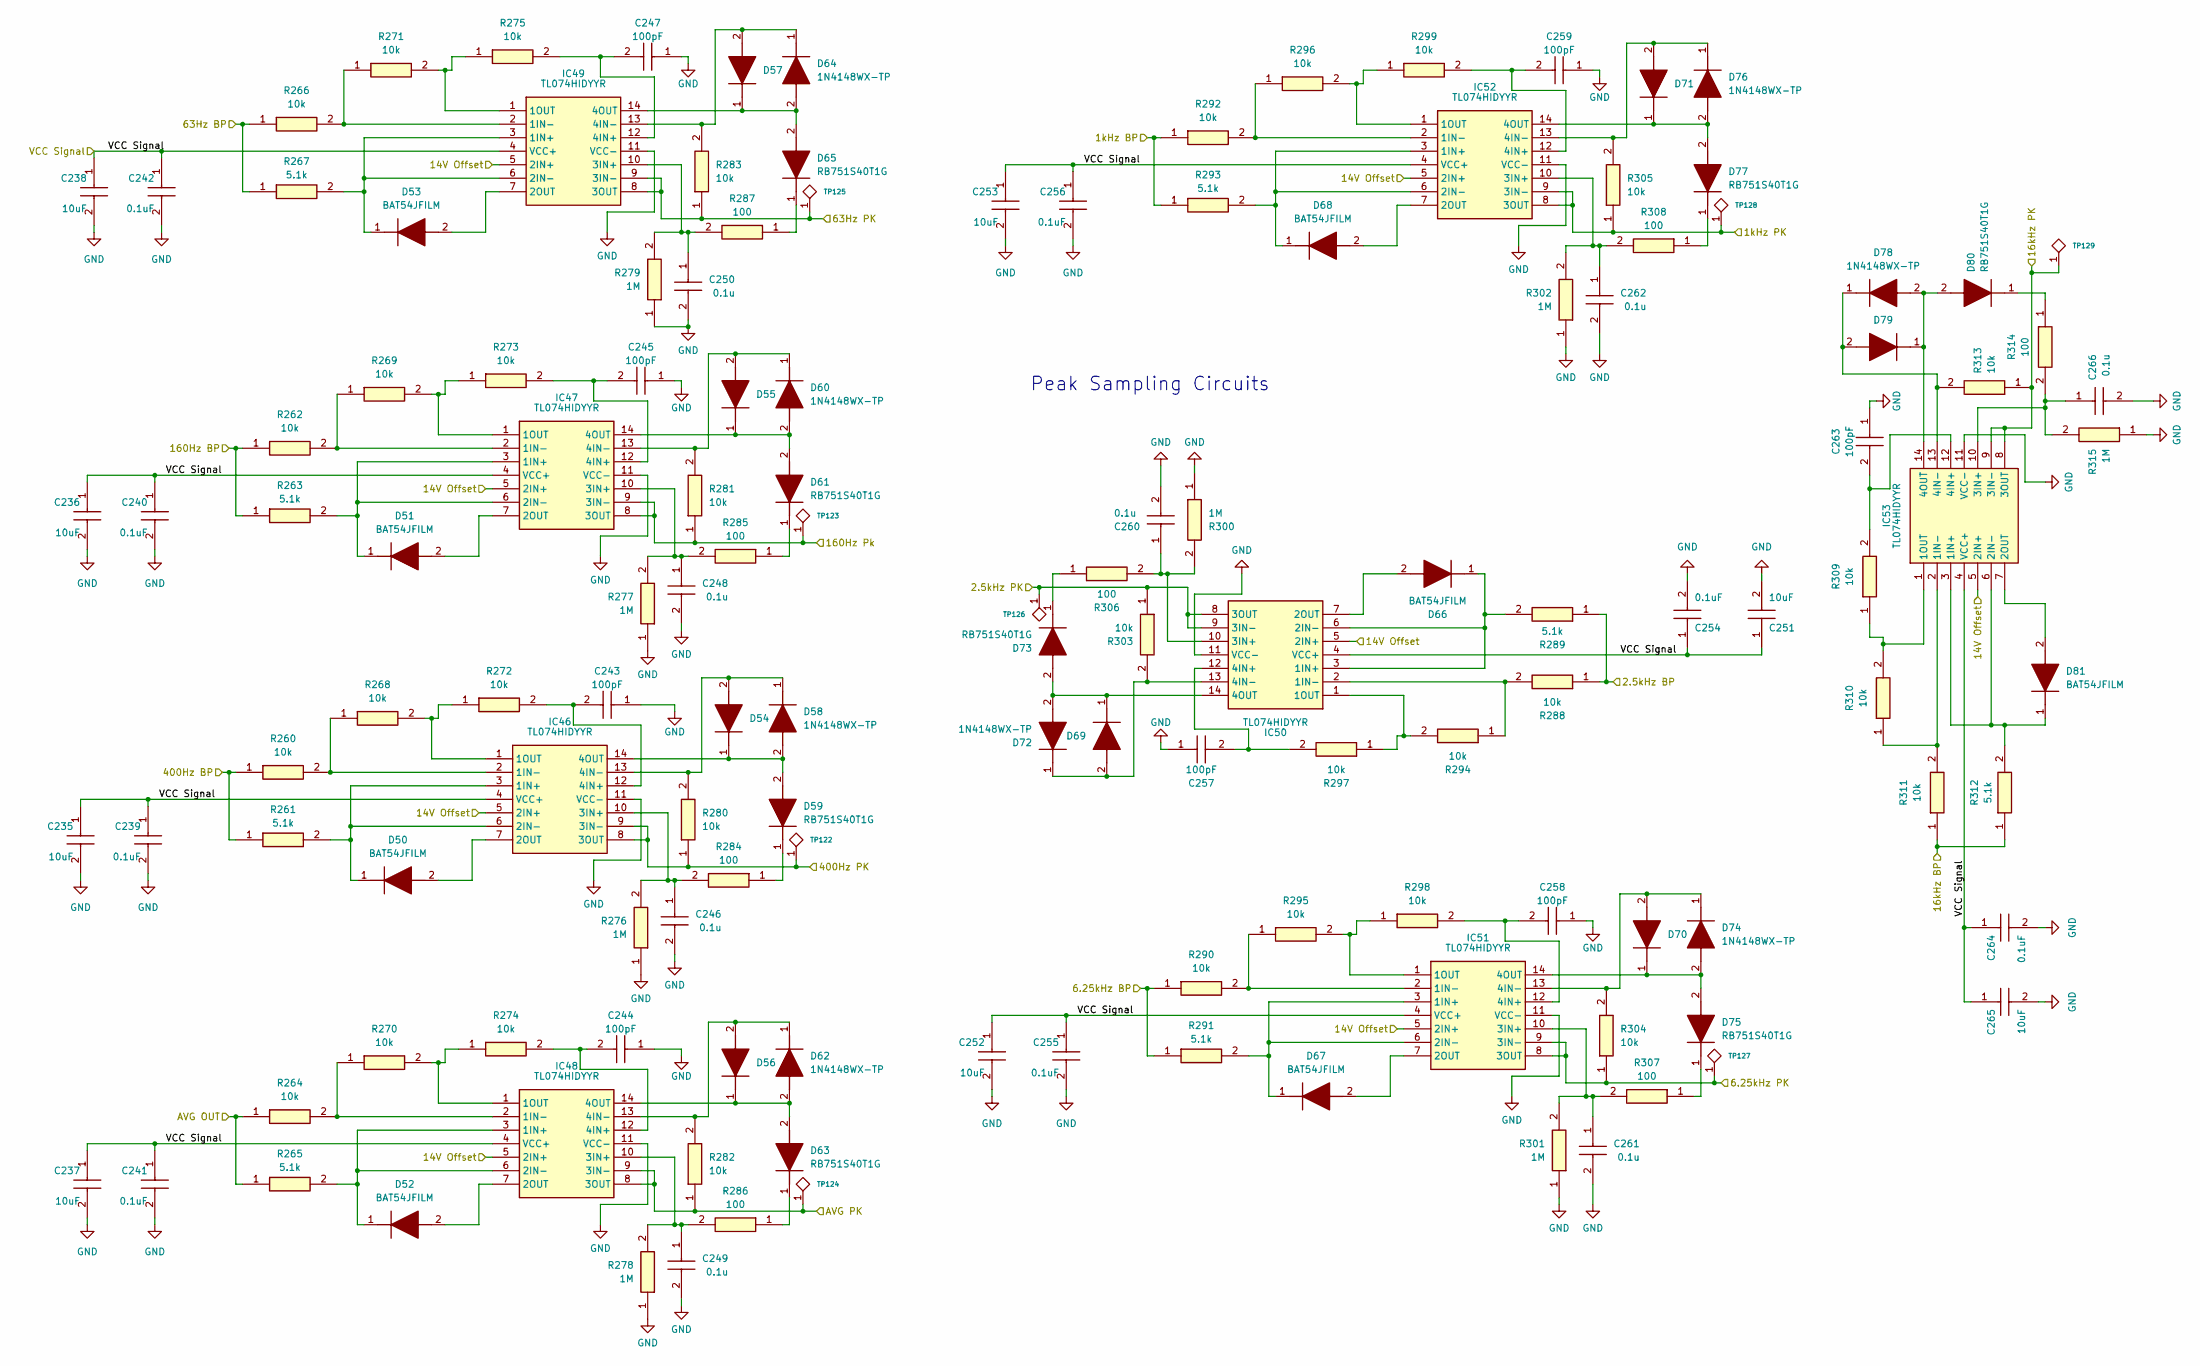
[picture p86: schematic Peak Sampling Circuits.kicad_sch]

Parts:
C235, C236, C237, C238, C251, C252, C253, C265: 10uF; GRM21x; Manufacturer_Part_Number GRM21BR61H106KE43L; Mouser Part Number 81-GRM21BR61H106KE3L
C239, C240, C241, C242, C254, C255, C256, C264: 0.1uF; C0603; Manufacturer_Part_Number C0603C104M5RACTU; Mouser Part Number 80-C0603C104M5R
C243, C244, C245, C247, C257, C258, C259, C263: 100pF; CAPC1608X87N; Manufacturer_Part_Number CC0603JRNPO9BN101; Mouser Part Number 603-CC603JRNPO9BN101
C246, C248, C249, C250, C260, C261, C262, C266: 0.1u; CAPC1608X90N; Manufacturer_Part_Number CC0603KRX7R7BB104; Mouser Part Number 603-CC603KRX7R7BB104
D50, D51, D52, D53, D66, D67, D68, D81: BAT54JFILM; 1N4148WT7; Manufacturer_Part_Number 1N4148WT-7; Mouser Part Number 621-1N4148WT
D54, D55, D56, D57, D58, D60, D62, D64, D69, D70, D71, D72, D74, D76, D78, D79: 1N4148WX-TP; 1N4148WT7; Manufacturer_Part_Number 1N4148WT-7; Mouser Part Number 621-1N4148WT
D59, D61, D63, D65, D73, D75, D77, D80: RB751S40T1G; SODFL1608X70N; Manufacturer_Part_Number RB751S40T1G; Mouser Part Number 863-RB751S40T1G
IC46, IC47, IC48, IC49, IC50, IC51, IC52, IC53: TL074HIDYYR; SOP50P326X110-14N; Manufacturer_Part_Number TL074HIDYYR; Mouser Part Number 595-TL074HIDYYR
R260, R262, R264, R266, R268, R269, R270, R271, R272, R273, R274, R275, R280, R281, R282, R283, R288, R290, R292, R294, R295, R296, R297, R298, R299, R303, R304, R305, R309, R310, R311, R313: 10k; RESC1608X55N; Manufacturer_Part_Number RC0603FR-0710KL; Mouser Part Number 603-RC0603FR-0710KL
R261, R263, R265, R267, R289, R291, R293, R312: 5.1k; RESC1608X55N; Manufacturer_Part_Number RC0603FR-075K1L; Mouser Part Number 603-RC0603FR-075K1L
R276, R277, R278, R279, R300, R301, R302, R315: 1M; RESC1608X55N; Manufacturer_Part_Number RC0603FR-071ML; Mouser Part Number 603-RC0603FR-071ML
R284, R285, R286, R287, R306, R307, R308, R314: 100; RESC1608X55N; Manufacturer_Part_Number RC0603FR-07100RL; Mouser Part Number 603-RC0603FR-07100RL
TP122, TP123, TP124, TP125, TP126, TP127, TP128, TP129: TP

Connections:
1kHz BP: R292.1, R293.1
1kHz PK: IC52.8 (3OUT), IC52.9 (3IN-), R305.1, TP128.1
2.5kHz BP: R288.1, R289.1
2.5kHz PK: IC50.8 (3OUT), IC50.9 (3IN-), R303.1, TP126.1
6.25kHz BP: R290.1, R291.1
6.25kHz PK: IC51.8 (3OUT), IC51.9 (3IN-), R304.1, TP127.1
14V Offset: IC46.5 (2IN+), IC47.5 (2IN+), IC48.5 (2IN+), IC49.5 (2IN+), IC50.5 (2IN+), IC51.5 (2IN+), IC52.5 (2IN+), IC53.5 (2IN+)
16kHz BP: R311.1, R312.1
16kHz PK: IC53.8 (3OUT), IC53.9 (3IN-), R313.1, TP129.1
63Hz BP: R266.1, R267.1
63Hz PK: IC49.8 (3OUT), IC49.9 (3IN-), R283.1, TP125.1
160Hz BP: R262.1, R263.1
160Hz Pk: IC47.8 (3OUT), IC47.9 (3IN-), R281.1, TP123.1
400Hz BP: R260.1, R261.1
400Hz PK: IC46.8 (3OUT), IC46.9 (3IN-), R280.1, TP122.1
AVG OUT: R264.1, R265.1
AVG PK: IC48.8 (3OUT), IC48.9 (3IN-), R282.1, TP124.1
GND: C235.2, C236.2, C237.2, C238.2, C239.2, C240.2, C241.2, C242.2, C243.1, C244.1, C245.1, C246.2, C247.1, C248.2, C249.2, C250.2, C251.2, C252.2, C253.2, C254.2, C255.2, C256.2, C257.1, C258.1, C259.1, C260.2, C261.2, C262.2, C263.1, C264.2, C265.2, C266.2, IC46.11 (VCC-), IC47.11 (VCC-), IC48.11 (VCC-), IC49.11 (VCC-), IC50.11 (VCC-), IC51.11 (VCC-), IC52.11 (VCC-), IC53.11 (VCC-), R276.1, R277.1, R278.1, R279.1, R300.1, R301.1, R302.1, R315.1
unnamed: C243.2, IC46.12 (4IN+), R272.2
unnamed: C244.2, IC48.12 (4IN+), R274.2
unnamed: C245.2, IC47.12 (4IN+), R273.2
unnamed: C246.1, IC46.10 (3IN+), R276.2, R284.2
unnamed: C247.2, IC49.12 (4IN+), R275.2
unnamed: C248.1, IC47.10 (3IN+), R277.2, R285.2
unnamed: C249.1, IC48.10 (3IN+), R278.2, R286.2
unnamed: C250.1, IC49.10 (3IN+), R279.2, R287.2
unnamed: C257.2, IC50.12 (4IN+), R297.2
unnamed: C258.2, IC51.12 (4IN+), R298.2
unnamed: C259.2, IC52.12 (4IN+), R299.2
unnamed: C260.1, IC50.10 (3IN+), R300.2, R306.2
unnamed: C261.1, IC51.10 (3IN+), R301.2, R307.2
unnamed: C262.1, IC52.10 (3IN+), R302.2, R308.2
unnamed: C263.2, IC53.12 (4IN+), R309.2
unnamed: C266.1, IC53.10 (3IN+), R314.2, R315.2
unnamed: D50.1 (K), IC46.3 (1IN+), IC46.6 (2IN-), R261.2
unnamed: D50.2 (A), IC46.7 (2OUT)
unnamed: D51.1 (K), IC47.3 (1IN+), IC47.6 (2IN-), R263.2
unnamed: D51.2 (A), IC47.7 (2OUT)
unnamed: D52.1 (K), IC48.3 (1IN+), IC48.6 (2IN-), R265.2
unnamed: D52.2 (A), IC48.7 (2OUT)
unnamed: D53.1 (K), IC49.3 (1IN+), IC49.6 (2IN-), R267.2
unnamed: D53.2 (A), IC49.7 (2OUT)
unnamed: D54.1 (K), D58.2 (A), D59.2 (A), IC46.14 (4OUT)
unnamed: D54.2 (A), D58.1 (K), IC46.13 (4IN-), R280.2
unnamed: D55.1 (K), D60.2 (A), D61.2 (A), IC47.14 (4OUT)
unnamed: D55.2 (A), D60.1 (K), IC47.13 (4IN-), R281.2
unnamed: D56.1 (K), D62.2 (A), D63.2 (A), IC48.14 (4OUT)
unnamed: D56.2 (A), D62.1 (K), IC48.13 (4IN-), R282.2
unnamed: D57.1 (K), D64.2 (A), D65.2 (A), IC49.14 (4OUT)
unnamed: D57.2 (A), D64.1 (K), IC49.13 (4IN-), R283.2
unnamed: D59.1 (K), R284.1
unnamed: D61.1 (K), R285.1
unnamed: D63.1 (K), R286.1
unnamed: D65.1 (K), R287.1
unnamed: D66.1 (K), IC50.3 (1IN+), IC50.6 (2IN-), R289.2
unnamed: D66.2 (A), IC50.7 (2OUT)
unnamed: D67.1 (K), IC51.3 (1IN+), IC51.6 (2IN-), R291.2
unnamed: D67.2 (A), IC51.7 (2OUT)
unnamed: D68.1 (K), IC52.3 (1IN+), IC52.6 (2IN-), R293.2
unnamed: D68.2 (A), IC52.7 (2OUT)
unnamed: D69.1 (K), D72.2 (A), D73.2 (A), IC50.14 (4OUT)
unnamed: D69.2 (A), D72.1 (K), IC50.13 (4IN-), R303.2
unnamed: D70.1 (K), D74.2 (A), D75.2 (A), IC51.14 (4OUT)
unnamed: D70.2 (A), D74.1 (K), IC51.13 (4IN-), R304.2
unnamed: D71.1 (K), D76.2 (A), D77.2 (A), IC52.14 (4OUT)
unnamed: D71.2 (A), D76.1 (K), IC52.13 (4IN-), R305.2
unnamed: D73.1 (K), R306.1
unnamed: D75.1 (K), R307.1
unnamed: D77.1 (K), R308.1
unnamed: D78.1 (K), D79.2 (A), IC53.13 (4IN-), R313.2
unnamed: D78.2 (A), D79.1 (K), D80.2 (A), IC53.14 (4OUT)
unnamed: D80.1 (K), R314.1
unnamed: D81.1 (K), IC53.3 (1IN+), IC53.6 (2IN-), R312.2
unnamed: D81.2 (A), IC53.7 (2OUT)
unnamed: IC46.1 (1OUT), R268.2, R272.1
unnamed: IC46.2 (1IN-), R260.2, R268.1
unnamed: IC47.1 (1OUT), R269.2, R273.1
unnamed: IC47.2 (1IN-), R262.2, R269.1
unnamed: IC48.1 (1OUT), R270.2, R274.1
unnamed: IC48.2 (1IN-), R264.2, R270.1
unnamed: IC49.1 (1OUT), R271.2, R275.1
unnamed: IC49.2 (1IN-), R266.2, R271.1
unnamed: IC50.1 (1OUT), R294.2, R297.1
unnamed: IC50.2 (1IN-), R288.2, R294.1
unnamed: IC51.1 (1OUT), R295.2, R298.1
unnamed: IC51.2 (1IN-), R290.2, R295.1
unnamed: IC52.1 (1OUT), R296.2, R299.1
unnamed: IC52.2 (1IN-), R292.2, R296.1
unnamed: IC53.1 (1OUT), R309.1, R310.2
unnamed: IC53.2 (1IN-), R310.1, R311.2
VCC Signal: C235.1, C236.1, C237.1, C238.1, C239.1, C240.1, C241.1, C242.1, C251.1, C252.1, C253.1, C254.1, C255.1, C256.1, C264.1, C265.1, IC46.4 (VCC+), IC47.4 (VCC+), IC48.4 (VCC+), IC49.4 (VCC+), IC50.4 (VCC+), IC51.4 (VCC+), IC52.4 (VCC+), IC53.4 (VCC+)

Notes on the sheet:
Peak Sampling Circuits
