Alex-Wolfe/Home-Audio-System/Hardware/Design/Main Board/Native Kicad/Right Channel Power.kicad_sch

## KiCad design Hardware/Design/Main Board/Native Kicad/Right Channel Power.kicad_sch (2025-06-05)

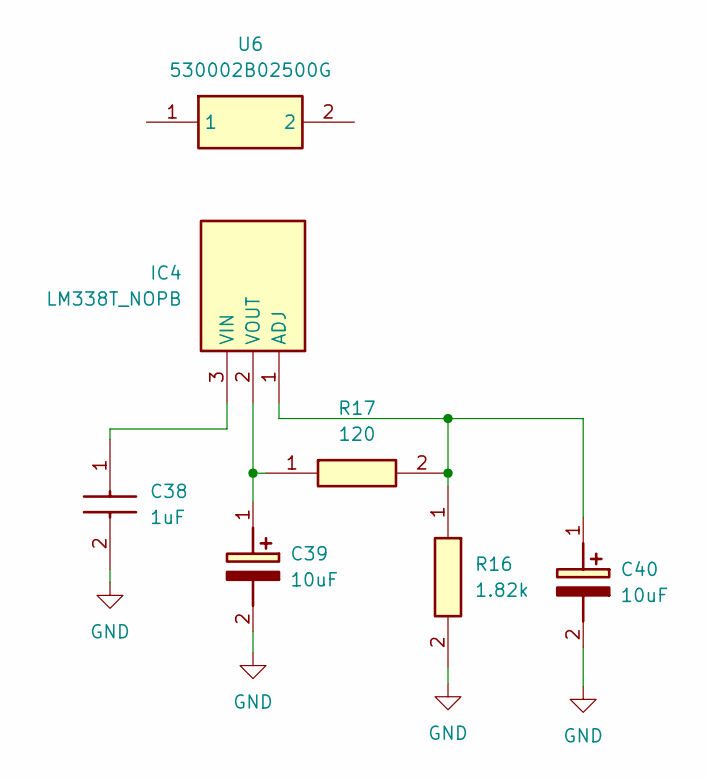
[picture p87: schematic Right Channel Power.kicad_sch]

Parts:
C38: 1uF; CAPC2012X135N; Manufacturer_Part_Number CL21B105KOFNNNE; Mouser Part Number 187-CL21B105KOFNNNE
C39, C40: 10uF; CAPPRD200W55D500H1200; Manufacturer_Part_Number A759BQ106M1VAAE090; Mouser Part Number 80-A759BQ106M1VAAE90
IC4: LM338T_NOPB; TO254P470X1028X1955-3P; Manufacturer_Part_Number LM338T/NOPB; Mouser Part Number 926-LM338T/NOPB
R16: 1.82k; RESC3116X65N; Manufacturer_Part_Number RC1206FR-071K82L; Mouser Part Number 603-RC1206FR-071K82L
R17: 120; RESC2012X60N; Manufacturer_Part_Number RC0805FR-07120RL; Mouser Part Number 603-RC0805FR-07120RL
U6: 530002B02500G; 529802B02500G; Manufacturer_Part_Number 530002B02500G; Mouser Part Number 532-530002B02500G

Connections:
GND: C38.2, C39.2 (-), C40.2 (-), R16.2
unnamed: C38.1, IC4.3 (VIN)
unnamed: C39.1 (+), IC4.2 (VOUT), R17.1
unnamed: C40.1 (+), IC4.1 (ADJ), R16.1, R17.2
