Alex-Wolfe/Home-Audio-System/Hardware/Design/Main Board/Native Kicad/TV IN.kicad_sch

## KiCad design Hardware/Design/Main Board/Native Kicad/TV IN.kicad_sch (2025-06-05)

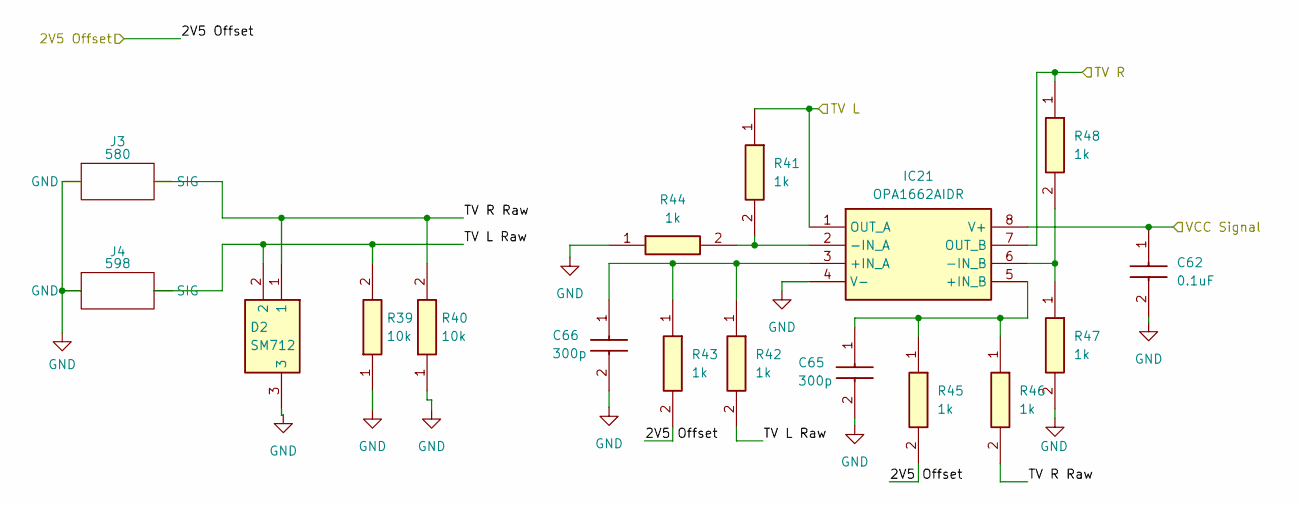
[picture p88: schematic TV IN.kicad_sch]

Parts:
C62: 0.1uF; CAPC2012X95N; Manufacturer_Part_Number CL21B104KACNNNC; Mouser Part Number 187-CL21B104KACNNNC
C65, C66: 300p; CAPC1608X90N; Manufacturer_Part_Number 06035A301JAT2A; Mouser Part Number 581-06035A301J
D2: SM712; SOT95P237X120-3N; Manufacturer_Part_Number SM712
IC21: OPA1662AIDR; SOIC127P600X175-8N; Manufacturer_Part_Number OPA1662AIDR; Mouser Part Number 595-OPA1662AIDR
J3: 580
J4: 598
R39, R40: 10k; RESC2012X60N; Manufacturer_Part_Number RC0805FR-0710KL; Mouser Part Number 603-RC0805FR-0710KL
R41, R42, R43, R44, R45, R46, R47, R48: 1k; RESC2012X60N; Manufacturer_Part_Number RC0805FR-071KL; Mouser Part Number 603-RC0805FR-071KL

Connections:
2V5 Offset: R43.2, R45.2
GND: C62.2, C65.2, C66.2, D2.3, IC21.4 (V-), J3., J4., R39.1, R40.1, R44.1, R47.2
unnamed: C65.1, IC21.5 (+IN_B), R45.1, R46.1
unnamed: C66.1, IC21.3 (+IN_A), R42.1, R43.1
unnamed: IC21.2 (-IN_A), R41.2, R44.2
unnamed: IC21.6 (-IN_B), R47.1, R48.2
TV L: IC21.1 (OUT_A), R41.1
TV L Raw: D2.2, J4., R39.2, R42.2
TV R: IC21.7 (OUT_B), R48.1
TV R Raw: D2.1, J3., R40.2, R46.2
VCC Signal: C62.1, IC21.8 (V+)
