Alex-Wolfe/Home-Audio-System/Hardware/Design/Main Board/Native Kicad/VCC Power.kicad_sch

## KiCad design Hardware/Design/Main Board/Native Kicad/VCC Power.kicad_sch (2025-06-05)

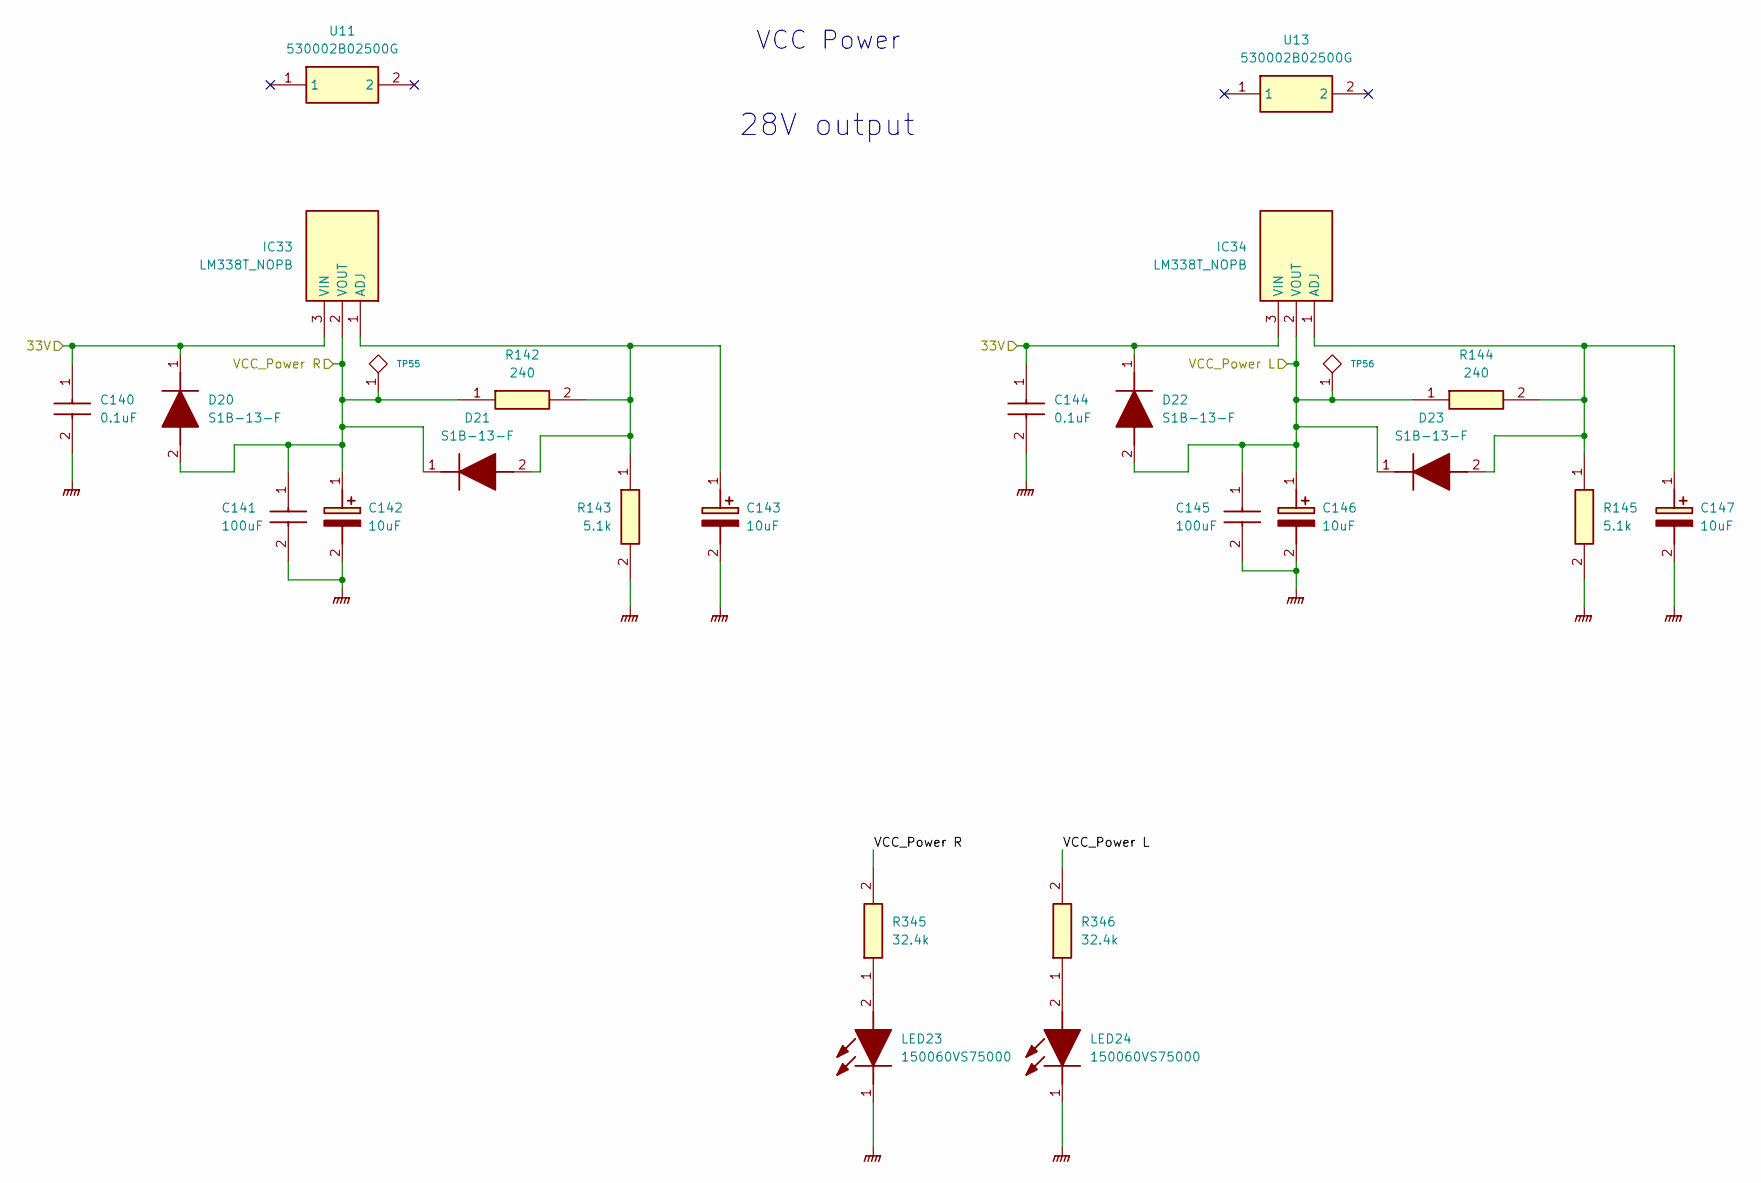
[picture p89: schematic VCC Power.kicad_sch]

Parts:
C140, C144: 0.1uF; C0603; Manufacturer_Part_Number C0603C104M5RACTU; Mouser Part Number 80-C0603C104M5R
C141, C145: 100uF; UD_8X10_; Manufacturer_Part_Number UUD1H101MNL1GS; Mouser Part Number 647-UUD1H101MNL
C142, C143, C146, C147: 10uF; CAPPRD200W55D500H1200; Manufacturer_Part_Number A759BQ106M1VAAE090; Mouser Part Number 80-A759BQ106M1VAAE90
D20, D21, D22, D23: S1B-13-F; DIONM5126X230N; Manufacturer_Part_Number S1B-13-F; Mouser Part Number 621-S1B-F
IC33, IC34: LM338T_NOPB; TO254P470X1028X1955-3P; Manufacturer_Part_Number LM338T/NOPB; Mouser Part Number 926-LM338T/NOPB
LED23, LED24: 150060VS75000; LEDC1608X80N; Manufacturer_Part_Number 150060VS75000; Mouser Part Number 710-150060VS75000
R142, R144: 240; RESC2012X60N; Manufacturer_Part_Number RC0805FR-07240RL; Mouser Part Number 603-RC0805FR-07240RL
R143, R145: 5.1k; RESC3216X60N; Manufacturer_Part_Number CRCW12065K10FKEA; Mouser Part Number 71-CRCW1206-5.1K-E3
R345, R346: 32.4k; RESC1608X55N; Manufacturer_Part_Number RC0603FR-0732K4L; Mouser Part Number 603-RC0603FR-0732K4L
TP55, TP56: TP
U11, U13: 530002B02500G; 529802B02500G; Manufacturer_Part_Number 530002B02500G; Mouser Part Number 532-530002B02500G

Connections:
33V: C140.1, C144.1, D20.1 (K), D22.1 (K), IC33.3 (VIN), IC34.3 (VIN)
GNDPWR: C140.2, C141.2 (-), C142.2 (-), C143.2 (-), C144.2, C145.2 (-), C146.2 (-), C147.2 (-), LED23.1 (K), LED24.1 (K), R143.2, R145.2
unnamed: C143.1 (+), D21.2 (A), IC33.1 (ADJ), R142.2, R143.1
unnamed: C147.1 (+), D23.2 (A), IC34.1 (ADJ), R144.2, R145.1
unnamed: LED23.2 (A), R345.1
unnamed: LED24.2 (A), R346.1
VCC_Power L: C145.1 (+), C146.1 (+), D22.2 (A), D23.1 (K), IC34.2 (VOUT), R144.1, R346.2, TP56.1
VCC_Power R: C141.1 (+), C142.1 (+), D20.2 (A), D21.1 (K), IC33.2 (VOUT), R142.1, R345.2, TP55.1

Notes on the sheet:
VCC Power
28V output
