Alex-Wolfe/Home-Audio-System/Firmware/Main Firmware/eq_pot.h

/******************************************************************************/
/* EQ POT #define Macros                                                  */
/******************************************************************************/


/******************************************************************************/
/* EQ POT Function Prototypes                                                   */
/******************************************************************************/

void set_right_low_level(unsigned char val);

void set_right_high_level(unsigned char val);

void set_left_low_level(unsigned char val);

void set_left_high_level(unsigned char val);

void set_eq(unsigned char lo, unsigned char hi);

void init_eq(void);
