Alex-Wolfe/Home-Audio-System/Firmware/Main Firmware/vol_pot.h

/******************************************************************************/
/* VOL POT #define Macros                                                  */
/******************************************************************************/


/******************************************************************************/
/* VOL POT Function Prototypes                                                   */
/******************************************************************************/

void set_right_volume(unsigned char right);

void set_left_volume(unsigned char left);

void set_volume(unsigned char vol);

void mute_right(void);

void mute_left(void);

void mute(void);
