Alex-Wolfe/Home-Audio-System/Firmware/Main Firmware/spi.h

/******************************************************************************/
/* SPI Function Prototypes                                                    */
/******************************************************************************/

void spi1_write(unsigned char byte);

unsigned char spi2_read(void);

void spi2_write(unsigned char byte);

unsigned char spi2_read(void);
