Alex-Wolfe/Home-Audio-System/Firmware/Main Firmware/ambient_temp.h

/******************************************************************************/
/*#define Macros                                                  */
/******************************************************************************/


/******************************************************************************/
/*Function Prototypes                                                   */
/******************************************************************************/

/* get temperature data from LM75B via I2C */
float read_ambient_temp(void);
