Alex-Wolfe/Home-Audio-System/Firmware/Main Firmware/debug_uart.h

/******************************************************************************/
/* User Level #define Macros                                                  */
/******************************************************************************/


/******************************************************************************/
/* User Function Prototypes                                                   */
/******************************************************************************/

/* Send byte over UART1 */
void write_debug_byte(char byte);

/* Send string of bytes over UART1 */
/* Arrays passed to functions decay to pointer*/
void write_debug_string(char *text);

/* Send LF over UART */
void write_debug_newline(void);
