Alex-Wolfe/Home-Audio-System/Firmware/Main Firmware/system.c

#include <xc.h>

#include "system.h"          /* variables/params used by system.c */

/******************************************************************************/
/* System Level Functions                                                     */
/*                                                                            */
/* Custom oscillator configuration funtions, reset source evaluation          */
/* functions, and other non-peripheral microcontroller initialization         */
/* functions get placed in system.c                                           */
/*                                                                            */
/******************************************************************************/

void configure_oscillator()
{
    REFOCONL = 0x0000;
}
