Alex-Wolfe/Home-Audio-System/Firmware/Main Firmware/system.h

/******************************************************************************/
/* System Function Prototypes                                                 */
/******************************************************************************/

/* Custom oscillator configuration functions, reset source evaluation
functions, and other non-peripheral microcontroller initialization functions
go here. */

void configure_oscillator(void); /* Disables reference oscillator */
