Alex-Wolfe/Home-Audio-System/(commit log)

2025-06-05 Repo Creation
    [bar graph plan.xlsx, eq -12db setting.xlsx, thermistor table.csv]
2025-06-05 Development
    Removed unnecessary file inclusions
    developing i2c library
2025-06-07 Completed I2C Driver (untested)
    [amp_bom_only.xlsx]
2025-06-08 SPI driver development
    [shift register layout.xlsx]
2025-06-10 adc configuration
2025-06-10 add ISR for ADC
2025-06-15 driver development
    Added reading i2c temp sensor
    Fixed UART pinout to FTDI cable
    Added code to print ints to FTDI
    Added code to write and read eeprom
    Added source selection switch case
    [Issue Log.xlsx]
2025-06-17 development
    created fm radio ic driver
    fixed a couple errors
    [ambient_temp.c, eeprom.c, fm_radio.c, fm_radio.h, main.c, user.c]
2025-06-20 led driver development
    [shift register layout.xlsx]
2025-06-20 fixed spi peripheral pin select issue
    [config.c, display.c, main.c]
2025-06-20 first working led bar function
    [shift register layout.xlsx]
2025-06-30 Updated bar graph LED driver, added interrupts for refresh rate control of LEDs and 7 segment display, added interrupts for UI inputs as well as placeholder functions
    [segment layout.xlsx, shift register layout.xlsx]
2025-07-01 enable timer 3, fix some display code
    known issue, delayms and potentially delayus seem to not give the right delay values
    [config.c, display.c, main.c]
2025-07-02 turn off timers before adjusting prescalar to avoid errors
    [user.c]
2025-07-03 added new timer for interrupt use so timers don't get overwritten, fixed bar graph write function so it doesn't continuosly OR over itself, fixed alphabet so it aligns with ASCII table, added more gr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
    cooked with this one
    [config.c, config.h, display.c, display.h, interrupts.c, main.c, user.c, user.h]
2025-07-07 got printing to 7 segment display working
    [Issue Log.xlsx, segment layout.xlsx]
2025-07-07 fixed led ghosting
2025-07-08 created drivers for volume and eq digital potentiometers
2025-07-08 Fixed interrupts, attempted to use rotary encoder
    [display.c, eq_pot.h, interrupts.c, main.c, user.c, user.h]
2025-07-09 nothing burger
    [Issue Log.xlsx]
2025-07-10 working on rotary encoder decoding/debouncing
2025-07-11 implemented debouncing for buttons without using delay loops
2025-07-12 untested rotary encoder debouncing implementation based on state change direction and redundancy
2025-07-12 added saving of ADC buffer data on interrupt
    [bar graph plan.xlsx, eq -12db setting.xlsx]
2025-07-12 rotary encoder driver complete, write to segments function fixed
    [display.c, main.c, user.c]
2025-07-13 fixed some gpios being used by peripheral
    [display.c, main.c, user.c, user.h]
2025-07-13 big moves, first crack at menu implementation
    [config.c, display.c, display.h, eq_pot.c, eq_pot.h, interrupts.c, main.c, user.c]
2025-07-14 fixed some small bugs with menu. Now working good. Also now remembers last source setting on power up
    [config.c, display.c, main.c, user.c]
2025-07-22 update i2c driver to fix errors
    [i2c.c]
2025-07-23 eq spi debugging
2025-07-23 found issue, eq pot working
    [Issue Log.xlsx]
2025-07-25 Update Issue Log.xlsx
    [Issue Log.xlsx]
2025-07-29 handle refresh in loop, set by flag in interrupt. Display eq value differently, and set based on dB table
    [eq -12db setting.xlsx, segment layout.xlsx]
2025-08-23 simluating compensator circuit
    [Issue Log.xlsx]
2025-09-04 update issue log
    [Issue Log.xlsx]
2025-09-05 simulating compensator circuit
